teyame109-dev/Modular-Home/web/site/cimentacion/img/montaje-1-modulos-sobre-muros.jpg

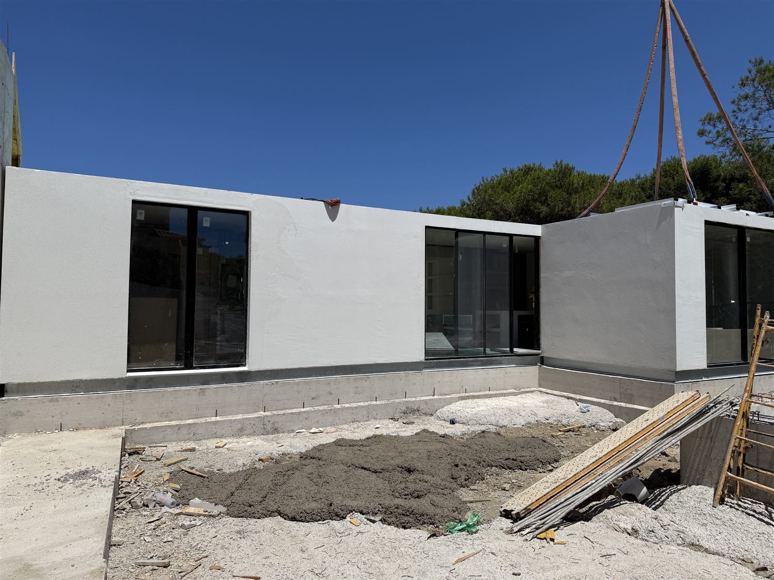
web/site/cimentacion/img/montaje-1-modulos-sobre-muros.jpg
