teyame109-dev/Modular-Home/web/site/cimentacion/img/obra-encofrado-armado.jpg

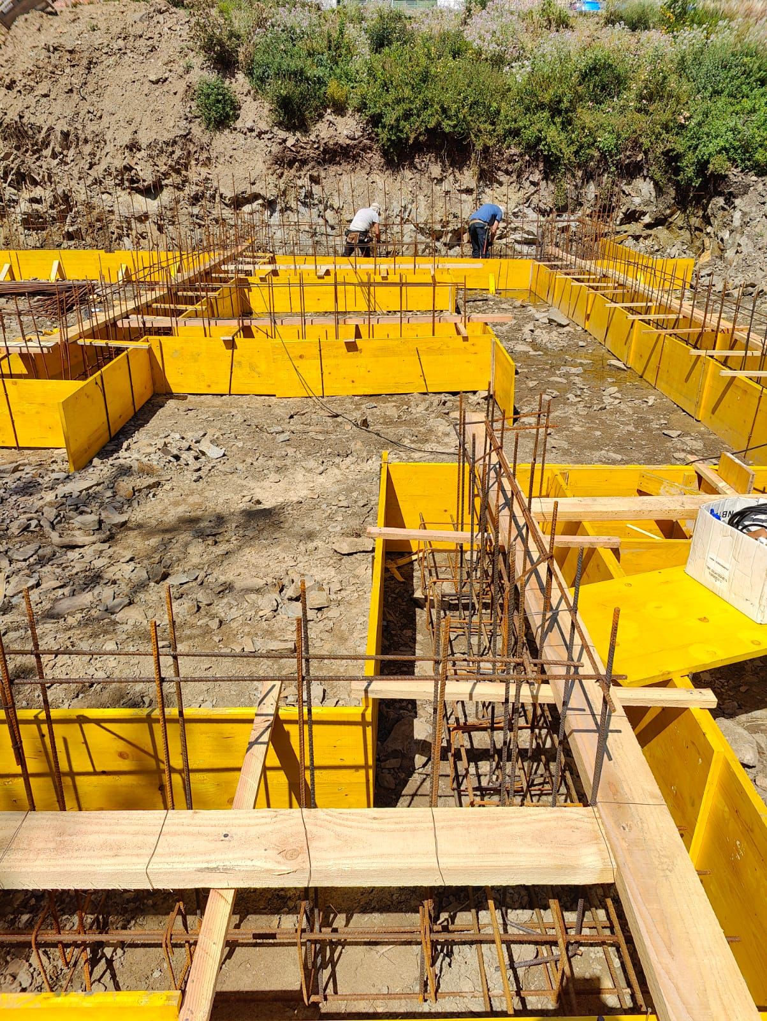
web/site/cimentacion/img/obra-encofrado-armado.jpg
