teyame109-dev/Modular-Home/README.md

# Modular Home

Proyecto de vivienda modular (piloto Névola · RG21). El contexto completo está en `CLAUDE.md`.

## Agentes del proyecto (`.claude/agents/`)
Adaptados a España a partir de [agency-agents](https://github.com/msitarzewski/agency-agents) (licencia MIT):

| Agente | Para qué |
|---|---|
| `revisor-realidad` | Revisar propuestas y decisiones antes de enviarlas |
| `analista-precios` | Precio y margen por casa y por proyecto, escenarios |
| `analista-financiero` | Viabilidad, caja, punto de equilibrio, real vs previsto |
| `jefe-proyecto` | Plan de fabricación y obra, medición del piloto |
| `ingeniero-estructuras` | Marcos de acero, kg/m², soldadura, CTE y EN 1090 (no firma) |
| `compras-proveedores` | Ofertas, comparativas, listas de materiales, plazos |
| `energia-sostenibilidad` | CTE DB-HE, calificación energética, argumentos verdes con dato |

Uso: "Que el analista-precios calcule… y después el revisor-realidad lo revise".
