teyame109-dev/Modular-Home/artifacts/informe_tecnico_piloto.html

rg21capital

Estudio técnico interno
Octubre 2026

Névola · Vivienda piloto

# Piloto modular Névola: vivienda pareada tipo

Paso a sistema modular, sin cambiar la distribución del proyecto, del proyecto de ejecución de julio de 2026 (14 pareadas y 2 aisladas en Guadalix de la Sierra), con la tipología de módulo del proyecto de Mahón (182): marcos de acero soldados, panel sándwich Tabihaus y trasdosado. Medición y coste de la primera unidad.

6 módulos3 por planta · sin cambios de distribución

12.889 kgacero · 86,9 kg/m² (Mahón: 89)

225.400 €precio cerrado del piloto · margen 21.430 € (9,5 %)

273.600 €precio cerrado si va aislado · margen 25.763 €

## Cómo se pasa el proyecto a módulos

- Retícula. La planta baja mide 7,85 × 9,50 m hasta el eje de medianera. Se divide en tres módulos de 3,20, 2,30 y 2,35 m que corren de fachada a fachada. La junta a 5,50 m cae sobre tabiques; la de 3,20 m cae sobre el tabique entre los dormitorios 2 y 3 en planta primera y, en planta baja, cruza el dormitorio 1 a 0,30 m de su tabique, oculta en suelo y techo como en el salón. La distribución del proyecto no cambia.
- Vuelos. La planta primera vuela 0,60 m en frente y lateral (8,45 m de ancho). Los tres módulos de arriba arrancan 0,60 m por delante de los de abajo, con el borde frontal en IPE 220. El vuelo lateral va dentro del M4, que mide 3,80 m de ancho: un módulo entero, sin pieza que atornillar en parcela. Sus pilares quedan en el eje de 0,60 m, sobre los del M1, y el voladizo lleva borde en IPE 220.
- Apoyos. Cada módulo lleva pilares IPE 160 en esquinas y en el eje intermedio. Los de planta primera descargan sobre los marcos de planta baja en los ejes y = 0,60 · 6,10 · 10,10 m. El salón (7,43 m libres en el proyecto) queda con luces de 5,50 y 4,00 m.
- Terraza y baño principal. M4 y M5 terminan en 8,47 m. Sobre la cubierta de planta baja queda la terraza de 9 m². M6 llega hasta 10,10 m y recoge entero el baño principal que sobresale.
- Alturas. Se mantienen las cotas del proyecto: suelo de planta baja +0,20, de planta primera +3,35 y cubierta +6,40. Módulos de unos 3,05 m de alto: en góndola rebajada quedan por debajo de 4,00 m.

## Croquis de modulación

Módulo de planta bajaMódulo de planta primeraPilar IPE 160Medianera

Lámina 1 · Planta bajacotas en m

Módulos de 3,20, 2,30 y 2,35 × 9,50 m. La junta a 3,20 m cruza el dormitorio 1 (oculta en suelo y techo); la de 5,50 m cae sobre los tabiques del baño 1 y el lavadero. Línea discontinua: eje de pilares intermedio (y = 6,10).

Lámina 2 · Planta primeracotas en m

Discontinuo azul: huella de planta baja. M4 y M5 de 8,47 m; M6 de 10,10 m con el baño principal. Rayado: terraza. El M4 incluye el vuelo lateral de 0,60 m. Juntas sobre el tabique entre dormitorios 2 y 3 y sobre el del baño principal.

Lámina 3 · Sección longitudinal por M2 / M5cotas de nivel del proyecto

Vertical: pilares IPE 160 de cada módulo. Bandas oscuras: forjados de panel. La cimentación sigue siendo del promotor, con placas de anclaje en los tres ejes de apoyo.

Lámina 4 · Fachada tipode exterior a interior

Capa | e (mm) | R (m²K/W)
Resistencia superficial exterior | – | 0,04
Acabado: placa de cemento + monocapa | 15 | 0,03
Panel Tabihaus 8+50+8 (núcleo PIR, λ 0,022) | 66 | 2,27
PET reciclado (λ 0,035) | 40 | 1,14
Trasdosado W625: perfil + lana mineral (λ 0,035) | 48 | 1,37
Placa de yeso laminado | 15 | 0,06
Resistencia superficial interior | – | 0,13
Total · U = 1 / R | ≈ 184 | 5,04 → U = 0,20

Cumple la U = 0,20 W/m²K que fija el proyecto para fachadas. El muro tiene 184 mm, frente a los unos 330 mm de la solución de ladrillo.

Módulosm · m²

Módulo | Ancho | Largo | m² | Contiene
M1 · PB | 3,20 | 9,50 | 30,40 | Dormitorio 1, cocina, salón
M2 · PB | 2,30 | 9,50 | 21,85 | Vestíbulo, escalera, salón
M3 · PB | 2,35 | 9,50 | 22,32 | Baño 1, lavadero, salón
M4 · P1 | 3,80 | 8,47 | 32,19 | Dormitorio 3, baño 2, dormitorio principal, con los vuelos frontal y lateral
M5 · P1 | 2,30 | 8,47 | 19,48 | Dormitorio 2, distribuidor
M6 · P1 | 2,35 | 10,10 | 23,73 | Escalera, vestidor, baño principal
Total | | | 149,97 | 148,30 m² construidos en proyecto

Anchos de 2,30 a 3,80 m: todos viajan en góndola rebajada con autorización especial, y el M4 además con vehículo de acompañamiento.

## Medición de acero

Mismos perfiles que Mahón: marcos de suelo y techo en IPE 200, pilares IPE 160, correas HEA 100 y SHS 60.40.3, angular L 80.8 de apoyo del panel. Los bordes en vuelo, en IPE 220.

Elemento | kg | kg/m²
Vigas de marco IPE 200 (suelo y techo de cada módulo) | 5.821 | 39,3
Bordes frontales en vuelo IPE 220 (M4, M5, M6) | 454 | 3,1
Borde lateral en vuelo del M4, IPE 220 | 455 | 3,1
Pilares IPE 160 (38 ud) | 1.631 | 11,0
Correas de suelo HEA 100 | 1.603 | 10,8
Correas de techo SHS 60.40.3 | 1.286 | 8,7
Angular L 80.8 de apoyo de panel | 351 | 2,4
Escalera metálica | 450 | 3,0
Refuerzos, remates y pletinas de arriostramiento | 838 | 5,7
Total | 12.889 | 86,9

kg/m² sobre 148,30 m² construidos. Mahón (182, dos plantas): 13.516 kg y 89 kg/m². Con un cálculo específico para módulos apilados se puede bajar: cada 10 kg/m² son unos 3.900 € por vivienda.

## Coste del piloto

Coste real de 2026 sin IVA. Lo que se hace igual que en el proyecto (instalaciones, carpinterías, acabados) va con sus mediciones y precios. Margen de RG21 del 10 %, aplicado una sola vez.

Partida | Piloto dentro de la serie | Piloto aislado
Sistema modular
Estructura de acero · 12.889 kg × 2,60 €/kg | 33.512 € | 33.512 €
Fachadas, medianera y vuelos: panel, trasdosado, aislamiento y acabado | 32.026 € | 32.026 €
Cubierta y terraza: panel y sistema de cubierta | 13.702 € | 13.702 €
Forjados de panel: suelo de planta baja y de planta primera | 11.948 € | 11.948 €
Juntas entre módulos y colectores suspendidos | 2.767 € | 2.767 €
Igual que el proyecto
Instalaciones: electricidad, fontanería, climatización, ventilación | 38.300 € | 38.300 €
Carpinterías exterior e interior | 16.301 € | 16.301 €
Tabiquería, techos, solados, alicatados y pintura | 24.766 € | 24.766 €
Primera unidad, transporte y montaje
Sobrecoste de aprendizaje (15 % de la mano de obra de fábrica) | 3.650 € | 3.650 €
Transporte de 6 módulos, con el M4 como especial | 7.248 € | 7.248 €
Grúa, jornada completa | 3.494 € | 3.494 €
Montaje en parcela · 192 h | 5.078 € | 5.078 €
Ingeniería: cálculo modular y proyecto de fabricación | 1.563 € | 25.000 €
Gastos fijos de fábrica | 10.215 € | 30.645 €
Coste | 203.970 € | 247.837 €
Margen RG21 (precio cerrado menos coste) | 21.430 € · 9,5 % | 25.763 € · 9,4 %
Precio cerrado con NIDO | 225.400 € | 273.600 €
€/m² construido | 1.520 | 1.845

Piloto dentro de la serie: la ingeniería se reparte entre 16 viviendas y los gastos fijos van al ritmo de 2 viviendas/mes. Piloto aislado: carga toda la ingeniería y 1,5 meses de fábrica; es el coste si después no hay serie. Referencia: una contrata tradicional del mismo alcance saldría a unos 155.700 € (PEM del proyecto × 1,19).

## Memoria de calidades: dónde se puede ahorrar

Las calidades que fija el proyecto (marcas y precios del BC3), al lado de una alternativa más barata. Hay tres tipos de ahorro: el que trae el propio sistema modular o evita pagar dos veces lo mismo (no cambia nada para el comprador), el cambio a una marca equivalente que la memoria permite con su «o similar», y ajustar el alcance a lo que promete la memoria comercial. Importes por vivienda pareada.

14.187 €ahorro de coste por vivienda

15.606 €bajada de precio con el margen del 10 %

209.800 €precio ofertado con optimizaciones · 1.415 €/m²

3.106.069 €serie de 16 con todos los ahorros

Partida | Proyecto | €/viv. proyecto | Alternativa | Ahorro €/viv.
Sistema modular o duplicidad · 5.692 €
Bomba circuladora Climatización | Ebara Ego Easy 25/80 aparte | 595 € | La integrada en el módulo hidráulico de la aerotermia (un solo circuito con colectores) | 400 €
Falso techo de cuartos secos y húmedos Techos | Knauf D47 suspendido con maestras (27,74 y 31,01 €/m²) | 3.447 € | Placa atornillada directamente a las correas del techo del módulo, sin estructura suspendida | 1.180 €
Falso techo exterior de placa de cemento Techos | Aquapanel Outdoor bajo vuelos (101,73 €/m²) | 992 € | Ya incluido: el vuelo del módulo lleva panel con acabado exterior | 992 €
Aplacado de gres en fachada Fachada | Porcelánico en capa fina sobre mortero (48,34 €/m², 31 m²) | 1.504 € | Se mantiene el aplacado y se descuenta esa superficie del acabado exterior del panel (no duplicar) | 1.400 €
Red de toma de tierra de estructura Electricidad | Cable de 35 mm² soldado a la armadura de cada zapata (40,65 m) | 2.061 € | Conexión equipotencial de los marcos de acero al anillo de cimentación del promotor | 1.200 €
Recercado de huecos Carpintería exterior | Chapa de aluminio lacado, desarrollo 400 mm (29,03 €/m) | 1.681 € | Pliegues de chapa galvanizada lacada fabricados en el propio taller | 520 €
Marca o gama equivalente · 6.605 €
Aerotermia Climatización | Vaillant aroTHERM plus uniTOWER biblock, 10,1 kW, A+++ | 8.376 € | Panasonic Aquarea All in One o LG Therma V con depósito de 200 l, dimensionada a 8 kW (vivienda A+ de 125 m² útiles) | 2.000 €
Suelo radiante Climatización | Polytherm Premium, panel termoconformado (35,86 €/m²) | 4.483 € | Sistema estándar de panel liso (Uponor, Orkli o Giacomini) a unos 30 €/m² | 750 €
Cuadro general Electricidad | Electrificación elevada, 24 elementos, 12 circuitos | 1.171 € | Mismo esquema montado en fábrica con aparamenta de gama media (Hager, Schneider Resi9) | 320 €
Videoportero Electricidad | Digital 3 hilos + coaxial, monitor b/n 4" | 730 € | Kit de 2 hilos en color (Fermax o Golmar) | 280 €
Tarima laminada Pavimentos | Terhürne Comfloor Akustec AC5/32, 8,5 mm (36,32 €/m²) | 3.245 € | Laminado AC5 de 8 mm de fabricante nacional (Finsa, Faus) a unos 28 €/m² | 715 €
Gres porcelánico interior, alicatado y peldaños Pavimentos | Porcelánico de 20 €/m² de material | 3.918 € | Compra directa a fábrica de Castellón por volumen de 16 viviendas (unos 13 €/m² de material) | 700 €
Pintura plástica Pintura | Sikkens Alphalux SF (8,11 y 10,45 €/m²) | 3.748 € | Plástica mate lavable profesional (Titan, Jotun o Bruguer) | 850 €
Ventanas y puertas balconeras Carpintería exterior | PVC Kömmerling Eurofutur 70, foliado RAL 7016, persiana | 8.012 € | Perfil equivalente de 70 mm (Veka Softline o Rehau Euro-Design) con el mismo foliado y vidrio | 650 €
Barandilla de terraza Carpintería exterior | Comenza GlassFit SV-1401 Top (197,86 €/m) | 1.408 € | Vidrio laminar con perfil de base genérico, misma imagen | 340 €
Alcance de la memoria comercial · 1.890 €
Tabiques interiores Tabiquería | Knauf W112, doble placa por cara (29,94 €/m²) | 3.910 € | Placa sencilla de 15 mm por cara (W111) entre estancias de la misma vivienda; W112 solo en baños y escalera | 1.000 €
Punto de recarga de vehículo Electricidad | Caja de recarga 2,3 kW instalada | 1.242 € | Preinstalación (canalización y línea), que es lo que promete la memoria comercial | 890 €
Ahorro total por vivienda (coste) | | | | 14.187 €

Ahorros estimados a precio de mercado de 2026: hay que confirmarlos con ofertas de proveedor. Las alternativas de marca mantienen la clase de eficiencia, el desgaste AC5, el foliado RAL 7016 y la gama media de sanitarios que fija la memoria. Sin tocar: sanitarios Gala (ya son gama media), puertas lacadas de MDF (221 €/ud) y armarios de melamina.

## Lo que hay que cerrar antes de fabricar

Cálculo estructuralValidar marcos, pilares y vuelos de 0,60 m con un calculista. Es la partida con más margen de ahorro.

MedianeraCada vivienda cierra sus módulos (68 m² de panel). Estudiar una medianera compartida con protección contra incendios EI 60 entre las dos viviendas.

M4 de 3,80 m y junta ocultaPedir precio del transporte especial del M4 (estimado en 1.200 €) y validar con la arquitecta el voladizo lateral dentro del módulo y la junta oculta en el dormitorio 1.

Precios de proveedorPedir oferta a Tabihaus (66, 81 y 136 mm) y del acabado exterior sobre panel, ahora estimado a 45 €/m².

OCT y decenalPresentar el sistema a la OCT y a la aseguradora del promotor antes de fabricar.

CimentaciónEl promotor ejecuta zapatas y placas de anclaje en los ejes 0,60 · 6,10 · 10,10. La solera Cáviti del proyecto desaparece.

Excel con todas las mediciones y fórmulas: Documentos\Dwaih\ModularHome\Nevola_piloto_estudio_costes.xlsx

RG21 Capital · Piloto modular NévolaUso interno · No enviar al promotor
