teyame109-dev/Modular-Home/artifacts/img/obra-muros-terminados.jpg

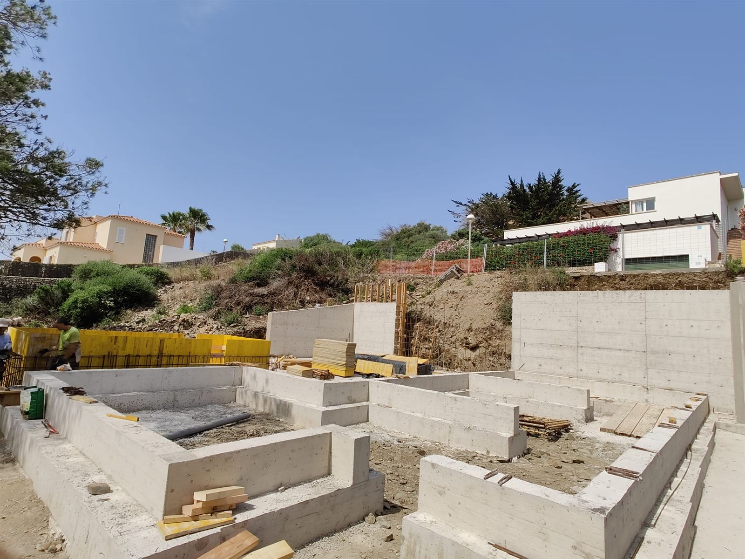
artifacts/img/obra-muros-terminados.jpg
