teyame109-dev/Modular-Home/artifacts/img/obra-muros-y-losa.jpg

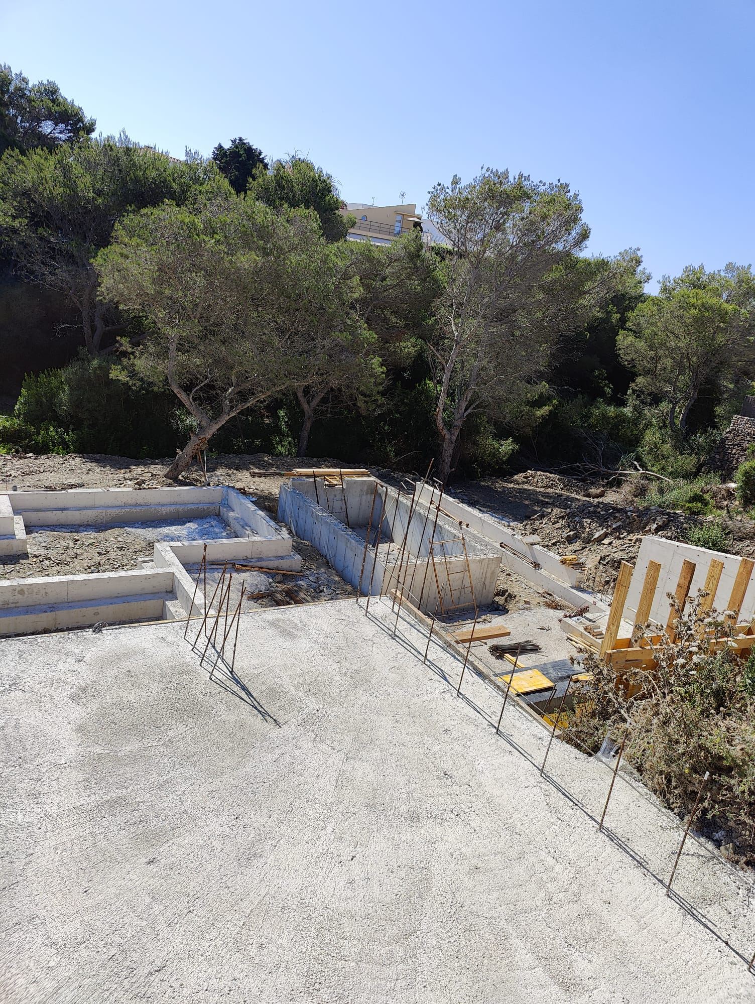
artifacts/img/obra-muros-y-losa.jpg
