teyame109-dev/Modular-Home/ofertas-proveedores/2026-10-20_cimentacion_presupuesto_equipo_manuscrito.webp

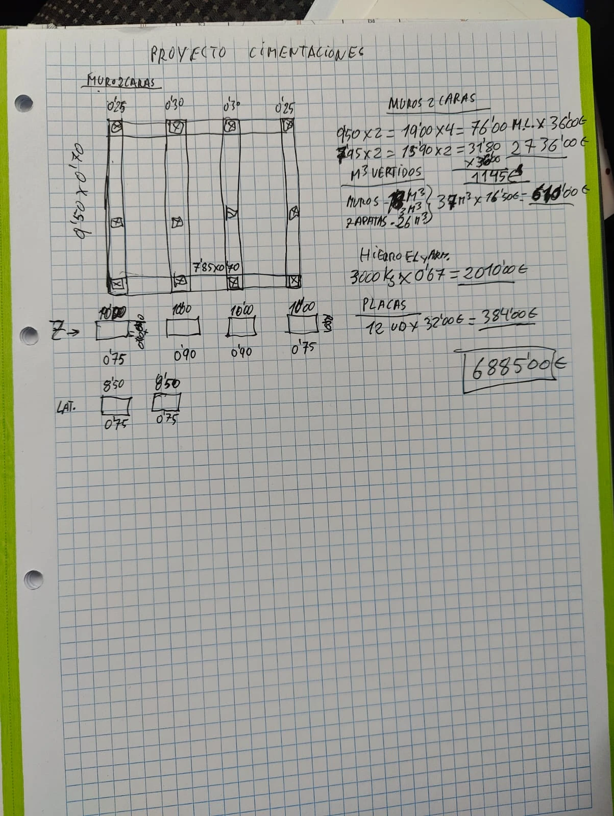
ofertas-proveedores/2026-10-20_cimentacion_presupuesto_equipo_manuscrito.webp
