teyame109-dev/Modular-Home/proyectos-referencia/nevola-renders/captura-jardin-comun.webp

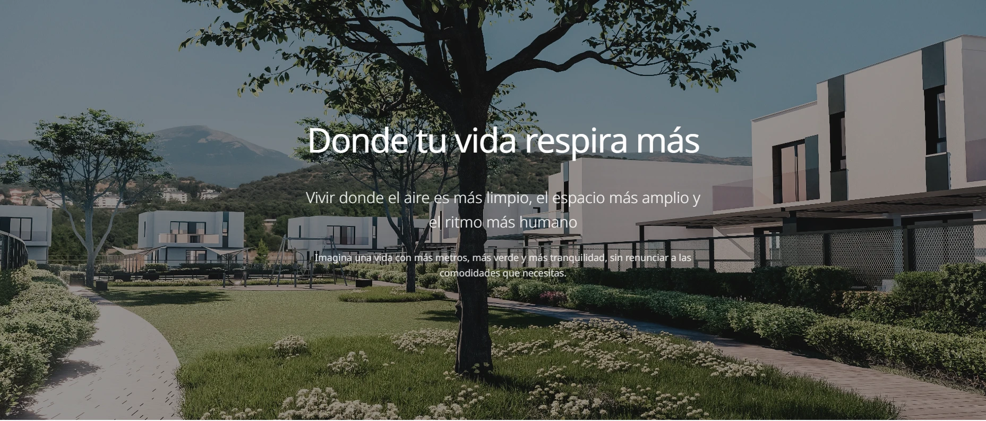
proyectos-referencia/nevola-renders/captura-jardin-comun.webp
