teyame109-dev/Modular-Home/proyectos-referencia/nevola-renders/captura-piscinas-b.webp

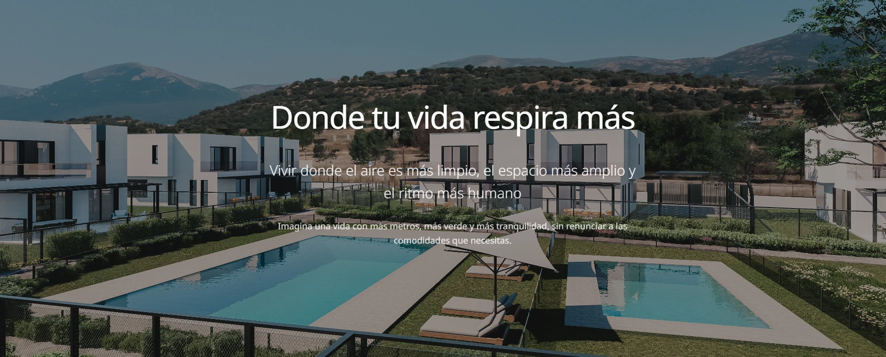
proyectos-referencia/nevola-renders/captura-piscinas-b.webp
