teyame109-dev/Modular-Home/proyectos-referencia/nevola-renders/captura-traseras-pareadas.webp

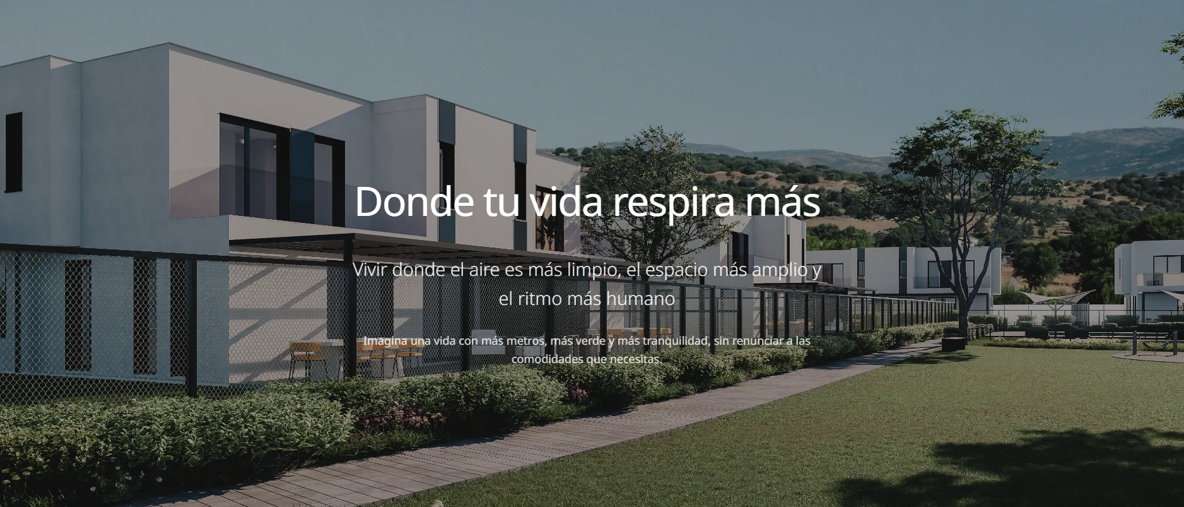
proyectos-referencia/nevola-renders/captura-traseras-pareadas.webp
