teyame109-dev/Modular-Home/proyectos-referencia/nevola-renders/captura-vivienda-jardin.webp

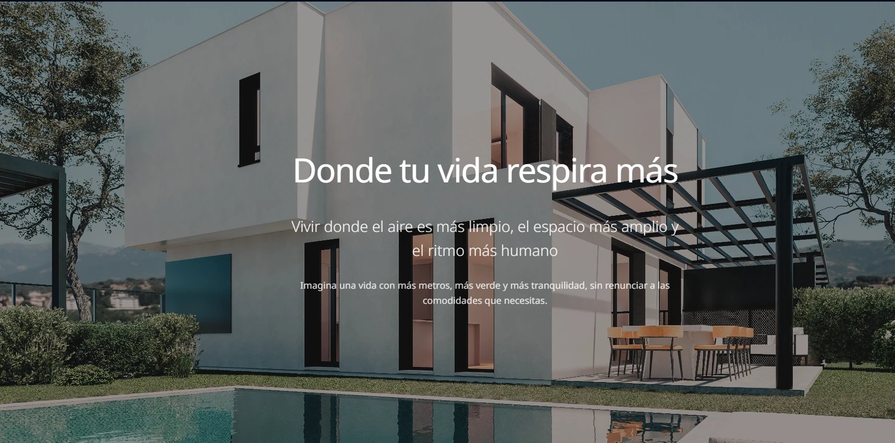
proyectos-referencia/nevola-renders/captura-vivienda-jardin.webp
