teyame109-dev/Modular-Home/web/site/render/img/piscinas.jpg

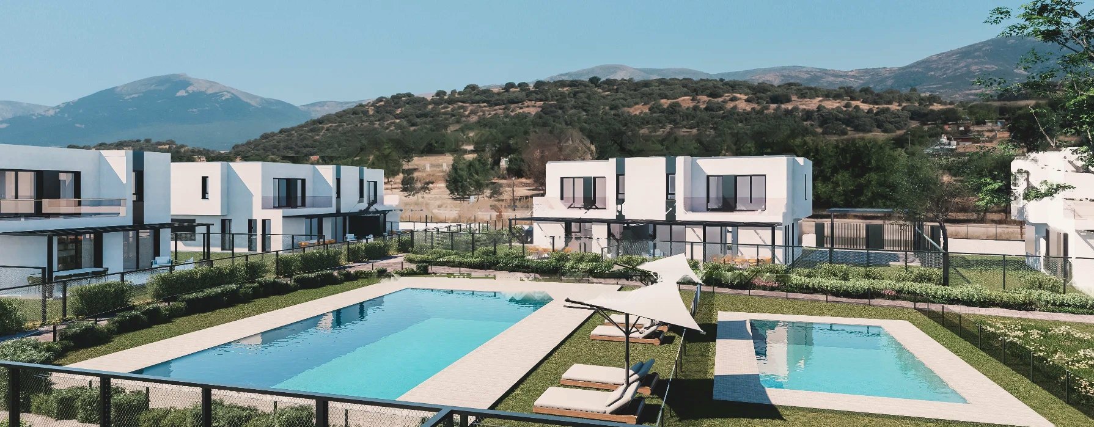
web/site/render/img/piscinas.jpg
