teyame109-dev/Modular-Home/web/site/render/img/traseras-pareadas.jpg

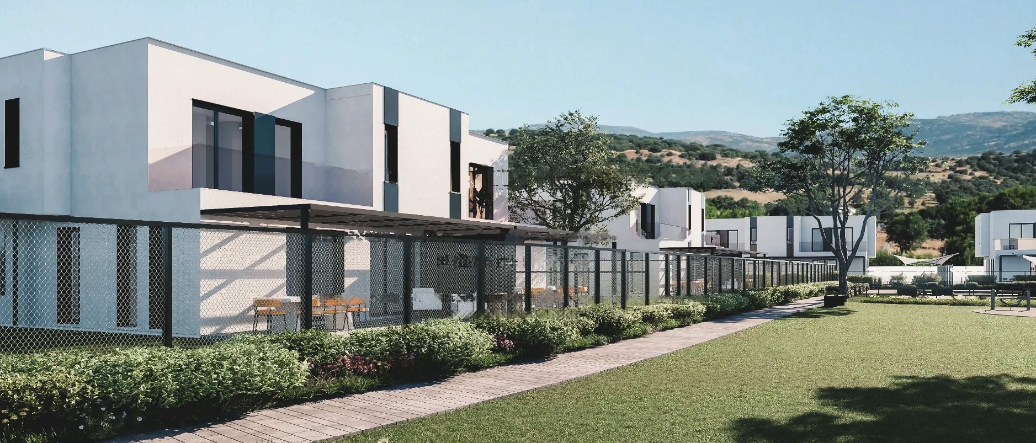
web/site/render/img/traseras-pareadas.jpg
