teyame109-dev/Modular-Home/costes/Banco_precios_modular_base2024.xlsx

Sheet: Léeme
Banco de precios de vivienda modular: base 2024 (proyectos Tini / DWHAI)
Preparado el 28/09/2026 a partir de los presupuestos Presto de 2024 y de la analítica contable de DWHAI a 29/11/2024.
CÓMO SE USA
• Hoja «Banco de precios»: una fila por partida. Precio de VENTA de 2024 en cada proyecto donde aparece, con mínimo, máximo y precio de referencia (mediana).
• Celdas AMARILLAS = las que rellenas tú: coste 2026 (lo que nos cuesta hoy la partida) y margen objetivo. El precio de venta 2026 se calcula solo.
• Texto AZUL = dato introducido a mano (de presupuestos o facturas). Texto negro = fórmula.
• Si el coste 2026 está vacío, el precio de venta 2026 toma el precio de referencia de 2024 actualizado con el IPC de obra (celda B3 de «Banco de precios»).
FUENTES
• Fenwick / Guadalajara (Tini L, 45 m²): 168_TINI L_MEDICIONES Y PRESUPUESTO (Excel del 25/11/2024; transporte corregido según el PDF del 16/04/2024).
• Menorca Pino (165 m²), dos versiones: mayo de 2024 (96_TINI XX_MENORCA PINO.xlsx, 280.492 €, que es el importe certificado a Tini) y 30/10/2024 (96_TINI MENORCA PINO__30102024, 272.061 €). También la implantación en obra: 96_TINI_MENORCA PINO_rv02 (29/08/2024).
• Sotopinilla / Autopromotor (153 m²): TINI SOTOPINILLA_MEDICIONES (3).pdf.
• Burdeos / Francia (Tini M, 34 m²): 171_TINI M_RUBEN GARCIA_BURDEOS_MEDICIONES CON ESTUFA.pdf.
• El Boalo / Sonia Arranz (Tini 85 m², contrato 169): 169_TINI 85M EL BOALO_MEDICIONES Y PRESUPUESTO (19/07/2024, 144.795 €).
• Mahón / Iván Montero (proyecto 182): resumen de presupuesto del 21/11/2024, a libro abierto (coste de material por separado).
• Coste real: 29-11-2024 ANALITICA PROYECTOS DWHAI.xlsx (facturas de proveedor imputadas a cada proyecto).
• Superficie de cada proyecto = medición de «limpieza final» (m²). Si hay una superficie oficial, cámbiala en «Resumen proyectos».
LO QUE HAY QUE SABER ANTES DE PRESUPUESTAR
1. El acero se vendía a 2,80 €/kg, pero la estructura soldada costó entre 2,9 y 5,3 €/kg según el proyecto. Es la partida que más riesgo tiene: en Guadalajara se perdió dinero.
2. El panel sándwich se vendía a 54–72 €/m². Con Tabihaus (Menorca, Sotopinilla) el coste imputado salió a 69–83 €/m², por encima de la venta. Con el panel anterior (Tejafer y Geo Pannel: Guadalajara, Burdeos) salió a 26–52 €/m². El precio de lista de Tabihaus en Mahón (42–64 €/m²) no incluye mermas ni portes. En la versión de octubre de Menorca ya se corrigió: panel de fachada de 66 mm a 82,42 €/m², de cubierta de 81 mm a 58,37 €/m² y de suelo de 136 mm a 86,09 €/m². Es la mejor referencia de venta con Tabihaus.
3. En Menorca y Sotopinilla, Tini pagó directamente la carpintería, la cocina, los baños, el clima y el transporte. Quitando eso, DWHAI tuvo en Menorca un margen bruto del 36 % sobre lo que ejecutó, antes de gastos generales.
4. Con la plantilla completa (9 operarios, septiembre–noviembre de 2024), la nómina costaba unos 28.250 €/mes y la fábrica entera unos 48.700 €/mes. Ver la hoja «Fábrica coste mensual»: falta el dato de m² fabricados al mes para convertirlo en €/m².
5. Gastos generales de 2024: 385.104 € (nave, gestión, mano de obra sin imputar). En Mahón se repercutieron como 1/5 de la nave durante 5 meses (24.500 €).
6. Los precios de 2024 son de VENTA de DWHAI a Tini. El margen de Tini iba aparte (en Mahón, 37.831 € sobre 109.111 €, un 34,7 %).

Sheet: Banco de precios
BANCO DE PRECIOS: VIVIENDA MODULAR (base 2024)
Actualización 2024→2026 (IPC de obra) | 8.0% | Supuesto: +8 % acumulado. Sustitúyelo por el índice real o por precios de proveedor. | Margen objetivo por defecto | 25.0%
Capítulo | Código | Descripción | Ud | Venta 2024 Fenwick (Guadalajara) | Venta 2024 Menorca Pino (may-24) | Venta 2024 Menorca Pino (oct-24) | Venta 2024 Sotopinilla | Venta 2024 Burdeos (Francia) | Venta 2024 El Boalo (Tini 85) | Mín. | Máx. | Nº proy. | Precio ref. 2024 (mediana) | Coste real 2024 (conocido) | Margen 2024 sobre venta | Fuente del coste | COSTE 2026 (rellenar) | Margen objetivo (opcional) | PRECIO VENTA 2026
01 Estructura | 01.01.03.02 | CORREA SHS60.4 |  |  |  |  | 2.80 €
01 Estructura | 01.01.06.02 | PLETINA TRANSPORTE 170.10 | kg |  |  |  | 2.80 €
01 Estructura | 01.01.07.01 | PINTURA ESTRUCTURA VISTA |  |  |  |  |  | 200.00 €
01 Estructura | EAS005 | PLACA DE ANCLAJE DE ACERO, CON PERNOS SOLDADOS. | Ud |  |  |  | 32.70 €
01 Estructura | EST_CO_HEA100 | HEA100 | kg |  |  | 2.80 € |  |  | 2.80 € |  |  |  |  | 0.80 € |  | Solo material. Mahón 21/11/2024: acero 0,80 €/kg. La estructura soldada completa costó 2,9–5,3 €/kg (ver hoja Coste real)
01 Estructura | EST_CO_RHS80.60.4 | CORREA RHS80.60.4 | kg | 2.80 € | 2.80 € | 2.80 € | 2.80 € | 2.80 € |  |  |  |  |  | 0.80 € |  | Solo material. Mahón 21/11/2024: acero 0,80 €/kg. La estructura soldada completa costó 2,9–5,3 €/kg (ver hoja Coste real)
01 Estructura | EST_CO_RHS80.60.4 | CORREA RHS 80.60.4 | kg |  |  |  |  |  | 2.80 € |  |  |  |  | 0.80 € |  | Solo material. Mahón 21/11/2024: acero 0,80 €/kg. La estructura soldada completa costó 2,9–5,3 €/kg (ver hoja Coste real)
01 Estructura | EST_CO_SHS60.4 | CORREA SHS60.4 | kg | 2.80 € |  |  |  | 2.80 € |  |  |  |  |  | 0.80 € |  | Solo material. Mahón 21/11/2024: acero 0,80 €/kg. La estructura soldada completa costó 2,9–5,3 €/kg (ver hoja Coste real)
01 Estructura | EST_CO_SHS60.4 | HEA 100 | kg |  |  |  | 2.80 € |  |  |  |  |  |  | 0.80 € |  | Solo material. Mahón 21/11/2024: acero 0,80 €/kg. La estructura soldada completa costó 2,9–5,3 €/kg (ver hoja Coste real)
01 Estructura | EST_CO_SHS60.4 | CORREA SHS 60.60.4 | kg |  |  |  |  |  | 2.80 € |  |  |  |  | 0.80 € |  | Solo material. Mahón 21/11/2024: acero 0,80 €/kg. La estructura soldada completa costó 2,9–5,3 €/kg (ver hoja Coste real)
01 Estructura | EST_CO_SHS60.6 | CORREA SHS60.6 | kg | 2.80 € |  |  |  |  |  |  |  |  |  | 0.80 € |  | Solo material. Mahón 21/11/2024: acero 0,80 €/kg. La estructura soldada completa costó 2,9–5,3 €/kg (ver hoja Coste real)
01 Estructura | EST_PI_HEA100 | HEA100 | kg |  |  | 2.80 € | 2.80 € |  |  |  |  |  |  | 0.80 € |  | Solo material. Mahón 21/11/2024: acero 0,80 €/kg. La estructura soldada completa costó 2,9–5,3 €/kg (ver hoja Coste real)
01 Estructura | EST_PI_IPE140 | PILAR IPE140 | kg |  | 2.80 € |  |  | 2.80 € |  |  |  |  |  | 0.80 € |  | Solo material. Mahón 21/11/2024: acero 0,80 €/kg. La estructura soldada completa costó 2,9–5,3 €/kg (ver hoja Coste real)
01 Estructura | EST_PI_IPE160 | PILAR IPE160 | kg | 2.80 € |  |  |  |  |  |  |  |  |  | 0.80 € |  | Solo material. Mahón 21/11/2024: acero 0,80 €/kg. La estructura soldada completa costó 2,9–5,3 €/kg (ver hoja Coste real)
01 Estructura | EST_PI_IPE180 | PILAR IPE180 | kg | 2.80 € |  |  |  |  |  |  |  |  |  | 0.80 € |  | Solo material. Mahón 21/11/2024: acero 0,80 €/kg. La estructura soldada completa costó 2,9–5,3 €/kg (ver hoja Coste real)
01 Estructura | EST_PL_10.120 | PLETINA TRANSPORTE 120.10 | kg |  | 2.80 € |  |  |  |  |  |  |  |  | 0.80 € |  | Solo material. Mahón 21/11/2024: acero 0,80 €/kg. La estructura soldada completa costó 2,9–5,3 €/kg (ver hoja Coste real)
01 Estructura | EST_PL_120.10 | PLETINA TRANSPORTE 120.10 | kg | 2.80 € |  |  |  |  |  |  |  |  |  | 0.80 € |  | Solo material. Mahón 21/11/2024: acero 0,80 €/kg. La estructura soldada completa costó 2,9–5,3 €/kg (ver hoja Coste real)
01 Estructura | EST_PL_40.5 | PLETINA ARRIOSTRAMIENTO 40.5 | kg | 2.80 € | 2.80 € |  | 2.80 € |  | 2.80 € |  |  |  |  | 0.80 € |  | Solo material. Mahón 21/11/2024: acero 0,80 €/kg. La estructura soldada completa costó 2,9–5,3 €/kg (ver hoja Coste real)
01 Estructura | EST_PL_80.10 | PLETINA TRANSPORTE 80.10 | kg |  |  |  |  | 2.80 € |  |  |  |  |  | 0.80 € |  | Solo material. Mahón 21/11/2024: acero 0,80 €/kg. La estructura soldada completa costó 2,9–5,3 €/kg (ver hoja Coste real)
01 Estructura | EST_PL_AG | AGARRADERA TRIANGULAR | u | 4.48 € | 4.48 € | 4.48 € | 4.80 € | 4.48 € | 4.80 € |  |  |  |  | 0.80 € |  | Solo material. Mahón 21/11/2024: acero 0,80 €/kg. La estructura soldada completa costó 2,9–5,3 €/kg (ver hoja Coste real)
01 Estructura | EST_PL_CRZ | PLETINA ARRIOSTRAMIENTO 100.10 | kg |  |  | 2.80 € |  |  |  |  |  |  |  | 0.80 € |  | Solo material. Mahón 21/11/2024: acero 0,80 €/kg. La estructura soldada completa costó 2,9–5,3 €/kg (ver hoja Coste real)
01 Estructura | EST_PL_PI | PLETINA APOYO PILAR | kg |  | 2.60 € | 4.09 € | 2.60 € | 2.60 € |  |  |  |  |  | 0.80 € |  | Solo material. Mahón 21/11/2024: acero 0,80 €/kg. La estructura soldada completa costó 2,9–5,3 €/kg (ver hoja Coste real)
01 Estructura | EST_PL_RC | PLETINA REFUERZO COR-VISION | kg |  | 2.80 € | 2.80 € | 2.80 € | 2.80 € | 2.80 € |  |  |  |  | 0.80 € |  | Solo material. Mahón 21/11/2024: acero 0,80 €/kg. La estructura soldada completa costó 2,9–5,3 €/kg (ver hoja Coste real)
01 Estructura | EST_PL_RC150.10 | PLETINA REFUERZO COR-VISION 150.10 | kg | 2.80 € |  |  |  |  |  |  |  |  |  | 0.80 € |  | Solo material. Mahón 21/11/2024: acero 0,80 €/kg. La estructura soldada completa costó 2,9–5,3 €/kg (ver hoja Coste real)
01 Estructura | EST_PN_BIM | BASE IMPRIMACIÓN DOBLE | u |  |  |  |  | 400.00 €
01 Estructura | EST_PN_BL | PINTURA BLANCA ESTRUTURA VISTA | u |  | 200.00 € | 200.00 €
01 Estructura | EST_PN_GAL | GALVANIZADO PARA ESTRUCTURA DE ACERO (>1000KG) | kg |  | 0.59 € | 0.59 € |  |  |  |  |  |  |  | 0.45 € |  | Mahón 21/11/2024: galvanizado 0,45 €/kg
01 Estructura | EST_PN_GAL | GALVANIZADO PARA ESTRUCTURA DE ACERO | kg |  |  |  | 0.59 € |  |  |  |  |  |  | 0.45 € |  | Mahón 21/11/2024: galvanizado 0,45 €/kg
01 Estructura | EST_PN_GIM | GRANALLADO E IMPRIMACIÓN | kg | 0.11 € |  |  | 0.11 € |  | 0.11 €
01 Estructura | EST_PN_PPV | PINTURA POLIURETANO VISTO | kg |  |  |  | 0.10 € |  |  |  |  |  |  | 0.12 € |  | Mahón 21/11/2024: poliuretano 0,12 €/kg
01 Estructura | EST_PN_PPV_NM | PINTURA POLIURETANO VISTO NEGRO MATE | kg | 0.15 € |  |  |  |  |  |  |  |  |  | 0.12 € |  | Mahón 21/11/2024: poliuretano 0,12 €/kg
01 Estructura | EST_PN_TC2C3M | TRATAMIENTO C2-C3 TINI M | u |  |  |  | 542.40 € |  | 542.40 €
01 Estructura | EST_PN_TC2C3S | TRATAMIENTO C2-C3 TINI S | u |  |  |  | 374.40 €
01 Estructura | EST_PN_TC2C3XS | TRATAMIENTO C2-C3 TINI XS | u |  |  |  | 268.80 € |  | 268.80 €
01 Estructura | EST_PN_TC4C5M | TRATAMIENTO C4-C5 TINI M | u |  |  |  | 1457.70 €
01 Estructura | EST_PN_TC4C5S | TRATAMIENTO C4-C5 TINI S | u |  |  |  | 1006.20 €
01 Estructura | EST_PN_TC4C5XS | TRATAMIENTO C4-C5 TINI XS | u |  |  |  | 722.40 €
01 Estructura | EST_RE_100.6 | REFUERZO RHS 100.60.4 | kg |  |  | 2.80 € |  |  | 2.80 € |  |  |  |  | 0.80 € |  | Solo material. Mahón 21/11/2024: acero 0,80 €/kg. La estructura soldada completa costó 2,9–5,3 €/kg (ver hoja Coste real)
01 Estructura | EST_RE_L40.4 | SOPORTE SANDWICH L40.4 | kg | 2.80 € | 2.80 € | 2.80 € | 3.00 € |  |  |  |  |  |  | 0.80 € |  | Solo material. Mahón 21/11/2024: acero 0,80 €/kg. La estructura soldada completa costó 2,9–5,3 €/kg (ver hoja Coste real)
01 Estructura | EST_RE_RHS100.50.3 | REFUERZO RHS100.60.4 | kg |  |  |  | 3.00 € |  |  |  |  |  |  | 0.80 € |  | Solo material. Mahón 21/11/2024: acero 0,80 €/kg. La estructura soldada completa costó 2,9–5,3 €/kg (ver hoja Coste real)
01 Estructura | EST_RE_RHS120.60.4 | REFUERZO RHS120.60.4 | kg |  | 2.80 € |  | 2.80 € |  |  |  |  |  |  | 0.80 € |  | Solo material. Mahón 21/11/2024: acero 0,80 €/kg. La estructura soldada completa costó 2,9–5,3 €/kg (ver hoja Coste real)
01 Estructura | EST_RE_RHS25.50.1.5 | REFUERZO RHS25.50.1,5 | kg | 2.80 € |  |  |  |  |  |  |  |  |  | 0.80 € |  | Solo material. Mahón 21/11/2024: acero 0,80 €/kg. La estructura soldada completa costó 2,9–5,3 €/kg (ver hoja Coste real)
01 Estructura | EST_RE_RHS50.25.1.5 | REFUERZO RHS50.25.1,5 | kg | 2.80 € | 2.80 € | 2.80 € | 3.00 € | 2.80 € |  |  |  |  |  | 0.80 € |  | Solo material. Mahón 21/11/2024: acero 0,80 €/kg. La estructura soldada completa costó 2,9–5,3 €/kg (ver hoja Coste real)
01 Estructura | EST_RE_RHS50.50.4 | REFUERZO RHS 50.50.4 | kg |  |  |  |  |  | 2.80 € |  |  |  |  | 0.80 € |  | Solo material. Mahón 21/11/2024: acero 0,80 €/kg. La estructura soldada completa costó 2,9–5,3 €/kg (ver hoja Coste real)
01 Estructura | EST_RE_RHS60.30.3 | REFUERZO RHS60.30.3 | kg | 2.80 € | 2.80 € | 2.80 € | 2.80 € |  |  |  |  |  |  | 0.80 € |  | Solo material. Mahón 21/11/2024: acero 0,80 €/kg. La estructura soldada completa costó 2,9–5,3 €/kg (ver hoja Coste real)
01 Estructura | EST_RE_RHS60.30.3 | REFUERZO RHS 60.30.3 | kg |  |  |  |  |  | 2.80 € |  |  |  |  | 0.80 € |  | Solo material. Mahón 21/11/2024: acero 0,80 €/kg. La estructura soldada completa costó 2,9–5,3 €/kg (ver hoja Coste real)
01 Estructura | EST_RM_L45.5 | ANGULO L45.5 | kg | 2.80 € | 2.80 € | 2.80 € | 2.80 € |  | 2.80 € |  |  |  |  | 0.80 € |  | Solo material. Mahón 21/11/2024: acero 0,80 €/kg. La estructura soldada completa costó 2,9–5,3 €/kg (ver hoja Coste real)
01 Estructura | EST_RM_L65.5 | ANGULO L65.5 | kg |  |  |  |  |  | 2.80 € |  |  |  |  | 0.80 € |  | Solo material. Mahón 21/11/2024: acero 0,80 €/kg. La estructura soldada completa costó 2,9–5,3 €/kg (ver hoja Coste real)
01 Estructura | EST_VI_HEB220 | VIGA HEB220 | kg | 2.80 € |  |  |  |  |  |  |  |  |  | 0.80 € |  | Solo material. Mahón 21/11/2024: acero 0,80 €/kg. La estructura soldada completa costó 2,9–5,3 €/kg (ver hoja Coste real)
01 Estructura | EST_VI_IPE160 | VIGA IPE160 | kg | 2.80 € |  |  |  | 2.80 € |  |  |  |  |  | 0.80 € |  | Solo material. Mahón 21/11/2024: acero 0,80 €/kg. La estructura soldada completa costó 2,9–5,3 €/kg (ver hoja Coste real)
01 Estructura | EST_VI_IPE180 | VIGA IPE180 | kg |  | 2.80 € |  |  |  |  |  |  |  |  | 0.80 € |  | Solo material. Mahón 21/11/2024: acero 0,80 €/kg. La estructura soldada completa costó 2,9–5,3 €/kg (ver hoja Coste real)
01 Estructura | EST_VI_IPE200 | VIGA IPE200 | kg | 2.80 € |  | 2.80 € | 2.80 € | 2.80 € | 2.80 € |  |  |  |  | 0.80 € |  | Solo material. Mahón 21/11/2024: acero 0,80 €/kg. La estructura soldada completa costó 2,9–5,3 €/kg (ver hoja Coste real)
01 Estructura | EST_VI_IPE220 | VIGA IPE220 | kg | 2.80 € | 2.80 € | 2.80 € |  |  |  |  |  |  |  | 0.80 € |  | Solo material. Mahón 21/11/2024: acero 0,80 €/kg. La estructura soldada completa costó 2,9–5,3 €/kg (ver hoja Coste real)
02 Fachada y tabiques (panel) | FAC_ATR | AISLAMIENTO TÉRMICO REFLEXIVO | m² | 11.25 € | 11.25 € | 11.25 € | 11.25 € | 11.25 € | 11.25 €
02 Fachada y tabiques (panel) | FAC_DU46 | DOBLE PERFILERIA U 46MM CADA 60CM | m² |  | 44.00 € | 44.00 €
02 Fachada y tabiques (panel) | FAC_O15 | PERFIL OMEGA 15MM | m² |  |  |  | 22.00 € | 22.00 € | 22.00 €
02 Fachada y tabiques (panel) | FAC_PET40 | AISLAMIENTO DE PET RECICLADO DE 40MM | m² | 10.00 € | 10.00 € | 10.00 € | 10.00 € |  | 10.00 €
02 Fachada y tabiques (panel) | FAC_PET80 | AISLAMIENTO DE PET RECICLADO DE 80MM | m² | 15.70 € | 15.70 € | 15.70 € | 15.70 € | 15.70 € | 15.70 €
02 Fachada y tabiques (panel) | FAC_SAN_TAH | PANEL SANDWICH (8+50+8) TABIHAUS | m² |  |  |  |  |  | 75.00 € |  |  |  |  | 42.00 € |  | Tabihaus 8+50+8 (66 mm): 42 €/m² (Mahón). Supuesto: «50 mm» = 8+50+8
02 Fachada y tabiques (panel) | FAC_SAN50 | PANEL SANDWICH 50MM | m² | 54.00 € | 54.00 € |  |  | 54.00 € |  |  |  |  |  | 42.00 € |  | Tabihaus 8+50+8 (66 mm): 42 €/m² (Mahón). Supuesto: «50 mm» = 8+50+8
02 Fachada y tabiques (panel) | FAC_SAN50 | PANEL SANDWICH 66MM (TABIHAUS) | m² |  |  |  | 71.67 € |  |  |  |  |  |  | 42.00 € |  | Tabihaus 8+50+8 (66 mm): 42 €/m² (Mahón). Supuesto: «50 mm» = 8+50+8
02 Fachada y tabiques (panel) | FAC_SAN66 | PANEL SANDWICH 66MM (TABIHAUS) | m² |  |  | 82.42 € |  |  |  |  |  |  |  | 42.00 € |  | Tabihaus 8+50+8 (66 mm): 42 €/m² (Mahón). Supuesto: «50 mm» = 8+50+8
02 Fachada y tabiques (panel) | FAC_U46 | PERFIL U 46MM CADA 60CM | m² | 22.00 € | 22.00 € | 22.00 € | 22.00 € | 22.00 € | 22.00 €
02 Fachada y tabiques (panel) | FAC_U70 | PERFIL U 70MM CADA 60CM | m² | 22.00 € | 22.00 € |  | 22.00 € | 22.00 €
03 Cubierta | CUB_ALB | ALBARDILLA DE CHAPA PLEGADA GALVANIZADA DE 2MM | m | 25.05 € | 25.05 € | 25.05 € |  |  | 25.05 €
03 Cubierta | CUB_ALB | ALBARDILLA DE CHAPA PLEGADA GALVANIZADA DE | m |  |  |  | 25.05 € | 25.05 €
03 Cubierta | CUB_ATR | AISLAMIENTO TÉRMICO REFLEXIVO | m² | 11.25 € | 11.25 € | 11.25 € | 11.25 € | 11.25 € | 11.25 €
03 Cubierta | CUB_CAN | CANALÓN DE CHAPA PLEGADA DE 2MM | m | 38.00 € | 38.00 € | 38.00 € | 38.00 € | 38.00 € | 38.00 €
03 Cubierta | CUB_GAR | GÁRGOLA METÁLICA INCLUSO PIEZA DE EPDM | u | 52.00 € | 52.00 € | 52.00 € | 52.00 € | 52.00 € | 52.00 €
03 Cubierta | CUB_O15 | PERFIL OMEGA 15MM | m² | 22.00 € | 22.00 € |  | 22.00 € | 22.00 € | 22.00 €
03 Cubierta | CUB_PET40 | AISLAMIENTO PET RECICLADO 40MM | m² | 10.00 € | 10.00 € | 10.00 € | 10.00 € | 10.00 € | 10.00 €
03 Cubierta | CUB_SAN_TAH | PANEL SANDWICH (8+65+8) TABIHAUS | m² |  |  |  |  |  | 65.00 € |  |  |  |  | 52.00 € |  | Tabihaus 8+65+8 (≈81 mm): 52 €/m² (Mahón). Supuesto: «80 mm» = 8+65+8
03 Cubierta | CUB_SAN80 | PANEL SANDWICH 80MM | m² | 61.00 € | 61.00 € |  |  | 61.00 € |  |  |  |  |  | 52.00 € |  | Tabihaus 8+65+8 (≈81 mm): 52 €/m² (Mahón). Supuesto: «80 mm» = 8+65+8
03 Cubierta | CUB_SAN80 | PANEL SANDWICH 81MM TABIHAUS | m² |  |  |  | 53.78 € |  |  |  |  |  |  | 52.00 € |  | Tabihaus 8+65+8 (≈81 mm): 52 €/m² (Mahón). Supuesto: «80 mm» = 8+65+8
03 Cubierta | CUB_SAN81 | PANEL SANDWICH 81MM (TABIHAUS) | m² |  |  | 58.37 € |  |  |  |  |  |  |  | 52.00 € |  | Tabihaus 8+65+8 (≈81 mm): 52 €/m² (Mahón). Supuesto: «80 mm» = 8+65+8
03 Cubierta | CUB_TAB | TELA ASFÁLTICA BICAPA CON ACABADO DE PIZARRILLA | m² | 36.00 € | 36.00 € | 36.00 € | 36.00 € | 36.00 € | 36.00 €
03 Cubierta | CUB_XPS60 | AISLAMIENTO XPS 60MM | m² | 10.00 € | 10.00 € | 10.00 € | 10.00 € | 10.00 € | 10.00 €
04 Suelo | EAN010_propuesta 2 | PANEL SÁNDWICH PARA FORJADO O CUBIERTA, SOBRE | m² |  |  |  | 90.43 €
04 Suelo | EAN020_propuesta | PANEL SÁNDWICH PARA FORJADO O CUBIERTA PROPUESTA | m² |  |  |  | 92.33 €
04 Suelo | SUE_ATR | AISLAMIENTO TÉRMICO REFLEXIVO | m² |  | 11.25 € | 11.25 €
04 Suelo | SUE_ATR | LÁMINA DE PVC |  |  |  |  |  | 11.25 €
04 Suelo | SUE_DAN_136 | PANEL SANDWICH 136 MM (TABIHAUS) | m² |  |  | 86.09 € |  |  |  |  |  |  |  | 64.00 € |  | Tabihaus 8+120+8: 64 €/m² (Mahón)
04 Suelo | SUE_SAN_TAH136 | PANEL SANDWICH (8+120+8) TABIHAUS | m² |  |  |  |  |  | 99.00 € |  |  |  |  | 64.00 € |  | Tabihaus 8+120+8: 64 €/m² (Mahón)
04 Suelo | SUE_SAN_TAH81 | PANEL SANDWICH (8+65+8) TABIHAUS | m² |  |  |  |  |  | 65.00 € |  |  |  |  | 52.00 € |  | Tabihaus 8+65+8 (≈81 mm): 52 €/m² (Mahón). Supuesto: «80 mm» = 8+65+8
04 Suelo | SUE_SAN50 | PANEL SANDWICH 50MM | m² |  | 54.00 € |  |  | 54.00 € |  |  |  |  |  | 42.00 € |  | Tabihaus 8+50+8 (66 mm): 42 €/m² (Mahón). Supuesto: «50 mm» = 8+50+8
04 Suelo | SUE_SAN80 | PANEL SANDWICH 80MM | m² | 61.00 € |  |  |  |  |  |  |  |  |  | 52.00 € |  | Tabihaus 8+65+8 (≈81 mm): 52 €/m² (Mahón). Supuesto: «80 mm» = 8+65+8
04 Suelo | SUE_SAN80 | PANEL SANDWICH 136MM (TABIHAUS) |  |  |  |  | 72.25 € |  |  |  |  |  |  | 64.00 € |  | Tabihaus 8+120+8: 64 €/m² (Mahón)
04 Suelo | SUE_TRA | SUELO DE TRAMEX REGISTRABLE | m² |  | 95.42 € | 95.42 € | 95.42 € | 95.42 € | 95.42 €
05 Electricidad | 01.05.02.02 | PAREJA HORIZONTAL CONMUTADOR 10A SIMON 270 |  |  |  |  | 42.32 €
05 Electricidad | 01.05.02.07 | PAREJA VERTICAL INTERRUPTOR 10A SIMON 270 |  |  |  |  | 36.60 €
05 Electricidad | 01.05.02.22 | PAREJA HORIZONTAL INTERRUPTORES 10A SIMON 270 |  |  |  |  | 36.60 €
05 Electricidad | 01.05.03.25 | FOCO DE EXTERIOR TONI FARO BARCELONA 3000K |  |  |  |  | 47.80 €
05 Electricidad | 084IE | CIRCUITO DE ALUMBRADO | ml |  | 1.77 € | 1.77 €
05 Electricidad | 085IE | CIRCUITOS USOS VARIOS | ml |  | 2.44 € | 2.44 €
05 Electricidad | E01 | PAREJA VERTICAL CONMUTADOR 10A SIMON 270 |  |  |  |  | 42.32 €
05 Electricidad | ELE_ILU_FB_CROC19 | FOCO CROC 19 FARO BARCELONA | u | 47.82 € | 47.82 € | 47.82 € |  | 47.82 €
05 Electricidad | ELE_ILU_FB_GEISER130 | FOCO EMPOTRABLE DE EXTERIOR GEISER 130 FARO | u |  |  |  | 124.90 €
05 Electricidad | ELE_ILU_FB_HYDE | FOCO HYDE FARO BARCELONA | u | 50.00 € | 47.82 € | 47.82 €
05 Electricidad | ELE_ILU_FB_HYDE | FOCO HYDE FARO BARCELONA Y BOMBILLA 2700K | u |  |  |  | 15.10 €
05 Electricidad | ELE_ILU_FB_HYDE | FOCO HYDE FARO BARCELONA Y BOMBILLA 2700K (TODOS LOS COLORES) | u |  |  |  |  |  | 19.36 €
05 Electricidad | ELE_ILU_FB_NORAY | APLIQUE DE EXTERIOR NORAY FARO BARCELONA Y | u |  |  |  | 114.10 €
05 Electricidad | ELE_ILU_FB_STANEMP_N | FOCO EMPOTRABLE STAN FARO BARCELONA Y BOMBILLA 2700K (NEGRO O | u |  |  |  |  |  | 35.68 €
05 Electricidad | ELE_ILU_FB_STANPRY_N | PROYECTOR ORIENTABLE STAN FARO BARCELONA Y BOMBILLA 2700K(NEGRO O | u |  |  |  |  |  | 43.84 €
05 Electricidad | ELE_ILU_FINS | FOCO CUARTO INSTALACIONES | u |  | 37.93 € | 37.93 € |  | 37.93 € | 37.93 €
05 Electricidad | ELE_ILU_LED | TIRA LED 14,4 W/ML 2700K | m | 28.77 € |  |  | 28.77 €
05 Electricidad | ELE_ILU_LIN | LINESTRA DE 32W 2500K | u | 66.36 € | 66.36 € | 66.36 € | 66.36 € | 66.36 € | 66.36 €
05 Electricidad | ELE_ILU_PYC | PREINSTALACIÓN Y CABLEADO PARA PUNTO DE LUZ | u |  |  |  |  |  | 0.01 €
05 Electricidad | ELE_ILU_TLED | TIRA LED 14,4W/ML 2700K CON PERFIL Y DIFUSOR 10X5MM | m | 28.77 € | 42.00 € |  |  |  | 41.50 €
05 Electricidad | ELE_INS_CAA | CIRCUITO DE AIRE ACONDICIONADO | u | 120.00 € | 120.00 € | 120.00 € | 120.00 €
05 Electricidad | ELE_INS_CGP | CUADRO GENERAL DE MANDO Y PROTECCIÓN | u | 387.52 € | 387.52 € | 387.52 € | 387.52 € | 387.52 € | 387.52 €
05 Electricidad | ELE_INS_IEI010 | RED DE DISTRIBUCIÓN INTERIOR EN TINI: A DESARROLLAR TI | Ud | 3800.00 €
05 Electricidad | ELE_INS_IEI010 | RED DE DISTRIBUCIÓN INTERIOR EN TINI: A DESARROLLAR TIPOS | Ud |  |  |  | 3746.64 € | 900.00 €
05 Electricidad | ELE_INS_LVV | CIRCUITO LAVAVAJILLAS | u |  |  |  |  |  | 35.00 €
05 Electricidad | ELE_INS_TGT | TOMA GENERAL DE TIERRAS | u | 33.95 € | 33.95 € | 33.95 € | 33.95 € | 33.95 € | 33.95 €
05 Electricidad | ELE_MEC_EN | ENCHUFE |  |  |  |  |  |  | 541.69 €
05 Electricidad | ELE_MEC_INT | INTERRUPTORES |  |  |  |  |  |  | 279.08 €
05 Electricidad | ELE_MEC_S270_V2E | PAREJA VERTICAL 2 ENCHUFES 16A SIMON 270 BLANCO | u |  | 47.12 € | 47.12 €
05 Electricidad | ELE_MEC_S270B_C10 | CONMUTADOR 10A SIMON 270 BLANCO | u | 21.16 € | 21.16 € | 21.16 € | 21.16 € | 21.16 € | 21.16 €
05 Electricidad | ELE_MEC_S270B_E16 | ENCHUFE 16A SIMON 270 BLANCO | u | 23.56 € | 23.56 € | 23.56 € | 23.56 € | 23.56 € | 23.56 €
05 Electricidad | ELE_MEC_S270B_E25 | ENCHUFE 25A SIMON 270 BLANCO | u | 31.35 € | 31.35 € | 31.35 € | 31.35 € | 31.35 € | 31.35 €
05 Electricidad | ELE_MEC_S270B_H2C10 | PAREJA HORIZONTAL CONMUTADORES 10A SIMON 270 BLANCO | u | 42.32 € | 42.32 €
05 Electricidad | ELE_MEC_S270B_H2C10 | PAREJA HORIZONTAL CONMUTADORES 10A | u |  |  | 42.32 €
05 Electricidad | ELE_MEC_S270B_H2E16 | PAREJA HORIZONTAL ENCHUFES 16A SIMON 270 BLANCO | u | 47.12 € | 47.12 €
05 Electricidad | ELE_MEC_S270B_H2E16 | PAREJA HORIZONTAL ENCHUFES 16A SIMON | u |  |  | 47.12 €
05 Electricidad | ELE_MEC_S270B_H2E16 | PAREJA HORIZONTAL ENCHUFES 16A SIMON 270 | u |  |  |  | 47.04 € | 47.12 €
05 Electricidad | ELE_MEC_S270B_H2I10 | PAREJA HORIZONTAL INTERRUPTORES 10A SIMON 270 | u |  |  |  | 36.60 €
05 Electricidad | ELE_MEC_S270B_H3C10 | TRÍO HORIZONTAL CONMUTADORES 10A SIMON 270 BLANCO | u |  | 63.48 €
05 Electricidad | ELE_MEC_S270B_H3C10 | TRÍO HORIZONTAL CONMUTADORES 10A | u |  |  | 63.48 €
05 Electricidad | ELE_MEC_S270B_H3E16 | TRÍO HORIZONTAL ENCHUFES 16A SIMON 270 BLANCO | u |  | 70.68 € |  | 79.53 €
05 Electricidad | ELE_MEC_S270B_H3E16 | TRÍO HORIZONTAL ENCHUFES 16A SIMON 270 | u |  |  | 70.68 €
05 Electricidad | ELE_MEC_S270B_H3I10 | TRÍO HORIZONTAL INTERRUPTORES 10A SIMON 270 | u |  |  |  | 54.90 €
05 Electricidad | ELE_MEC_S270B_HI10E16 | PAREJA HORIZONTAL INTERRUPTOR 10A Y ENCHUFE | u |  |  |  | 47.04 €
05 Electricidad | ELE_MEC_S270B_HIC10 | PAREJA HORIZONTAL INTERRUPTOR Y CONMUTADOR 10A SIMON 27 | u | 39.46 € | 39.50 €
05 Electricidad | ELE_MEC_S270B_HIC10 | PAREJA HORIZONTAL INTERRUPTOR Y | u |  |  | 39.50 €
05 Electricidad | ELE_MEC_S270B_I10 | INTERRUPTOR 10A SIMON 270 BLANCO | u | 18.30 € | 18.30 € | 18.30 € | 18.30 € | 18.30 € | 18.30 €
05 Electricidad | ELE_MEC_S270B_RJ45 | TOMA RJ45 SIMON 270 BLANCO | u |  |  |  |  |  | 50.79 €
05 Electricidad | ELE_MEC_S270B_TTV | TOMA DE TV SIMON 270 BLANCO | u |  |  |  |  |  | 45.00 €
05 Electricidad | ELE_MEC_S270B_V2E16 | PAREJA VERTICAL ENCHUFES 16A SIMON 270 BLANCO | u |  |  |  |  | 47.12 €
05 Electricidad | ELE_MEC_S270B_V2I10 | PAREJA VERTICAL INTERRUPTORES 10A SIMON 270 | u |  |  |  | 36.30 €
05 Electricidad | ELE_MEC_S270B_V3E16 | TRÍO VERTICAL ENCHUFES 16A SIMON 270 BLANCO | u |  |  |  | 79.53 €
05 Electricidad | ELE_TEL_ANT | ANTENA TV | u | 256.28 € |  |  | 256.28 €
05 Electricidad | ELE_TEL_CTC | CAJA DE TELECOMUNICACIONES | u | 48.40 € | 48.40 € | 48.40 € | 48.40 € | 48.40 € | 48.40 €
05 Electricidad | ELE_TEL_S270B_RJ45 | TOMA RJ45 SIMON 270 BLANCO | u | 50.79 € | 50.79 € | 50.79 € | 50.79 € | 50.79 €
05 Electricidad | ELE_TEL_S270B_TTV | TOMA DE TV SIMON 270 BLANCO | u | 45.00 € | 45.00 € | 45.00 € | 45.00 € | 45.00 €
06 Cerrajería | CER_BAR | BARANDILLA BASTIDOR DE ACERO Y MALLA SIMPLE TORSIÓN | m | 217.80 €
06 Cerrajería | CER_BAR | BARANDILLA BASTIDOR DE ACERO Y MALLA SIMPLE | m |  |  |  | 217.80 €
06 Cerrajería | CER_PEN_1HA_MDT | PUERTA DE ENTRADA DE 1H ABATIBLE DE MADERA TERMOTRATADA | u | 2256.00 € |  |  |  |  | 2256.00 €
06 Cerrajería | CER_PEN_1HA_MDT | PUERTA DE ENTRADA DE 1H ABATIBLE DE VIROC | u |  |  |  | 1586.32 €
06 Cerrajería | CER_PI_AIS | XPS PUERTA DE INSTALACIONES | m2 |  | 10.00 € | 10.00 €
06 Cerrajería | CER_PIN_1H_MP | PUERTA DE INSTALACIONES 1H ABATIBLE MADERA DE PNO | u |  | 524.00 € | 524.00 €
06 Cerrajería | CER_PIN_1HA_MIG | PUERTA DE INSTALACIONES 1H ABATIBLE MINIONDA |  |  |  |  |  | 524.00 €
06 Cerrajería | CER_PIN_1HA_MIL | XPS PUERTA INSTALACIONES |  |  |  |  |  | 10.00 €
06 Cerrajería | CER_PIN_2HA_MP | PUERTA DE INSTALACIONES 2H ABATIBLES MADERA DE PINO |  |  | 1610.00 € | 1610.00 €
06 Cerrajería | LEA010 | PUERTA METÁLICA DE ENTRADA A VIVIENDA. | Ud | 1786.35 €
07 Fontanería | FON_TER_50 | TERMO ELÉCTRICO DE 50L | u | 420.00 € |  |  | 420.00 € | 420.00 €
07 Fontanería | FON_TER_80 | TERMO ELÉCTRICO DE 80L | u | 545.00 € |  |  | 545.00 €
08 Acabado de fachada | ACF_CAR | REVESTIMIENTO DE MADERA CARBONIZADA | m² | 140.00 € |  |  | 140.00 €
08 Acabado de fachada | ACF_COR | REVESTIMIENTO DE CHAPA DE ACERO CORTÉN DE 2MM | m² | 115.00 €
08 Acabado de fachada | ACF_COR | REVESTIMIENTO DE CHAPA DE ACERO CORTÉN DE | m² |  |  |  | 115.00 €
08 Acabado de fachada | ACF_ENF | REVESTIMIENTO DE AQUAPANEL CON ENFOSCADO DE CEMENTO | m² | 76.00 €
08 Acabado de fachada | ACF_ENF | REVESTIMIENTO DE AQUAPANEL CON ENFOSCADO DE | m² |  |  |  | 76.00 €
08 Acabado de fachada | ACF_MC | REVESTIMIENTO DE PANELES DE CASTAÑO | m² |  | 106.23 € | 106.23 €
08 Acabado de fachada | ACF_MIN | REVESTIMIENTO CHAPA DE ACERO MINIONDA GALVANIZADO | m² | 45.00 €
08 Acabado de fachada | ACF_MIN | REVESTIMIENTO CHAPA DE ACERO MINIONDA | m² |  |  |  | 45.00 € | 45.00 €
08 Acabado de fachada | ACF_MIN_LNM | REVESTIMIENTO CHAPA DE ACERO MINIONDA GALVANIZADO LACAD | m² | 46.00 €
08 Acabado de fachada | ACF_MIN_LNM | REVESTIMIENTO CHAPA DE ACERO MINIONDA | m² |  |  |  | 46.00 €
08 Acabado de fachada | ACF_MIN_LNM | REVESTIMIENTO CHAPA DE ACERO MINIONDA GALVANIZADO LACADO EN NEGRO | m² |  |  |  |  |  | 46.00 €
08 Acabado de fachada | ACF_MPB | REVESTIMIENTO DE PANELES DE PINO CUPERIZADO PINTADO DE | m² |  | 106.23 €
08 Acabado de fachada | ACF_PB | PINTURA ESMALTE BLANCO | m² |  | 7.80 €
08 Acabado de fachada | ACF_PLA | PLIEGES EN VENTANAS DE CHAPA DE ACERO | m | 35.00 € | 35.00 € |  | 35.00 €
08 Acabado de fachada | ACF_PLC | PLIEGES EN VENTANAS DE CHAPA DE ACERO CORTÉN DE 2MM | m | 45.00 €
08 Acabado de fachada | ACF_PLC | PLIEGES EN VENTANAS DE CHAPA DE ACERO CORTÉN | m |  |  |  | 45.00 €
08 Acabado de fachada | ACF_PLG | PLIEGES EN VENTANAS DE CHAPA DE ACERO | m |  |  |  | 35.00 € | 35.00 €
08 Acabado de fachada | ACF_PLG | PLIEGES EN VENTANAS DE CHAPA DE ACERO GALVANIZADO | m |  |  |  |  |  | 35.00 €
08 Acabado de fachada | ACF_PLG_LNM | PLIEGES EN VENTANAS DE CHAPA DE ACERO GALVANIZADO LACAD | m | 36.00 €
08 Acabado de fachada | ACF_TER | REVESTIMIENTO DE PANELES DE PINO TERMOTRATADO | m² | 106.23 € |  |  | 106.23 € |  | 106.23 €
08 Acabado de fachada | ACF_VIR | REVESTIMIENTO DE VIROC | m² | 58.00 €
08 Acabado de fachada | ACF_VIR | REVESTIMIENTO DE VIROC ROJO | m² |  |  |  | 58.00 €
08 Acabado de fachada | FAZ050 | REVESTIMIENTO EXTERIOR DE FACHADA VENTILADA, DE LAMAS | m² |  |  |  | 107.13 €
09 Carpintería exterior | CAE_COR60_1B_90 | COR-60 1H BATIENTE 900X2550 | u | 1345.06 € |  |  | 1749.27 €
09 Carpintería exterior | CAE_COR60_1F_120 | COR-60 1H FIJA 1200X2550 |  |  |  |  | 1916.17 €
09 Carpintería exterior | CAE_COR60_1F_2240 | COR-60 1H FIJA 2240X2550 |  |  |  |  | 2876.12 €
09 Carpintería exterior | CAE_COR60_1F_45 | COR-60 1H FIJA 450X2550 |  |  |  |  | 704.44 € | 704.44 €
09 Carpintería exterior | CAE_COR60_1F_90 | COR-60 1H FIJA 900X2550 |  |  |  |  | 1362.75 €
09 Carpintería exterior | CAE_COR60_1F_90_NL | COR-60 1H FIJA 900X2550 (NEGRO LIJA) | u |  |  |  |  |  | 831.54 €
09 Carpintería exterior | CAE_COR60_1OB_45 | COR-60 1H OSCILOBATIENTE 450X2550 |  |  | 1015.00 € | 1015.00 € | 1015.00 € | 1015.00 €
09 Carpintería exterior | CAE_COR60_1OB_45_NL | COR-60 1H OSCILOBATIENTE 450X2550 (NEGRO LIJA) | u |  |  |  |  |  | 878.62 €
09 Carpintería exterior | CAE_COR60_1OB_90 | COR-60 1H OSCILOBATIENTE 900X2550 |  |  | 1349.50 € | 1349.50 € | 2160.87 €
09 Carpintería exterior | CAE_COR60_1OBF_45 | COR-60 1H OSCILOBATIENTE Y FIJO INFERIOR 450X2550 | u | 971.13 € | 1200.00 €
09 Carpintería exterior | CAE_CORV_1F_265 | COR-VISION 1H FIJO 2650X2550 | u | 2720.61 €
09 Carpintería exterior | CAE_CORV_1F1C_180_NL | COR-VISION 1H FIJA Y 1H CORREDERA 1800X2550 (NEGRO LIJA) | u |  |  |  |  |  | 2705.80 €
09 Carpintería exterior | CAE_CORV_1F1C_240 | COR-VISION 1H FIJA Y 1H CORREDERA 2400X2550 |  |  |  |  | 3193.15 €
09 Carpintería exterior | CAE_CORV_1F1C_268 | COR-VISION 1H FIJA Y 1H CORREDERA 2680X2550 |  |  |  |  |  | 3430.63 €
09 Carpintería exterior | CAE_CORV_1F1C_268S | COR-VISION 1H FIJA Y 1H CORREDERA SIMÉTRICA 2680X2550 |  |  | 3719.74 € | 3719.74 €
09 Carpintería exterior | CAE_CORV_1F1C_268S_NL | COR-VISION 1H FIJA Y 1H CORREDERA SIMÉTRICA 2680X2550 (NEGRO LIJA) | u |  |  |  |  |  | 3419.39 €
09 Carpintería exterior | CAE_CORV_1F1C_272 | COR-VISION 1H FIJA Y 1H CORREDERA SIMÉTRICA |  |  |  |  | 3617.41 €
09 Carpintería exterior | CAE_CORV_1F1C_275S | COR-VISION 1H FIJA Y 1H CORREDERA SIMÉTRICA 2750X2550 |  |  | 3719.74 € | 3719.74 €
09 Carpintería exterior | CAE_CORV_1F1C_276 | COR-VISION 1H FIJA Y 1H CORREDERA 2760X2550 |  |  |  |  | 3689.19 €
09 Carpintería exterior | CAE_CORV_1F1C_277 | COR-VISION 1H FIJA Y 1H CORREDERA SIMÉTRICA |  |  |  |  | 3798.76 €
09 Carpintería exterior | CAE_CORV_1F1C_280S | COR-VISION 1H FIJA Y 1H CORREDERA SIMÉTRICA 2800C2550 |  |  | 3719.74 € | 3719.74 €
09 Carpintería exterior | CAE_CORV_1F1C_292S | COR-VISION 1H FIJA Y 1H CORREDERA SIMÉTRICA 2920X2550 |  |  | 3719.74 € | 3719.74 €
09 Carpintería exterior | CAE_CORV_1F1C_375 | COR-VISION 1H FIJA Y 1H CORREDERA SIMÉTRICA |  |  |  |  | 4467.40 €
09 Carpintería exterior | CAE_CORV_1F1C_375S | COR-VISION 1H FIJA Y 1H CORREDERA SIMÉTRICA |  |  |  |  |  | 4467.40 €
09 Carpintería exterior | CAE_CORV_2C_375 | COR-VISION 2H CORREDERAS 3750X2550 | u | 4646.45 €
10 Carpintería interior | 05AUNCO | AUMENTO POR PUERTA CORREDERA EN LOS TRES CASOS | ud |  | 45.00 € | 45.00 €
10 Carpintería interior | CAI_ARM_ABD_1P | ARMARIO ABEDUL DE 1 PUERTA (ANCHO 400-700MM) | u |  |  |  |  |  | 360.00 €
10 Carpintería interior | CAI_ARM_DML_4P | ARMARIO DM LACADO DE 4 PUERTAS (ANCHO 1600-2400MM) |  |  | 2866.00 € | 2866.00 €
10 Carpintería interior | CAI_PUE_ABD_1C | PUERTA ABEDUL CORREDERA (ANCHO 1000MM) |  |  | 955.00 € | 955.00 €
10 Carpintería interior | CAI_PUE_ABD_1HA62 | PUERTA ABEDUL 1H ABATIBLE (ANCHO 625MM) | u | 564.00 € | 564.00 € | 564.00 € |  |  | 564.00 €
10 Carpintería interior | CAI_PUE_ABD_1HA62 | PUERTA CONTRACHAPADO DE PINO 1H ABATIBLE | u |  |  |  | 564.00 €
10 Carpintería interior | CAI_PUE_ABD_1HA72 | PUERTA ABEDUL 1H ABATIBLE (ANCHO 725MM) | u | 780.00 € | 780.00 € | 780.00 € |  | 780.00 € | 780.00 €
10 Carpintería interior | CAI_PUE_ABD_1HA72 | PUERTA CONTRACHAPADO DE PINO 1H ABATIBLE | u |  |  |  | 780.00 €
10 Carpintería interior | CAI_PUE_DML_1HA62 | PUERTA DM LACADO 1H ABATIBLE (ANCHO 625MM) | u | 744.00 € | 744.00 € | 744.00 € | 744.00 €
10 Carpintería interior | CAI_PUE_DML_1HA72 | PUERTA DM LACADO 1H ABATIBLE (ANCHO 725MM) | u | 744.00 € |  |  | 744.00 €
10 Carpintería interior | CAI_PUE_OSB_1HA62 | PUERTA OSB 1H ABATIBLE (ANCHO 625MM) | u | 504.00 € |  |  | 504.00 €
10 Carpintería interior | CAI_TABMOV | TABIQUE MÓVIL | u | 6424.49 €
11 Tabiquería y trasdosados | 113PMOHO | PINTURA PLASTICA ANTIMOHO | m2 |  | 7.80 € | 7.80 €
11 Tabiquería y trasdosados | 114PPLAS | PINTURA PLASTICA | m2 |  | 7.10 € | 7.10 €
11 Tabiquería y trasdosados | TAB_2PLA | DOBLE PLACA DE YESO LAMINADO | m² |  | 27.12 € | 27.12 €
11 Tabiquería y trasdosados | TAB_ABE | CONTRACHAPADO DE ABEDUL | m² | 82.80 € | 82.80 € |  |  |  | 82.80 €
11 Tabiquería y trasdosados | TAB_ABE | CONTRACHAPADO DE PINO | m² |  |  |  | 74.40 €
11 Tabiquería y trasdosados | TAB_AQU | PLACA DE AQUAPANEL DE 15MM | m² | 40.00 €
11 Tabiquería y trasdosados | TAB_CER | ALICATADO CERÁMICO BLANCO MATE 120X60CM | m² | 50.00 €
11 Tabiquería y trasdosados | TAB_CER | ACABADO CERAMICO | m² |  | 45.00 € | 45.00 € | 45.00 €
11 Tabiquería y trasdosados | TAB_CER | ALICATADO CERÁMICO BLANCO | m² |  |  |  |  |  | 45.00 €
11 Tabiquería y trasdosados | TAB_DM13 | TABLERO DE DM DE 13MM | m² | 26.00 €
11 Tabiquería y trasdosados | TAB_DML | TABLERO DE DM | m² |  | 26.00 € | 26.00 € | 26.00 € | 26.00 € | 26.00 €
11 Tabiquería y trasdosados | TAB_FIJ | FIJACIÓN OCULTA PARA PANELADOS EN MADERA | m² | 18.00 € | 18.00 € |  |  |  | 18.00 €
11 Tabiquería y trasdosados | TAB_HID | PLACA DE YESO LAMINADO HIDRÓFUGO DE 15MM | m² |  | 19.03 € | 19.03 €
11 Tabiquería y trasdosados | TAB_HID | PLACA DE YESO LAMINADO HIDRÓFUGO DE 13+13MM | m² |  |  |  | 38.06 €
11 Tabiquería y trasdosados | TAB_HID | DOBLE PLACA DE YESO LAMINADO HIDRÓFUGO DE | m² |  |  |  |  | 19.03 €
11 Tabiquería y trasdosados | TAB_HID_1 | PLACA DE YESO LAMINADO HIDROFUGO DE 13 MM | m2 |  |  |  |  |  | 19.03 €
11 Tabiquería y trasdosados | TAB_HID_2 | DOBLE PLACA DE YESO LAMINADO HIDRÓFUGO DE 13MM + 13MM | m² |  |  |  |  |  | 32.98 €
11 Tabiquería y trasdosados | TAB_OKU | TABLERO DE OKUME | m² | 55.80 €
11 Tabiquería y trasdosados | TAB_OSB | TABLERO OSB DE CHOPO | m² | 52.80 €
11 Tabiquería y trasdosados | TAB_PIN | CONTRACHAPADO DE PINO | m² | 74.40 €
11 Tabiquería y trasdosados | TAB_PLA | PLACA DE YESO LAMINADO DE 13+13MM | m² |  |  |  | 27.12 €
11 Tabiquería y trasdosados | TAB_PLA | DOBLE PLACA DE YESO LAMINADO DE 26MM (13+13) | m² |  |  |  |  | 13.56 €
11 Tabiquería y trasdosados | TAB_PLA_1 | PLACA DE YESO LAMINADO DE 13 MM | m2 |  |  |  |  |  | 13.56 €
11 Tabiquería y trasdosados | TAB_PLA_2 | DOBLE PLACA DE YESO LAMINADO DE 13MM + 13 MM | m² |  |  |  |  |  | 23.50 €
11 Tabiquería y trasdosados | TAB_PYL13 | PLACA DE YESO LAMINADO DE 13MM | m² | 13.56 €
11 Tabiquería y trasdosados | TAB_PYL2X13 | PLACA DE YESO LAMINADO DOBLE DE 13+13MM | m² | 13.56 €
11 Tabiquería y trasdosados | TAB_PYLH13 | PLACA DE YESO LAMINADO HIDRÓFUGO DE 13MM | m² | 19.03 €
11 Tabiquería y trasdosados | TAB_PYLH2X13 | PLACA DE YESO LAMINADO HIDRÓFUGO DOBLE DE 13+13MM | m² | 19.03 €
11 Tabiquería y trasdosados | TAB_TAB | TABLONES DE PINO SIN CEPILLAR EN SIERRA | m² | 85.00 €
12 Pavimentos | PAV_CORCH | TARIMA DE CORCHO |  |  |  |  | 53.00 €
12 Pavimentos | PAV_ROAL | RODAPIÉ DE ALUMINIO LACADO EN BLANCO | m | 20.00 €
12 Pavimentos | PAV_ROAL | RODAPIÉ DE ALUMINIO | m |  | 20.00 € |  | 20.00 € | 20.00 € | 20.00 €
12 Pavimentos | PAV_RODMPVC | RODAPIÉ DM REVESTIDO DE PVC BLANCO | m | 16.20 € | 16.20 € |  | 16.20 € | 16.20 € | 16.20 €
12 Pavimentos | PAV_SC | SOLADO CERÁMICO |  |  |  |  |  |  | 321.08 €
12 Pavimentos | PAV_SC_GTME_60X60 | SOLADO CERÁMICO GEOTILES MEMORY 30X60CM (A | m² |  |  |  | 46.00 €
12 Pavimentos | PAV_SOCE | SOLADO CERÁMICO | m² | 45.00 € |  |  |  | 45.00 €
12 Pavimentos | PAV_TAPI | TARIMA DE PINO TERMOTRATADO | m² | 102.00 € |  |  | 102.00 € |  | 102.00 €
12 Pavimentos | PAV_TARO | TARIMA DE ROBLE | m² | 78.00 € | 78.00 € |  | 78.00 € | 78.00 €
12 Pavimentos | PAV_TM | TARIMA DE MADERA |  |  |  |  |  |  | 4439.78 €
13 Techos | TEC_ABE | TECHO DE ABEDUL | m² | 82.80 € |  |  | 82.80 €
13 Techos | TEC_AQU | TECHO DE AQUAPANEL | m² |  | 40.00 € | 40.00 €
13 Techos | TEC_OSB | TECHO DE OSB | m² | 52.80 € |  |  | 52.80 €
13 Techos | TEC_PIN | TECHO DE CONTRACHAPADO DE PINO | m² | 74.40 € |  |  | 74.40 €
13 Techos | TEC_PIN_B | PINTURA BLANCA TECHO PLACA DE YESO LAMINADO | m² |  | 7.10 € | 7.10 €
13 Techos | TEC_PIN_BAM | TECHO DE PLACA DE YESO LAMINADO HIDRÓFUGO DE 15MM | m² |  | 7.80 € | 7.80 €
13 Techos | TEC_PLA | TECHO DE PLACA DE YESO LAMINADO DE 15MM | m² | 13.56 € | 13.56 € | 13.56 € | 13.56 € | 13.56 € | 13.56 €
13 Techos | TEC_PLH | TECHO DE PLACA DE YESO LAMINADO HIDRÓFUGO DE 15MM | m² | 19.03 € | 19.03 € | 19.03 € |  |  | 19.03 €
13 Techos | TEC_PLH | TECHO DE PLACA DE YESO LAMINADO HIDRÓFUGO DE | m² |  |  |  | 19.03 € | 19.03 €
14 Baños | 02.07.14 | BAÑO DE CUBRO (GAMA LACA) |  |  |  |  | 1286.00 €
14 Baños | BAN_BID_TES | BIDET TESI SUSPENDIDO | u | 548.00 € |  |  | 548.00 €
14 Baños | BAN_COL_GR | COLOCAION DE LAVABO, GRIFO Y SIFON | u |  |  | 144.07 €
14 Baños | BAN_DUC_PLA_80X100 | PLATO DE DUCHA DE 80X100CM | u | 300.00 € |  |  | 300.00 €
14 Baños | BAN_DUC_PLA_80X140 | PLATO DE DUCHA DE 80X140CM | u |  | 580.00 € | 580.00 €
14 Baños | BAN_DUC_PLA_90X128 | PLATO DE DUCHA DE 90X128CM | u | 561.56 € |  |  | 561.56 € | 561.56 €
14 Baños | BAN_DUC_PLA_90X205 | PLATO DE DUCHA DE 90X205CM | u | 621.95 € |  |  | 621.95 €
14 Baños | BAN_DUC_THA | CONJUNTO DE DUCHA IMEX THALOS STICK CROMADO | u | 159.50 € | 159.50 € | 159.50 € | 159.50 € | 159.50 € | 159.50 €
14 Baños | BAN_ESP | ESPEJO PLATEADO CON BASTIDOR PARA LED | u |  |  |  | 230.00 € |  | 230.00 €
14 Baños | BAN_GRI_ETN | GRIFO EMPOTRADO IMEX ETNA GLT023 CROMADO | u | 57.60 € | 57.60 € | 57.60 € | 57.60 € |  | 57.60 €
14 Baños | BAN_IMP | IMPERMEABILIZACIÓN PLATO DE DUCHA | u | 50.00 € | 50.00 € | 50.00 € | 50.00 € | 50.00 € | 50.00 €
14 Baños | BAN_INO_TES | INODORO TESI SUSPENDIDO CISTERNA OCULTA | u | 811.21 € | 811.21 € | 811.21 € | 811.21 € |  | 811.21 €
14 Baños | BAN_INS | INSTALACIÓN COMPLETA FONTANERÍA Y SANEAMIENTO BAÑO | u | 494.00 € | 494.00 € | 494.00 €
14 Baños | BAN_INS | INSTALACIÓN COMPLETA FONTANERÍA Y | u |  |  |  |  | 494.00 €
14 Baños | BAN_INS_ASE | INSTALACIÓN COMPLETA FONTANERÍA Y | u |  |  |  | 394.00 €
14 Baños | BAN_INS_BAN | INSTALACIÓN COMPLETA FONTANERÍA Y | u |  |  |  | 494.00 €
14 Baños | BAN_INS_BAN | INSTALACIÓN COMPLETA FONTANERÍA Y SANEAMIENTO BAÑO | u |  |  |  |  |  | 494.00 €
14 Baños | BAN_LAV_STA | LAVABO STARBATH 35X12MM | u | 96.38 € | 96.38 € | 96.38 € | 96.38 € |  | 96.38 €
14 Baños | BAN_MAM | MAMPARA DE DUCHA DE VIDRIO SEGÚN PLANOS | u | 500.00 €
14 Baños | BAN_MAM | MAMPARA DE VIDRIO 70CM | u |  |  |  |  |  | 400.00 €
14 Baños | BAN_MAMP | MAMPARA FIJA DE VIDRIO | u |  |  | 400.00 €
14 Baños | BAN_MUE_LAV | MUEBLE LAVABO SEGÚN PLANOS | u | 500.00 €
14 Baños | BAN_MUE_LAV | MUEBLE ENCIMERA DE BAÑO EN KRION (1,25M) | u |  | 2605.26 € | 2605.26 €
14 Baños | BAN_MUE_LAV_0.5 | MUEBLE ENCIMERA DE BAÑO EN KRION (0,5M) | u |  | 1042.20 € | 1042.20 €
15 Cocina | 09TLAV | TOMA PARA LAVADORA | ud |  | 75.00 € | 75.00 €
15 Cocina | 12CAB.C2M | COCINA+ISLA/MUEBLE ABEDUL 2.76-2M | ud |  | 3984.00 € | 3984.00 €
15 Cocina | COC_ECE_CAM | CAMPANA EXTRACTORA BALAY 3BF267EX | u | 370.00 €
15 Cocina | COC_ECE_HOR | HORNO IKEA MATALSKARE | u | 299.00 €
15 Cocina | COC_ECE_IN2 | PLACA DE INDUCCIÓN DE 2 FUEGOS IKEA VALBILDAD | u | 249.00 €
15 Cocina | COC_ECE_IN4 | PLACA DE INDUCCIÓN DE 4 FUEGOS IKEA 300 MATMASSIG | u | 299.00 €
15 Cocina | COC_ECE_LVV | LAVAVAJILLAS IKEA LAGAN | u | 399.00 €
15 Cocina | COC_ECE_NEA | NEVERA ALTA IKEA 500 TINAD | u | 749.00 €
15 Cocina | COC_ECE_NEB | NEVERA BAJA IKEA 500 HUTTRA | u | 499.00 €
15 Cocina | COC_ECP_CAM | CAMPANA EXTRACTORA BALAY 3BF267EX | u |  | 370.00 € | 370.00 €
15 Cocina | COC_ECP_HOR | HORNO PIROLÍTICO SAMSUNG 68L NV68A1170BS | u |  | 499.00 € | 499.00 €
15 Cocina | COC_ECP_IN2 | PLACA BOSCH SERIE 6 DOMINO INDUCCIÓN | u |  | 480.00 € | 480.00 €
15 Cocina | COC_ECP_LVV | LAVAVAJILLAS SERIE 6000 SATELLITE CLEAN | u |  | 699.00 € | 699.00 €
15 Cocina | COC_ECP_NEA | FRIGORÍFICO COMBI AEG 925501322 NO FROST | u |  | 1250.00 € | 1250.00 €
15 Cocina | COC_EPC_LAV | LAVADORA SECADORA CARGA FRONTAL |  |  | 700.00 € | 700.00 €
15 Cocina | COC_MOB_A_60 | MUEBLE ALTO DE COCINA DE 60X45X74CM ABEDUL | u | 300.00 €
15 Cocina | COC_MOB_B_60 | MUEBLE BAJO DE COCINA DE 60X65X93CM ABEDUL | u | 400.00 €
15 Cocina | COC_MOB_R | TAPETA DE ABEDUL PERFORADA PARA IMPULSIÓN Y EXTRACCIÓ | u | 100.00 €
15 Cocina | COC_OTR_EKR | ENCIMERA DE KRION DE 66CM | m |  | 1105.27 € | 1105.27 €
15 Cocina | COC_OTR_EKR_FYP | ENCIMERA DE KRION DE 66CM CON TALADRO PARA FREGADERO Y | m | 2000.00 € | 1105.27 €
15 Cocina | COC_OTR_EKR_FYP | ENCIMERA DE KRION DE 66CM CON TALADRO PARA FREGADERO Y PLACA | m |  |  | 1105.27 €
15 Cocina | COC_OTR_FKR | FRENTE DE KRION DE 63CM | m | 1500.00 € | 1042.15 € | 1042.15 €
15 Cocina | COC_OTR_FRG | FREGADERO INOX | u | 100.00 € | 52.24 € | 52.24 €
15 Cocina | COC_OTR_GRI | GRIFO COCINA CROMADO | u | 100.00 € | 105.30 € | 105.30 €
16 Climatización y ventilación | CLI_AAC_1X2 | AIRE ACONDICIONADO DE CONDUCTOS (1UD EXTERIOR + 2UD INT | u | 2520.00 €
16 Climatización y ventilación | CLI_AAC_1X4 | AIRE ACONDICIONADO DE CONDUCTOS (1UD EXTERIOR + 4UD INT | u | 3520.00 €
16 Climatización y ventilación | CLI_AAC_1X4 | AIRE ACONDICIONADO DE CONDUCTOS (1UD EXTERIOR + 4UD INTERIORES) | u |  |  |  |  |  | 3520.00 €
16 Climatización y ventilación | CLI_AAC_CON | CONDUCTO DE CHAPA DE ACERO GALVANIZADO | m | 82.00 €
16 Climatización y ventilación | CLI_EST | ESTUFA DE LEÑA | u | 1199.80 € |  |  |  | 1199.80 €
16 Climatización y ventilación | CLI_EXT_COC | EXTRACCION DE COCINA | u |  | 116.00 € | 116.00 €
16 Climatización y ventilación | CLI_FAN | FANCOIL | u |  | 1261.00 €
16 Climatización y ventilación | CLI_FAN_PAR | FANCOIL DE PARED | u |  | 1040.00 €
16 Climatización y ventilación | CLI_FAN_PREINS | PREINSTALACION FANCOILS | u |  | 325.00 €
16 Climatización y ventilación | CLI_RAD_SUE | SUELO RADIANTE | m2 | 74.20 €
16 Climatización y ventilación | CLI_TER_AAC | TERMOSTATO AIRE ACONDICIONADO | u | 50.00 €
16 Climatización y ventilación | CLI_TOE | TOALLERO ELÉCTRICO | u |  | 200.00 €
16 Climatización y ventilación | VEN_CHI | CHIMENEA DE VENTILACIÓN CON SOMBRERETE | u | 145.00 € | 145.00 € | 145.00 € |  |  | 145.00 €
16 Climatización y ventilación | VEN_EXT | EXTRACTOR DE BAÑO | u | 100.00 € | 327.00 € | 327.00 € |  |  | 182.00 €
17 Aerotermia | 02.11.01 | MÓDULO FOTOVOLTAICO SERAPHIM SRP-450-BMB-HV |  |  |  |  | 105.00 €
17 Aerotermia | 02.11.06 | CIE DE LA INSTALACIÓN (BOLETÍN) Y LEGALIZACIÓN EN INDUSTRIA |  |  |  |  | 400.00 €
17 Aerotermia | AER_100_120 | AEROTERMIA PANASONIC PARA 100-120M2 | u | 8983.00 €
17 Aerotermia | AER_100_120 | INSTALACIÓN DE CORRIENTE ALTERNA Y PUESTA A TIERRA | u |  |  |  | 251.62 €
17 Aerotermia | AER_120_150 | AEROTERMIA PANASONIC PARA 120-150M2 | u | 9731.00 €
17 Aerotermia | AER_120_150 | MANO DE OBRA DE MONTAJE CON DESPLAZAMIENTO A | u |  |  |  | 1190.00 €
17 Aerotermia | AER_150_ | AEROTERMIA PANASONIC ALL IN ONE | u |  | 10270.00 €
17 Aerotermia | AER_30_50 | AEROTERMIA PANASONIC PARA 30-50M2 | u | 6760.00 €
17 Aerotermia | AER_30_50 | INVERSOR HÍBRIDO GOODWE GW6000-EHR | u |  |  |  | 975.91 €
17 Aerotermia | AER_50_80 | AEROTERMIA PANASONIC PARA 50-80M2 | u | 8436.00 € |  |  |  |  | 8436.00 €
17 Aerotermia | AER_50_80 | ESTRUCTURA PARA PANELES FV SOBRE CUBIERTA PLANA | u |  |  |  | 426.67 €
17 Aerotermia | AER_80_100 | AEROTERMIA PANASONIC PARA 80-100M2 | u | 8800.00 €
17 Aerotermia | AER_80_100 | INSTALACIÓN DE CORRIENTE CONTÍNUA | u |  |  |  | 318.33 €
17 Aerotermia | AER_ACS | AEROTERMIA (ACS) | u |  |  | 2038.50 €
18 Fotovoltaica | FOT_AC_CIE | CIE DE LA INSTALACIÓN (BOLETÍN) | u | 200.00 € |  |  |  |  | 200.00 €
18 Fotovoltaica | FOT_AC_EST | ESTRCUTURA PARA 10 PANELES | u | 200.00 € |  |  |  |  | 200.00 €
18 Fotovoltaica | FOT_AC_IH3600W | INVERSOR HÍBRIDO GOODWE GW36000-EHR | u | 718.67 € |  |  |  |  | 718.67 €
18 Fotovoltaica | FOT_AC_INSCA | INSTALACIÓN DE CORRIENTE ALTERNA Y PUESTA A TIERRA | u | 289.09 € |  |  |  |  | 289.09 €
18 Fotovoltaica | FOT_AC_INSCC | INSTALACIÓN DE CORRIENTE CONTÍNUA | u | 211.41 € |  |  |  |  | 211.41 €
18 Fotovoltaica | FOT_AC_MDOPL | MANO DE OBRA DE MONTAJE CON DESPLAZAMIENTO A PLASENCIA | u | 990.00 € |  |  |  |  | 990.00 €
18 Fotovoltaica | FOT_AC_PS450W | PANELES SOLARES FV RISEN RSM144-7-450M | u | 186.25 € |  |  |  |  | 186.25 €
18 Fotovoltaica | FOT_AS_BAT48V | BATERÍAS DE LITIO TURBO ENERGY US2000 48V 50A 5.1KWH | u | 1756.25 €
18 Fotovoltaica | FOT_AS_BOL | BOLETÍN DE LA INSTALACIÓN Y LEGALIZACIÓN EN INDUSTRI | u | 290.00 €
18 Fotovoltaica | FOT_AS_EST | ESTRCUTURA PARA 10 PANELES | u | 420.00 €
18 Fotovoltaica | FOT_AS_IH5000W | INVERSOR HÍBRIDO TURBO ENERGY HYBRID SERIES 48V 5.0 | u | 1328.13 €
18 Fotovoltaica | FOT_AS_INSCA | INSTALACIÓN DE CORRIENTE ALTERNA Y PUESTA A TIERRA | u | 201.05 €
18 Fotovoltaica | FOT_AS_INSCC | INSTALACIÓN DE CORRIENTE CONTÍNUA | u | 315.67 €
18 Fotovoltaica | FOT_AS_MDO | MANO DE OBRA DE MONTAJE DEL SISTEMA Y DESPLAZAMIENTOS | u | 1060.00 €
18 Fotovoltaica | FOT_AS_PS450W | PANELES SOLARES FV RISEN RSM144-7-450M | u | 186.25 €
19 Transporte, montaje y operarios | GRU | GRÚA | h |  | 105.00 € | 105.00 €
19 Transporte, montaje y operarios | GRU | GRÚA (FACTURA MORENO) | u |  |  |  | 3120.00 €
19 Transporte, montaje y operarios | LIM | LIMPIEZA FINAL | m² | 5.00 € | 5.00 € | 5.00 € | 5.00 € | 5.00 € | 5.00 €
19 Transporte, montaje y operarios | OPE | OPERARIOS | u |  |  |  |  |  | 4952.50 €
19 Transporte, montaje y operarios | OPE_AL | ALOJAMIENTO OPERARIOS | u | 50.00 € | 50.00 € | 50.00 € | 50.00 € | 50.00 €
19 Transporte, montaje y operarios | OPE_DI | DIETAS OPERARIOS | u | 35.00 € | 35.00 € | 35.00 € | 35.00 € | 35.00 €
19 Transporte, montaje y operarios | OPE_HO | HORAS DE TRABAJO OPERARIOS | h | 30.00 € | 30.00 € | 30.00 € | 30.00 € | 30.00 €
19 Transporte, montaje y operarios | OPE_KI | KILOMETRAJE OPERARIOS | km | 0.50 € | 0.50 € | 0.50 € | 0.50 € | 0.50 €
19 Transporte, montaje y operarios | TRA | TRANSPORTE | u |  | 4600.00 € | 4400.00 €
19 Transporte, montaje y operarios | TRA | TRANSPORTE (FACTURA MORENO) | u |  |  |  | 780.00 €
Otros | ES_PI_HEA100 | HEA100 | kg |  |  |  |  |  | 2.80 €
Otros | TE_AC_TM | TARIMA DE PINO TERMOTRATADO | m² |  |  |  |  |  | 102.00 €
Otros | TE_EST_CO_80.60 | CORREA RHS 80.60.4 | kg |  |  |  |  |  | 2.80 €
Otros | TE_EST_VI_200 | IPE 200 | kg |  |  |  |  |  | 2.80 €
Ejemplo de relleno: en la fila de VIGA IPE200 pon en «COSTE 2026» el €/kg soldado que te pase el taller (p. ej. 3,40) y el margen (p. ej. 20 %); el precio de venta 2026 sale solo.

Sheet: Resumen proyectos
RESUMEN POR PROYECTO: presupuesto de venta 2024 por capítulo
Capítulo | Fenwick (Guadalajara) € | Menorca Pino (may-24) € | Menorca Pino (oct-24) € | Sotopinilla € | Burdeos (Francia) € | El Boalo (Tini 85) € | Fenwick (Guadalajara) €/m² | Menorca Pino (may-24) €/m² | Menorca Pino (oct-24) €/m² | Sotopinilla €/m² | Burdeos (Francia) €/m² | El Boalo (Tini 85) €/m²
Superficie (m²) | 45 | 165 | 165 | 153 | 34 | 85
Estructura | 24469 € | 49167 € | 47176.05 € | 40149.6 € | 7911.99 € | 23303.35 €
Fachada y tabiques (panel) | 7128 € | 13473 € | 16398.41 € | 14447.15 € | 5753.97 € | 14319.5 €
Cubierta | 9535 € | 19526 € | 19203.22 € | 19542.35 € | 4996.49 € | 14855.99 €
Suelo | 2740 € | 8208 € | 12176.4 € | 8542.27 € | 1667.03 € | 6977.95 €
Electricidad | 6424 € | 16982 € | 16982.11 € | 9342.56 € | 2565.05 € | 2438.35 €
Cerrajería |  | 2151 € | 2150.6 € | 1586.32 € | 540.6 € | 2256 €
Fontanería |  |  |  | 545 € | 420 €
Acabado de fachada | 3650 € | 12255 € | 12254.66 € | 4785.24 € | 2451.75 € | 10653.99 €
Carpintería exterior | 14720 € | 30832 € | 30832.44 € | 31565.53 € | 9617.47 € | 20180.82 €
Carpintería interior | 7768 € | 18020 € | 18020 € | 6848 € | 780 € | 2484 €
Tabiquería | 7951 € | 11011 € | 11011.16 € | 7878.66 € | 913.83 € | 5600.37 €
Pavimentos | 6556 € | 10313 € | 10313.3 € | 13404.01 € | 2444.87 € | 7227.8 €
Techos | 538 € | 2779 € | 2778.8 € | 1509.04 € | 402.8 € | 931.35 €
Baños | 2669 € | 14727 € | 17702.9 € | 5183.9 € | 1265.06 € | 4432.38 €
Cocina | 10117 € | 17156 € | 17156 € | 10572 €
Climatización y ventilación | 3010 € | 13360 € | 2004 € |  | 1199.8 € | 4029 €
Aerotermia |  | 10270 € | 2038.5 € | 18304.6 € |  | 8436 €
Fotovoltaica |  |  |  | 5242.53 € |  | 3254.17 €
Transporte, montaje y operarios (+ obra in situ en Sotopinilla) | 5925 € | 30262 € | 33862 € | 84708.77 € | 170 € | 5377.5 €
TOTAL PRESUPUESTO
Comprobación: total del presupuesto original | 113200.33 € | 280490 € | 272060.55 € | 284157.53 € | 43100.71 € | 144795.33 €
Diferencia (partidas fuera de capítulo estándar)
Notas:
• Sotopinilla incluye 76.924 € de implantación y obra in situ (cimentación, movimiento de tierras, terrazas) dentro de «Transporte, montaje…». Sin eso, fábrica + transporte ≈ 207.000 € (1.355 €/m²).
• En Sotopinilla, cocina y baños se compraron a Cubro con un descuento de 5.431 €, y la aerotermia y la fotovoltaica son de Escotermia.
• Burdeos no incluye transporte ni montaje (solo limpieza).
• El Boalo: la diferencia (8.037 €) es la terraza (estructura IPE200/RHS y tarima de pino termotratado), fuera de los capítulos estándar.
• Menorca Pino: la «toma general de tierras» está medida 310 veces en lugar de 1 (+10.490 € de más en el presupuesto de venta). El error sigue en la versión de octubre.
• Menorca, de mayo a octubre de 2024: se suben los paneles a Tabihaus (+6.571 €), la estructura baja 1.991 € y los baños llevan mampara y colocación (+2.976 €). La climatización pasa de fancoils a solo ventilación (-11.356 €) y la aerotermia de 10.270 € a 2.039 €. En transporte hay 5 viajes a 4.400 € en lugar de 4 a 4.600 €. Total: -8.431 €.
• Menorca oct-24: en «Banco de precios» faltan algunas partidas (carpintería, armarios, tarima) porque no se pudieron leer del PDF. Son iguales que en mayo y ya están en esa columna.

Sheet: Coste real vs venta
COSTE REAL IMPUTADO (analítica DWHAI a 29/11/2024) FRENTE A LO CERTIFICADO A TINI
Importes sin IVA. Solo facturas de proveedor imputadas a cada proyecto; no incluye gastos generales (385.104 €). Menorca y Sotopinilla están INCOMPLETOS.
Concepto | Guadalajara (Fenwick) | Menorca Pino | Sotopinilla | Burdeos
Estructura (taller) | 38848.21 € | 42571.38 € | 18825.63 € | 12555.12 €
Panel sándwich y aislamiento | 7672.84 € | 24116.6 € | 27040.48 € | 2983.89 €
Carpintería (puertas, ventanas, tabique móvil, escalera) | 26713.32 € | 568.48 € | 12068.08 € | 8580.5 €
Suelos y paredes | 6933.2 € | 6147.69 € | 5003.56 € | 1235.96 €
Pintura | 3287.32 € | 1128.03 € |  | 983.29 €
Iluminación | 5927.4 € |  |  | 2879.3 €
Climatización | 5733.62 € |  | 3587 € | 1060.88 €
Baños y fontanería | 667.58 € |  | 547.94 € | 679.53 €
Cocina | 8181.65 €
Mano de obra propia imputada | 15795.28 € | 19002.15 € | 15024.95 € | 5872.54 €
Transporte | 4233.48 € |  |  | 492.8 €
Materiales de almacén, film, varios | 3973 € | 4660.36 € | 3632.74 € | 3079.75 €
Intereses y abonos | 2077.2 € | 397.17 € | 2110.43 € | 750.49 €
COSTE DIRECTO IMPUTADO
Certificado a Tini (ingreso DWHAI) | 109498.57 € | 280491.85 € | 259291.52 € | 41900.9 €
Margen bruto antes de gastos generales
% margen bruto
¿Coste completo? | Sí (casi) | Tini pagó directamente carpintería, cocina, baños, clima y transporte | Tini pagó directamente cocina, baños y parte del clima y la carpintería | Sí (casi)
Venta de lo que ejecutó DWHAI (sin lo que pagó Tini) |  | 154052 € | Pendiente: confirmar qué partidas pagó Tini |  | Menorca: presupuesto de mayo sin carpintería exterior e interior, baños, cocina, clima, aerotermia, transporte ni grúa.
Margen bruto sobre lo ejecutado por DWHAI
% margen bruto sobre lo ejecutado
RATIOS UNITARIOS DE COSTE REAL
Ratio | Guadalajara (Fenwick) | Menorca Pino | Sotopinilla | Burdeos
Kg de acero presupuestados | 7996.33 | 14039.05 | 12060.26 | 2601.93
Estructura: coste real €/kg (venta 2,80 €/kg + pintura)
m² de panel sándwich presupuestados (fachada + cubierta + suelo) | 148.6 | 349.5 | 325.6 | 113.9
Panel: coste real €/m² (venta 54–72 €/m²)
Superficie (m²) | 45 | 165 | 153 | 34
Mano de obra propia imputada €/m²
Lectura:
• Sotopinilla: la estructura (1,56 €/kg) parece facturada solo en parte por Talleres Solman a 29/11; no la uses como referencia.
• Guadalajara (Tini L) perdió dinero: la estructura (4,86 €/kg) y la carpintería (20.061 € de coste frente a 16.064 € vendidos) se comieron el margen.
• Panel: con Tabihaus (Menorca, Sotopinilla) el coste real (69–83 €/m²) supera el precio de venta de 2024. Con Tejafer y Geo Pannel (Guadalajara, Burdeos) salió mucho más barato. Hay que elegir proveedor y revisar el precio.
• Gastos generales de 2024 (no imputados): nave 76.500 €, aval, fianza y alquiler 59.000 €, gestión 60.345 €, mano de obra sin asignar 110.735 €, servicios de proyectos 25.785 €, resto 52.739 €. Total: 385.104 €.

Sheet: Mahón (libro abierto)
PROYECTO 182: MAHÓN (Iván Montero). Resumen de presupuesto Tini, 21/11/2024
Alcance: fabricación de estructura principal y secundaria, pintura y panel sándwich (Tini 4, dos plantas). Sin acabados ni instalaciones.
Concepto | Importe | % del total
Materiales: estructura, pintura, panel sándwich | 43180.13 €
Mano de obra, medios auxiliares, margen de fábrica, otros | 41430.97 €
Gestión y alquiler de nave (1/5 de la fábrica durante 5 meses) | 24500.00 €
Margen Tini | 37831.49 €
TOTAL
Ratios que se deducen
Mano de obra + margen de fábrica sobre materiales
Margen Tini sobre coste de fábrica (fabricación + nave)
Coste de nave y gestión equivalente por mes (fábrica entera) |  | 24.500 € = 1/5 × 5 meses → ≈ 24.500 €/mes por la fábrica entera
Precios de material a coste (proveedor)
Acero estructural (€/kg) | 0.80 €
Galvanizado (€/kg) | 0.45 €
Poliuretano (€/kg) | 0.12 €
Panel Tabihaus 8+20+8 (€/m²) | 40.00 €
Panel Tabihaus 8+50+8 (€/m²) | 42.00 €
Panel Tabihaus 8+65+8 (€/m²) | 52.00 €
Panel Tabihaus 8+120+8 (€/m²) | 64.00 €

Sheet: Implantación en obra
OBRA IN SITU: Menorca Pino rv02 (29/08/2024), precios de venta
Referencia para lo que NO es fábrica: cimentación, urbanización, acometidas. Total presupuesto: 89.194,46 € (541 €/m² sobre 165 m²).
Código | Descripción | Ud | Cantidad | Precio | Importe
ADL010_T_B | DESBROCE Y LIMPIEZA DEL TERRENO CON ARBUSTOS A MÁQUINA | m² | 645 | 6.59 €
CRL030 | HORMIGON DE LIMPIEZA | m² | 131.54 | 9.52 €
_ZPCO | ZAPATAS CORRIDAS o AISLADAS | m³ | 47.47 | 254.00 €
CEBH | MUROS DE CIMENTACION SOBRE ZAPATAS | m³ | 30.14 | 251.99 €
MPC030 | PAVIMENTO DE HORMIGON DESACTIVADO SOBRE LOSA | m² | 43.7 | 98.56 €
EAS005 | Placa de anclaje de acero UNE-EN 10025 S275JR en perfil plano, con rigidizadores y | Ud | 37 | 78.00 €
EAS005c | Placa de anclaje de acero UNE-EN 10025 S275JR en perfil plano, con rigidizadores y | Ud | 21 | 49.78 €
UVV020_T | DOBLE MALLAZO DE CORRUGADO PARA VALLADO DE PARCELA ENTRE PILARES | m² | 97.4 | 58.84 €
m21E15VAG060 | MALLA SIMPLE TORSIÓN GALVANIZADA 50/16 h=2,00 m. | m | 49.5 | 24.68 €
LGA020_T_E | PUERTA CORREDERA PARA GARAJE, CAPÓN DE ACERO 3mm MOTORIZADA | Ud | 1 | 5714.86 €
LGA010_E030 | PUERTA ENTRADA - CHAPÓN DE ACERO DE 3mm - CUBIERTO (5mm) Y CIERRE | Ud | 1 | 3369.24 €
5657AMTN_T | PUERTA ARMARIO CONTADOR | Ud | 1 | 410.00 €
05BUZNEXT_T | BUZÓN INDIVIDUAL EXTERIOR | Ud | 1 | 295.00 €
ECM010 | Muro de mampostería. PIEDRA MARES | m³ | 12.89 | 235.06 €
ASB010_T_ING | Acometida general de saneamiento, para la evacuación de aguas residuales y/o | m | 1 | 193.62 €
ASB020_T_ING | Conexión de la acometida del edificio a la red general de saneamiento del municipio | Ud | 1 | 249.52 €
ASC010_T_ING | Colector enterrado de red horizontal de saneamiento, con arquetas, con una | m | 47 | 39.70 €
ASA010_T_ING | Arqueta de obra de fábrica de 60x60 cm. | Ud | 7 | 272.86 €
UHP010_T_Agua | Hornacina prefabricada de hormigón. Agua | Ud | 1 | 220.71 €
UHP010_T_Tele | Hornacina prefabricada de hormigón. | Ud | 1 | 338.88 €
ASD015_T | ZANJA DRENAJE | m | 15.36 | 104.26 €
IFA010 | Acometida enterrada para abastecimiento de agua potable de 5,7 m de longitud, que | Ud | 1 | 378.63 €
IFB010 | Alimentación de agua potable, de 6,39 m de longitud, enterrada, formada por tubo de | Ud | 1 | 244.88 €
IFC010 | Preinstalación de contador general de agua 1 1/4" DN 32 mm, colocado en hornacina, | Ud | 1 | 154.15 €
IEP010 | Red de toma de tierra para estructura metálica del edificio compuesta por 37 m de | Ud | 1 | 602.40 €
ILA010 | Arqueta de entrada prefabricada para ICT de 400x400x600 mm de dimensiones | Ud | 1 | 343.61 €
ILA020 | Canalización externa, entre la arqueta de entrada y el registro de enlace inferior en el | m | 27.46 | 14.32 €
ILI001 | Registro de terminación de red, formado por caja de plástico para disposición del | Ud | 1 | 58.18 €
IAA100 | Cable coaxial clase A, de 75 ± 2 Ohm, reacción al fuego clase Dca-s2,d2,a2 según | m | 10 | 2.16 €
_INC_01 | PUNTOS DE LUZ EXTERIORES BAJO TUBO | ud | 14 | 6.52 €
mE17PM010AMB | ARMARIO PROT/MED/SECC. PARA EXTERIOR | ud | 1 | 509.57 €
mE20CIA050AMT | CONTADOR DE AGUA/RECORRIDO TUBERÍA | ud | 1 | 366.11 €
HYA010_ELE | Ayudas de albañilería para ejecución de instalaciones. | m² | 140 | 13.32 €
0.15.1AMB | LIMPIEZA FINAL | ud | 1 | 114.00 €
XEB010 | Ensayo de barras corrugadas de acero de un mismo lote. | Ud | 1 | 86.53 €
XEM010 | Ensayo de mallas electrosoldadas de un mismo lote. | Ud | 1 | 141.93 €
XEH010 | Ensayo de consistencia y resistencia del hormigón de un mismo lote. | Ud | 1 | 94.12 €
XMP010 | Ensayo destructivo de perfiles laminados. | Ud | 1 | 193.46 €
XMS020 | Ensayo no destructivo de soldaduras en estructuras metálicas. | Ud | 5 | 26.14 €
 | Suma de partidas identificadas
Totales por capítulo del original
 | Movimiento de tierras |  |  |  | 7291.29 €
 | Hormigón de limpieza |  |  |  | 1252.26 €
 | Zapatas |  |  |  | 14961.69 €
 | Muros de cimentación |  |  |  | 15854.11 €
 | Placas de anclaje |  |  |  | 3931.38 €
 | Cerramiento de parcela y puertas |  |  |  | 19771.70 €
 | Terrazas y muro de marés |  |  |  | 5347.50 €
 | Acometidas e instalaciones |  |  |  | 11408.52 €
 | Gestión de residuos y limpieza |  |  |  | 2922.20 €
 | Control de calidad |  |  |  | 646.74 €
 | Seguridad y salud |  |  |  | 1500.00 €
 | Pavimento de hormigón desactivado |  |  |  | 4307.07 €
 | TOTAL
 | Algunas partidas del PDF perdieron el código al extraerlas; los totales por capítulo sí están completos.

Sheet: Fábrica coste mensual
COSTE MENSUAL DE LA FÁBRICA (Seseña, 2024)
Fuente: resúmenes de nómina de DWHAI Human Knowledge (junio a noviembre de 2024) y analítica DWHAI. Importes agregados; sin datos individuales.
Mes | Nº operarios | Devengos (bruto) | S.S. empresa | Coste total | Coste por operario | de ello, dietas y km
Junio 2024 | 4 | 9249.99 € | 3220.16 € |  |  | 0 €
Julio 2024 | 6 | 12256.28 € | 4927.46 € |  |  | 0 €
Agosto 2024 | 8 | 16536.63 € | 5881.65 € |  |  | 2479.59 €
Septiembre 2024 | 9 | 19895.77 € | 7828.32 € |  |  | 1385.06 €
Octubre 2024 | 9 | 20652.79 € | 8172.39 € |  |  | 1403.22 €
Noviembre 2024 | 9 | 20094.9 € | 8095.56 € |  |  | 964.64 €
Media septiembre–noviembre (plantilla completa)
Nº de operarios por mes: contado desde la nómina. Solo operarios de fábrica, sin dirección ni oficina técnica.
ESTRUCTURA FIJA MENSUAL (plantilla completa)
Concepto | €/mes | Fuente
Mano de obra de fábrica (nómina + S.S.) |  | Media sep–nov 2024
Alquiler de nave (Prefabricados la Mancha) | 8500 € | Facturas mensuales, marzo–noviembre 2024
Suministros de nave (luz, gas, limpieza, alarma, teléfono…) | 1600 € | 12.806 € en 8 meses, redondeado
Oficina técnica / proyectos (Arquimedia) | 6100 € | Facturas de septiembre y octubre de 2024
Gestión (CH109) y asesoría | 3830 € | CH109 3.663 €/mes + asesoría 164 €/mes
Seguros y prevención | 400 € | Multirriesgo 3.545 € al año + prevención
COSTE FIJO DE FÁBRICA AL MES |  | En Mahón se repercutió nave + gestión como 24.500 €/mes (1/5 durante 5 meses). Aquí salen B17:B21.
RATIOS
Horas por operario al mes | 160 | Supuesto: 40 h × 4 semanas
% de horas productivas | 85% | Supuesto: descontadas vacaciones, bajas y tiempos muertos
Coste hora de operario (solo nómina)
Coste hora con toda la estructura de fábrica |  | Lo que hay que cobrar por hora de fábrica para cubrir costes, sin margen
m² de vivienda fabricados al mes |  | RELLENAR: capacidad real con la plantilla completa
Coste fijo de fábrica por m² fabricado |  | Se suma a materiales y subcontratas
Horas de fábrica por m²
Referencia de coste de mano de obra imputada en 2024: Menorca 115 €/m², Sotopinilla 98 €/m², Burdeos 173 €/m², Guadalajara 351 €/m². Además, 110.735 € de mano de obra quedaron en gastos generales sin repartir.

Sheet: Tiempos por oficio
TIEMPOS POR OFICIO EN UNA CASA (fabricación en cadena)
Cada oficio pasa de una casa a la siguiente. Lo que la fábrica produce al mes lo marca el oficio que más días pasa en cada casa (el cuello de botella).
Rellena las celdas AMARILLAS con los datos de una casa de referencia (p. ej. Menorca Pino, 165 m²). Se admiten días aproximados.
m² de la casa de referencia | 165 | Menorca Pino (medición de limpieza final)
Días laborables al mes | 21
Horas por jornada | 8
Coste hora de operario (nómina + S.S.)
Oficio | Nº personas | Días por casa | Horas por casa | Coste mano de obra | €/m² | Qué incluye
Soldadura (estructura y modelos) |  |  |  |  |  | Pilares, vigas, correas, refuerzos, pletinas
Montaje de panel Tabihaus |  |  |  |  |  | Fachada, cubierta y suelo
Cubierta: impermeabilización, canalón y albardilla
Pladur: tabiquería, trasdosados y techos
Electricidad |  |  |  |  |  | Cableado, mecanismos, iluminación
Fontanería y saneamiento |  |  |  |  |  | Baños, cocina, ACS
Carpintería: ventanas, puertas y armarios |  |  |  |  |  | Colocación
Pavimentos y alicatados |  |  |  |  |  | Tarima, cerámica, rodapiés
Pintura |  |  |  |  |  | Estructura vista, paramentos, techos
Acabado de fachada |  |  |  |  |  | Revestimientos y remates
Cocina, baños y remates finales |  |  |  |  |  | Montaje de muebles, sanitarios, limpieza
TOTAL CASA
Días del oficio cuello de botella |  | Cada cuántos días sale una casa con la cadena rodando
Plazo de una casa de principio a fin (días) |  | Si los oficios no se solapan dentro de la casa. En 2024, Menorca: 6–7 meses para las dos casas
Casas al mes con la cadena llena
m² al mes
Coste fijo de fábrica por casa |  | Nave, oficina técnica, gestión y plantilla completa, repartidos entre las casas del mes
Coste fijo de fábrica por m² |  | Se suma a materiales y subcontratas
Ejemplo de cómo rellenar (no es un dato real): «Soldadura | 3 personas | 15 días» → 360 h por casa.
Si la plantilla está sin ocupar mientras espera al cuello de botella, su coste ya va en el coste fijo por casa: la mano de obra por oficio sirve para ver dónde se va el tiempo, no se suma dos veces.

Sheet: Incidencias detectadas
Proyecto | Incidencia
Fenwick | El Excel del 25/11/2024 tiene el transporte como 3.050 u × 3.050 € = 9.302.500 €. En el banco se ha usado el PDF del 16/04/2024 (5.925 € de transporte y operarios).
Menorca Pino | La «toma general de tierras» está medida 310 veces en lugar de 1: 10.524 € en lugar de 34 €. Sigue igual en la versión del 30/10/2024.
Menorca Pino | A Tini se le certificaron 280.491,85 € (versión de mayo), pero el presupuesto de octubre baja a 272.060,55 €. Hay que confirmar qué versión se facturó al final.
Menorca Pino | En la versión de octubre, la aerotermia se vende a 2.038,50 € y Escotermia la presupuestó a 2.182,98 € de coste (11/04/2024): se vende por debajo del coste.
Menorca / Soto | La analítica a 29/11/2024 no recoge el coste de carpintería (Menorca: 0 €), cocina, baños, clima ni transporte. El margen aparente no es real.
Sotopinilla | Los capítulos FOT y AER tienen los nombres cruzados (FOT = aerotermia, AER = fotovoltaica).
El Boalo | Certificados a Tini 145.324 €, pero a 29/11/2024 solo hay imputados 11.688 € de estructura (Talleres Solman, 1,51 €/kg). No hay coste real todavía.
Guadalajara | Margen bruto negativo: coste directo 130.044 € frente a 109.499 € certificados.
Todos | El precio del acero (2,80 €/kg) no cambia de un proyecto a otro aunque el coste real osciló entre 2,9 y 5,3 €/kg.
