teyame109-dev/Modular-Home/costes/Nevola_presupuesto_tecnico_modular.xlsx

Sheet: Resumen
NÉVOLA: PRESUPUESTO TÉCNICO MODULAR SOBRE EL PROYECTO DE EJECUCIÓN
Base: BC3 «NEVOLA EJECUCIÓN_DEF julio 2026» (PEM 2.915.671,71 €, 16 viviendas). Importes por vivienda pareada (148,30 m²) y sin IVA.
Concepto | Por vivienda | €/m² construido | Serie de 16
PROYECTO TRADICIONAL (alcance vivienda: sin urbanización, cimentación, piscina ni acometidas)
PEM de lo que sustituye el sistema modular (estructura, cubierta, fachada, aislamientos)
PEM de lo que se ejecuta igual (instalaciones, carpinterías, acabados)
PEM alcance vivienda
Precio de contrata tradicional (PEM + GG + BI)
RG21 MODULAR (coste real)
Sistema modular (sustituye)
Partidas iguales a precio de proyecto, con ahorro de fábrica
Específicos modulares: transporte, grúa, montaje, ingeniería, fábrica
COSTE RG21
Margen RG21 (GG + beneficio)
PRECIO RG21
Diferencia del precio RG21 con la contrata tradicional
Diferencia en %
Precio de la oferta comercial de septiembre (pareada, serie)
Bajada sobre la oferta comercial
ESCENARIOS: PRECIO RG21 POR VIVIENDA
Cambia el acero por m² (filas) y el ahorro de fábrica en partidas iguales (columnas). Resto de supuestos como en la hoja Supuestos.
Acero (kg/m²) | Ahorro 0 % | Ahorro 8 % | Ahorro 12 %
90 kg/m²
75 kg/m²
65 kg/m²
55 kg/m²
45 kg/m²
Referencia: contrata tradicional del mismo alcance
LECTURA
1. La oferta comercial de septiembre salía cara porque sumaba márgenes: precios de venta de DWHAI a Tini de 2024, más IPC, más un 12 %. Aquí todo va a coste real y el margen se aplica una vez.
2. Las partidas que se hacen igual (carpinterías, instalaciones, acabados, sanitarios) se valoran con las mediciones y los precios del propio proyecto. Son precios de mercado de 2026 y el promotor los reconoce.
3. El acero va a 90 kg/m², el dato real de Mahón (dos plantas, 2024). Cada 10 kg/m² que el cálculo consiga bajar son unos 3.900 € menos por vivienda.
4. Queda fuera lo que el proyecto pone en urbanización, cimentación, movimiento de tierras, saneamiento enterrado, acometidas, piscina, seguridad y salud, control de calidad y residuos: 51.368 €/vivienda de PEM que el promotor sigue teniendo.
5. El modular ahorra al promotor la solera ventilada Cáviti, las ayudas de albañilería y buena parte del plazo de obra (costes financieros, seguridad y salud, gastos de obra). No está valorado aquí.

Sheet: Supuestos
SUPUESTOS DEL PRESUPUESTO TÉCNICO MODULAR (vivienda pareada tipo)
Amarillo = dato que se puede cambiar. Costes reales de fábrica, no precios de venta. El margen se aplica una sola vez, en el Resumen.
Concepto | Valor | Origen
Actualización de costes 2024→2026 | 12.0% | Costes de construcción +5,46 % en 2025 (ACR) y +3,5 % interanual en abril de 2026 (Banco de España)
Acero estructural por m² construido (kg/m²) | 90 | Dato real: Mahón (proyecto 182, dos plantas) 13.516 kg / 151,2 m² = 89 kg/m². Bajar exige rediseñar el módulo con cálculo
Coste del acero fabricado (€/kg): material, corte, soldadura, imprimación y pintura | 2.60 € | Material 0,80 €/kg en 2024 (Mahón) + soldadura propia. En 2024 el kg soldado costó 3,0–4,9 € subcontratado
Superficie construida de la vivienda pareada (m²) | 148.30 | Proyecto de ejecución, cuadro de superficies
Envolvente vertical opaca, fachadas + medianera (m²) | 166.54 | Proyecto: XPS 100 mm en fachadas 2.664,64 m² / 16 viviendas
Fachada con acabado exterior (m²) | 140.00 | Envolvente opaca sin medianera, con los petos
Medianera de la pareada (m²) | 26.94 | Proyecto, justificación del DB HE1
Cubierta (m²) | 74.70 | Proyecto: cubierta no transitable 1.195,45 m² / 16
Suelo de planta baja (m²) | 74.58 | Superficie construida de planta baja
Forjado entre plantas (m²) | 73.72 | Superficie construida de planta primera
Mano de obra de fábrica (€/h, nómina + S.S.) | 23.00 € | Nóminas DWHAI sep–nov 2024
Horas de montaje de panel por m² | 0.50 | Estimado: cuadrilla de 2 personas a 4 m²/h
Merma y cortes de panel | 5.0% | Estimado
Panel Tabihaus 8+50+8 (coste 2024, €/m²) | 42.00 € | Resumen Mahón 21/11/2024 (precio de material)
Panel Tabihaus 8+65+8 (coste 2024, €/m²) | 52.00 € | Resumen Mahón 21/11/2024
Panel Tabihaus 8+120+8 (coste 2024, €/m²) | 64.00 € | Resumen Mahón 21/11/2024
Trasdosado interior de fachada con aislamiento (€/m²) | 31.85 € | Precio del proyecto: Knauf W625 (partida 507)
Suplemento de aislamiento para llegar a U = 0,20 (€/m²) | 10.00 € | PET 40 mm o reflexivo. El proyecto exige U = 0,20 en fachada
Acabado exterior sobre panel (€/m²) | 45.00 € | ESTIMADO: placa de cemento + monocapa. El proyecto pone monocapa a 22,36 €/m² sobre ladrillo
Sistema de cubierta sobre panel: pendientes, impermeabilización y grava (€/m²) | 88.80 € | Precio del proyecto (partida D08PD002), sin su XPS
Escalera metálica con peldaños (coste €/ud) | 2500 € | Estimado. El proyecto pone losa + peldañeado: 822 €/vivienda
Juntas, sellados y remates entre módulos (€/vivienda) | 1500 € | Estimado
Colectores suspendidos bajo planta baja (€/vivienda) | 941.45 € | Partidas ISS010 del proyecto / 16: se mantienen
Módulos por vivienda | 6 | 3 por planta, de unos 2,67 × 9,40 m
Transporte por módulo (coste 2024, €) | 900 € | Sotopinilla 2024: 780 €/módulo
Grúa por vivienda (€) | 1750 € | Una grúa de 3.120 € por jornada montando 2 viviendas al día
Horas de montaje en parcela por vivienda | 144 | 3 operarios × 6 días
Dietas y desplazamiento sobre el montaje | 15.0% | Guadalix está a < 100 km de la fábrica
Ingeniería: cálculo modular y proyecto de fabricación (total) | 25000 € | Estimado, una vez para toda la serie
Viviendas de la serie | 16
Gastos fijos de fábrica sin mano de obra (€/mes) | 20430 € | Nave 8.500 + oficina técnica 6.100 + gestión 3.830 + suministros 1.600 + seguros 400
Viviendas fabricadas al mes con la cadena llena | 2.00 | Supuesto. Con 9 operarios: ≈ 520 h/vivienda de estructura y panel
Ahorro en fábrica sobre los precios del proyecto (partidas que se hacen igual) | 0.0% | Prudente: 0 %. En fábrica es razonable un 8–12 %, porque no hay ayudas, andamios ni esperas
Margen RG21: gastos generales + beneficio | 10.0% | Sobre el coste total
GG + BI de una contrata tradicional sobre PEM | 19.0% | 13 % de gastos generales + 6 % de beneficio industrial (habitual)

Sheet: Proyecto por alcance
PROYECTO DE EJECUCIÓN NÉVOLA (BC3 julio 2026): 309 PARTIDAS CLASIFICADAS POR ALCANCE
FUERA = lo ejecuta el promotor u otra contrata (urbanización, cimentación, piscina, acometidas). SUSTITUYE = lo cambia el sistema modular. IGUAL = se ejecuta igual en fábrica que en obra.
Alcance | Capítulo | Código | Descripción | Ud | Cantidad total | Cant./vivienda | Precio proyecto | Importe total | Importe/vivienda
SUSTITUYE | C.03 | ISS010cc | COLECTOR SUSPENDIDO PVC 52 mm | m | 27.20 |  | 17.53 €
SUSTITUYE | C.03 | ISS010c | COLECTOR SUSPENDIDO PVC 90 mm | m | 84.80 |  | 27.09 €
SUSTITUYE | C.03 | ISS010cb | COLECTOR SUSPENDIDO PVC 110 mm | m | 408.00 |  | 30.10 €
SUSTITUYE | C.04 | ANS030 | SOLERA VENTILADA C-50 "CÁVITI" 50+5 cm | m² | 1207.85 |  | 39.45 €
SUSTITUYE | C.04 | EHU030b | FORJADO UNIDIRECCIONAL 30 cm SEMIVIGUETA ARMADA/BOV HORMIGÓN/PILARES Y VIGAS 0,134 m³/m² | m² | 1285.15 |  | 83.78 €
SUSTITUYE | C.04 | EHU030 | FORJADO UNIDIRECCIONAL 30 cm SEMIVIGUETA ARMADA/BOV HORMIGÓN/PILARES Y VIGAS 0,147 m³/m² | m² | 1091.60 |  | 85.14 €
SUSTITUYE | C.04 | EHE010 | LOSA DE ESCALERA h=17 cm | m² | 112.00 |  | 69.16 €
SUSTITUYE | C.05 | D08PD002 | CUBIERTA PLANA NO TRANSITABLE/GRAVA | m² | 1195.45 |  | 88.80 €
SUSTITUYE | C.05 | QAB010b | CUBIERTA PLANA TRANSITABLE/SOLADO FIJO | m² | 143.10 |  | 97.54 €
SUSTITUYE | C.05 | QAB010bb | CUBIERTA PLANA TRANSITABLE/SOLADO FIJO | m² | 21.00 |  | 81.52 €
SUSTITUYE | C.06 | 504 | HOJA EXTERIOR DE FACHADA, 1/2 PIE, DE LADRILLO CERÁMICO PERFORADO TOSCO | m² | 3070.32 |  | 23.49 €
SUSTITUYE | C.06 | 504b | HOJA EXTERIOR DE FACHADA, 1 PIE, DE LADRILLO CERÁMICO PERFORADO TOSCO | m² | 306.38 |  | 34.06 €
SUSTITUYE | C.06 | 312 | DINTEL VIGUETA T-18 | m | 358.00 |  | 15.55 €
SUSTITUYE | C.06 | 505 | ENFOSCADO DE CEMENTO | m² | 3973.66 |  | 7.47 €
SUSTITUYE | C.06 | RQO020 | MORTERO MONOCAPA | m² | 3642.26 |  | 22.36 €
SUSTITUYE | C.06 | HYO020 | PELDAÑEADO ESCALERAS | m | 336.00 |  | 16.10 €
SUSTITUYE | C.06 | HEC030 | PREMARCOS CARPINTERÍA INTERIOR | Ud | 128.00 |  | 4.26 €
SUSTITUYE | C.06 | HEC010 | PREMARCOS CARPINTERÍA EXTERIOR | Ud | 181.00 |  | 13.61 €
SUSTITUYE | C.06 | 518 | FORRADO CHIMENEAS | Ud | 16.00 |  | 380.06 €
SUSTITUYE | C.06 | 519 | AYUDA ALBAÑILERÍA FONTANERÍA VIV.UNIFAMILIAR | Ud | 16.00 |  | 491.33 €
SUSTITUYE | C.06 | 520 | AYUDA ALBAÑILERÍA ELECTRICIDAD VIV.UNIFAMILIAR | Ud | 16.00 |  | 491.33 €
SUSTITUYE | C.06 | 521 | AYUDA ALBAÑILERÍA CALEFACCIÓN VIV.UNIFAMILIAR | Ud | 16.00 |  | 491.33 €
SUSTITUYE | C.07 | 2000b | IMPERMEABILIZACIÓN SUMIDEROS CUBIERTA NO TRANSITABLE | Ud | 33.00 |  | 37.44 €
SUSTITUYE | C.07 | QAF030 | IMPERMEABILIZACIÓN SUMIDEROS CUBIERTA TRANSITABLE | Ud | 32.00 |  | 34.83 €
SUSTITUYE | C.07 | QAF020 | ENCUENTRO PETO/CUBIERTA NO TRANSITABLE | m | 467.15 |  | 11.92 €
SUSTITUYE | C.07 | QAF020b | ENCUENTRO PETO/CUBIERTA TRANSITABLE | m | 226.95 |  | 11.92 €
SUSTITUYE | C.07 | D16ATA015 | AISL FRENTES FORJAD PINTURA TERMOAISLANTE TECNOL TQ-I-TERMIC | m² | 696.40 |  | 7.03 €
SUSTITUYE | C.07 | D16ATA025 | AISL. PILARES AISLAMIENTO REFLEX. AIR BUR TERMIC S ADHESIVO | m² | 684.00 |  | 8.60 €
SUSTITUYE | C.07 | NAD010 | AISLAMIENTO LANA MINERAL 100 mm BAJO FORJADO | m² | 156.00 |  | 12.22 €
SUSTITUYE | C.07 | 509b | AISLAMIENTO XPS 80 mm SUELO | m² | 1128.80 |  | 12.49 €
SUSTITUYE | C.07 | 510 | AISLAMIENTO XPS 100 mm FACHADAS | m² | 2664.64 |  | 14.80 €
SUSTITUYE | C.07 | 509 | AISLAMIENTO XPS 100 mm CUBIERTA | m² | 1211.55 |  | 14.80 €
SUSTITUYE | C.08 | 507 | TRASDOSADO AUTOPORT. KNAUF W625 (1x15,0+48) C/AISL | m² | 3106.87 |  | 31.85 €
IGUAL | C.03 | ISB010 | BAJANTE RESIDUALES. PVC 110 mm | m | 172.00 |  | 31.02 €
IGUAL | C.03 | ISB010b | BAJANTE PLUVIALES. PVC 90 mm | m | 163.20 |  | 23.47 €
IGUAL | C.07 | NIH010 | IMPERMEABILIZACIÓN LOCALES HÚMEDOS/HUECOS EXTERIORES | m² | 367.65 |  | 24.94 €
IGUAL | C.07 | D16DD153 | AISLAMIENTO ACÚSTICO PARA SUELO FLOTANTE PARQUET CHOVAIMPACT 3 S | m² | 1429.65 |  | 3.09 €
IGUAL | C.08 | FBY015 | TABIQUE MÚLTIPLE KNAUF W112 (2x12,5+48+2x12,5) C/AISL | m² | 2089.54 |  | 29.94 €
IGUAL | C.08 | FBY015b | TABIQUE MÚLTIPLE KNAUF W112 (2x12,5+70+2x12,5) C/AISL | m² | 359.20 |  | 31.34 €
IGUAL | C.08 | D14DAC005-2 | INCREMENTO PLACA ALTA RESISTENCIA MUEBLES DE COCINA/LAVABOS/ESCALERAS | m² | 202.55 |  | 8.20 €
IGUAL | C.08 | 511 | FALSO TECHO CONTINUO CUARTOS SECOS | m² | 1504.05 |  | 27.74 €
IGUAL | C.08 | 512 | FALSO TECHO CONTINUO CUARTOS HÚMEDOS | m² | 432.70 |  | 31.01 €
IGUAL | C.08 | RTC020b | TABICA VERTICAL FALSO TECHO CONTINUO | m | 116.50 |  | 20.41 €
IGUAL | C.08 | 513 | FALSO TECHO CONTINUO PLACAS DE CEMENTO | m² | 156.00 |  | 101.73 €
IGUAL | C.08 | FUF010 | MAMPARA DUCHA | m² | 34.56 |  | 77.61 €
IGUAL | C.09 | RAG012 | ALICATADO GRES PORCELÁNICO (20 /m²) | m² | 1416.19 |  | 26.61 €
IGUAL | C.09 | D19RA002 | PAVIMENTO LAMINADO TERHÜRNE 8,5 mm | m² | 1429.65 |  | 36.32 €
IGUAL | C.09 | FDD150 | TAPETA MADERA EN ESCALERA | m | 26.40 |  | 47.92 €
IGUAL | C.09 | FDD140 | PASAMANOS ALUMINIO | m | 60.80 |  | 31.88 €
IGUAL | C.09 | D19DD003D | SOLADO DE GRES PORCELÁNICO (20 /m²) INTERIOR C2 | m² | 432.70 |  | 35.97 €
IGUAL | C.09 | D19DD004 | SOLADO DE GRES PORCELÁNICO (20 /m²) EXTERIOR C3 | m² | 144.00 |  | 42.95 €
IGUAL | C.09 | D19DD505 | PELDAÑO DE GRES PORCELÁNICO (20 /m²) ESCALERA INTERIOR C2 | m | 336.00 |  | 28.08 €
IGUAL | C.09 | HRC030 | VIERTEAGUAS GRES PORCELÁNICO | m | 120.00 |  | 31.86 €
IGUAL | C.09 | HRL010 | ALBARDILLA ALUMINIO | m | 467.15 |  | 22.99 €
IGUAL | C.09 | RCG010 | APLACADO GRES EXTERIOR EN FACHADA | m² | 497.68 |  | 48.34 €
IGUAL | C.10 | LPM010 | PUERTA INTERIOR ABATIBLE MDF | Ud | 112.00 |  | 221.56 €
IGUAL | C.10 | LAF010 | ARMARIO MODULAR PUERTAS ABATIBLES | m² | 47.40 |  | 143.10 €
IGUAL | C.10 | LAF010b | ARMARIO MODULAR/SIN PUERTAS | m² | 188.28 |  | 105.80 €
IGUAL | C.10 | RSL020b | RODAPIÉ MDF | m | 1621.25 |  | 6.95 €
IGUAL | C.11 | 0804 | PUERTA ENTRADA ALUMINIO/BLOCK DE SEGURIDAD | Ud | 16.00 |  | 1140.81 €
IGUAL | C.11 | LCV015 | PE1/FIJO (sin persiana) | Ud | 16.00 |  | 240.87 €
IGUAL | C.11 | LCV015j | PE2/PUERTA 1 HOJA + FIJO LATERAL (con persiana) | Ud | 16.00 |  | 1335.55 €
IGUAL | C.11 | LCV015i | PE3/PUERTA 1 HOJA + FIJO LATERAL (con persiana) | Ud | 16.00 |  | 1266.90 €
IGUAL | C.11 | LCV015h | PE4/PUERTA 1 HOJA + FIJO LATERAL (con persiana) | Ud | 16.00 |  | 1300.09 €
IGUAL | C.11 | LCV015b | V1/VENTANA 1 HOJA (sin persiana) | Ud | 16.00 |  | 315.83 €
IGUAL | C.11 | LCV015f | V2/VENTANA 1 HOJA + FIJO INFERIOR (con persiana) | Ud | 16.00 |  | 597.76 €
IGUAL | C.11 | LCV015g | V3-V4/VENTANA 2 HOJAS + FIJO INFERIOR (con persiana) | Ud | 48.00 |  | 737.34 €
IGUAL | C.11 | LCV015c | V5-V6 VENTANA 1 HOJA + FIJO INFERIOR (sin persiana) | Ud | 32.00 |  | 323.91 €
IGUAL | C.11 | LCV015e | V7/VENTANA 1 HOJA (con persiana) | Ud | 2.00 |  | 351.65 €
IGUAL | C.11 | LCV015d | F1/FIJO (con persiana) | Ud | 2.00 |  | 408.37 €
IGUAL | C.11 | HRL040 | RECERCADO ALUMINIO | m | 926.40 |  | 29.03 €
IGUAL | C.11 | FDY010 | BARANDILLA MODULAR VIDRIO | m | 113.85 |  | 197.86 €
IGUAL | C.11 | 0816 | CAPERUZA METÁLICA CHIMENEA 80X60 cm | Ud | 16.00 |  | 135.82 €
IGUAL | C.12 | 0901 | PINTURA PLÁSTICA MATE BLANCA VERTICAL | m² | 4697.94 |  | 8.11 €
IGUAL | C.12 | 0902 | PINTURA PLÁSTICA MATE BLANCA HORIZONTAL | m² | 2092.75 |  | 10.45 €
IGUAL | C.13 | 1001 | TRAMITACIÓN DOCUMENTACIÓN/BOLETÍN | Ud | 34.00 |  | 101.61 €
IGUAL | C.13 | E17CB04122 | CUADRO GENERAL MANDO Y PROTEC. VIVIENDA ELECTR. ELEVADA 12 C | Ud | 16.00 |  | 1170.53 €
IGUAL | C.13 | IEI015b | RED ELÉCTRICA DE DISTRIBUCIÓN INTERIOR DE VIVIENDA UNIFAMILIAR 12 CIRCUITOS | Ud | 16.00 |  | 2937.18 €
IGUAL | C.13 | 1017 | RED DE EQUIPOTENCIALIDAD EN CUARTO HÚMEDO | Ud | 48.00 |  | 38.34 €
IGUAL | C.13 | 1018 | TOMA DE TIERRA INDEPENDIENTE CON PICA | Ud | 17.00 |  | 118.37 €
IGUAL | C.13 | 1019 | RED TOMA DE TIERRA ESTRUCTURA | m | 650.35 |  | 50.71 €
IGUAL | C.13 | diE17V040 | SOLDADURA ALUMINOTÉRMICA CABLE/CABLE | Ud | 150.00 |  | 23.94 €
IGUAL | C.13 | E17MN010 | PUNTO LUZ SENCILLO UNIPOLAR BLANCO | Ud | 192.00 |  | 18.32 €
IGUAL | C.13 | E17MN050 | PUNTO LUZ DOBLE INTERRUPTOR BLANCO | Ud | 33.00 |  | 38.18 €
IGUAL | C.13 | E17MJB020 | PUNTO DE LUZ SENCILLO CONMUTADO BLANCO | Ud | 224.00 |  | 34.89 €
IGUAL | C.13 | E17MN040 | PUNTO LUZ CRUZAMIENTO BLANCO | Ud | 32.00 |  | 50.17 €
IGUAL | C.13 | IIC020 | DETECTOR DE MOVIMIENTO | Ud | 16.00 |  | 38.28 €
IGUAL | C.13 | 1025 | BASE DE ENCHUFE T.T. BLANCO | Ud | 336.00 |  | 20.93 €
IGUAL | C.13 | 1026 | BASE DOBLE ENCHUFE T.T. BLANCO | Ud | 112.00 |  | 26.91 €
IGUAL | C.13 | 1027 | BASE ENCHUFE 25A (II+T.T) COCINA BLANCO | Ud | 64.00 |  | 37.39 €
IGUAL | C.13 | E17MN190 | BASE SEGURIDAD 20A | Ud | 80.00 |  | 26.49 €
IGUAL | C.13 | 1028 | BASE ENCHUFE 10-16 A ESTANCO IP44 | Ud | 33.00 |  | 24.13 €
IGUAL | C.13 | E19PV015 | VIDEOPORTERO DIGITAL VIVIENDA UNIFAMILIAR | Ud | 16.00 |  | 729.60 €
IGUAL | C.13 | IEB010 | PUNTO RECARGA VEHÍCULOS | Ud | 16.00 |  | 1242.13 €
IGUAL | C.13 | E19TCT010 | EQUIPO CAPTACIÓN RTV C/ MÁSTIL h=3 m | Ud | 16.00 |  | 268.51 €
IGUAL | C.13 | ILE031 | REGISTRO DE ENLACE SUPERIOR | Ud | 16.00 |  | 108.96 €
IGUAL | C.13 | ILE030 | CANALIZACIÓN DE ENLACE SUPERIOR | m | 144.80 |  | 12.11 €
IGUAL | C.13 | ILI001 | REGISTRO DE TERMINACIÓN DE RED | Ud | 16.00 |  | 43.78 €
IGUAL | C.13 | ILI010 | CANALIZACIÓN INTERIOR DE USUARIO | m | 2884.48 |  | 1.44 €
IGUAL | C.13 | ILI020 | REGISTRO DE TOMA | Ud | 272.00 |  | 5.90 €
IGUAL | C.13 | IAA040 | EQUIPO DE CABECERA | Ud | 16.00 |  | 340.87 €
IGUAL | C.13 | IAA100 | CABLE COAXIAL RG-6, 75 Ohm CLASE ECA | m | 1584.16 |  | 1.18 €
IGUAL | C.13 | IAA100b | CABLE COAXIAL RG-6, 75 Ohm CLASE FCA | m | 434.56 |  | 1.31 €
IGUAL | C.13 | IAA115 | REPARTIDOR DE 5-1000 MHZ DE 8 SALIDAS | Ud | 16.00 |  | 21.30 €
IGUAL | C.13 | IAA115b | REPARTIDOR DE 5-2400 MHZ DE 5 SALIDAS | Ud | 16.00 |  | 9.63 €
IGUAL | C.13 | E17MN100 | TOMA TELÉFONO BLANCO | Ud | 80.00 |  | 28.95 €
IGUAL | C.13 | E17MN110 | TOMA R-TV+SAT ÚNICA BLANCO | Ud | 80.00 |  | 53.62 €
IGUAL | C.13 | E17MN150 | ADAPTADOR RJ-45 AMP CATEGORÍA 6 BLANCO | Ud | 80.00 |  | 56.18 €
IGUAL | C.13 | IAF070 | CABLE DE PARES DE COBRE | m | 2237.44 |  | 1.82 €
IGUAL | C.13 | IAF075 | ROSETA DE TERMINACIÓN DE RED DE DISPERSIÓN | Ud | 16.00 |  | 12.59 €
IGUAL | C.13 | IAF085 | MULTIPLEXOR | Ud | 16.00 |  | 26.94 €
IGUAL | C.13 | IAO020 | CABLE DE FIBRA ÓPTICA | m | 182.08 |  | 2.42 €
IGUAL | C.13 | IAO035 | ROSETA DE FIBRA ÓPTICA | Ud | 16.00 |  | 25.88 €
IGUAL | C.13 | IAO040 | TOMA DE FIBRA ÓPTICA | Ud | 16.00 |  | 17.20 €
IGUAL | C.14 | 0324FO0901 | DOCUMENTACIÓN Y LEGALIZACIÓN | Ud | 17.00 |  | 274.51 €
IGUAL | C.14 | 0324FO0902 | PRUEBAS DE LA INSTALACIÓN | Ud | 17.00 |  | 143.38 €
IGUAL | C.14 | IFI005 | TUBERIA PEXALPEX 32 mm | m | 255.05 |  | 6.15 €
IGUAL | C.14 | IFI005c | TUBERIA PEXALPEX 25 mm | m | 100.00 |  | 6.68 €
IGUAL | C.14 | IFI005b | TUBERIA PEXALPEX 20 mm | m | 2880.14 |  | 4.79 €
IGUAL | C.14 | IFW010 | VÁLVULA DE CORTE | Ud | 18.00 |  | 19.14 €
IGUAL | C.14 | IFI008 | LLAVE DE PASO | Ud | 210.00 |  | 13.42 €
IGUAL | C.14 | NAA010b | COQUILLA ESPUMA ELASTOMÉRICA 23,0 mm/10 mm | m | 386.08 |  | 8.04 €
IGUAL | C.14 | NAA010c | COQUILLA ESPUMA ELASTOMÉRICA 19,0 mm/25 mm | m | 87.36 |  | 18.62 €
IGUAL | C.14 | NAA010d | COQUILLA ESPUMA ELASTOMÉRICA 23,0 mm/25,0 mm | m | 773.60 |  | 20.37 €
IGUAL | C.14 | NAA010e | COQUILLA ESPUMA ELASTOMÉRICA 26,0 mm/25 mm | m | 22.56 |  | 21.66 €
IGUAL | C.14 | 01113 | SIFÓN INDIVIDUAL | Ud | 64.00 |  | 8.26 €
IGUAL | C.14 | 01117 | BOTE SIFÓNICO PVC D=110 mm EMPOTRADO | Ud | 48.00 |  | 18.55 €
IGUAL | C.14 | 01114 | TUBERÍA PVC SERIE B JUNTA PEGADA D=32 mm | m | 280.00 |  | 5.25 €
IGUAL | C.14 | 01115 | TUBERÍA PVC SERIE B JUNTA PEGADA D=40 mm | m | 440.00 |  | 6.65 €
IGUAL | C.14 | ISB041 | TUBERÍA PVC SERIE B JUNTA PEGADA D=75 mm | m | 230.40 |  | 3.01 €
IGUAL | C.14 | 01116 | TUBERÍA PVC SERIE B JUNTA PEGADA D=110 mm | m | 72.00 |  | 15.13 €
IGUAL | C.14 | ISB044 | TERMINAL DE AIREACIÓN | Ud | 48.00 |  | 11.21 €
IGUAL | C.14 | SAC020b | INODORO DE PORCELANA SANITARIA | Ud | 48.00 |  | 208.67 €
IGUAL | C.14 | SAC020 | LAVABO DE PORCELANA SANITARIA | Ud | 16.00 |  | 229.58 €
IGUAL | C.14 | SAC020c | BAÑERA DE ACERO 140X75 cm | Ud | 16.00 |  | 430.93 €
IGUAL | C.14 | 01120cb | PLATO DE DUCHA DE RESINA 160x75x40 | Ud | 16.00 |  | 523.15 €
IGUAL | C.14 | 01120c | PLATO DE DUCHA DE RESINA 180x75x40 | Ud | 16.00 |  | 556.72 €
IGUAL | C.15 | ICE110 | SUELO RADIANTE-REFRESCANTE | m² | 2000.00 |  | 35.86 €
IGUAL | C.15 | SU100.015 | TIRA PERIMETRAL | m | 2400.00 |  | 0.58 €
IGUAL | C.15 | SU100.100 | HOJA DE PE | m² | 2400.00 |  | 0.76 €
IGUAL | C.15 | SU100.030 | GUÍA PARA JUNTAS DE DILATACIÓN | Ud | 160.00 |  | 3.64 €
IGUAL | C.15 | SU100.010 | ADITIVO ESTROLITH H.2000 | kg | 500.00 |  | 3.83 €
IGUAL | C.15 | ICV01588 | BIBLOCK VAILLANT 10KW | Ud | 16.00 |  | 8376.48 €
IGUAL | C.15 | SU100.505 | VÁLVULA PARA DISTRIBUIDOR CONEXIÓN DIRECTA | Ud | 32.00 |  | 12.70 €
IGUAL | C.15 | SU100.110 | VÁLVULA DE PRESION DIFERENCIAL TERMINAL | Ud | 32.00 |  | 74.78 €
IGUAL | C.15 | 004.003.001b4 | SU101.428 - DISTRIBUIDOR HKV 15-16 ESTRATO | Ud | 32.00 |  | 222.29 €
IGUAL | C.15 | SU100.012 | CODOS GUÍA Ø15-16 | Ud | 320.00 |  | 0.76 €
IGUAL | C.15 | SU100.9205 | ARMARIO ACT 925 PARA DISTRIBUIDOR DE 7 a 11 CIRCUITOS | Ud | 32.00 |  | 199.30 €
IGUAL | C.15 | SU100.740 | TERMOSTATO ELECTRÓNICO FRÍO/CALOR (3 HILOS) | Ud | 80.00 |  | 27.66 €
IGUAL | C.15 | SU100.513 | ACCIONAMIENTO ELECTRICO | Ud | 32.00 |  | 21.50 €
IGUAL | C.15 | SU102.009 | PLACA ELECTRÓNICA 6 ZONAS 230V | Ud | 32.00 |  | 76.31 €
IGUAL | C.15 | ICS010c | TUBERIA 25 mm | m | 224.00 |  | 13.73 €
IGUAL | C.15 | ICN010 | LINEA FRIGORIFICA 5/8" - 3/8" | m | 192.00 |  | 31.39 €
IGUAL | C.15 | ICS005 | PUNTO DE LLENADO | Ud | 16.00 |  | 75.91 €
IGUAL | C.15 | ICS015 | PUNTO DE VACIADO | Ud | 16.00 |  | 21.40 €
IGUAL | C.15 | ICS080 | PURGADOR | Ud | 16.00 |  | 9.05 €
IGUAL | C.15 | ICS016gR | BOMBA CIRCULADORA, HASTA 25kPa y 2m3/h | Ud | 16.00 |  | 595.34 €
IGUAL | C.15 | 01.05.01 | PUESTA EN MARCHA CLIMATIZACIÓN | Ud | 16.00 |  | 263.23 €
IGUAL | C.15 | 11.02.18 | LEGALIZACIÓN DE LA INSTALACIÓN TÉRMICA | Ud | 16.00 |  | 402.36 €
IGUAL | C.15 | E23MGU0105 | GRUPO VMC UNIFAMILIAR AUTORREGULABLE 6 BOCAS (125+4x80 mm) | Ud | 16.00 |  | 360.24 €
IGUAL | C.15 | IVK010 | CAMPANA EXTRACTORA | Ud | 16.00 |  | 75.96 €
IGUAL | C.15 | E23DCG030 | TUBO HELIC. CHAPA ACERO GALVANIZADA D=125 mm | m | 552.00 |  | 15.80 €
IGUAL | C.15 | E23DCR0101 | TUBO RECTANGULAR PVC EXTRACCIÓN/VENTILACIÓN 110x55 mm | m | 208.00 |  | 14.31 €
IGUAL | C.15 | E23DCR0102 | TUBO RECTANGULAR PVC EXTRACCIÓN/VENTILACIÓN 220x55 mm | m | 336.00 |  | 21.22 €
IGUAL | C.15 | E23NHR0108 | REJILLA EXTRACCIÓN 15-75 m³/h | Ud | 80.00 |  | 68.27 €
IGUAL | C.15 | E23Z010 | AIREADOR PUERTA PASO MADERA PREMARCO 80-100 mm | Ud | 80.00 |  | 5.47 €
IGUAL | C.15 | 0324VV0601 | CERTIFICACIÓN EJECUCIÓN Y PUESTA EN MARCHA | Ud | 16.00 |  | 214.34 €
IGUAL | C.19 | XRQ010 | PRUEBA ESTANQUEIDAD CUBIERTA | Ud | 9.00 |  | 344.17 €
IGUAL | C.19 | 1604 | PRUEBA SERVICIO INST. FONTANERÍA VIV. UNIF. | Ud | 16.00 |  | 169.68 €
IGUAL | C.19 | 1606 | PRUEBA SERVICIO INST. ELÉCTRICA VIV. UNIF. | Ud | 16.00 |  | 169.52 €
FUERA | C.01 | D01QG110 | DESMONTAJE Y RETIRADA CARTEL PUB. INC CARGA/TRANSP | m² | 20.00 |  | 53.41 €
FUERA | C.01 | D36BA005 | RETIRADA ARBOL INC DESTOCONADO / TROCEADO / CARGA / TRANS | Ud | 4.00 |  | 177.30 €
FUERA | C.01 | DEF040 | DEMOLICIÓN MOCHETAS INSTALACIONES | m³ | 12.43 |  | 40.32 €
FUERA | C.01 | DMX050 | DEMOLICIÓN ACERADO | m² | 447.95 |  | 7.75 €
FUERA | C.01 | 101 | DESBROCE Y LIMPIEZA DEL TERRENO | m² | 7328.36 |  | 2.77 €
FUERA | C.02 | ADE005 | EXCAVACIÓN SÓTANOS | m³ | 140.00 |  | 2.36 €
FUERA | C.02 | ADE010 | EXCAVACIÓN POZOS DE CIMENTACIÓN | m³ | 265.92 |  | 11.10 €
FUERA | C.02 | ADE010b | EXCAVACIÓN ZANJAS CIMENTACIÓN | m³ | 194.30 |  | 9.56 €
FUERA | C.02 | ADE010c | EXCAVACIÓN ZANJAS INSTALACIONES | m³ | 233.00 |  | 12.01 €
FUERA | C.02 | ADR030 | RELLENO Y COMPACTACIÓN | m³ | 7681.48 |  | 8.69 €
FUERA | C.03 | UAP011 | ARQUETA DE ARRANQUE | Ud | 33.00 |  | 699.92 €
FUERA | C.03 | ASB020 | CONEXIÓN ACOMETIDA | Ud | 33.00 |  | 148.82 €
FUERA | C.03 | ASB010b | ACOMETIDA DE SANEAMIENTO (ALBAÑAL) | m | 181.15 |  | 82.99 €
FUERA | C.03 | 0324SH0502 | VÁLVULA ANTIRRETORNO ACOMETIDA | Ud | 33.00 |  | 122.38 €
FUERA | C.03 | 203b | ARQUETA DE PASO 50x50x60 | Ud | 68.00 |  | 124.39 €
FUERA | C.03 | 208 | COLECTOR ENTERRADO PVC 110 mm | m | 124.00 |  | 11.81 €
FUERA | C.03 | 209 | COLECTOR ENTERRADO PVC 125 mm | m | 221.30 |  | 13.41 €
FUERA | C.03 | 210 | COLECTOR ENTERRADO PVC 160 mm | m | 255.10 |  | 17.16 €
FUERA | C.03 | 0324SH0204 | CANALETA SUMIDERO PREFABRICADA 25 cm. URBANIZACIÓN | m | 15.00 |  | 30.24 €
FUERA | C.03 | 212 | SUMIDERO SIFÓNICO | Ud | 82.00 |  | 21.78 €
FUERA | C.03 | HRP060 | REBOSADEROS | Ud | 18.00 |  | 10.02 €
FUERA | C.03 | ISD009 | SUMIDERO SIFÓNICO DUCHA | Ud | 1.00 |  | 10.41 €
FUERA | C.03 | IVN110 | REJILLA VENTILACIÓN | Ud | 53.00 |  | 17.83 €
FUERA | C.04 | CMP010 | POZO DE CIMENTACIÓN (RELLENO A FIRME) | m³ | 194.83 |  | 70.73 €
FUERA | C.04 | 301 | HORMIGÓN DE LIMPIEZA h=10 cm | m² | 1841.22 |  | 7.31 €
FUERA | C.04 | CSZ020 | ENCOFRADO CIMENTACIÓN | m² | 771.00 |  | 13.83 €
FUERA | C.04 | CSZ030 | ZAPATA HORMIGÓN ARMADO HA-25/F/20/XC2 | m³ | 110.07 |  | 142.04 €
FUERA | C.04 | CAV030 | VIGA DE ATADO HA-25/F/20/XC2 | m³ | 54.76 |  | 178.34 €
FUERA | C.04 | CAV030b | ZUNCHO HA-25/F/20/XC2/VALLADOS | m³ | 139.54 |  | 178.34 €
FUERA | C.04 | CSL010 | LOSA CIMENTACIÓN C. TÉCNICO PISCINAS | m³ | 21.00 |  | 131.67 €
FUERA | C.04 | EHL010 | LOSA h= 20 cm CASETA APEROS/C TÉCNICO PISCINAS | m² | 34.45 |  | 136.99 €
FUERA | C.04 | CCS030b | MURO SÓTANO HORMIGÓN ARMADO/2C 25cm HA-25/F/20/XC2 | m³ | 12.95 |  | 334.80 €
FUERA | C.04 | D04PS155 | SOLERA HA-25 2#200x200x5 20 cm+ENCACHADO+PVC | m² | 559.45 |  | 26.81 €
FUERA | C.07 | NHB020 | BARRERA ANTICAPILARIDAD | m | 525.50 |  | 9.92 €
FUERA | C.07 | 403 | IMP.MUROS LÁM.ASFÁLT.+LAM.DREN. | m² | 64.40 |  | 14.90 €
FUERA | C.07 | D17AA524 | AISLAM. LAMINA ANTIRADON POLYDAN RADON 180-40P ELAST | m² | 1128.80 |  | 12.25 €
FUERA | C.09 | UXC020 | HORMIGÓN PULIDO | m² | 16.00 |  | 19.40 €
FUERA | C.09 | 0604 | HORMIGÓN IMPRESO-SOLERA HA-25 #150x150x5 15 cm+ENCACHADO+PVC | m² | 1777.60 |  | 34.50 €
FUERA | C.09 | D19DD004 | SOLADO DE GRES PORCELÁNICO (20 /m²) EXTERIOR C3 | m² | 605.65 |  | 42.95 €
FUERA | C.11 | 404 | PLACA DE ANCLAJE 200x200x15 mm | Ud | 180.00 |  | 22.46 €
FUERA | C.11 | 2001 | ACERO LAMINADO S275JR ESTRUCTURA | kg | 12481.02 |  | 4.41 €
FUERA | C.11 | LEL010 | PUERTA APEROS | Ud | 1.00 |  | 413.91 €
FUERA | C.11 | SEE010 | ESCALERA ESCAMOTEABLE DE ACERO | Ud | 1.00 |  | 436.14 €
FUERA | C.11 | RTC021 | TRAMPILLA METÁLICA | Ud | 1.00 |  | 105.83 €
FUERA | C.11 | LFA010 | PUERTA RF CUARTO PRODUCTOS QUÍMICOS | Ud | 1.00 |  | 740.47 €
FUERA | C.13 | E17BCD010 | MÓDULO CONTADOR | Ud | 17.00 |  | 174.34 €
FUERA | C.13 | E17AB030 | ACOMETIDA MONOFÁSICA 2(1x16) mm2 Cu | m | 139.00 |  | 23.07 €
FUERA | C.13 | E17AB040 | ACOMETIDA MONOFÁSICA 4(1x25) mm2 Cu | m | 45.00 |  | 44.31 €
FUERA | C.13 | E17BB020 | LÍNEA GENERAL ALIMENTACIÓN 2(1x16) mm2 Cu | m | 160.00 |  | 18.13 €
FUERA | C.13 | E17BD030 | DERIVACIÓN INDIVIDUAL MONOFÁSICA 3x16 mm2 | m | 160.00 |  | 12.71 €
FUERA | C.13 | E17BD070 | DERIVACIÓN INDIVIDUAL TRIFÁSICA 5x16 mm2 | m | 40.00 |  | 18.11 €
FUERA | C.13 | E17BD020 | DERIVACIÓN INDIVIDUAL MONOFÁSICA 3x10 mm2 | m | 45.00 |  | 9.83 €
FUERA | C.13 | E17CB0601925 | CUADRO GENERAL DE MANDO Y PROTECCIÓN PISCINA | Ud | 1.00 |  | 454.37 €
FUERA | C.13 | E17CB0601919 | CUADRO GENERAL DE MANDO Y PROTECCIÓN SERVICIOS COMUNES | Ud | 1.00 |  | 826.57 €
FUERA | C.13 | E17CM040 | CIRCUITO MONOFÁSICO 3x4 mm2 (AS) | m | 420.00 |  | 5.74 €
FUERA | C.13 | E17CM010 | CIRCUITO MONOFASICO 3x2,5 mm2 | m | 20.00 |  | 5.71 €
FUERA | C.13 | E17CDP035 | CANALIZACIÓN TUBO RÍGIDO M32/gp7 | m | 420.00 |  | 4.92 €
FUERA | C.13 | ILA010 | ARQUETA DE ENTRADA | Ud | 16.00 |  | 207.60 €
FUERA | C.13 | ILE021 | REGISTRO DE ENLACE INFERIOR | Ud | 16.00 |  | 136.77 €
FUERA | C.13 | ILA020 | CANALIZACIÓN EXTERNA ENTERRADA | m | 94.40 |  | 9.30 €
FUERA | C.13 | ILE010 | CANALIZACIÓN DE ENLACE INFERIOR | m | 6.40 |  | 10.01 €
FUERA | C.14 | IFA010 | ACOMETIDA DE ABASTECIMIENTO AGUA POTABLE | Ud | 17.00 |  | 358.21 €
FUERA | C.14 | IFB010 | ALIMENTACIÓN AGUA POTABLE | Ud | 17.00 |  | 319.66 €
FUERA | C.14 | IFC010 | PREINSTALACIÓN DE CONTADOR | Ud | 17.00 |  | 98.79 €
FUERA | C.14 | IFC090 | CONTADOR DE AGUA FRÍA DE LECTURA DIRECTA | Ud | 17.00 |  | 62.51 €
FUERA | C.14 | IFB020 | ARQUETA DE PASO, 64x48 cm | Ud | 35.00 |  | 39.03 €
FUERA | C.14 | 0324FO0601 | PROGRAMADOR ELECTRÓNICO | Ud | 1.00 |  | 352.92 €
FUERA | C.14 | URE010b | BOCA DE RIEGO | Ud | 36.00 |  | 87.17 €
FUERA | C.14 | 0324FO0602 | ELECTROVÁLVULA | Ud | 4.00 |  | 1011.61 €
FUERA | C.14 | 0324FO0603 | ASPERSOR ELEVACIÓN | Ud | 42.00 |  | 26.40 €
FUERA | C.14 | 0324FO0604 | TUBERÍA PEBD DIÁMETRO 32 mm | m | 275.00 |  | 14.42 €
FUERA | C.14 | 0324FO0606 | LÍNEA ELÉCTRICA | m | 110.00 |  | 14.13 €
FUERA | C.14 | 0324FO0608 | VÁLVULA ESFERA LATÓN 1" | Ud | 1.00 |  | 12.13 €
FUERA | C.14 | 0324FO0609 | VÁLVULA ESFERA LATÓN 3/4" | Ud | 3.00 |  | 11.54 €
FUERA | C.14 | 0324FO0610 | VÁLVULA REDUCTORA LATÓN 1" | Ud | 3.00 |  | 12.12 €
FUERA | C.14 | 0324FO0611 | FILTRO DE MALLA 1" | Ud | 3.00 |  | 15.08 €
FUERA | C.16 | D07AG015 | MURO BLOQUE HORMIGÓN ARMADO 40x20x20 | m² | 83.00 |  | 40.05 €
FUERA | C.16 | 01302 | ENCACHADO | m² | 95.25 |  | 4.43 €
FUERA | C.16 | 01303 | HORMIGÓN GUNITADO HORIZONTAL | m² | 95.25 |  | 34.92 €
FUERA | C.16 | 01304 | HORMIGÓN GUNITADO VERTICAL | m² | 59.00 |  | 31.52 €
FUERA | C.16 | 01305 | RELLENO BASE ESCALERA RECRECIDOS | m³ | 1.45 |  | 67.44 €
FUERA | C.16 | 01306 | PELDAÑEADO DE ESCALERA | m | 9.00 |  | 22.49 €
FUERA | C.16 | UPN010 | IMPERMEABILIZACIÓN PISCINA | m² | 154.25 |  | 10.56 €
FUERA | C.16 | D19DD004 | SOLADO DE GRES PORCELÁNICO (20 /m²) EXTERIOR C3 | m² | 154.25 |  | 42.95 €
FUERA | C.16 | D37RA501 | MÉNSULA HORMIGÓN BORDE PISCINA | m | 40.00 |  | 39.92 €
FUERA | C.16 | D37RB230 | CABLEADO COBRE 1x35 mm² | Ud | 100.00 |  | 5.91 €
FUERA | C.16 | UPD010 | EQUIPO COMPLETO DEPURACIÓN PISCINA 12x6x1,5 m (volumen 108 m³). | Ud | 1.00 |  | 3535.30 €
FUERA | C.16 | UPD010b | EQUIPO COMPLETO DEPURACIÓN PISCINA 8x4x1,5 m (volumen 48 m³). | Ud | 1.00 |  | 2589.16 €
FUERA | C.16 | UPC010 | EQUIPO AUTOMÁTICO DE CLORACIÓN SALINA | Ud | 2.00 |  | 1529.79 €
FUERA | C.16 | D37RZ005 | ESCALERA 4 PELDAÑOS ACERO INOXIDABLE | Ud | 3.00 |  | 231.10 €
FUERA | C.16 | D37RZ905 | BOTIQUÍN | Ud | 1.00 |  | 157.19 €
FUERA | C.16 | D37RZ802 | ARO SALVAVIDAS | Ud | 4.00 |  | 154.47 €
FUERA | C.16 | D37RZ301 | FOCO ESTANCO PARA PISCINA | Ud | 3.00 |  | 186.66 €
FUERA | C.16 | D37RZ201 | PEDILUVIO 1,50x2,00 I/2 DUCHA PISCINA ADULTOS | Ud | 2.00 |  | 1673.03 €
FUERA | C.16 | UPE040 | DUCHA PISCINA CHAPOTEO | Ud | 1.00 |  | 697.16 €
FUERA | C.17 | UXH010 | SOLADO LOSETA HORMIGÓN ACERA | m² | 404.60 |  | 33.09 €
FUERA | C.17 | UXB020 | BORDILLO HORMIGÓN 20x14 cm ACERA | m | 289.00 |  | 20.15 €
FUERA | C.17 | FEA020c | MURO BLOQUE HORMIGÓN 40X20X20 PARA REVESTIR | m² | 389.15 |  | 31.64 €
FUERA | C.17 | FEA020 | MURO BLOQUE HORMIGÓN 40x20x20 2CV | m² | 374.77 |  | 34.54 €
FUERA | C.17 | HRF040 | ALBARDILLA PREFABRICADA HORMIGÓN | m | 276.45 |  | 27.73 €
FUERA | C.17 | D02TA301-1 | RELLENO TIERRAS C/APORTE PARA JARDIN+SEMBRADO CESPED | m² | 724.95 |  | 7.79 €
FUERA | C.17 | UMB010 | BANCO CON RESPALDO | Ud | 4.00 |  | 189.11 €
FUERA | C.17 | UME010 | PAPELERA | Ud | 3.00 |  | 133.22 €
FUERA | C.17 | UII010 | BALIZA CIRCULAR | Ud | 28.00 |  | 113.45 €
FUERA | C.17 | UII020 | FAROLA | Ud | 5.00 |  | 878.13 €
FUERA | C.17 | E18IRL13GLF68 | LUMINARIA TECHO 2300 | Ud | 2.00 |  | 71.79 €
FUERA | C.17 | E18GS010 | BLOQUE AUTÓNOMO EMERGENCIA LED 70 lm | Ud | 1.00 |  | 61.08 €
FUERA | C.17 | D39SA701 | PARQUE JUEGOS INFANTIL | ud | 1.00 |  | 1940.36 €
FUERA | C.17 | UJP010 | MORERA (MORUS ALBA) | Ud | 2.00 |  | 32.59 €
FUERA | C.17 | UJP010b | PLÁTANO DE SOMBRA (PLATANUS X HISPANICA) | Ud | 2.00 |  | 34.89 €
FUERA | C.17 | UJP010bb | ÁRBOL DEL AMOR (CERCIS SILIQUASTRUM) | Ud | 2.00 |  | 91.90 €
FUERA | C.17 | UJP010bbb | LAVANDA (LAVÁNDULA ANGUSTIFOLIA) | Ud | 13.00 |  | 11.75 €
FUERA | C.17 | UVP010b | PUERTA PEATONAL METÁLICA EN VALLADOS/VIVIENDAS | Ud | 16.00 |  | 824.85 €
FUERA | C.17 | UVP010bb | PUERTA PEATONAL METÁLICA EN VALLADOS/ZONA COMÚN | Ud | 2.00 |  | 1030.93 €
FUERA | C.17 | UVP010 | PUERTA VEHÍCULOS METÁLICA EN VALLADOS/VIVIENDAS | Ud | 16.00 |  | 2181.32 €
FUERA | C.17 | UVV020 | VERJA METÁLICA EN VALLADOS | m² | 178.48 |  | 146.46 €
FUERA | C.17 | UVT030b | VALLA METÁLICA TIPO HÉRCULES h=1,00 m | m | 120.55 |  | 45.26 €
FUERA | C.17 | UVT030bb | PUERTA METÁLICA TIPO HÉRCULES h=1,00 m | m | 3.00 |  | 75.65 €
FUERA | C.17 | UVT030 | VALLA METÁLICA TIPO HÉRCULES h=2,00 m | m | 478.85 |  | 83.42 €
FUERA | C.17 | UVT030bbb | PUERTA METÁLICA TIPO HÉRCULES h=2,00 m | m | 16.00 |  | 105.74 €
FUERA | C.18 | 1401 | SEGURIDAD Y SALUD | m | 1.00 |  | 31714.16 €
FUERA | C.19 | XEB010 | ENSAYO MUESTRA DE BARRAS DE ACERO CORRUGADO DE UN MISMO LOTE | Ud | 48.00 |  | 63.47 €
FUERA | C.19 | XEB020 | ENSAYO MUESTRA DE BARRAS DE ACERO CORRUGADO DE CADA DIÁMETRO | Ud | 64.00 |  | 63.46 €
FUERA | C.19 | XEM020 | ENSAYO MUESTRA DE MALLAS ELECTROSOLDADAS DE CADA DIÁMETRO | Ud | 16.00 |  | 81.55 €
FUERA | C.19 | D50EB015 | TOMA MUESTRA HORMIGÓN, 5 PROBETAS | ud | 48.00 |  | 42.87 €
FUERA | C.19 | D50EB090 | INSPECCIÓN HORMIGÓN ESCLERÓMETRO | ud | 16.00 |  | 6.39 €
FUERA | C.19 | D50EB092 | INSPECCIÓN HORMIGÓN ULTRASONIDO | ud | 16.00 |  | 10.53 €
FUERA | C.19 | D50EB820 | ENSAYO QUÍMICO CEMENTO | ud | 16.00 |  | 90.25 €
FUERA | C.19 | D50EC660 | ENSAYO DE ESTANQUEIDAD SANEAMIENTO | ud | 16.00 |  | 84.99 €
FUERA | C.19 | D50ES620 | ENSAYO TUBERÍAS CALEFACCIÓN/CLIMATIZACIÓN | ud | 16.00 |  | 233.37 €
FUERA | C.19 | 1507b | PROTOCOLO PUESTA A TIERRA PISCINAS | Ud | 1.00 |  | 197.97 €
FUERA | C.19 | 1507 | CONTROL TÉCNICO OCT | Ud | 16.00 |  | 1530.39 €
FUERA | C.20 | GTA020 | CARGA Y TRANSPORTE MOVIMIENTO DE TIERRAS | m³ | 612.75 |  | 4.47 €
FUERA | C.20 | GTB020 | CANON VERTIDO TIERRAS EXCAVACIÓN | m³ | 612.75 |  | 1.01 €
FUERA | C.20 | GRA010 | TRANSPORTE DE RESIDUOS INERTES (HORMIGONES, MORTEROS Y PREFABRICADOS) | Ud | 16.00 |  | 51.69 €
FUERA | C.20 | GRA010b | TRANSPORTE DE RESIDUOS INERTES (MADERA) | Ud | 16.00 |  | 51.69 €
FUERA | C.20 | GRA010c | TRANSPORTE DE RESIDUOS INERTES (PLÁSTICOS) | Ud | 16.00 |  | 51.66 €
FUERA | C.20 | GRA010e | TRANSPORTE DE RESIDUOS INERTES (METÁLICOS) | Ud | 16.00 |  | 51.66 €
FUERA | C.20 | GRA010f | TRANSPORTE DE RESIDUOS INERTES (SIN CLASIFICAR) | Ud | 16.00 |  | 51.68 €
FUERA | C.20 | GRB010 | CANON VERTIDO RESIDUOS INERTES | Ud | 80.00 |  | 57.76 €
 |  |  | TOTAL PEM DEL PROYECTO
 |  |  | Comprobación: PEM del BC3 |  |  |  |  | 2915671.71 €

Sheet: Sistema modular
COSTE DEL SISTEMA MODULAR QUE SUSTITUYE ESTRUCTURA Y ENVOLVENTE (por vivienda pareada)
Sustituye a forjados, solera ventilada, losa de escalera, cubiertas, fábrica de ladrillo, enfoscados, monocapa, aislamientos y trasdosado del proyecto.
Partida | Ud | Cantidad | Coste unitario | Importe | Cómo se calcula
Estructura de acero de los 6 módulos (pilares, vigas, correas, arriostramientos) | kg |  |  |  | kg/m² × m² construidos × coste del kg fabricado
Panel sándwich 8+50+8 en fachadas y medianera, colocado | m² |  |  |  | Panel con IPC y merma + horas de montaje
Trasdosado interior con aislamiento (como el proyecto) | m² |  |  |  | Precio del proyecto
Suplemento de aislamiento para U = 0,20 | m²
Acabado exterior sobre panel | m² |  |  |  | ESTIMADO: pedir precio
Doble placa de protección contra incendios en medianera | m² |  |  |  | Placa 13 mm del banco de precios
Panel sándwich 8+65+8 de cubierta, colocado | m²
Sistema de cubierta sobre panel: pendientes, impermeabilización y grava | m² |  |  |  | Precio del proyecto, sin su XPS
Panel sándwich 8+120+8 en suelo de planta baja, colocado | m² |  |  |  | Sustituye a la solera ventilada Cáviti
Panel sándwich 8+65+8 en suelo de planta primera, colocado | m² |  |  |  | Sustituye al forjado unidireccional
Escalera metálica con peldaños | ud |  |  |  | Sustituye a losa + peldañeado
Juntas, sellados y remates entre módulos | ud
Colectores suspendidos bajo planta baja (como el proyecto) | ud
COSTE SISTEMA MODULAR (sustituye)
ESPECÍFICOS DE LA CONSTRUCCIÓN MODULAR
Partida | Ud | Cantidad | Coste unitario | Importe | Cómo se calcula
Transporte de módulos Seseña – Guadalix | ud
Grúa de colocación | ud |  |  |  | Compartida: 2 viviendas por jornada
Montaje en parcela: uniones, conexión de instalaciones y remates | h
Ingeniería: cálculo modular y proyecto de fabricación | ud |  |  |  | Repartida entre las 16 viviendas
Gastos fijos de fábrica (nave, oficina técnica, gestión) | ud |  |  |  | Gasto mensual / viviendas al mes
COSTE ESPECÍFICOS MODULARES
