teyame109-dev/Modular-Home/costes/Nevola_mediciones_por_oficio_16_viviendas.xlsx

Sheet: 01 Actuaciones previas
Névola · Actuaciones previas · 16 viviendas
Capítulo C.01 del proyecto de ejecución (BC3 de julio de 2026). Medición de toda la promoción y su desglose tal como viene en el proyecto. Precios del proyecto (CYPE, PEM, sin IVA), solo como referencia.
Código | Partida | Ud | Total 16 viv. | Media por vivienda | Desglose de la medición (proyecto) | Datos clave (medidas, color, marca) | Descripción completa del proyecto | Precio proyecto | Importe PEM | Alcance en el sistema modular
D01QG110 | DESMONTAJE Y RETIRADA CARTEL PUB. INC CARGA/TRANSP | m² | 20.00 | 1.25 | 1 × 5.00 × 4.00 |  | DESMONTAJE Y RETIRADA CARTEL PUB. INC CARGA/TRANSPDesmontaje y retirada de cartel publicitario formados por vigas y pilares metálicos, i/anclaje previo, recuperación de material aprovechable, apilado y p.p. de costes indirectos, según NTE/ADD-15 y 16. | 53.41 € | 1068.20 € | Fuera de la vivienda (promotor o Knubo)
D36BA005 | RETIRADA ARBOL INC DESTOCONADO / TROCEADO / CARGA / TRANS | Ud | 4.00 | 0.25 | 4 |  | RETIRADA ARBOL INC DESTOCONADO / TROCEADO / CARGA / TRANSCortado y troceado por medio de sierra mecánica y transporte fuera de la obra de tronco de árbol, hasta 30 cms de diametro, medido a un metro de altura sobre la rasante del terreno circundante. | 177.30 € | 709.20 € | Fuera de la vivienda (promotor o Knubo)
DEF040 | DEMOLICIÓN MOCHETAS INSTALACIONES | m³ | 12.43 | 0.78 | Agua: 16 × 1.20 × 0.38 × 1.00 Electricidad: 9 × 1.00 × 0.38 × 1.50 |  | DEMOLICIÓN MOCHETAS INSTALACIONESDemolición de muro de fábrica de ladrillo cerámico perforado, con martillo neumático, transporte del material a vertedero, con camión basculante cargado a máquina, canon de vertedero y p.p. de medios auxiliares, considerando tambien la carga. | 40.32 € | 501.18 € | Fuera de la vivienda (promotor o Knubo)
DMX050 | DEMOLICIÓN ACERADO | m² | 447.95 | 28.00 | Acera: 1 × 289.00 × 1.55 |  | DEMOLICIÓN ACERADODemolición de pavimento exterior de baldosas y/o losetas de hormigón incluyendo bordillo y base soporte, con martillo neumático, transporte del material a vertedero, con camión basculante cargado a máquina, canon de vertedero y p.p. de medios auxiliares, considerando tambien la carga. | 7.75 € | 3471.61 € | Fuera de la vivienda (promotor o Knubo)
101 | DESBROCE Y LIMPIEZA DEL TERRENO | m² | 7328.36 | 458.02 | Toda la parcela (incluye P17 y P18): 1 × 7328.36 |  | DESBROCE Y LIMPIEZA DEL TERRENODesbroce y limpieza superficial del terreno por medios mecánicos, para un espesor medio de 20 cm., incluso carga y transporte de tierras al vertedero, a una distancia menor de 20km., considerando ida y vuelta con camión basculante cargado a máquina, canon de vertedero y p.p. de medios auxilares, considerando también la carga. | 2.77 € | 20299.56 € | Fuera de la vivienda (promotor o Knubo)
 | Total del capítulo (PEM del proyecto) |  |  |  |  |  |  |  | 26049.75 €

Sheet: 02 Movimiento de tierras
Névola · Movimiento de tierras · 16 viviendas
Capítulo C.02 del proyecto de ejecución (BC3 de julio de 2026). Medición de toda la promoción y su desglose tal como viene en el proyecto. Precios del proyecto (CYPE, PEM, sin IVA), solo como referencia.
Código | Partida | Ud | Total 16 viv. | Media por vivienda | Desglose de la medición (proyecto) | Datos clave (medidas, color, marca) | Descripción completa del proyecto | Precio proyecto | Importe PEM | Alcance en el sistema modular
ADE005 | EXCAVACIÓN SÓTANOS | m³ | 140.00 | 8.75 | Cuarto técnico piscinas: 1 × 40.00 × 3.50 |  | EXCAVACIÓN SÓTANOSExcavación de sótanos de más de 2 m de profundidad, que en todo su perímetro quedan por debajo de la rasante natural, en suelos de compacidad media, por medios mecánicos,transporte de tierras al vertedero, con camión basculante cargado a máquina, canon de vertedero y p.p. de medios auxiliares, considerando tambien la carga. | 2.36 € | 330.40 € | Fuera de la vivienda (promotor o Knubo)
ADE010 | EXCAVACIÓN POZOS DE CIMENTACIÓN | m³ | 265.92 | 16.62 | Zapatas aisladas (demasía incluida en cota variable) PAREADO 1-2: 1 × 24.65 × 1.15 PAREADO 3-4: 1 × 30.20 × 0.75 AISLADA 5: 1 × 12.75 × 1.55 PAREADO 6-7: 1 × 24.65 × 0.95 PAREADO 8-9: 1 × 30.20 × 1.30 AISLADA 10: 1 × 12.60 × 1.25 PAREADO 11-12: 1 × 24.65 × 1.55 PAREADO 13-14: 1 × 30.20 × 0.95 PAREADO 15-16: 1 × 30.20 × 1.65 |  | EXCAVACIÓN POZOS DE CIMENTACIÓNExcavación de pozos para cimentaciones hasta una profundidad de 2 m, en suelos de compacidad media, por medios mecánicos,transporte de tierras al vertedero, con camión basculante cargado a máquina, canon de vertedero y p.p. de medios auxiliares, considerando tambien la carga. | 11.10 € | 2951.71 € | Fuera de la vivienda (promotor o Knubo)
ADE010b | EXCAVACIÓN ZANJAS CIMENTACIÓN | m³ | 194.30 | 12.14 | Vigas de atado PAREADO 1-2: 1 × 17.20 × 0.40 PAREADO 3-4: 1 × 16.30 × 0.40 AISLADA 5: 1 × 9.95 × 0.40 PAREADO 6-7: 1 × 17.20 × 0.40 PAREADO 8-9: 1 × 16.30 × 0.40 AISLADA 10: 1 × 10.15 × 0.40 PAREADO 11-12: 1 × 17.20 × 0.40 PAREADO 13-14: 1 × 16.30 × 0.40 PAREADO 15-16: 1 × 16.30 × 0.40 MUROS BLOQUE H.A. para revestir Vallados a calle Perímetro parcela total: 1 × 289.00 × 0.40 × 0.40 Muros separación pareados VIV 1-VIV 2: 1 × 8.35 × 0.40 × 0.40 VIV 3-VIV 4: 1 × 8.80 × 0.40 × 0.40 VIV 6-VIV 7: 1 × 8.35 × 0.40 × 0.40 VIV 8-VIV 9: 1 × 8.35 × 0.40 × 0.40 VIV 11-VIV 12: 1 × 8.70 × 0.40 × 0.40 VIV 13-VIV 14: 1 × 8.35 × 0.40 × 0.40 VIV 15-VIV 16: 1 × 8.35 × 0.40 × 0.40 MUROS BLOQUE H.A. cara vista Separación entre viviendas VIV 1-VIV 2: 1 × 1.90 × 0.40 × 0.40 VIV 2-VIV 3: 1 × 19.75 × 0.40 × 0.40 VIV 3-VIV 4: 1 × 1.50 × 0.40 × 0.40 VIV 4-VIV 5: 1 × 19.75 × 0.40 × 0.40 VIV 5-VIV 6: 1 × 19.75 × 0.40 × 0.40 VIV 6-VIV 7: 1 × 1.90 × 0.40 × 0.40 VIV 8-VIV 9: 1 × 3.90 × 0.40 × 0.40 VIV 9-VIV 10: 1 × 21.75 × 0.40 × 0.40 VIV 10-VIV 11: 1 × 21.75 × 0.40 × 0.40 VIV 11-VIV 12: 1 × 3.60 × 0.40 × 0.40 VIV 13-VIV 14: 1 × 3.00 × 0.40 × 0.40 VIV 14-VIV 15: 1 × 20.85 × 0.40 × 0.40 VIV 15-VIV 16: 1 × 3.00 × 0.40 × 0.40 VIV 16-PARCELA 17: 1 × 21.10 × 0.40 × 0.40 Separación viviendas-Zona común Contención diferencia de niveles VIV 1-VIV 2: 1 × 30.90 × 0.40 × 0.40 VIV 3-VIV 4: 1 × 28.60 × 0.40 × 0.40 VIV 5: 1 × 15.75 × 0.40 × 0.40 VIV 6-VIV 7: 1 × 28.70 × 0.40 × 0.40 1 × 20.60 × 0.40 × 0.40 VIV 8-VIV 9: 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 |  | EXCAVACIÓN ZANJAS CIMENTACIÓNExcavación de zanjas para cimentaciones hasta una profundidad de 2 m, en suelos de compacidad media, por medios mecánicos,transporte de tierras al vertedero, con camión basculante cargado a máquina, canon de vertedero y p.p. de medios auxiliares, considerando tambien la carga. | 9.56 € | 1857.51 € | Fuera de la vivienda (promotor o Knubo)
ADE010c | EXCAVACIÓN ZANJAS INSTALACIONES | m³ | 233.00 | 14.56 | Red saneamiento enterrada ZONA COMÚN: 1 × 81.00 × 0.40 × 0.40 VIV 1: 1 × 27.60 × 0.40 × 0.40 VIV 2: 1 × 27.60 × 0.40 × 0.40 VIV 3: 1 × 27.60 × 0.40 × 0.40 VIV 4: 1 × 27.60 × 0.40 × 0.40 VIV 5: 1 × 39.40 × 0.40 × 0.40 VIV 6: 1 × 36.60 × 0.40 × 0.40 VIV 7: 1 × 36.60 × 0.40 × 0.40 VIV 8: 1 × 33.10 × 0.40 × 0.40 VIV 9: 1 × 33.80 × 0.40 × 0.40 VIV 10: 1 × 31.45 × 0.40 × 0.40 VIV 11: 1 × 27.60 × 0.40 × 0.40 VIV 12: 1 × 27.60 × 0.40 × 0.40 VIV 13: 1 × 27.60 × 0.40 × 0.40 VIV 14: 1 × 27.60 × 0.40 × 0.40 VIV 15: 1 × 27.60 × 0.40 × 0.40 VIV 16: 1 × 27.60 × 0.40 × 0.40 Agua ZONA COMÚN: 1 × 110.00 × 0.40 × 0.40 VIVIENDAS: 16 × 24.00 × 0.40 × 0.40 Electricidad ZONA COMÚN: 1 × 255.00 × 0.40 × 0.40 VIVIENDAS: 12 × 6.00 × 0.40 × 0.40 2 × 14.00 × 0.40 × 0.40 2 × 19.50 × 0.40 × 0.40 |  | EXCAVACIÓN ZANJAS INSTALACIONESExcavación de zanjas para instalaciones hasta una profundidad de 2 m, en suelos de compacidad media, por medios mecánicos,transporte de tierras al vertedero, con camión basculante cargado a máquina, canon de vertedero y p.p. de medios auxiliares, considerando tambien la carga. | 12.01 € | 2798.33 € | Fuera de la vivienda (promotor o Knubo)
ADR030 | RELLENO Y COMPACTACIÓN | m³ | 7681.48 | 480.09 | Toda la parcela (hmedia=1.15 m): 1 × 6679.55 × 1.15 Incluye relleno bordes cimentación encofrada |  | RELLENO Y COMPACTACIÓNBase de pavimento realizada mediante relleno a cielo abierto, con tierra de préstamo, y compactación en tongadas sucesivas de 30 cm de espesor máximo con rodillo vibrante de guiado manual, hasta alcanzar una densidad seca no inferior al 98% de la máxima obtenida en el ensayo Proctor Modificado, realizado según UNE 103501. El precio incluye el ensayo de Proctor Modificado. | 8.69 € | 66752.06 € | Fuera de la vivienda (promotor o Knubo)
 | Total del capítulo (PEM del proyecto) |  |  |  |  |  |  |  | 74690.01 €

Sheet: 03 Saneamiento enterrado
Névola · Saneamiento enterrado · 16 viviendas
Capítulo C.03 del proyecto de ejecución (BC3 de julio de 2026). Medición de toda la promoción y su desglose tal como viene en el proyecto. Precios del proyecto (CYPE, PEM, sin IVA), solo como referencia.
Código | Partida | Ud | Total 16 viv. | Media por vivienda | Desglose de la medición (proyecto) | Datos clave (medidas, color, marca) | Descripción completa del proyecto | Precio proyecto | Importe PEM | Alcance en el sistema modular
UAP011 | ARQUETA DE ARRANQUE | Ud | 33.00 | 2.06 | AA Pluviales: 16 × 1.00 Fecales: 16 × 1.00 Zona común: 1 × 1.00 | Medidas: 125x125x100cm, 150x150cm | ARQUETA DE ARRANQUEFormación de pozo de registro de elementos prefabricados de hormigón en masa, de 0,90 m de diámetro interior y de 2,1 m de altura útil interior máxima, formado por: solera de 25 cm de espesor de hormigón armado HA-30/B/20/IIb+Qb ligeramente armada con malla electrosoldada ME 20x20 Ø 8-8 B 500 T 6x2,20 UNE-EN 10080; base prefabricada de hormigón en masa, de 125x125x100 cm, con dos orificios de 30 cm de diámetro para conexión de colectores, de 90 cm de diámetro interior, con unión rígida machihembrada con junta de goma, según UNE-EN 1917, resistencia a compresión mayor de 250 kg/cm²; anillo prefabricado de hormigón en masa, con unión rígida machihembrada con junta de goma, según UNE-EN 1917, de 100 cm de diámetro interior y 50 cm de altura, resistencia a compresión mayor de 250 kg/cm²; cono asimétrico prefabricado de hormigón en masa, con unión rígida machihembrada con junta de goma, según UNE-EN 1917, de 100 a 60 cm de diámetro interior y 60 cm de altura, resistencia a compresión mayor de 250 kg/cm² y losa alrededor de la boca del cono de 150x150 cm y 20 cm de espesor de hormigón en masa HM-30/B/20/I+Qb; con cierre de tapa circular con bloqueo y marco de fundición clase D-400 según UNE-EN 124, instalado en calzadas de calles, incluyendo las peatonales, o zonas de aparcamiento para todo tipo de vehículos. Incluso hormigón en masa HM-30/B/20/I+Qb para formación de canal en el fondo del pozo y lubricante para montaje.El precio incluye los equipos y la maquina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 | 699.92 € | 23097.36 € | Fuera de la vivienda (promotor o Knubo)
ASB020 | CONEXIÓN ACOMETIDA | Ud | 33.00 | 2.06 | Pozos Pluviales: 16 × 1.00 Fecales: 16 × 1.00 Zona común: 1 × 1.00 |  | CONEXIÓN ACOMETIDASuministro y montaje de la conexión de la acometida del edificio a la red general de saneamiento del municipio a través de pozo de registro. Incluso junta flexible para el empalme de la acometida y mortero de cemento, industrial, M-5 para repaso y bruñido en el interior del pozo. | 148.82 € | 4911.06 € | Fuera de la vivienda (promotor o Knubo)
ASB010b | ACOMETIDA DE SANEAMIENTO (ALBAÑAL) | m | 181.15 | 11.32 | Pluviales VIV 1: 1 × 5.10 VIV 2: 1 × 5.75 VIV 3: 1 × 5.00 VIV 4: 1 × 6.20 VIV 5: 1 × 4.90 VIV 6: 1 × 4.90 VIV 7: 1 × 5.00 VIV 8: 1 × 7.60 VIV 9: 1 × 6.20 VIV 10: 1 × 6.70 VIV 11: 1 × 5.75 VIV 12: 1 × 5.45 VIV 13: 1 × 6.75 VIV 14: 1 × 6.25 VIV 15: 1 × 7.10 VIV 16: 1 × 6.70 Fecales VIV 1: 1 × 3.90 VIV 2: 1 × 5.10 VIV 3: 1 × 3.80 VIV 4: 1 × 5.20 VIV 5: 1 × 3.85 VIV 6: 1 × 4.10 VIV 7: 1 × 3.80 VIV 8: 1 × 6.70 VIV 9: 1 × 6.15 VIV 10: 1 × 5.90 VIV 11: 1 × 4.90 VIV 12: 1 × 4.90 VIV 13: 1 × 5.40 VIV 14: 1 × 5.20 VIV 15: 1 × 5.60 VIV 16: 1 × 5.60 ZONA COMÚN: 1 × 5.70 |  | ACOMETIDA DE SANEAMIENTO (ALBAÑAL)Suministro y montaje de acometida general de saneamiento, para la evacuación de aguas residuales y/o pluviales a la red general del municipio, con una pendiente mínima del 2%, para la evacuación de aguas residuales y/o pluviales, formada por tubo de PVC corrugado, rigidez anular nominal 8 kN/m², de 250 mm de diámetro exterior, con junta elástica, colocado sobre lecho de arena de 10 cm de espesor, debidamente compactada y nivelada con pisón vibrante de guiado manual, relleno lateral compactando hasta los riñones y posterior relleno con la misma arena hasta 30 cm por encima de la generatriz superior de la tubería, con sus correspondientes juntas y piezas especiales. Incluso lubricante para montaje y hormigón en masa HM-20/P/20/I para la posterior reposición del firme existente. El precio incluye la demolición y el levantado del firme existente, así como la excavación y el relleno. | 82.99 € | 15033.64 € | Fuera de la vivienda (promotor o Knubo)
0324SH0502 | VÁLVULA ANTIRRETORNO ACOMETIDA | Ud | 33.00 | 2.06 | Pluviales: 16 × 1.00 Fecales: 16 × 1.00 Zona común: 1 × 1.00 |  | VÁLVULA ANTIRRETORNO ACOMETIDASuministro, instalación y montaje de válvula antirretorno de doble clapeta con cierre manual para colector de diámetro igual al de la acometida. Totalmente instalada y funcionado de acuerdo con CTE-HS-5 e instrucciones del fabricante, incluida p.p. de accesorios de conexión adecuados, incluso piezas especiales necesarias, ayudas de albañilería y medios auxiliares necesarios, totalmente terminada.Totalmente instalada, probada su estanqueidad y funcionamiento y en servicio según indicaciones de la D.F., CTE DB-HS, y especificaciones técnicas del fabricante. | 122.38 € | 4038.54 € | Fuera de la vivienda (promotor o Knubo)
203b | ARQUETA DE PASO 50x50x60 | Ud | 68.00 | 4.25 | AF01: 16 × 2.00 AP01: 16 × 2.00 Zona común: 1 × 4.00 | Medidas: 50x50x60cm | ARQUETA DE PASO 50x50x60Formación de arqueta de paso, enterrada, registrable, construida con fábrica de ladrillo cerámico macizo, de 1/2 pie de espesor, recibido con mortero de cemento, industrial, M-5, de dimensiones interiores 50x50x60 cm, sobre solera de hormigón en masa HM-30/B/20/I+Qb de 15 cm de espesor, formación de pendiente mínima del 2%, con el mismo tipo de hormigón, enfoscada y bruñida interiormente con mortero de cemento, industrial, con aditivo hidrófugo, M-15 formando aristas y esquinas a media caña, cerrada superiormente con tablero cerámico hueco machihembrado y losa de hormigón HA-30/B/20/IIb+Qb, armada con malla electrosoldada y sellada herméticamente con mortero de cemento. Incluso mortero para sellado de juntas y piezas de PVC cortadas longitudinalmente para formación del canal en el fondo de la arqueta. | 124.39 € | 8458.52 € | Fuera de la vivienda (promotor o Knubo)
208 | COLECTOR ENTERRADO PVC 110 mm | m | 124.00 | 7.75 | Fecales: 16 × 2.00 Pluviales: 16 × 2.25 Previsión piscina (fecales): 16 × 3.50 |  | COLECTOR ENTERRADO PVC 110 mmSuministro y montaje de colector enterrado de red horizontal de saneamiento, con arquetas, con una pendiente mínima del 2%, para la evacuación de aguas residuales y/o pluviales, formado por tubo de PVC liso, serie SN-4, rigidez anular nominal 4 kN/m², de 110 mm de diámetro exterior, pegado mediante adhesivo, colocado sobre lecho de arena de 10 cm de espesor, debidamente compactada y nivelada con pisón vibrante de guiado manual, relleno lateral compactando hasta los riñones y posterior relleno con la misma arena hasta 30 cm por encima de la generatriz superior de la tubería. Incluso líquido limpiador y adhesivo para tubos y accesorios de PVC. | 11.81 € | 1464.44 € | Fuera de la vivienda (promotor o Knubo)
209 | COLECTOR ENTERRADO PVC 125 mm | m | 221.30 | 13.83 | Pluviales (general cubiertas): 16 × 8.50 Sumideros zona aparcamiento: 13 × 2.40 1 × 5.35 1 × 11.25 1 × 3.85 Zona común: 1 × 33.65 |  | COLECTOR ENTERRADO PVC 125 mmSuministro y montaje de colector enterrado de red horizontal de saneamiento, con arquetas, con una pendiente mínima del 2%, para la evacuación de aguas residuales y/o pluviales, formado por tubo de PVC liso, serie SN-4, rigidez anular nominal 4 kN/m², de 125 mm de diámetro exterior, pegado mediante adhesivo, colocado sobre lecho de arena de 10 cm de espesor, debidamente compactada y nivelada con pisón vibrante de guiado manual, relleno lateral compactando hasta los riñones y posterior relleno con la misma arena hasta 30 cm por encima de la generatriz superior de la tubería. Incluso líquido limpiador y adhesivo para tubos y accesorios de PVC. | 13.41 € | 2967.63 € | Fuera de la vivienda (promotor o Knubo)
210 | COLECTOR ENTERRADO PVC 160 mm | m | 255.10 | 15.94 | Pluviales VIV 1: 1 × 8.50 VIV 2: 1 × 7.65 VIV 3: 1 × 8.50 VIV 4: 1 × 7.65 VIV 5: 1 × 4.55 VIV 6: 1 × 6.55 VIV 7: 1 × 7.50 VIV 8: 1 × 4.05 VIV 9: 1 × 6.40 VIV 10: 1 × 9.30 VIV 11: 1 × 8.50 VIV 12: 1 × 7.65 VIV 13: 1 × 8.50 VIV 14: 1 × 7.65 VIV 15: 1 × 8.50 VIV 16: 1 × 7.65 Fecales VIV 1: 1 × 4.55 VIV 2: 1 × 4.55 VIV 3: 1 × 4.55 VIV 4: 1 × 4.55 VIV 5: 1 × 9.55 VIV 6: 1 × 13.95 VIV 7: 1 × 12.65 VIV 8: 1 × 9.25 VIV 9: 1 × 11.40 VIV 10: 1 × 3.90 VIV 11: 1 × 4.55 VIV 12: 1 × 4.55 VIV 13: 1 × 4.55 VIV 14: 1 × 4.55 VIV 15: 1 × 4.55 VIV 16: 1 × 4.55 Zona común: 1 × 29.80 |  | COLECTOR ENTERRADO PVC 160 mmSuministro y montaje de colector enterrado de red horizontal de saneamiento, con arquetas, con una pendiente mínima del 2%, para la evacuación de aguas residuales y/o pluviales, formado por tubo de PVC liso, serie SN-4, rigidez anular nominal 4 kN/m², de 160 mm de diámetro exterior, pegado mediante adhesivo, colocado sobre lecho de arena de 10 cm de espesor, debidamente compactada y nivelada con pisón vibrante de guiado manual, relleno lateral compactando hasta los riñones y posterior relleno con la misma arena hasta 30 cm por encima de la generatriz superior de la tubería. Incluso líquido limpiador y adhesivo para tubos y accesorios de PVC. | 17.16 € | 4377.52 € | Fuera de la vivienda (promotor o Knubo)
ISS010cc | COLECTOR SUSPENDIDO PVC 52 mm | m | 27.20 | 1.70 | Suelo radiante: 16 × 1.70 |  | COLECTOR SUSPENDIDO PVC 52 mmSuministro e instalación de colector suspendido insonorizado de red horizontal, formado por tubo PVC-U, ABS, ASA y PVC-U con carga mineral de 52 mm de diámetro y 2,8 mm de espesor, unión a presión con junta elástica, con una pendiente mínima del 1,00%, para la evacuación de aguas residuales (a baja y alta temperatura) y/o pluviales en el interior de la estructura de los edificios. Incluso material auxiliar para montaje y sujeción a la obra, accesorios y piezas especiales. | 17.53 € | 476.82 € | Lo sustituye el módulo: no se pide así
ISS010c | COLECTOR SUSPENDIDO PVC 90 mm | m | 84.80 | 5.30 | Pluviales: 16 × 5.30 |  | COLECTOR SUSPENDIDO PVC 90 mmSuministro e instalación de colector suspendido insonorizado de red horizontal, formado por tubo PVC-U, ABS, ASA y PVC-U con carga mineral de 90 mm de diámetro y 5,1 mm de espesor, unión a presión con junta elástica, con una pendiente mínima del 1,00%, para la evacuación de aguas residuales (a baja y alta temperatura) y/o pluviales en el interior de la estructura de los edificios. Incluso material auxiliar para montaje y sujeción a la obra, accesorios y piezas especiales. | 27.09 € | 2297.23 € | Lo sustituye el módulo: no se pide así
ISS010cb | COLECTOR SUSPENDIDO PVC 110 mm | m | 408.00 | 25.50 | Fecales Baño 2: 16 × 1.45 Baño principal: 16 × 1.15 Cámara sanitaria (cáviti): 16 × 22.90 |  | COLECTOR SUSPENDIDO PVC 110 mmSuministro e instalación de colector suspendido insonorizado de red horizontal, formado por tubo PVC-U, ABS, ASA y PVC-U con carga mineral de 110 mm de diámetro y 5,3 mm de espesor, unión a presión con junta elástica, con una pendiente mínima del 1,00%, para la evacuación de aguas residuales (a baja y alta temperatura) y/o pluviales en el interior de la estructura de los edificios. Incluso material auxiliar para montaje y sujeción a la obra, accesorios y piezas especiales. | 30.10 € | 12280.80 € | Lo sustituye el módulo: no se pide así
ISB010 | BAJANTE RESIDUALES. PVC 110 mm | m | 172.00 | 10.75 | F1-F2: 16 × 2.00 × 3.50 Ventilación cámara sanitaria: 7 × 6.00 × 1.20 1 × 4.00 × 1.20 1 × 4.00 × 1.20 |  | BAJANTE RESIDUALES. PVC 110 mmBajante interior insonorizada de la red de evacuación de aguas residuales, formada por tubo de PVC-U, ABS, ASA y PVC-U con carga mineral, de 110 mm de diámetro y 5,3 mm de espesor; unión a presión con junta elástica. Incluso material auxiliar para montaje y sujeción a la obra, accesorios y piezas especiales. | 31.02 € | 5335.44 € | Se pide igual (fábrica u obra)
ISB010b | BAJANTE PLUVIALES. PVC 90 mm | m | 163.20 | 10.20 | P1-P2: 16 × 6.50 P3: 16 × 3.50 Caseta aperos: 1 × 3.20 |  | BAJANTE PLUVIALES. PVC 90 mmBajante interior insonorizada de la red de evacuación de aguas pluviales, formada por tubo de PVC-U, ABS, ASA y PVC-U con carga mineral, de 90 mm de diámetro y 5,1 mm de espesor; unión a presión con junta elástica. Incluso material auxiliar para montaje y sujeción a la obra, accesorios y piezas especiales. | 23.47 € | 3830.30 € | Se pide igual (fábrica u obra)
0324SH0204 | CANALETA SUMIDERO PREFABRICADA 25 cm. URBANIZACIÓN | m | 15.00 | 0.94 | Piscina: 1 × 15.00 |  | CANALETA SUMIDERO PREFABRICADA 25 cm. URBANIZACIÓNSuministro y montaje de canaleta sumidero sifónica longitudinal de fundición en urbanización, en tramos de 1000 mm de largo, 150 mm de ancho y 170 mm de alto, con rejilla cuadriculada de fundición, en piezas de 1000 mm de longitud, incluso p.p. de conexión a saneamiento con tubería de PVC serie F colocado en parcela recibido con solapes de la lámina impermeabilizante, totalmente enrasado con el pavimento de terminación, instalado y conectado a la red de evacuación, todo ello según especificaciones de proyecto, NTE-ISS, DIT del fabricante, marcado CE y CÓDIGO TÉCNICO DE LA EDIFICACIÓN DB-HS. | 30.24 € | 453.60 € | Fuera de la vivienda (promotor o Knubo)
212 | SUMIDERO SIFÓNICO | Ud | 82.00 | 5.12 | Cubierta planta no transitable: 16 × 2.00 Cubierta plana transitable (terrazas): 16 × 2.00 Caseta aperos: 1 × 1.00 Exterior viviendas: 16 × 1.00 Cuarto técnico piscinas: 1 × 1.00 | Medidas: 250x250mm | SUMIDERO SIFÓNICOInstalación de sumidero sifónico de PVC, de salida vertical de 90 mm de diámetro, con rejilla de PVC de 250x250 mm, para recogida de aguas pluviales o de locales húmedos. Incluso accesorios de montaje, piezas especiales y elementos de sujeción. | 21.78 € | 1785.96 € | Fuera de la vivienda (promotor o Knubo)
HRP060 | REBOSADEROS | Ud | 18.00 | 1.12 | Cubiertas planta primera PAREADO TIPO: 7 × 2.00 AISLADA TIPO 1 (VIVIENDA 5): 1 × 2.00 AISLADA TIPO 2 (VIVIENDA 10): 1 × 2.00 | Medidas: 100x220x58mm · Color: blanco | REBOSADEROSGárgola de hormigón polímero de superficie pulida, de color blanco, de 100x220x58 mm y base rectangular, con goterón, recibida con adhesivo cementoso flexible y sellado de la junta perimetral con masilla de poliuretano, previa aplicación de la imprimación. Incluso nivelación y remate de la impermeabilización en caso necesario. | 10.02 € | 180.36 € | Fuera de la vivienda (promotor o Knubo)
ISD009 | SUMIDERO SIFÓNICO DUCHA | Ud | 1.00 | 0.06 | Ducha piscina chapoteo: 1 | Medidas: 100x100mm | SUMIDERO SIFÓNICO DUCHASumidero sifónico de PVC con rejilla de acero inoxidable de 100x100 mm y salidas vertical y horizontal de 50 mm de diámetro, para desagüe de ducha de obra. | 10.41 € | 10.41 € | Fuera de la vivienda (promotor o Knubo)
IVN110 | REJILLA VENTILACIÓN | Ud | 53.00 | 3.31 | Ventilación cámara sanitaria PAREADO TIPO: 7 × 6.00 VIVIENDA AISLADA (VIVIENDA 5): 1 × 4.00 VIVIENDA AISLADA (VIVIENDA 10): 1 × 4.00 Caseta aperos: 1 × 1.00 Cuarto técnico piscinas: 1 × 2.00 | Medidas: 15x15cm · Color: con | REJILLA VENTILACIÓNRejilla de ventilación de lamas fijas de aluminio lacado color con 60 micras de espesor mínimo de película seca, de dimensiones 15x15 cm. Incluso tornillos.Incluye: Marcado de los puntos de fijación. Colocación y fijación.Criterio de medición de proyecto: Superficie del hueco a cerrar, medida según documentación gráfica de Proyecto.Criterio de medición de obra: Se medirá, con las dimensiones del hueco, la superficie realmente ejecutada según especificaciones de Proyecto. | 17.83 € | 944.99 € | Fuera de la vivienda (promotor o Knubo)
 | Total del capítulo (PEM del proyecto) |  |  |  |  |  |  |  | 91944.62 €

Sheet: 04 Cimentación y estructura
Névola · Cimentación y estructura · 16 viviendas
Capítulo C.04 del proyecto de ejecución (BC3 de julio de 2026). Medición de toda la promoción y su desglose tal como viene en el proyecto. Precios del proyecto (CYPE, PEM, sin IVA), solo como referencia.
Código | Partida | Ud | Total 16 viv. | Media por vivienda | Desglose de la medición (proyecto) | Datos clave (medidas, color, marca) | Descripción completa del proyecto | Precio proyecto | Importe PEM | Alcance en el sistema modular
CMP010 | POZO DE CIMENTACIÓN (RELLENO A FIRME) | m³ | 194.83 | 12.18 | ZAPATAS AISLADAS/CIMEN ESCALERAS (demasía 25 %) PAREADO 1-2: 1 × 24.65 × 1.25 × 0.65 PAREADO 3-4: 1 × 30.20 × 1.25 × 0.25 AISLADA 5: 1 × 12.75 × 1.25 × 1.05 PAREADO 6-7: 1 × 24.65 × 1.25 × 0.45 PAREADO 8-9: 1 × 30.20 × 1.25 × 0.80 AISLADA 10: 1 × 12.60 × 1.25 × 0.75 PAREADO 11-12: 1 × 24.65 × 1.25 × 1.05 PAREADO 13-14: 1 × 30.20 × 1.25 × 0.45 PAREADO 15-16: 1 × 30.20 × 1.25 × 1.15 |  | POZO DE CIMENTACIÓN DE HORMIGÓN CICLÓPEOPozo de cimentación de hormigón HL-150/B/20, fabricado en central y vertido desde camión, en el fondo de la excavación previamente realizada. Incluye: Replanteo. Colocación de toques y/o formación de maestras. Vertido y compactación del hormigón. Coronación y enrase del hormigón.Incluye: Replanteo y trazado de las zapatas y de los pilares u otros elementos estructurales que apoyen en las mismas. Vertido y compactación del hormigón. Colocación de las piedras en el hormigón fresco. Coronación y enrase de cimientos. Curado del hormigón.Criterio de medición de proyecto: Volumen teórico, según documentación gráfica de Proyecto.Criterio de medición de obra: Se medirá el volumen teórico ejecutado según especificaciones de Proyecto, sin incluir los incrementos por excesos de excavación no autorizados. | 70.73 € | 13780.33 € | Fuera de la vivienda (promotor o Knubo)
301 | HORMIGÓN DE LIMPIEZA h=10 cm | m² | 1841.22 | 115.08 | VIGAS DE ATADO (demasía 25 %) PAREADO 1-2: 1 × 17.20 × 1.25 PAREADO 3-4: 1 × 16.30 × 1.25 AISLADA 5: 1 × 9.95 × 1.25 PAREADO 6-7: 1 × 17.20 × 1.25 PAREADO 8-9: 1 × 16.30 × 1.25 AISLADA 10: 1 × 10.15 × 1.25 PAREADO 11-12: 1 × 17.20 × 1.25 PAREADO 13-14: 1 × 16.30 × 1.25 × 1.25 PAREADO 15-16: 1 × 16.30 × 1.25 BASE SOLERA CÁVITI PAREADO TIPO: 7 × 150.40 AISLADA TIPO 1 (VIVIENDA 5): 1 × 77.10 AISLADA TIPO 2 (VIVIENDA 10): 1 × 77.95 MUROS BLOQUE H.A. para revestir (demasía 25 %) Vallados a calle Perímetro parcela total: 1 × 289.00 × 0.40 × 1.25 Muros separación pareados VIV 1-VIV 2: 1 × 8.35 × 0.40 × 1.25 VIV 3-VIV 4: 1 × 8.80 × 0.40 × 1.25 VIV 6-VIV 7: 1 × 8.35 × 0.40 × 1.25 VIV 8-VIV 9: 1 × 8.35 × 0.40 × 1.25 VIV 11-VIV 12: 1 × 8.70 × 0.40 × 1.25 VIV 13-VIV 14: 1 × 8.35 × 0.40 × 1.25 VIV 15-VIV 16: 1 × 8.35 × 0.40 × 1.25 MUROS BLOQUE H.A. cara vista (demasía 25 %) Separación entre viviendas VIV 1-VIV 2: 1 × 1.90 × 0.40 × 1.25 VIV 2-VIV 3: 1 × 19.75 × 0.40 × 1.25 VIV 3-VIV 4: 1 × 1.50 × 0.40 × 1.25 VIV 4-VIV 5: 1 × 19.75 × 0.40 × 1.25 VIV 5-VIV 6: 1 × 19.75 × 0.40 × 1.25 VIV 6-VIV 7: 1 × 1.90 × 0.40 × 1.25 VIV 8-VIV 9: 1 × 3.90 × 0.40 × 1.25 VIV 9-VIV 10: 1 × 21.75 × 0.40 × 1.25 VIV 10-VIV 11: 1 × 21.75 × 0.40 × 1.25 VIV 11-VIV 12: 1 × 3.60 × 0.40 × 1.25 VIV 13-VIV 14: 1 × 3.00 × 0.40 × 1.25 VIV 14-VIV 15: 1 × 20.85 × 0.40 × 1.25 VIV 15-VIV 16: 1 × 3.00 × 0.40 × 1.25 VIV 16-PARCELA 17: 1 × 21.10 × 0.40 × 1.25 Separación viviendas-Zona común (demasía 25 %) Contención diferencia 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 |  | HORMIGÓN DE LIMPIEZA h=10 cmCapa de hormigón de limpieza y nivelado de fondos de cimentación, de 10 cm de espesor, de hormigón HL-150/B/20, fabricado en central y vertido desde camión, en el fondo de la excavación previamente realizada. Incluye: Replanteo. Colocación de toques y/o formación de maestras. Vertido y compactación del hormigón. Coronación y enrase del hormigón. | 7.31 € | 13459.32 € | Fuera de la vivienda (promotor o Knubo)
CSZ020 | ENCOFRADO CIMENTACIÓN | m² | 771.00 | 48.19 | ZAPATAS AISLADAS/CIMEN ESCALERAS/VIGAS DE ATADO PAREADO 1-2: 1 × 155.70 × 0.60 PAREADO 3-4: 1 × 159.80 × 0.60 AISLADA 5: 1 × 88.80 × 0.60 PAREADO 6-7: 1 × 155.70 × 0.60 PAREADO 8-9: 1 × 159.80 × 0.60 AISLADA 10: 1 × 89.90 × 0.60 PAREADO 11-12: 1 × 155.70 × 0.60 PAREADO 13-14: 1 × 159.80 × 0.60 PAREADO 15-16: 1 × 159.80 × 0.60 |  | ENCOFRADO CIMENTACIÓNMontaje de sistema de encofrado recuperable de madera, para zapata de cimentación, formado por tablones de madera, amortizables en 10 usos, y posterior desmontaje del sistema de encofrado. Incluso elementos de sustentación, fijación y acodalamientos necesarios para su estabilidad y líquido desencofrante para evitar la adherencia del hormigón al encofrado. | 13.83 € | 10662.93 € | Fuera de la vivienda (promotor o Knubo)
CSZ030 | ZAPATA HORMIGÓN ARMADO HA-25/F/20/XC2 | m³ | 110.07 | 6.88 | ZAPATAS AISLADAS/CIMEN ESCALERAS PAREADO 1-2: 1 × 24.65 × 0.50 PAREADO 3-4: 1 × 30.20 × 0.50 AISLADA 5: 1 × 12.75 × 0.50 PAREADO 6-7: 1 × 24.65 × 0.50 PAREADO 8-9: 1 × 30.20 × 0.50 AISLADA 10: 1 × 12.60 × 0.50 PAREADO 11-12: 1 × 24.65 × 0.50 PAREADO 13-14: 1 × 30.20 × 0.50 PAREADO 15-16: 1 × 30.20 × 0.50 |  | ZAPATA HORMIGÓN ARMADO HA-25/F/20/XC2Zapata de cimentación de hormigón armado, realizada con hormigón HA-25/F/20/XC2 fabricado en central, y vertido con cubilote, y acero, UNE-EN 10080 B 500 S, con una cuantía aproximada de 35,1 kg/m³. Incluso armaduras de espera del pilar, alambre de atar y separadores.Criterio de valoración económica: El precio incluye la elaboración de la ferralla (corte, doblado y conformado de elementos) en taller industrial y el montaje en el lugar definitivo de su colocación en obra, pero no incluye el encofrado.Incluye: Replanteo y trazado de las zapatas y de los pilares u otros elementos estructurales que apoyen en las mismas. Colocación de separadores y fijación de las armaduras. Vertido y compactación del hormigón. Coronación y enrase de cimientos. Curado del hormigón.Criterio de medición de proyecto: Volumen medido sobre las secciones teóricas de la excavación, según documentación gráfica de Proyecto.Criterio de medición de obra: Se medirá el volumen teórico ejecutado según especificaciones de Proyecto, sin incluir los incrementos por excesos de excavación no autorizados. | 142.04 € | 15634.34 € | Fuera de la vivienda (promotor o Knubo)
CAV030 | VIGA DE ATADO HA-25/F/20/XC2 | m³ | 54.76 | 3.42 | VIGAS DE ATADO PAREADO 1-2: 1 × 17.20 × 0.40 PAREADO 3-4: 1 × 16.30 × 0.40 AISLADA 5: 1 × 9.95 × 0.40 PAREADO 6-7: 1 × 17.20 × 0.40 PAREADO 8-9: 1 × 16.30 × 0.40 AISLADA 10: 1 × 10.15 × 0.40 PAREADO 11-12: 1 × 17.20 × 0.40 PAREADO 13-14: 1 × 16.30 × 0.40 PAREADO 15-16: 1 × 16.30 × 0.40 |  | VIGA DE ATADO HA-25/F/20/XC2/VALLADOSViga de atado de hormigón armado, realizada con hormigón HA-25/F/20/XC2 fabricado en central, y vertido con cubilote, y acero, UNE-EN 10080 B 500 S, con una cuantía aproximada de 61,8 kg/m³. Incluso alambre de atar y separadores.Criterio de valoración económica: El precio incluye la elaboración de la ferralla (corte, doblado y conformado de elementos) en taller industrial y el montaje en el lugar definitivo de su colocación en obra, pero no incluye el encofrado.Incluye: Colocación de la armadura con separadores homologados. Vertido y compactación del hormigón. Coronación y enrase. Curado del hormigón.Criterio de medición de proyecto: Volumen medido sobre las secciones teóricas de la excavación, según documentación gráfica de Proyecto.Criterio de medición de obra: Se medirá el volumen teórico ejecutado según especificaciones de Proyecto, sin incluir los incrementos por excesos de excavación no autorizados. | 178.34 € | 9765.90 € | Fuera de la vivienda (promotor o Knubo)
CAV030b | ZUNCHO HA-25/F/20/XC2/VALLADOS | m³ | 139.54 | 8.72 | MUROS BLOQUE H.A. para revestir Vallados a calle Perímetro parcela total: 1 × 289.00 × 0.40 × 0.40 Muros separación pareados VIV 1-VIV 2: 1 × 8.35 × 0.40 × 0.40 VIV 3-VIV 4: 1 × 8.80 × 0.40 × 0.40 VIV 6-VIV 7: 1 × 8.35 × 0.40 × 0.40 VIV 8-VIV 9: 1 × 8.35 × 0.40 × 0.40 VIV 11-VIV 12: 1 × 8.70 × 0.40 × 0.40 VIV 13-VIV 14: 1 × 8.35 × 0.40 × 0.40 VIV 15-VIV 16: 1 × 8.35 × 0.40 × 0.40 MUROS BLOQUE H.A. cara vista Separación entre viviendas VIV 1-VIV 2: 1 × 1.90 × 0.40 × 0.40 VIV 2-VIV 3: 1 × 19.75 × 0.40 × 0.40 VIV 3-VIV 4: 1 × 1.50 × 0.40 × 0.40 VIV 4-VIV 5: 1 × 19.75 × 0.40 × 0.40 VIV 5-VIV 6: 1 × 19.75 × 0.40 × 0.40 VIV 6-VIV 7: 1 × 1.90 × 0.40 × 0.40 VIV 8-VIV 9: 1 × 3.90 × 0.40 × 0.40 VIV 9-VIV 10: 1 × 21.75 × 0.40 × 0.40 VIV 10-VIV 11: 1 × 21.75 × 0.40 × 0.40 VIV 11-VIV 12: 1 × 3.60 × 0.40 × 0.40 VIV 13-VIV 14: 1 × 3.00 × 0.40 × 0.40 VIV 14-VIV 15: 1 × 20.85 × 0.40 × 0.40 VIV 15-VIV 16: 1 × 3.00 × 0.40 × 0.40 VIV 16-PARCELA 17: 1 × 21.10 × 0.40 × 0.40 Separación viviendas-Zona común Contención diferencia de niveles VIV 1-VIV 2: 1 × 30.90 × 0.40 × 0.40 VIV 3-VIV 4: 1 × 28.60 × 0.40 × 0.40 VIV 5: 1 × 15.75 × 0.40 × 0.40 VIV 6-VIV 7: 1 × 28.70 × 0.40 × 0.40 1 × 20.60 × 0.40 × 0.40 VIV 8-VIV 9: 1 × 25.65 × 0.40 × 0.40 VIV 10: 1 × 14.15 × 0.40 × 0.40 VIV 11-VIV 12: 1 × 28.75 × 0.40 × 0.40 VIV 13-VIV 14: 1 × 29.90 × 0.40 × 0.40 1 × 21.00 × 0.40 × 0.40 VIV 15-VIV 16: 1 × 31.50 × 0.40 × 0.40 CASETA APEROS: 1 × 13.45 × 0.40 × 0.40 PERÍMETRO PISCINA: 1 × 71.40 × 0.40 × 0.40 |  | ZUNCHO HA-25/F/20/XC2/VALLADOSZuncho de hormigón armado, realizada con hormigón HA-25/F/20/XC2 fabricado en central, y vertido con cubilote, y acero, UNE-EN 10080 B 500 S, con una cuantía aproximada de 61,8 kg/m³. Incluso alambre de atar y separadores.Criterio de valoración económica: El precio incluye la elaboración de la ferralla (corte, doblado y conformado de elementos) en taller industrial y el montaje en el lugar definitivo de su colocación en obra, pero no incluye el encofrado.Incluye: Colocación de la armadura con separadores homologados. Vertido y compactación del hormigón. Coronación y enrase. Curado del hormigón.Criterio de medición de proyecto: Volumen medido sobre las secciones teóricas de la excavación, según documentación gráfica de Proyecto.Criterio de medición de obra: Se medirá el volumen teórico ejecutado según especificaciones de Proyecto, sin incluir los incrementos por excesos de excavación no autorizados. | 178.34 € | 24885.56 € | Fuera de la vivienda (promotor o Knubo)
ANS030 | SOLERA VENTILADA C-50 "CÁVITI" 50+5 cm | m² | 1207.85 | 75.49 | PAREADO TIPO: 7 × 150.40 AISLADA TIPO 1 (VIVIENDA 5): 1 × 77.10 AISLADA TIPO 2 (VIVIENDA 10): 1 × 77.95 | Medidas: 750x580x500mm · Color: negro · Marca/serie: CÁVITI | SOLERA VENTILADA C-50 "CÁVITI" 50+5 cmSolera ventilada de hormigón armado de 50+5 cm de canto, sobre encofrado perdido de piezas de polipropileno reciclado, C-50 "CÁVITI", de 750x580x500 mm, color negro, realizada con hormigón HA-25/B/12/IIa fabricado en central, y vertido con cubilote, y malla electrosoldada ME 10x10 Ø 5-5 B 500 T 6x2,20 UNE-EN 10080 como armadura de reparto, colocada sobre separadores homologados en capa de compresión de 5 cm de espesor, incluida tabica perimetral de hormigón armado de ancho máximo 15 cm y encofrado de la misma; con juntas de retracción de 5 mm de espesor, mediante corte con disco de diamante; apoyado todo ello sobre base de hormigón de limpieza (NO INCLUIDO EN ESTE PRECIO). Incluso panel de poliestireno expandido de 3 cm de espesor, para la ejecución de juntas de dilatación. | 39.45 € | 47649.68 € | Lo sustituye el módulo: no se pide así
EHU030b | FORJADO UNIDIRECCIONAL 30 cm SEMIVIGUETA ARMADA/BOV HORMIGÓN/PILARES Y VIGAS 0,134 m³/m² | m² | 1285.15 | 80.32 | PRIMER FORJADO (Techo de planta baja) PAREADO TIPO: 7 × 160.60 AISLADA TIPO 1 (VIVIENDA 5): 1 × 81.55 AISLADA TIPO 2 (VIVIENDA 10): 1 × 79.40 |  | FORJADO UNIDIRECCIONAL 30 cm SEMIVIGUETA ARMADA/BOV HORMIGÓN/PILARES Y VIGAS 0,134 m³/m²Estructura de hormigón armado, realizada con hormigón HA-25/F/20/X0 fabricado en central, y vertido con cubilote, con un volumen total de hormigón en forjado y vigas de 0,134 m³/m², y acero, UNE-EN 10080 B 500 S, en zona de paños, vigas y zunchos, cuantía 6,4 kg/m², constituida por: FORJADO UNIDIRECCIONAL: horizontal, de canto 30 cm, intereje de 72 cm; montaje y desmontaje de sistema de encofrado continuo, con acabado tipo industrial para revestir, formado por: superficie encofrante de tableros de madera tratada, reforzados con varillas y perfiles, amortizables en 25 usos, estructura soporte horizontal de sopandas metálicas y accesorios de montaje, amortizables en 150 usos y estructura soporte vertical de puntales metálicos, amortizables en 150 usos; semivigueta armada con zapatilla de hormigón forjado unidireccional; bovedilla de hormigón; capa de compresión de 5 cm de espesor, con armadura de reparto formada por malla electrosoldada ME 20x20 Ø 5-5 B 500 T 6x2,20 UNE-EN 10080; vigas planas/descuelgue; altura libre de planta de entre 3 y 4 m. Incluye pilares de sección rectangular o cuadrada de hormigón armado, realizado con hormigón HA-25/F/20/XC1 fabricado en central, y vertido con cubilote, y acero, UNE-EN 10080 B 500 S, con una cuantía aproximada de 125,1 kg/m³, alambre de atar y separadores. Incluso agente filmógeno, para el curado de hormigones y morteros.Criterio de valoración eco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 | 83.78 € | 107669.87 € | Lo sustituye el módulo: no se pide así
EHU030 | FORJADO UNIDIRECCIONAL 30 cm SEMIVIGUETA ARMADA/BOV HORMIGÓN/PILARES Y VIGAS 0,147 m³/m² | m² | 1091.60 | 68.22 | SEGUNDO FORJADO (Techo de planta primera) PAREADO TIPO: 7 × 135.40 AISLADA TIPO 1 (VIVIENDA 5): 1 × 72.50 AISLADA TIPO 2 (VIVIENDA 10): 1 × 71.30 |  | FORJADO UNIDIRECCIONAL 30 cm SEMIVIGUETA ARMADA/BOV HORMIGÓN/PILARES Y VIGAS 0,147 m³/m²Estructura de hormigón armado, realizada con hormigón HA-25/F/20/X0 fabricado en central, y vertido con cubilote, con un volumen total de hormigón en forjado y vigas de 0,147 m³/m², y acero, UNE-EN 10080 B 500 S, en zona de paños, vigas y zunchos, cuantía 6,9 kg/m², constituida por: FORJADO UNIDIRECCIONAL: horizontal, de canto 30 cm, intereje de 72 cm; montaje y desmontaje de sistema de encofrado continuo, con acabado tipo industrial para revestir, formado por: superficie encofrante de tableros de madera tratada, reforzados con varillas y perfiles, amortizables en 25 usos, estructura soporte horizontal de sopandas metálicas y accesorios de montaje, amortizables en 150 usos y estructura soporte vertical de puntales metálicos, amortizables en 150 usos; semivigueta armada con zapatilla de hormigón forjado unidireccional; bovedilla de hormigón; capa de compresión de 5 cm de espesor, con armadura de reparto formada por malla electrosoldada ME 20x20 Ø 5-5 B 500 T 6x2,20 UNE-EN 10080; vigas planas/descuelgue; altura libre de planta de entre 3 y 4 m. Incluye pilares de sección rectangular o cuadrada de hormigón armado, realizado con hormigón HA-25/F/20/XC1 fabricado en central, y vertido con cubilote, y acero, UNE-EN 10080 B 500 S, con una cuantía aproximada de 125,1 kg/m³, alambre de atar y separadores. Incluso agente filmógeno, para el curado de hormigones y morteros.Criterio de valoración eco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 | 85.14 € | 92938.82 € | Lo sustituye el módulo: no se pide así
EHE010 | LOSA DE ESCALERA h=17 cm | m² | 112.00 | 7.00 | TODA LA OBRA: 16 × 7.00 × 1.00 |  | LOSA DE ESCALERA h=17 cmLosa de escalera de hormigón armado de 17 cm de espesor, con peldañeado de fábrica (no incluido en este precio), realizada con hormigón HA-25/F/20/XC2 fabricado en central, y vertido con cubilote, y acero UNE-EN 10080 B 500 S, con una cuantía aproximada de 20,5 kg/m²; montaje y desmontaje de sistema de encofrado, con acabado tipo industrial para revestir en su cara inferior y laterales, en planta de hasta 3 m de altura libre, formado por: superficie encofrante de tablones de madera de pino, amortizables en 10 usos, estructura soporte horizontal de tablones de madera de pino, amortizables en 10 usos y estructura soporte vertical de puntales metálicos, amortizables en 150 usos. Incluso alambre de atar, separadores y líquido desencofrante, para evitar la adherencia del hormigón al encofrado. | 69.16 € | 7745.92 € | Lo sustituye el módulo: no se pide así
CSL010 | LOSA CIMENTACIÓN C. TÉCNICO PISCINAS | m³ | 21.00 | 1.31 | Base cuarto técnico piscinas: 1 × 21.00 |  | LOSA CIMENTACIÓN C. TÉCNICO PISCINASLosa de cimentación de hormigón armado, realizada con hormigón HA-25/F/20/XC2 fabricado en central, y vertido con bomba, y acero UNE-EN 10080 B 500 S, con una cuantía aproximada de 85 kg/m³; acabado superficial liso mediante regla vibrante. Incluso armaduras para formación de foso de ascensor, refuerzos, pliegues, encuentros, arranques y esperas en muros, escaleras y rampas, cambios de nivel, alambre de atar, y separadores. | 131.67 € | 2765.07 € | Fuera de la vivienda (promotor o Knubo)
EHL010 | LOSA h= 20 cm CASETA APEROS/C TÉCNICO PISCINAS | m² | 34.45 | 2.15 | Forjado caseta aperos: 1 × 13.45 Forjado cuarto técnico piscinas: 1 × 21.00 |  | LOSA h= 20 cm CASETA APEROS/C TÉCNICO PISCINASLosa maciza de hormigón armado, horizontal, con altura libre de planta de hasta 3 m, canto 20 cm, realizada con hormigón HA-25/B/20/IIa fabricado en central, y vertido con cubilote, y acero UNE-EN 10080 B 500 S, con una cuantía aproximada de 25 kg/m²; montaje y desmontaje de sistema de encofrado continuo, con acabado tipo industrial para revestir, formado por: superficie encofrante de tableros de madera tratada, reforzados con varillas y perfiles, amortizables en 25 usos; estructura soporte horizontal de sopandas metálicas y accesorios de montaje, amortizables en 150 usos y estructura soporte vertical de puntales metálicos, amortizables en 150 usos. Incluso nervios y zunchos perimetrales de planta y huecos, alambre de atar, separadores, aplicación de líquido desencofrante y agente filmógeno para el curado de hormigones y morteros. | 136.99 € | 4719.31 € | Fuera de la vivienda (promotor o Knubo)
CCS030b | MURO SÓTANO HORMIGÓN ARMADO/2C 25cm HA-25/F/20/XC2 | m³ | 12.95 | 0.81 | Perímetro cuarto técnico piscinas: 1 × 18.50 × 0.25 × 2.80 |  | MURO SÓTANO HORMIGÓN ARMADO/2C 25cm HA-25/F/20/XC2Muro de sótano de hormigón armado encofrado a 2 caras, realizado con hormigón HA-25/F/20/XC2 fabricado en central, y vertido con bomba, y acero UNE-EN 10080 B 500 S, con una cuantía aproximada de 77,8 kg/m³(incluyendo armadura de pilares a cimentación), ejecutado por bataches, con un grado de complejidad medio, montaje y desmontaje de sistema de encofrado con acabado tipo industrial para revestir, realizado con paneles metálicos modulares, amortizables en 150 usos. Incluso alambre de atar, separadores, pasamuros para paso de los tensores y líquido desencofrante para evitar la adherencia del hormigón al encofrado. Incluso alambre de atar y separadores; cordón de polietileno expandido, para fondo de junta; masilla elastómera tixotrópica, monocomponente, aplicada con pistola desde el fondo de junta hacia fuera; y posterior revestimiento con mortero tixotrópico monocomponente, para sellado impermeabilizante de los huecos pasamuros para paso de los tensores del encofrado.Criterio de valoración económica: El precio incluye la elaboración y el montaje de la ferralla en el lugar definitivo de su colocación en obra, así como el encofrado.Incluye: Colocación de la armadura con separadores homologados. Resolución de juntas de construcción. Limpieza de la base de apoyo del muro en la cimentación. Vertido y compactación del hormigón. Curado del hormigón. Extracción de los pasamuros. Sellado de los huecos pasamuros. Reparación de defectos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 | 334.80 € | 4335.66 € | Fuera de la vivienda (promotor o Knubo)
D04PS155 | SOLERA HA-25 2#200x200x5 20 cm+ENCACHADO+PVC | m² | 559.45 | 34.97 | PORCHE JARDÍN (pérgola posterior) PAREADO TIPO: 14 × 23.55 AISLADA TIPO 1 (VIVIENDA 5): 1 × 24.70 AISLADA TIPO 2 (VIVIENDA 10): 1 × 22.55 ZONA COMÚN Piscina adultos: 1 × 142.25 Piscina chapoteo: 1 × 40.25 | Medidas: 200x200x5mm | SOLERA HA-25 2#200x200x5 20 cm+ENCACHADO+PVCSolera de 20 cm de espesor, realizada con hormigón HA-25/F/20/XC2 N/mm², tamaño máximo del árido 20 mm elaborado en central, i/vertido, colocación y armado con doble mallazo electrosoldado #200x200x5 mm, incluso p.p. de juntas, aserrado de las mismas, fratasado y encachado de piedra caliza 40/80 de 20 cm de espesor, extendido y compactado con pisón, con lámina intermedia de PVC Danopol HS de 1,5 mm. Según Codigo Estructural. | 26.81 € | 14998.85 € | Fuera de la vivienda (promotor o Knubo)
 | Total del capítulo (PEM del proyecto) |  |  |  |  |  |  |  | 371011.56 €

Sheet: 05 Cubiertas
Névola · Cubiertas · 16 viviendas
Capítulo C.05 del proyecto de ejecución (BC3 de julio de 2026). Medición de toda la promoción y su desglose tal como viene en el proyecto. Precios del proyecto (CYPE, PEM, sin IVA), solo como referencia.
Código | Partida | Ud | Total 16 viv. | Media por vivienda | Desglose de la medición (proyecto) | Datos clave (medidas, color, marca) | Descripción completa del proyecto | Precio proyecto | Importe PEM | Alcance en el sistema modular
D08PD002 | CUBIERTA PLANA NO TRANSITABLE/GRAVA | m² | 1195.45 | 74.72 | CUBIERTAS PAREADOS: 7 × 147.50 AISLADA TIPO 1 (VIVIENDA 5): 1 × 76.35 AISLADA TIPO 2 (VIVIENDA 10): 1 × 75.40 CASETA APEROS: 1 × 11.20 | Medidas: 1250x600mm | CUBIERTA PLANA NO TRANSITABLE/GRAVACubierta invertida no transitable no ventilada acabada en grava u hormigon regleado, para zonas climáticas D/E, constituida por:1) Barrera de vapor encima de forjado con lámina de LDPE (film de polietileno baja densidad), VAPOR FLAG de SOPREMA2) Capa de hormigón celular de 8 cm de espesor medio, para formación de pendientes (mínima 2%), con tendido de regularización con mortero de cemento M5 de 2 cm de espesor. 3) Membrana impermeabilizante bicapa ADHERIDA al soporte formada por emulsión asfáltica EMUFAL PRIMER con una dotación > 300 g/m², LBM plastomérico APP con armadura de fieltro de fibra de vidrio (FV) con una flexibilidad a bajas tª = -15ºC tipo MORTERPLAS FV 3 kg designación: LBM-30-FV según UNE 104410:2013, lámina superior totalmente adherida a la inferior lámina de betún modificado plastomérico APP con armadura de fieltro de fibra de poliester (FP) con una flexibilidad a bajas tª = -15ºC tipo SOPRALENE ELITE FP 4 kg designación: LBM-40 FP según UNE 104410:2013. 4) Capa separadora de geotextil no tejido de alta tenacidad a base de polipropileno termosoldado con resistencia a la tracción de 6,5 kN/m y de resistencia al punzonamiento estático (CBR) de 1100 N con un gramage de 90 g/m² TEXXAM 700. 5) Capa de aislamiento térmico formada por planchas de poliestireno extruido de dimensiones 1250x600 mm con juntas a media madera de resistencia a la compresión de 300 KPa, conductividad térmica Lambda 0,036 W/mºK y de espesor 100 mm tipo XPS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 | 88.80 € | 106155.96 € | Lo sustituye el módulo: no se pide así
QAB010b | CUBIERTA PLANA TRANSITABLE/SOLADO FIJO | m² | 143.10 | 8.94 | TERRAZAS P PRIMERA PAREADOS: 14 × 9.00 AISLADA TIPO 1 (VIVIENDA 5): 1 × 9.00 AISLADA TIPO 2 (VIVIENDA 10): 1 × 8.10 | Medidas: 1250x600mm · Color: gris | CUBIERTA PLANA TRANSITABLE/SOLADO FIJOCubierta invertida no transitable no ventilada acabada en grava u hormigon regleado, para zonas climáticas D/E, constituida por:1) Barrera de vapor encima de forjado con lámina de LDPE (film de polietileno baja densidad), VAPOR FLAG de SOPREMA2) Capa de aislamiento térmico formada por planchas de poliestireno extruido de dimensiones 1250x600 mm con juntas a media madera de resistencia a la compresión de 300 KPa, conductividad térmica Lambda 0,036 W/mºK y de espesor 100 mm tipo XPS SL 100 instalada encajando las juntas a media madera para evitar puentes térmicos. Cumple para las zonas climáticas D/E.(NO INCLUIDO EN ESTE PRECIO) 3) Capa de hormigón celular de 8 cm de espesor medio, para formación de pendientes (mínima 2%), con tendido de regularización con mortero de cemento M5 de 2 cm de espesor. 4) Capa separadora de geotextil no tejido de alta tenacidad a base de polipropileno termosoldado con resistencia a la tracción de 6,5 kN/m y de resistencia al punzonamiento estático (CBR) de 1100 N con un gramage de 90 g/m² TEXXAM 700. 5) Impermeabilización bajo revestimiento cerámico o pétreo, en paramento horizontal en terrazas, con lámina impermeabilizante flexible de polietileno, con ambas caras revestidas de geotextil no tejido, kerdi o similar, de 0,5 mm de espesor y 285 g/m², fijada al soporte con adhesivo cementoso mejorado, C2 TE S1, según UNE-EN 12004, deformable, con deslizamiento reducido y tiempo abierto ampliado, color gris, a base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 | 97.54 € | 13957.97 € | Lo sustituye el módulo: no se pide así
QAB010bb | CUBIERTA PLANA TRANSITABLE/SOLADO FIJO | m² | 21.00 | 1.31 | C TÉCNICO PISCINAS: 1 × 21.00 | Color: gris | CUBIERTA PLANA TRANSITABLE/SOLADO FIJOCubierta invertida no transitable no ventilada acabada en grava u hormigon regleado, para zonas climáticas D/E, constituida por:1) Barrera de vapor encima de forjado con lámina de LDPE (film de polietileno baja densidad), VAPOR FLAG de SOPREMA 2) Capa de hormigón celular de 8 cm de espesor medio, para formación de pendientes (mínima 2%), con tendido de regularización con mortero de cemento M5 de 2 cm de espesor. 3) Capa separadora de geotextil no tejido de alta tenacidad a base de polipropileno termosoldado con resistencia a la tracción de 6,5 kN/m y de resistencia al punzonamiento estático (CBR) de 1100 N con un gramage de 90 g/m² TEXXAM 700. 4) Impermeabilización bajo revestimiento cerámico o pétreo, en paramento horizontal en terrazas, con lámina impermeabilizante flexible de polietileno, con ambas caras revestidas de geotextil no tejido, kerdi o similar, de 0,5 mm de espesor y 285 g/m², fijada al soporte con adhesivo cementoso mejorado, C2 TE S1, según UNE-EN 12004, deformable, con deslizamiento reducido y tiempo abierto ampliado, color gris, a base de cemento, áridos de granulometría fina, resinas sintéticas y aditivos especiales. Incluso complementos de refuerzo en tratamiento de puntos singulares con banda de refuerzo de polietileno, con ambas caras revestidas de geotextil no tejido, de 120 mm de anchura y de 0,7 mm de espesor; y mortero cementoso impermeabilizante flexible bicomponente, de color gris.5) Capa de protección: baldo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 | 81.52 € | 1711.92 € | Lo sustituye el módulo: no se pide así
 | Total del capítulo (PEM del proyecto) |  |  |  |  |  |  |  | 121825.85 €

Sheet: 06 Albañilería
Névola · Albañilería · 16 viviendas
Capítulo C.06 del proyecto de ejecución (BC3 de julio de 2026). Medición de toda la promoción y su desglose tal como viene en el proyecto. Precios del proyecto (CYPE, PEM, sin IVA), solo como referencia.
Código | Partida | Ud | Total 16 viv. | Media por vivienda | Desglose de la medición (proyecto) | Datos clave (medidas, color, marca) | Descripción completa del proyecto | Precio proyecto | Importe PEM | Alcance en el sistema modular
504 | HOJA EXTERIOR DE FACHADA, 1/2 PIE, DE LADRILLO CERÁMICO PERFORADO TOSCO | m² | 3070.32 | 191.90 | PAREADO TIPO Planta baja: 14 × 27.50 × 3.25 Planta primera: 14 × 27.00 × 3.15 Separación viviendas planta baja: 7 × 9.50 × 2.95 Separación viviendas planta primera: 7 × 10.10 × 2.85 -A descontar > 4.00 m² PE2: -14 × 2.80 × 2.20 PE3: -14 × 1.90 × 2.20 PE4: -14 × 2.80 × 2.10 AISLADO TIPO 1 (VIVIENDA 5) Planta baja: 1 × 37.25 × 3.25 Planta primera: 1 × 38.05 × 3.15 -A descontar > 4.00 m² PE2: -1 × 2.80 × 2.20 PE3: -1 × 1.90 × 2.20 PE4: -1 × 2.80 × 2.10 AISLADO TIPO 2 (VIVIENDA 10) Planta baja: 1 × 37.75 × 3.25 Planta primera: 1 × 37.65 × 3.15 -A descontar > 4.00 m² PE2: -1 × 2.80 × 2.20 PE3: -1 × 1.90 × 2.20 PE4: -1 × 2.80 × 2.10 Separación productos químicos piscina: 1 × 3.20 × 2.50 | Medidas: 24x11x5cm · Color: gris | HOJA EXTERIOR DE FACHADA, 1/2 PIE, DE LADRILLO CERÁMICO PERFORADO TOSCOEjecución de hoja exterior de 11 cm de espesor de fábrica, en cerramiento de fachada, de ladrillo cerámico perforado (tosco), para revestir, 24x11x5 cm, recibida con mortero de cemento industrial, color gris, M-5, suministrado a granel. Incluso p/p de replanteo, nivelación y aplomado, mermas y roturas, enjarjes, revestimiento de los frentes de forjado con piezas cerámicas, colocadas con mortero de alta adherencia, formación de dinteles mediante vigueta prefabricada T-18, revestida con piezas cerámicas, colocadas con mortero de alta adherencia, jambas y mochetas, ejecución de encuentros y puntos singulares y limpieza. | 23.49 € | 72121.82 € | Lo sustituye el módulo: no se pide así
504b | HOJA EXTERIOR DE FACHADA, 1 PIE, DE LADRILLO CERÁMICO PERFORADO TOSCO | m² | 306.38 | 19.15 | PETOS PAREADO TIPO Petos cubierta: 7 × 54.00 × 0.60 Petos terraza: 14 × 7.15 × 0.30 AISLADO TIPO 1 (VIVIENDA 5) Petos cubierta: 1 × 38.05 × 0.60 Petos terraza: 1 × 7.15 × 0.30 AISLADO TIPO 2 (VIVIENDA 10) Petos cubierta: 1 × 37.65 × 0.60 Petos terraza: 1 × 6.60 × 0.30 | Medidas: 24x11x5cm · Color: gris | HOJA EXTERIOR DE FACHADA, 1 PIE, DE LADRILLO CERÁMICO PERFORADO TOSCOEjecución de hoja exterior de 24 cm de espesor de fábrica, en cerramiento de fachada, de ladrillo cerámico perforado (tosco), para revestir, 24x11x5 cm, recibida con mortero de cemento industrial, color gris, M-5, suministrado a granel. Incluso p/p de replanteo, nivelación y aplomado, mermas y roturas, enjarjes, revestimiento de los frentes de forjado con piezas cerámicas, colocadas con mortero de alta adherencia, formación de dinteles mediante vigueta prefabricada T-18, revestida con piezas cerámicas, colocadas con mortero de alta adherencia, jambas y mochetas, ejecución de encuentros y puntos singulares y limpieza. | 34.06 € | 10435.30 € | Lo sustituye el módulo: no se pide así
312 | DINTEL VIGUETA T-18 | m | 358.00 | 22.38 | PAREADO TIPO PE1: 14 × 1.00 × 2.00 PE2: 14 × 1.00 × 3.30 PE3: 14 × 1.00 × 2.40 PE4: 14 × 1.00 × 3.30 V1: 14 × 1.00 × 1.20 V2: 14 × 1.00 × 1.35 V3: 14 × 2.00 × 2.00 V4: 14 × 1.00 × 2.00 V5: 14 × 1.00 × 1.20 V6: 14 × 1.00 × 1.20 AISLADAS (VIVIENDA 5-10) PE1: 2 × 1.00 × 2.00 PE2: 2 × 1.00 × 3.30 PE3: 2 × 1.00 × 2.40 PE4: 2 × 1.00 × 3.30 V1: 2 × 1.00 × 1.20 V2: 2 × 1.00 × 1.35 V3: 2 × 2.00 × 2.00 V4: 2 × 1.00 × 2.00 V5: 2 × 1.00 × 1.20 V6: 2 × 1.00 × 1.20 V7: 2 × 1.00 × 1.25 F1: 2 × 1.00 × 1.40 PUERTA APEROS: 1 × 1.00 × 1.50 |  | DINTEL VIGUETA T-18Vigueta autorresistente de hormigón pretensado T-18 de hasta 4,00 m de longitud, apoyada sobre capa de mortero de cemento, industrial, M-7,5, de 2 cm de espesor, con revestimiento de ladrillo cerámico en ambas caras; para la formación de dintel en hueco de muro de fábrica. Incluso p/p de replanteo, nivelación y aplomado, y limpieza. | 15.55 € | 5566.90 € | Lo sustituye el módulo: no se pide así
505 | ENFOSCADO DE CEMENTO | m² | 3973.66 | 248.35 | -CÁMARAS PAREADO TIPO Planta baja: 14 × 27.50 × 3.25 Planta primera: 14 × 27.00 × 3.15 Separación viviendas planta baja: 14 × 9.50 × 2.95 Separación viviendas planta primera: 14 × 10.10 × 2.85 -A descontar > 4.00 m² PE2: -14 × 2.80 × 2.20 PE3: -14 × 1.90 × 2.20 PE4: -14 × 2.80 × 2.10 AISLADO TIPO 1 (VIVIENDA 5) Planta baja: 1 × 37.25 × 3.25 Planta primera: 1 × 38.05 × 3.15 -A descontar > 4.00 m² PE2: -1 × 2.80 × 2.20 PE3: -1 × 1.90 × 2.20 PE4: -1 × 2.80 × 2.10 AISLADO TIPO 2 (VIVIENDA 10) Planta baja: 1 × 37.75 × 3.25 Planta primera: 1 × 37.65 × 3.15 -A descontar > 4.00 m² PE2: -1 × 2.80 × 2.20 PE3: -1 × 1.90 × 2.20 PE4: -1 × 2.80 × 2.10 APLACADO FACHADAS PAREADO TIPO Fachada principal: 14 × 17.50 Fachada posterior: 14 × 3.80 Fachada lateral: 14 × 2.25 Rodapié fachada p baja: 14 × 28.10 × 0.20 Rodapié fachada terraza p primera: 14 × 7.15 × 0.20 AISLADA TIPO 1 (VIVIENDA 5) Fachada principal: 1 × 16.40 Fachada posterior: 1 × 3.80 Fachada lateral derecha: 1 × 2.25 Fachada lateral izquierda: 1 × 2.25 Rodapié fachada p baja: 1 × 41.10 × 0.20 Rodapié fachada terraza p primera: 1 × 7.15 × 0.20 AISLADA TIPO 2 (VIVIENDA 10) Fachada principal: 1 × 16.40 Fachada posterior: 1 × 4.40 Fachada lateral derecha: 1 × 2.25 Fachada lateral izquierda: 1 × 2.25 Rodapié fachada p baja: 1 × 41.55 × 0.20 Rodapié fachada terraza p primera: 1 × 6.60 × 0.20 Separación cuarto productos químicos: 2 × 3.20 × 2.50 |  | ENFOSCADO DE CEMENTO Formación de revestimiento continuo de mortero de cemento, tipo GP CSIII W1, a buena vista, de 15 mm de espesor, aplicado sobre un paramento vertical interior, en el trasdós de la hoja exterior de fachada con cámara de aire, hasta 3 m de altura, acabado superficial rugoso. Incluso p/p de preparación de la superficie soporte, formación de juntas, rincones, maestras con separación entre ellas no superior a tres metros, remates en los encuentros con paramentos, revestimientos u otros elementos recibidos en su superficie. | 7.47 € | 29683.24 € | Lo sustituye el módulo: no se pide así
RQO020 | MORTERO MONOCAPA | m² | 3642.26 | 227.64 | PAREADO TIPO Planta baja: 14 × 27.50 × 3.25 Planta primera: 14 × 27.00 × 3.15 Petos cubierta (int y ext): 7 × 54.00 × 2.00 × 0.60 Petos terraza (int y ext): 14 × 7.15 × 2.00 × 0.30 -A descontar > 4.00 m² (aplacados + huecos) Fachada principal: -14 × 22.55 Fachada posterior: -14 × 12.30 AISLADO TIPO 1 (VIVIENDA 5) Planta baja: 1 × 37.25 × 3.25 Planta primera: 1 × 38.05 × 3.15 Petos cubierta (int y ext): 1 × 38.05 × 2.00 × 0.60 Petos terraza (int y ext): 1 × 7.15 × 2.00 × 0.30 -A descontar > 4.00 m² (aplacados + huecos) Fachada principal: -1 × 22.55 Fachada posterior: -1 × 12.30 AISLADO TIPO 2 (VIVIENDA 10) Planta baja: 1 × 37.75 × 3.25 Planta primera: 1 × 37.65 × 3.15 Petos cubierta (int y ext): 1 × 37.65 × 2.00 × 0.60 Petos terraza (int y ext): 1 × 6.60 × 2.00 × 0.30 -A descontar > 4.00 m² (aplacados + huecos) Fachada principal: -1 × 22.55 Fachada posterior: -1 × 16.20 VALLADOS (a calle y separación pareados) VIV 1: 2 × 4.60 × 2.00 1 × 6.15 × 1.00 VIV 2: 2 × 3.60 × 2.00 1 × 8.45 × 1.00 VIV 3: 2 × 3.60 × 2.00 1 × 9.50 × 1.00 VIV 4: 2 × 3.90 × 2.00 1 × 8.05 × 1.00 VIV 5: 2 × 3.00 × 2.00 1 × 8.20 × 1.00 VIV 6: 2 × 3.00 × 2.00 1 × 8.10 × 1.00 VIV 7: 2 × 4.60 × 2.00 1 × 9.75 × 1.00 VIV 8: 2 × 3.90 × 2.00 1 × 27.25 × 1.00 VIV 9: 2 × 3.60 × 2.00 1 × 5.60 × 1.00 VIV 10: 2 × 3.20 × 2.00 1 × 6.90 × 1.00 VIV 11: 2 × 3.20 × 2.00 1 × 6.40 × 1.00 VIV 12: 2 × 3.90 × 2.00 1 × 23.40 × 1.00 VIV 13: 2 × 3.65 × 2.00 1 × 6.50 × 1.00 VIV 14: 2 × 3.60 × 2.00 1 × 6.60 × 1.00 VIV 15: 2 × 3.60 × 2.0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 | Color: Blanco | MORTERO MONOCAPAFormación en fachadas de revestimiento continuo de 12 mm de espesor, impermeable al agua de lluvia, con mortero monocapa hidrófobo de red tridimensional, para la impermeabilización y decoración de fachadas, tipo OC CSIII W2, según UNE-EN 998-1, acabado raspado, color Blanco, compuesto de cemento y cargas minerales, aditivado en masa con polímeros. Aplicado manualmente sobre una superficie de ladrillo cerámico, ladrillo o bloque de hormigón o bloque de termoarcilla. Incluso p/p de preparación de la superficie soporte, colocación de malla de fibra de vidrio antiálcalis para refuerzo de encuentros entre materiales diferentes y en los frentes de forjado, en un 20% de la superficie del paramento, formación de juntas, rincones, maestras, aristas, mochetas, jambas y dinteles y remates en los encuentros con paramentos, revestimientos u otros elementos recibidos en su superficie.Incluye: Preparación de la superficie soporte. Despiece de los paños de trabajo. Aristado y realización de juntas. Colocación de malla para armar mortero. Preparación del mortero monocapa. Aplicación del mortero monocapa. Regleado y alisado del revestimiento. Acabado superficial. Repasos y limpieza final.Criterio de medición de proyecto: Superficie medida según documentación gráfica de Proyecto, deduciendo los huecos de superficie mayor de 3 m² e incluyendo el desarrollo de las mochetas.Criterio de medición de obra: Se medirá la superficie realmente ejecutada según especificaciones de Proyect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 | 22.36 € | 81440.93 € | Lo sustituye el módulo: no se pide así
HYO020 | PELDAÑEADO ESCALERAS | m | 336.00 | 21.00 | ESCALERAS INTERIORES TODA LA OBRA: 16 × 21.00 × 1.00 |  | PELDAÑEADO ESCALERASFormación de peldañeado de escalera con ladrillo cerámico hueco recibido con mortero de cemento, industrial, M-5, sobre la losa o bóveda de escalera, como base para la posterior colocación del acabado de peldaños. | 16.10 € | 5409.60 € | Lo sustituye el módulo: no se pide así
HEC030 | PREMARCOS CARPINTERÍA INTERIOR | Ud | 128.00 | 8.00 | Carpintería interior (TODA LA OBRA): 16 × 8.00 |  | PREMARCOS CARPINTERÍA INTERIORSuministro, colocación y fijación de precerco de madera de pino, durante la ejecución del tabique y antes de colocar el pavimento, con tornillería al entramado autoportante del tabique de placas, para fijar posteriormente, sobre él, el marco de la carpintería de hasta 2 m² de superficie. | 4.26 € | 545.28 € | Lo sustituye el módulo: no se pide así
HEC010 | PREMARCOS CARPINTERÍA EXTERIOR | Ud | 181.00 | 11.31 | PAREADO TIPO: 14 × 11.00 AISLADA TIPO 1(VIVIENDA 5): 1 × 13.00 AISLADA TIPO 2(VIVIENDA 10): 1 × 13.00 CASETA APEROS: 1 × 1.00 | Medidas: 50x20x1,5mm | PREMARCOS CARPINTERÍA EXTERIORSuministro, colocación y fijación de premarco de aluminio, de 50x20x1,5 mm, ensamblado mediante escuadras y con tornillos de fijación, para fijar posteriormente, sobre él, el marco de la carpintería exterior hasta 6 m² de superficie. | 13.61 € | 2463.41 € | Lo sustituye el módulo: no se pide así
518 | FORRADO CHIMENEAS | Ud | 16.00 | 1.00 | Chimeneas: 16 |  | FORRADO CHIMENEASFormación de fábrica de ladrillo cerámico perforado tosco, de hasta 0,65 m² de sección y 1,5 m de altura dimensiones máximas, recibida con mortero de cemento, industrial, M-5, para forrado de conductos de instalaciones situados en cubierta plana/inclinada. Incluso p/p de mermas y roturas, enjarjes y ejecución de encuentros y puntos singulares. | 380.06 € | 6080.96 € | Lo sustituye el módulo: no se pide así
519 | AYUDA ALBAÑILERÍA FONTANERÍA VIV.UNIFAMILIAR | Ud | 16.00 | 1.00 | 16 |  | AYUDA ALBAÑILERÍA FONTANERÍA VIV.UNIFAMILIARAyuda, por vivienda unifamiliar, de cualquier trabajo de albañilería, prestada para la correcta ejecución de las instalaciones de fontanería, i/porcentaje estimado para pequeño material, medios auxiliares. | 491.33 € | 7861.28 € | Lo sustituye el módulo: no se pide así
520 | AYUDA ALBAÑILERÍA ELECTRICIDAD VIV.UNIFAMILIAR | Ud | 16.00 | 1.00 | 16 |  | AYUDA ALBAÑILERÍA ELECTRICIDAD VIV.UNIFAMILIARAyuda, por vivienda unifamiliar, de cualquier trabajo de albañilería, prestada para la correcta ejecución de las instalaciones de electricidad, i/porcentaje estimado para pequeño material, medios auxiliares. | 491.33 € | 7861.28 € | Lo sustituye el módulo: no se pide así
521 | AYUDA ALBAÑILERÍA CALEFACCIÓN VIV.UNIFAMILIAR | Ud | 16.00 | 1.00 | 16 |  | AYUDA ALBAÑILERÍA CALEFACCIÓN VIV.UNIFAMILIARAyuda, por vivienda unifamiliar, de cualquier trabajo de albañilería, necesaria para la correcta ejecución de las instalaciones de climatización, i/porcentaje estimado para pequeño material, medios auxiliares. | 491.33 € | 7861.28 € | Lo sustituye el módulo: no se pide así
 | Total del capítulo (PEM del proyecto) |  |  |  |  |  |  |  | 237331.28 €

Sheet: 07 Impermeabilización y aislami
Névola · Impermeabilización y aislamiento · 16 viviendas
Capítulo C.07 del proyecto de ejecución (BC3 de julio de 2026). Medición de toda la promoción y su desglose tal como viene en el proyecto. Precios del proyecto (CYPE, PEM, sin IVA), solo como referencia.
Código | Partida | Ud | Total 16 viv. | Media por vivienda | Desglose de la medición (proyecto) | Datos clave (medidas, color, marca) | Descripción completa del proyecto | Precio proyecto | Importe PEM | Alcance en el sistema modular
NHB020 | BARRERA ANTICAPILARIDAD | m | 525.50 | 32.84 | ARRANQUE MUROS DE FÁBRICA PAREADO TIPO: 7 × 64.35 AISLADA TIPO 1 (VIVIENDA 5): 1 × 37.30 AISLADA TIPO 2 (VIVIENDA 10): 1 × 37.75 |  | BARRERA ANTICAPILARIDADBarrera anticapilaridad en arranque de muro de fábrica, de 25 cm de espesor, con lámina impermeabilizante autoadhesiva de betún modificado con elastómero (SBS), LBA-15-PE, con armadura de film de polietileno de 95 g/m² que actúa como autoprotección superior y plástico desechable siliconado en la cara inferior, de superficie no protegida, colocada con solapes sobre una capa de regularización de mortero de cemento, industrial, con aditivo hidrófugo, M-5, previa imprimación con emulsión asfáltica de base acuosa y posterior aplicación de capa de protección de mortero de cemento, industrial, con aditivo hidrófugo, M-5. | 9.92 € | 5212.96 € | Fuera de la vivienda (promotor o Knubo)
2000b | IMPERMEABILIZACIÓN SUMIDEROS CUBIERTA NO TRANSITABLE | Ud | 33.00 | 2.06 | CUBIERTAS (Viviendas): 16 × 2.00 CASETA APEROS: 1 × 1.00 |  | IMPERMEABILIZACIÓN SUMIDEROS CUBIERTA NO TRANSITABLEEjecución de encuentro de cubierta plana no transitable, no ventilada, con grava, tipo convencional con sumidero de salida vertical, realizando un rebaje en el soporte alrededor del sumidero, en el que se recibirá la impermeabilización formada por: pieza de refuerzo de lámina de betún modificado con elastómero SBS, LBM(SBS)-40-FP, con armadura de fieltro de poliéster no tejido de 160 g/m², de superficie no protegida, totalmente adherida al soporte con soplete, previa imprimación con emulsión asfáltica aniónica con cargas tipo EB, y colocación de sumidero de caucho EPDM, de salida vertical, de 90 mm de diámetro, con rejilla alta de polietileno, íntegramente adherido a la pieza de refuerzo anterior con soplete. | 37.44 € | 1235.52 € | Lo sustituye el módulo: no se pide así
QAF030 | IMPERMEABILIZACIÓN SUMIDEROS CUBIERTA TRANSITABLE | Ud | 32.00 | 2.00 | TERRAZAS P PRIMERA (Toda la Obra): 16 × 2.00 |  | IMPERMEABILIZACIÓN SUMIDEROS CUBIERTA TRANSITABLEEjecución de encuentro de cubierta plana transitable, no ventilada, con solado fijo, tipo convencional con sumidero de salida vertical, realizando un rebaje en el soporte alrededor del sumidero, en el que se recibirá la impermeabilización formada por: pieza de refuerzo de lámina de betún modificado con elastómero SBS, LBM(SBS)-40-FP, con armadura de fieltro de poliéster no tejido de 160 g/m², de superficie no protegida, totalmente adherida al soporte con soplete, previa imprimación con emulsión asfáltica aniónica con cargas tipo EB, y colocación de sumidero de caucho EPDM, de salida vertical, de 80 mm de diámetro, con rejilla plana de caucho EPDM, íntegramente adherido a la pieza de refuerzo anterior con soplete. | 34.83 € | 1114.56 € | Lo sustituye el módulo: no se pide así
QAF020 | ENCUENTRO PETO/CUBIERTA NO TRANSITABLE | m | 467.15 | 29.20 | CUBIERTAS PAREADO TIPO: 7 × 54.00 AISLADA TIPO 1 (VIVIENDA 5): 1 × 38.05 AISLADA TIPO 2 (VIVIENDA 5): 1 × 37.65 CASETA APEROS: 1 × 13.45 |  | ENCUENTRO PETO/CUBIERTA NO TRANSITABLEEncuentro de paramento vertical con cubierta plana no transitable, no ventilada, con grava, tipo convencional; mediante retranqueo perimetral, para la protección de la impermeabilización formada por: banda de refuerzo de 50 cm de anchura, de lámina de betún modificado con elastómero SBS, LBM(SBS)-40-FP, totalmente adherida al soporte con soplete, previa imprimación con emulsión asfáltica aniónica con cargas tipo EB y banda de terminación de 50 cm de desarrollo con lámina de betún modificado con elastómero SBS, LBM(SBS)-40-FP; acabado con mortero de cemento M-2,5. | 11.92 € | 5568.43 € | Lo sustituye el módulo: no se pide así
QAF020b | ENCUENTRO PETO/CUBIERTA TRANSITABLE | m | 226.95 | 14.18 | TERRAZAS (incluido en cubierta transitable) PAREADO TIPO: 14 × 14.25 AISLADA TIPO 1 (VIVIENDA 5): 1 × 14.25 AISLADA TIPO 2 (VIVIENDA 10): 1 × 13.20 |  | ENCUENTRO PETO/CUBIERTA TRANSITABLEEncuentro de paramento vertical con cubierta plana transitable, no ventilada, con solado fijo, tipo convencional; mediante retranqueo perimetral, para la protección de la impermeabilización formada por: banda de refuerzo de 50 cm de anchura, de lámina de betún modificado con elastómero SBS, LBM(SBS)-40-FP, totalmente adherida al soporte con soplete, previa imprimación con emulsión asfáltica aniónica con cargas tipo EB y banda de terminación de 50 cm de desarrollo con lámina de betún modificado con elastómero SBS, LBM(SBS)-40-FP; acabado con mortero de cemento M-2,5 y rodapié (no incluido en este precio). | 11.92 € | 2705.24 € | Lo sustituye el módulo: no se pide así
403 | IMP.MUROS LÁM.ASFÁLT.+LAM.DREN. | m² | 64.40 | 4.03 | Cuarto técnico piscinas: 1 × 18.40 × 3.50 |  | IMP.MUROS LÁM.ASFÁLT.+LAM.DREN.Impermeabilización de muros de cimentación por su cara externa, constituida por: imprimación asfáltica, Impridan 100; banda de refuerzo Esterdan 30 P elastómero; lámina asfáltica de betún elastómero Esterdan 30 P elastómero, (tipo LMB-30-FP) de poliéster (fieltro no tejido de 160 gr/m2), totalmente adherida al muro con soplete; geotextil y para protección, lámina drenante nodular de polietileno de alta densidad (PEAD/HDPE), con nódulos de 8 mm de altura, resistencia a la compresión 150 kN/m² según UNE-EN ISO 604, capacidad de drenaje 5 l/(s·m) y masa nominal 0,5 kg/m²; sujeta al paramento vertical mediante fijaciones mecánicas (2 ud/m²), con los nódulos contra el muro previamente impermeabilizado. Incluso p/p de limpieza y preparación de la superficie, solapes horizontales y verticales, remates de esquinas y rincones y colocación de perfil metálico de remate superior (0,3 m/m²). | 14.90 € | 959.56 € | Fuera de la vivienda (promotor o Knubo)
NIH010 | IMPERMEABILIZACIÓN LOCALES HÚMEDOS/HUECOS EXTERIORES | m² | 367.65 | 22.98 | DUCHAS (TODA LA OBRA) Baño 1: 16 × 7.40 Baño principal: 16 × 8.00 HUECOS EXTERIORES (TODA LA OBRA) PE2: 16 × 1.00 × 2.80 × 0.50 PE3: 16 × 1.00 × 1.90 × 0.50 PE4: 16 × 1.00 × 2.80 × 0.50 V1: 16 × 1.00 × 0.70 × 0.50 V2: 16 × 1.00 × 0.85 × 0.50 V3: 16 × 2.00 × 1.50 × 0.50 V4: 16 × 1.00 × 1.50 × 0.50 V5: 16 × 1.00 × 0.70 × 0.50 V6: 16 × 1.00 × 0.70 × 0.50 V7: 2 × 1.00 × 0.75 × 0.50 F1: 2 × 1.00 × 0.90 × 0.50 | Color: gris | MPERMEABILIZACIÓN LOCALES HÚMEDOS/HUECOS EXTERIORESImpermeabilización bajo revestimiento cerámico o pétreo, en paramentos verticales y horizontales de locales húmedos, con lámina impermeabilizante flexible de polietileno, con ambas caras revestidas de geotextil no tejido, kerdi o similar, de 0,5 mm de espesor y 285 g/m², fijada al soporte con adhesivo cementoso mejorado, C2 TE S1, según UNE-EN 12004, deformable, con deslizamiento reducido y tiempo abierto ampliado, color gris, a base de cemento, áridos de granulometría fina, resinas sintéticas y aditivos especiales. Incluso complementos de refuerzo en tratamiento de puntos singulares con banda de refuerzo de polietileno, con ambas caras revestidas de geotextil no tejido, de 120 mm de anchura y de 0,7 mm de espesor; y mortero cementoso impermeabilizante flexible bicomponente, de color gris. | 24.94 € | 9169.19 € | Se pide igual (fábrica u obra)
D16ATA015 | AISL FRENTES FORJAD PINTURA TERMOAISLANTE TECNOL TQ-I-TERMIC | m² | 696.40 | 43.52 | Tratamiento puente térmico de los forjados PRIMER FORJADO PAREADO TIPO: 7 × 53.25 × 0.80 AISLADA TIPO 1 (VIVIENDA 5): 1 × 37.30 × 0.80 AISLADA TIPO 2 (VIVIENDA 10): 1 × 36.80 × 0.80 SEGUNDO FORJADO PAREADO TIPO: 7 × 49.95 × 0.80 AISLADA TIPO 1 (VIVIENDA 5): 1 × 37.20 × 0.80 AISLADA TIPO 2 (VIVIENDA 10): 1 × 36.80 × 0.80 |  | AISL FRENTES FORJAD PINTURA TERMOAISLANTE TECNOL TQ-I-TERMICImprimación de lámina acrílica impermeabilizante con propiedades termoacústicas para rotura de puentes térmicos en pilares integrados en fachada (aislados por su cara exterior), tipo I-Termic de Tecnol o similar con microburbujas de vidrio con una conductividad térmica de 0,17 W/m*K. Se aplicará con brocha y rodillo en varias capas según prestaciones deseadas, consumo aproximado de 200 a 250 gr por capa según absorción del soporte. Incluso p.p. de medios auxiliares y limpieza, totalmente terminado. Adecuado principalmente para colocar posteriormente aplacados que no necesiten estar pegados al aislamiento ( cerámica, ladrillos...). Cumpliendo CTE DB HE 1 y apartado 4.6 CEC puentes térmicos. | 7.03 € | 4895.69 € | Lo sustituye el módulo: no se pide así
D16ATA025 | AISL. PILARES AISLAMIENTO REFLEX. AIR BUR TERMIC S ADHESIVO | m² | 684.00 | 42.75 | Tratamiento puente termico en los pilares PAREADO TIPO PLANTA BAJA: 7 × 14.00 × 1.00 × 3.60 PLANTA SEGUNDA: 7 × 10.00 × 1.00 × 2.80 AISLADA TIPO 1 (VIVIENDA 5) PLANTA BAJA: 1 × 11.00 × 1.00 × 3.60 PLANTA SEGUNDA: 1 × 10.00 × 1.00 × 2.80 AISLADA TIPO 2 (VIVIENDA 10) PLANTA BAJA: 1 × 11.00 × 1.00 × 3.60 PLANTA SEGUNDA: 1 × 10.00 × 1.00 × 2.80 |  | AISL. PILARES AISLAMIENTO REFLEX. AIR BUR TERMIC S ADHESIVOAislamiento térmico reflectivo para rotura de puente térmico de pilares integrados en fachada (aislamiento por su cara exterior), Air Bur Termic S o similar, formado por una lámina de aluminio puro, una burbuja de aire seco y film adhesivo para su instalación, con una resistencia térmica de 0,98 m²K/W y 4 mm de espesor y una clasificación ante el fuego NDP. Incluso p.p. de cortes, medios auxiliares y limpieza, sellado de juntas con cinta autoadhesiva de polietileno reticulado CintPex 50 o similar, totalmente terminado. Adecuado principalmente para colocar posteriormente aplacados que no necesiten estar pegados al aislamiento ( cerámica, ladrillos...), no recomendado para enfoscar encima. Cumpliendo CTE DB HE 1 y apartado 4.6 CEC puentes térmicos. | 8.60 € | 5882.40 € | Lo sustituye el módulo: no se pide así
D16DD153 | AISLAMIENTO ACÚSTICO PARA SUELO FLOTANTE PARQUET CHOVAIMPACT 3 S | m² | 1429.65 | 89.35 | SUELO FLOTANTE PAREADO TIPO PLANTA BAJA Vestíbulo: 14 × 5.00 Dormitorio 1: 14 × 9.55 Salón-comedor: 14 × 29.15 PLANTA PRIMERA Distribuidor: 14 × 3.95 Dormitorio principal: 14 × 17.50 Dormitorio 2: 14 × 12.10 Dormitorio 3: 14 × 12.00 AISLADA TIPO 1 (VIVIENDA 5) PLANTA BAJA Vestíbulo: 1 × 5.00 Dormitorio 1: 1 × 9.55 Salón-comedor: 1 × 29.05 PLANTA PRIMERA Distribuidor: 1 × 3.95 Dormitorio principal: 1 × 17.50 Dormitorio 2: 1 × 12.45 Dormitorio 3: 1 × 12.15 AISLADA TIPO 2 (VIVIENDA 10) PLANTA BAJA Vestíbulo: 1 × 5.00 Dormitorio 1: 1 × 9.50 Salón-comedor: 1 × 30.30 PLANTA PRIMERA Distribuidor: 1 × 3.40 Dormitorio principal: 1 × 17.70 Dormitorio 2: 1 × 12.10 Dormitorio 3: 1 × 12.50 | Marca/serie: CHOVA | AISLAMIENTO ACÚSTICO PARA SUELO FLOTANTE PARQUET CHOVAIMPACT 3 SAislamiento acústico a ruido de impacto, colocado sobre capa de nivelación o pavimento existente, lámina ChovAIMPACT 3 "CHOVA" de 3 mm de espesor compuesta por polietileno de alta calidad revestida por una de sus caras con film de polietileno preparada para recibir directamente el suelo de madera o laminado. | 3.09 € | 4417.62 € | Se pide igual (fábrica u obra)
D17AA524 | AISLAM. LAMINA ANTIRADON POLYDAN RADON 180-40P ELAST | m² | 1128.80 | 70.55 | PAREADO TIPO: 14 × 70.30 AISLADA TIPO 1 (VIVIENDA 5): 1 × 71.90 AISLADA TIPO 2 (VIVIENDA 10): 1 × 72.70 | Marca/serie: Esterdan pendiente cero | AISLAM. LAMINA ANTIRADON POLYDAN RADON 180-40P ELASTImpermeabilización monocapa en cubiertas con pendiente entre el 1% y el 15%, no transitables o transitables para uso peatonal, sistema no adherido, constituida por una lámina asfáltica de betún modificado con elastómeros SBS y peso medio de 4 kg/m² acabada con film de polietileno por ambas caras, ESTERDAN 40 P ELAST, con plegabilidad positiva a 15°C y armadura de fieltro de poliéster (Tipo LBM 40 FP), en posición flotante, adherida sólo en bordes y puntos singulares con soplete, previa imprimación de la base con 0,3 kg/m² de emulsión asfáltica CURIDAN, lista para proteger con protección pesada. Membrana PN 1, s/UNE 104 402/96. Según CTE/DB HS 1. Dispone de DIT. "Esterdan pendiente cero". Nº 550/10. | 12.25 € | 13827.80 € | Fuera de la vivienda (promotor o Knubo)
NAD010 | AISLAMIENTO LANA MINERAL 100 mm BAJO FORJADO | m² | 156.00 | 9.75 | FALSOS TECHOS EXTERIORES PAREADO TIPO: 14 × 9.80 AISLADA TIPO 1(VIVIENDA 5): 1 × 10.70 AISLADA TIPO 2(VIVIENDA 10): 1 × 8.10 |  | AISLAMIENTO LANA MINERAL 100 mm BAJO FORJADOSuministro y colocación de aislamiento térmico bajo forjado formado por panel semirrígido de lana mineral, según UNE-EN 13162, no revestido, de 100 mm de espesor, resistencia térmica 2,25 m²K/W, conductividad térmica 0,035 W/(mK), fijado mecánicamente. Incluso p/p de cortes, fijaciones y limpieza. | 12.22 € | 1906.32 € | Lo sustituye el módulo: no se pide así
509b | AISLAMIENTO XPS 80 mm SUELO | m² | 1128.80 | 70.55 | PAREADO TIPO: 14 × 70.30 AISLADA TIPO 1 (VIVIENDA 5): 1 × 71.90 AISLADA TIPO 2 (VIVIENDA 10): 1 × 72.70 |  | AISLAMIENTO XPS 80 mm SUELOSuministro y colocación de aislamiento térmico por el interior sobre espacio habitable, formado por panel rígido de poliestireno extruido de superficie lisa y mecanizado lateral a media madera, de 80 mm de espesor, resistencia térmica 2,42 m²K/W, conductividad térmica 0,033 W/(mK), fijado con taco de expansión y clavo de polipropileno, con aro de estanqueidad. Incluso cortes y limpieza. | 12.49 € | 14098.71 € | Lo sustituye el módulo: no se pide así
510 | AISLAMIENTO XPS 100 mm FACHADAS | m² | 2664.64 | 166.54 | PAREADO TIPO Planta baja: 14 × 27.50 × 3.25 Planta primera: 14 × 27.00 × 3.15 -A descontar > 4.00 m² PE2: -14 × 2.80 × 2.20 PE3: -14 × 1.90 × 2.20 PE4: -14 × 2.80 × 2.10 AISLADO TIPO 1 (VIVIENDA 5) Planta baja: 1 × 37.25 × 3.25 Planta primera: 1 × 38.05 × 3.15 -A descontar > 4.00 m² PE2: -1 × 2.80 × 2.20 PE3: -1 × 1.90 × 2.20 PE4: -1 × 2.80 × 2.10 AISLADO TIPO 2 (VIVIENDA 10) Planta baja: 1 × 37.75 × 3.25 Planta primera: 1 × 37.65 × 3.15 -A descontar > 4.00 m² PE2: -1 × 2.80 × 2.20 PE3: -1 × 1.90 × 2.20 PE4: -1 × 2.80 × 2.10 |  | AISLAMIENTO XPS 100 mm FACHADASSuministro y colocación de aislamiento térmico por el interior en fachada de doble hoja de fábrica para revestir, formado por panel rígido de poliestireno extruido, de superficie lisa y mecanizado lateral a media madera, de 100 mm de espesor, resistencia térmica 2,75 m²K/W, conductividad térmica 0,029 W/(mK), fijado con taco de expansión y clavo de polipropileno, con aro de estanqueidad. Incluso cortes y limpieza. | 14.80 € | 39436.67 € | Lo sustituye el módulo: no se pide así
509 | AISLAMIENTO XPS 100 mm CUBIERTA | m² | 1211.55 | 75.72 | PAREADO TIPO Cubierta primera: 7 × 133.70 Cubierta baja: 14 × 9.00 AISLADA TIPO 1(VIVIENDA 5) Cubierta primera: 1 × 66.70 Cubierta baja: 1 × 9.00 AISLADA TIPO 2(VIVIENDA 10) Cubierta primera: 1 × 65.85 Cubierta baja: 1 × 8.10 |  | AISLAMIENTO XPS 100 mm CUBIERTASSuministro y colocación de aislamiento térmico por el exterior de cubiertas inclinadas/planas sobre espacio habitable, formado por panel rígido de poliestireno extruido de superficie lisa y mecanizado lateral a media madera, de 100 mm de espesor, resistencia térmica 2,75 m²K/W, conductividad térmica 0,029 W/(mK), fijado con taco de expansión y clavo de polipropileno, con aro de estanqueidad. Incluso cortes y limpieza. | 14.80 € | 17930.94 € | Lo sustituye el módulo: no se pide así
 | Total del capítulo (PEM del proyecto) |  |  |  |  |  |  |  | 128361.62 €

Sheet: 08 Pladur trasdosados, tabiques
Névola · Pladur: trasdosados, tabiques y techos · 16 viviendas
Capítulo C.08 del proyecto de ejecución (BC3 de julio de 2026). Medición de toda la promoción y su desglose tal como viene en el proyecto. Precios del proyecto (CYPE, PEM, sin IVA), solo como referencia.
Código | Partida | Ud | Total 16 viv. | Media por vivienda | Desglose de la medición (proyecto) | Datos clave (medidas, color, marca) | Descripción completa del proyecto | Precio proyecto | Importe PEM | Alcance en el sistema modular
507 | TRASDOSADO AUTOPORT. KNAUF W625 (1x15,0+48) C/AISL | m² | 3106.87 | 194.18 | PAREADO TIPO Planta baja: 14 × 36.10 × 2.95 Planta primera: 14 × 36.30 × 2.85 -A descontar > 4.00 m² PE2: -14 × 2.80 × 2.20 PE3: -14 × 1.90 × 2.20 PE4: -14 × 2.80 × 2.10 AISLADO TIPO 1 (VIVIENDA 5) Planta baja: 1 × 36.25 × 2.95 Planta primera: 1 × 37.25 × 2.85 -A descontar > 4.00 m² PE2: -1 × 2.80 × 2.20 PE3: -1 × 1.90 × 2.20 PE4: -1 × 2.80 × 2.10 AISLADO TIPO 2 (VIVIENDA 10) Planta baja: 1 × 36.95 × 2.95 Planta primera: 1 × 36.84 × 2.85 -A descontar > 4.00 m² PE2: -1 × 2.80 × 2.20 PE3: -1 × 1.90 × 2.20 PE4: -1 × 2.80 × 2.10 |  | TRASDOSADO AUTOPORT. KNAUF W625 (1x15,0+48) C/AISLTrasdosado autoportante W625 formado por una placa Knauf Tipo A Standard o Tipo H1 Hidrófugas en locales húmedos de 15,0 mm de espesor, atornilladas a una estructura metálica de acero galvanizado de canales horizontales y montantes verticales de 48x30 y 0,6 mm de espesor, con una modulación de 400 mm e/e y fijadas al muro portante con anclajes directos cada 1,00 m, incluso aislamiento acústico mediante panel semirrígido de lana mineral, espesor 45 mm, en el alma, y p.p. de pasta y cinta para juntas, tornillos fijaciones, banda acústica bajo los perfiles perimetrales, totalmente terminado y listo para imprimar y decorar. | 31.85 € | 98953.81 € | Lo sustituye el módulo: no se pide así
FBY015 | TABIQUE MÚLTIPLE KNAUF W112 (2x12,5+48+2x12,5) C/AISL | m² | 2089.54 | 130.60 | PAREADO TIPO Planta baja: 14 × 15.10 × 2.95 Planta primera: 14 × 30.20 × 2.85 AISLADO TIPO 1 (VIVIENDA 5) Planta baja: 1 × 15.10 × 2.95 Planta primera: 1 × 30.20 × 2.85 AISLADO TIPO 2 (VIVIENDA 10) Planta baja: 1 × 14.85 × 2.95 Planta primera: 1 × 30.35 × 2.85 | Marca/serie: KNAUF | TABIQUE MÚLTIPLE KNAUF W112 (2x12,5+48+2x12,5) C/AISLTabique múltiple sistema W112.es "KNAUF", de 98 mm de espesor total, con nivel de calidad del acabado Q2, sobre banda acústica de dilatación autoadhesiva "KNAUF", formado por una estructura simple de perfiles de chapa de acero galvanizado de 48 mm de anchura, a base de montantes (elementos verticales) separados 400 mm entre sí, con disposición normal "N" y canales (elementos horizontales), a la que se atornillan cuatro placas en total (Tipo A Standard o Tipo H1 Hidrófugas en locales húmedos en cada cara, de 12,5 mm de espesor cada placa); aislamiento acústico mediante panel semirrígido de lana mineral, espesor 45 mm, en el alma. Incluso banda acústica de dilatación autoadhesiva "KNAUF"; tornillería para la fijación de las placas y pasta y cinta para el tratamiento de juntas. | 29.94 € | 62560.83 € | Se pide igual (fábrica u obra)
FBY015b | TABIQUE MÚLTIPLE KNAUF W112 (2x12,5+70+2x12,5) C/AISL | m² | 359.20 | 22.45 | COLECTORES CLIMA/CUADRO ELÉCTRICO PAREADO TIPO Planta baja: 14 × 5.50 × 2.95 Planta primera: 14 × 1.65 × 2.85 Escalera (barandilla): 14 × 1.65 × 1.00 AISLADO TIPO 1 (VIVIENDA 5) Planta baja: 1 × 5.50 × 2.95 Planta primera: 1 × 1.65 × 2.85 Escalera (barandilla): 1 × 1.65 × 1.00 AISLADO TIPO 2 (VIVIENDA 10) Planta baja: 1 × 5.00 × 2.95 Planta primera: 1 × 1.45 × 2.85 Escalera (barandilla): 1 × 1.65 × 1.00 | Marca/serie: KNAUF | TABIQUE MÚLTIPLE KNAUF W112 (2x12,5+70+2x12,5) C/AISLTabique múltiple sistema W112.es "KNAUF", de 120 mm de espesor total, con nivel de calidad del acabado Q2, sobre banda acústica de dilatación autoadhesiva "KNAUF", formado por una estructura simple de perfiles de chapa de acero galvanizado de 70 mm de anchura, a base de montantes (elementos verticales) separados 400 mm entre sí, con disposición normal "N" y canales (elementos horizontales), a la que se atornillan cuatro placas en total (Tipo A Standard o Tipo H1 Hidrófugas en locales húmedos en cada cara, de 12,5 mm de espesor cada placa); aislamiento acústico mediante panel semirrígido de lana mineral, espesor 65 mm, en el alma. Incluso banda acústica de dilatación autoadhesiva "KNAUF"; tornillería para la fijación de las placas y pasta y cinta para el tratamiento de juntas. | 31.34 € | 11257.33 € | Se pide igual (fábrica u obra)
D14DAC005-2 | INCREMENTO PLACA ALTA RESISTENCIA MUEBLES DE COCINA/LAVABOS/ESCALERAS | m² | 202.55 | 12.66 | COCINAS PAREADO TIPO: 14 × 3.00 × 1.50 AISLADO TIPO 1 (VIVIENDA 5): 1 × 3.00 × 1.50 AISLADO TIPO 2 (VIVIENDA 10): 1 × 3.10 × 1.50 ESCALERAS: 16 × 1.65 × 1.00 BAÑOS PAREADO TIPO: 14 × 3.25 × 2.00 AISLADO TIPO 1 (VIVIENDA 5): 1 × 3.25 × 2.00 AISLADA TIPO 2 (VIVIENDA 10): 1 × 3.25 × 2.00 |  |  | 8.20 € | 1660.91 € | Se pide igual (fábrica u obra)
511 | FALSO TECHO CONTINUO CUARTOS SECOS | m² | 1504.05 | 94.00 | PAREADO TIPO PLANTA BAJA Vestíbulo: 14 × 5.00 Dormitorio 1: 14 × 9.55 Salón-comedor: 14 × 29.15 PLANTA PRIMERA Escalera: 14 × 4.65 Distribuidor: 14 × 3.95 Dormitorio principal: 14 × 17.50 Dormitorio 2: 14 × 12.10 Dormitorio 3: 14 × 12.00 AISLADA TIPO 1 (VIVIENDA 5) PLANTA BAJA Vestíbulo: 1 × 5.00 Dormitorio 1: 1 × 9.55 Salón-comedor: 1 × 29.05 PLANTA PRIMERA Escalera: 1 × 4.65 Distribuidor: 1 × 3.95 Dormitorio principal: 1 × 17.50 Dormitorio 2: 1 × 12.45 Dormitorio 3: 1 × 12.15 AISLADA TIPO 2 (VIVIENDA 10) PLANTA BAJA Vestíbulo: 1 × 5.00 Dormitorio 1: 1 × 9.50 Salón-comedor: 1 × 30.30 PLANTA PRIMERA Escalera: 1 × 4.65 Distribuidor: 1 × 3.40 Dormitorio principal: 1 × 17.70 Dormitorio 2: 1 × 12.10 Dormitorio 3: 1 × 12.50 | Marca/serie: KNAUF | FALSO TECHO CONTINUO CUARTOS SECOSFalso techo continuo suspendido, situado a una altura menor de 4 m, con nivel de calidad del acabado Q2, liso, sistema D47.es "KNAUF" (12,5+17), formado por una placa de yeso laminado A/UNE-EN 520-1200/longitud/12,5/ con los bordes longitudinales afinados, Standard "KNAUF" atornillada a una estructura metálica de acero galvanizado de maestras primarias 47/17 mm separadas cada 500 mm entre ejes y suspendidas del forjado o elemento soporte mediante cuelgues Pivot F-47, para maestra 47/17, "KNAUF", y varillas cada 1200 mm, aislamiento acústico mediante panel semirrígido de lana mineral, espesor 45 mm. Incluso banda acústica, fijaciones para el anclaje de los perfiles, tornillería para la fijación de las placas, pasta y cinta para el tratamiento de juntas y accesorios de montaje. | 27.74 € | 41722.35 € | Se pide igual (fábrica u obra)
512 | FALSO TECHO CONTINUO CUARTOS HÚMEDOS | m² | 432.70 | 27.04 | PAREADO TIPO PLANTA BAJA Baño 1: 14 × 3.75 Lavadero: 14 × 4.00 Cocina: 14 × 8.45 PLANTA PRIMERA Baño Principal: 14 × 7.10 Baño 2: 14 × 3.85 AISLADA TIPO 1 (VIVIENDA 5) PLANTA BAJA Baño 1: 1 × 3.75 Lavadero: 1 × 4.00 Cocina: 1 × 8.45 PLANTA PRIMERA Baño Principal: 1 × 6.75 Baño 2: 1 × 3.75 AISLADA TIPO 2 (VIVIENDA 10) PLANTA BAJA Baño 1: 1 × 3.65 Lavadero: 1 × 4.30 Cocina: 1 × 7.85 PLANTA PRIMERA Baño Principal: 1 × 6.80 Baño 2: 1 × 3.30 | Marca/serie: KNAUF | FALSO TECHO CONTINUO CUARTOS HÚMEDOSFalso techo continuo suspendido, situado a una altura menor de 4 m, con nivel de calidad del acabado Q2, liso, sistema D47.es "KNAUF" (12,5+17), formado por una placa de yeso laminado A/UNE-EN 520-1200/longitud/12,5/ con los bordes longitudinales afinados, Tipo H1 Hidrófugas para locales húmedos "KNAUF" atornillada a una estructura metálica de acero galvanizado de maestras primarias 47/17 mm separadas cada 500 mm entre ejes y suspendidas del forjado o elemento soporte mediante cuelgues Pivot F-47, para maestra 47/17, "KNAUF", y varillas cada 1200 mm, aislamiento acústico mediante panel semirrígido de lana mineral, espesor 45 mm. Incluso banda acústica, fijaciones para el anclaje de los perfiles, tornillería para la fijación de las placas, pasta y cinta para el tratamiento de juntas y accesorios de montaje. | 31.01 € | 13418.03 € | Se pide igual (fábrica u obra)
RTC020b | TABICA VERTICAL FALSO TECHO CONTINUO | m | 116.50 | 7.28 | PAREADO TIPO Planta baja: 14 × 6.25 Planta primera: 14 × 1.00 AISLADA TIPO 1 (VIVIENDA 5) Planta baja: 1 × 6.25 Planta primera: 1 × 1.00 AISLADA TIPO 2 (VIVIENDA 10) Planta baja: 1 × 6.50 Planta primera: 1 × 1.25 | Marca/serie: KNAUF | TABICA VERTICAL FALSO TECHO CONTINUO Formación de tabica vertical en cambio de nivel de falso techo continuo, formado por una placa de yeso laminado A/UNE-EN 520-1200/longitud/12,5/ con los bordes longitudinales afinados, Tipo A Standard o Tipo H1 Hidrófugas en locales húmedos "KNAUF", atornillada a una estructura metálica de acero galvanizadorecibidas con pasta de agarre, para cerrar un espacio de 30 cm de altura. Incluso corte, fijación con pasta de agarre, pasta de juntas y cinta de juntas.Incluye: Replanteo y trazado en los paramentos de la situación de la tabica. Presentación y corte de las piezas. Extendido de la pasta de agarre. Fijación de las placas. Tratamiento de juntas.Criterio de medición de proyecto: Longitud medida según documentación gráfica de Proyecto.Criterio de medición de obra: Se medirá la longitud realmente ejecutada según especificaciones de Proyecto.Criterio de valoración económica: El precio incluye la resolución de encuentros y puntos singulares. | 20.41 € | 2377.76 € | Se pide igual (fábrica u obra)
513 | FALSO TECHO CONTINUO PLACAS DE CEMENTO | m² | 156.00 | 9.75 | VUELOS EXTERIORES PAREADO TIPO: 14 × 9.80 AISLADA TIPO 1(VIVIENDA 5): 1 × 10.70 AISLADA TIPO 2(VIVIENDA 10): 1 × 8.10 | Marca/serie: KNAUF | FALSO TECHO CONTINUO PLACAS DE CEMENTOSuministro y montaje de falso techo continuo, situado a una altura de hasta 4 m, liso D282a.es "KNAUF" o similar (12,5+27+27), formado por una placa de cemento Portland Aquapanel Outdoor "KNAUF" 12,5x1200x2400, revestida con una capa de fibra de vidrio embebida en ambas caras, atornillada a una estructura metálica de acero galvanizado de maestras primarias 60/27 mm separadas cada 50 mm entre ejes y suspendidas del forjado o elemento soporte mediante cuelgues Nonius cada 750 mm (incluidos en este precio), y maestras secundarias fijadas perpendicularmente a las primarias mediante caballetes y colocadas con una modulación máxima de 400 mm entre ejes, incluso p/p de fijaciones, tornillería, resolución del perímetro y puntos singulares, mortero de juntas, cinta de juntas y accesorios de montaje. Totalmente terminado con pasta Aquapanel Q4 Finish. | 101.73 € | 15869.88 € | Se pide igual (fábrica u obra)
FUF010 | MAMPARA DUCHA | m² | 34.56 | 2.16 | MAMPARAS BAÑO PRINCIPAL TODA LA OBRA: 16 × 0.60 × 2.40 16 × 0.60 × 1.20 | Color: plata | MAMPARA DUCHAPared fija de vidrio, formada por: perfiles de aluminio anodizado color plata mate y vidrio laminar de seguridad, 6+6 mm, incoloro, clasificación de prestaciones 2B2, según UNE-EN 12600. | 77.61 € | 2682.20 € | Se pide igual (fábrica u obra)
 | Total del capítulo (PEM del proyecto) |  |  |  |  |  |  |  | 250503.10 €

Sheet: 09 Alicatados y solados
Névola · Alicatados y solados · 16 viviendas
Capítulo C.09 del proyecto de ejecución (BC3 de julio de 2026). Medición de toda la promoción y su desglose tal como viene en el proyecto. Precios del proyecto (CYPE, PEM, sin IVA), solo como referencia.
Código | Partida | Ud | Total 16 viv. | Media por vivienda | Desglose de la medición (proyecto) | Datos clave (medidas, color, marca) | Descripción completa del proyecto | Precio proyecto | Importe PEM | Alcance en el sistema modular
RAG012 | ALICATADO GRES PORCELÁNICO (20 /m²) | m² | 1416.19 | 88.51 | PAREADO TIPO Cocina: 14 × 3.00 × 2.40 Lavadero: 14 × 10.45 × 2.10 Baño 1: 14 × 8.00 × 2.40 Baño 2: 14 × 8.25 × 2.40 Baño principal: 14 × 8.65 × 2.40 AISLADA TIPO 1 (VIVIENDA 5) Cocina: 1 × 3.00 × 2.40 Lavadero: 1 × 10.45 × 2.10 Baño 1: 1 × 8.00 × 2.40 Baño 2: 1 × 8.25 × 2.40 Baño principal: 1 × 8.35 × 2.40 AISLADA TIPO 2 (VIVIENDA 10) Cocina: 1 × 3.10 × 2.40 Lavadero: 1 × 8.65 × 2.10 Baño 1: 1 × 8.00 × 2.40 Baño 2: 1 × 7.55 × 2.40 Baño principal: 1 × 8.50 × 2.40 | Color: gris | ALICATADO GRES PORCELÁNICO (20 /m²)Suministro y colocación de alicatado con gres porcelánico acabado mate o natural, en formato comercial,(precio del material 20 euros/m²), capacidad de absorción de agua E<0,5%, grupo BIa, según UNE-EN 14411, con resistencia al deslizamiento Rd<=15 según UNE-ENV 12633 y resbaladicidad clase 0 según CTE, recibido con adhesivo cementoso de fraguado normal, C1 sin ninguna característica adicional, color gris. Incluso p/p de preparación de la superficie soporte de placas de yeso laminado; replanteo, cortes, cantoneras de PVC, y juntas; rejuntado con lechada de cemento blanco, L, BL-V 22,5, para junta mínima (entre 1,5 y 3 mm), coloreada con la misma tonalidad de las piezas; acabado y limpieza final. | 26.61 € | 37684.82 € | Se pide igual (fábrica u obra)
D19RA002 | PAVIMENTO LAMINADO TERHÜRNE 8,5 mm | m² | 1429.65 | 89.35 | PAREADO TIPO PLANTA BAJA Vestíbulo: 14 × 5.00 Dormitorio 1: 14 × 9.55 Salón-comedor: 14 × 29.15 PLANTA PRIMERA Distribuidor: 14 × 3.95 Dormitorio principal: 14 × 17.50 Dormitorio 2: 14 × 12.10 Dormitorio 3: 14 × 12.00 AISLADA TIPO 1 (VIVIENDA 5) PLANTA BAJA Vestíbulo: 1 × 5.00 Dormitorio 1: 1 × 9.55 Salón-comedor: 1 × 29.05 PLANTA PRIMERA Distribuidor: 1 × 3.95 Dormitorio principal: 1 × 17.50 Dormitorio 2: 1 × 12.45 Dormitorio 3: 1 × 12.15 AISLADA TIPO 2 (VIVIENDA 10) PLANTA BAJA Vestíbulo: 1 × 5.00 Dormitorio 1: 1 × 9.50 Salón-comedor: 1 × 30.30 PLANTA PRIMERA Distribuidor: 1 × 3.40 Dormitorio principal: 1 × 17.70 Dormitorio 2: 1 × 12.10 Dormitorio 3: 1 × 12.50 | Medidas: 1285x191x8,5mm | PAVIMENTO LAMINADO TERHÜRNE 8,5 mmPavimento laminado Comfloor ( AC5/32 ) Akustec de Terhürne o similar, con tablero base DPL de alta densidad de medidas 1285x191x8,5 mm dotado de junta de cierre ClikTec en los cuatro cantos de la tabla. Compuesto por tres elementos: A, capa de desgaste compuesta de una capa protectora fábricada a partir de resinas melamínicas y papel decorado con acabado de superficie similar a la madera (arce natural, haya, roble...). B, tablero base HDF dotado de sistema anti humedad WaterproTec y unión ClickTec. C, contracapa de papel Krahf para mayor estabilidad del conjunto y sistema de reducción del sonido de la pisada AkusTec.(INCLUYE PLASTON) | 36.32 € | 51924.89 € | Se pide igual (fábrica u obra)
FDD150 | TAPETA MADERA EN ESCALERA | m | 26.40 | 1.65 | Escaleras: 16 × 1.65 |  | TAPETA MADERA EN ESCALERATapeta recta de madera de roble, de 100 mm de ancho máximo, barnizado en taller con barniz sintético con acabado satinado, con soportes metálicos fijados al paramento mediante anclaje mecánico con tacos de nylon y tornillos de acero. Incluso p/p de replanteo de los soportes, fijación de los soportes al paramento y fijación del pasamanos a los soportes. Elaborado en taller y montado en obra. | 47.92 € | 1265.09 € | Se pide igual (fábrica u obra)
FDD140 | PASAMANOS ALUMINIO | m | 60.80 | 3.80 | Escaleras: 16 × 3.80 | Medidas: 60x40mm · Color: natural | PASAMANOS ALUMINIOPasamanos curvo de aluminio anodizado color natural, de 60x40 mm de sección, con soportes de aluminio fijados al paramento mediante anclaje mecánico con tacos de nylon y tornillos de acero. Incluso p/p de replanteo de los soportes, fijación de los soportes al paramento, fijación del pasamanos a los soportes y colocación de tapas de remate. Elaborado en taller y montado en obra. | 31.88 € | 1938.30 € | Se pide igual (fábrica u obra)
D19DD003D | SOLADO DE GRES PORCELÁNICO (20 /m²) INTERIOR C2 | m² | 432.70 | 27.04 | PAREADO TIPO PLANTA BAJA Baño 1: 14 × 3.75 Lavadero: 14 × 4.00 Cocina: 14 × 8.45 PLANTA PRIMERA Baño Principal: 14 × 7.10 Baño 2: 14 × 3.85 AISLADA TIPO 1 (VIVIENDA 5) PLANTA BAJA Baño 1: 1 × 3.75 Lavadero: 1 × 4.00 Cocina: 1 × 8.45 PLANTA PRIMERA Baño Principal: 1 × 6.75 Baño 2: 1 × 3.75 AISLADA TIPO 2 (VIVIENDA 10) PLANTA BAJA Baño 1: 1 × 3.65 Lavadero: 1 × 4.30 Cocina: 1 × 7.85 PLANTA PRIMERA Baño Principal: 1 × 6.80 Baño 2: 1 × 3.30 |  | SOLADO DE GRES PORCELÁNICO (20 /m²) INTERIOR C2Solado con baldosas de gres porcelánico acabado mate o natural, en formato comercial,(precio del material 20 euros/m²) para interiores (resistencia al deslizamiento Rd s/ UNE-ENV 12633 para: a) zonas secas, CLASE 1 para pendientes menores al 6% y CLASE 2 para pendientes superiores al 6% y escaleras, b) zonas húmedas, CLASE 2 para pendientes menores al 6% y CLASE 3 para pendientes superiores al 6% y escaleras y piscinas), recibido con cemento cola Weber.col classic blanco, sobre base de mortero de cemento y arena de río 1/6 (incluido), i/piezas especiales, ejecución de cortes, rejuntado con mortero decorativo Weber col junta fina (< 3mm) y limpieza, s/ CTE BD SU y NTE-RSB-7. | 35.97 € | 15564.22 € | Se pide igual (fábrica u obra)
D19DD004 | SOLADO DE GRES PORCELÁNICO (20 /m²) EXTERIOR C3 | m² | 749.65 | 46.85 | ZAGUÁN ACCESO: 16 × 1.50 PÉRGOLA-TERRAZA PAREADO TIPO: 14 × 23.55 AISLADA TIPO 1 (VIVIENDA 5): 1 × 24.10 AISLADA TIPO 2 (VIVIENDA 10): 1 × 22.55 TERRAZA PLANTA PRIMERA PAREADO TIPO: 14 × 9.00 AISLADA TIPO 1 (VIVIENDA 5): 1 × 9.00 AISLADA TIPO 2 (VIVIENDA 10): 1 × 8.10 ZONA COMÚN PISCINA ADULTOS: 1 × 131.75 CUARTO TÉCNICO PISCINAS: 1 × 20.75 CASETA APEROS: 1 × 13.45 PISCINA CHAPOTEO: 1 × 40.25 |  | SOLADO DE GRES PORCELÁNICO (20 /m²) EXTERIOR C3Solado con baldosas de gres porcelánico acabado mate o natural, en formato comercial,(precio del material 20 euros/m²), para exteriores y piscinas (resistencia al deslizamiento Rd>45 s/ UNE-ENV 12633 CLASE 3), recibido con mortero de cemento y arena de río M5 según UNE-EN 998-2, i/cama de 2 cm de arena de río, p.p. de rodapié del mismo material de 7 cm, rejuntado y limpieza, s/ CTE BD SU y NTE-RSB-7. | 42.95 € | 32197.47 € | Fuera de la vivienda (promotor o Knubo)
UXC020 | HORMIGÓN PULIDO | m² | 16.00 | 1.00 | Cuarto técnico piscinas: 1 × 16.00 |  | HORMIGÓN PULIDOPavimento continuo exterior de hormigón en masa, con juntas, de 10 cm de espesor medio, realizado con hormigón HM-15/B/20/I fabricado en central y vertido desde camión; con lámina de polietileno como capa separadora bajo el pavimento; tratado superficialmente con capa de rodadura de con un rendimiento aproximado de 3 kg/m², espolvoreado manualmente sobre el hormigón aún fresco y posterior fratasado mecánico de toda la superficie hasta conseguir que el mortero quede totalmente integrado en el hormigón. Incluso p/p de colocación y retirada de encofrados, ejecución de juntas de construcción; emboquillado o conexión de los elementos exteriores (cercos de arquetas, sumideros, botes sifónicos, etc.) de las redes de instalaciones ejecutadas bajo el pavimento; extendido, regleado y aplicación de aditivos. Sin incluir la ejecución de la base de apoyo ni la de las juntas de dilatación y de retracción. | 19.40 € | 310.40 € | Fuera de la vivienda (promotor o Knubo)
0604 | HORMIGÓN IMPRESO-SOLERA HA-25 #150x150x5 15 cm+ENCACHADO+PVC | m² | 1777.60 | 111.10 | VIVIENDAS (ACERADO) VIVIENDA 1: 1 × 69.20 VIVIENDA 2: 1 × 68.65 VIVIENDA 3: 1 × 67.90 VIVIENDA 4: 1 × 71.65 VIVIENDA 5: 1 × 67.20 VIVIENDA 6: 1 × 74.65 VIVIENDA 7: 1 × 86.65 VIVIENDA 8: 1 × 64.50 VIVIENDA 9: 1 × 67.10 VIVIENDA 10: 1 × 69.95 VIVIENDA 11: 1 × 69.20 VIVIENDA 12: 1 × 61.40 VIVIENDA 13: 1 × 71.00 VIVIENDA 14: 1 × 69.15 VIVIENDA 15: 1 × 69.15 VIVIENDA 16: 1 × 74.00 ZONA COMÚN: 1 × 656.25 | Medidas: 150x150x5mm | HORMIGÓN IMPRESO-SOLERA HA-25 #150x150x5 15 cm+ENCACHADO+PVCSolera de 15 cm de espesor, realizada con hormigón HA-25/B/20/IIa N/mm², tamaño máximo del árido 20 mm elaborado en central, i/vertido, colocación y armado con mallazo electrosoldado #150x150x5 mm, incluso p.p. de juntas, aserrado de las mismas, fratasado y encachado de piedra caliza 40/80 de 15 cm de espesor, extendido y compactado con pisón, con lámina intermedia de PVC Danopol HS de 1,5 mm, junta de perímetro mediante EPS de 1 cm de espesor y sellado de juntas con masilla de poliuretano de elasticidad permanente. Según EHE-08. Acabado impreso en relieve y tratado superficialmente con mortero decorativo de rodadura para pavimento de hormigón; desmoldeante en polvo y capa de sellado final con resina impermeabilizante. Incluso colocación y retirada de encofrados, ejecución de juntas de construcción; emboquillado o conexión de los elementos exteriores (cercos de arquetas, sumideros, botes sifónicos, etc.) de las redes de instalaciones ejecutadas bajo el pavimento; extendido, regleado y aplicación de aditivos. | 34.50 € | 61327.20 € | Fuera de la vivienda (promotor o Knubo)
D19DD505 | PELDAÑO DE GRES PORCELÁNICO (20 /m²) ESCALERA INTERIOR C2 | m | 336.00 | 21.00 | ESCALERAS INTERIORES TODA LA OBRA: 16 × 21.00 × 1.00 | Color: blanco | PELDAÑO DE GRES PORCELÁNICO (20 /m²) ESCALERA INTERIOR C2Revestimiento de peldaño de escalera interior de anchura 1,00 m máximo, con baldosas de gres porcelánico acabado mate o natural, en formato comercial,(precio del material 20 euros/m²)formado por huella con canto redondeado,tabica y rodapié, gama media, capacidad de absorción de agua E<3%, grupo BIb, según UNE-EN 14411, con resistencia al deslizamiento 35<Rd<=45 según UNE-EN 16165 y resbaladicidad clase 2 según CTE. COLOCACIÓN: en capa fina y mediante encolado simple con adhesivo cementoso mejorado, C2 TE, según UNE-EN 12004, con deslizamiento reducido y tiempo abierto ampliado. REJUNTADO: con mortero de juntas cementoso mejorado, con absorción de agua reducida y resistencia elevada a la abrasión tipo CG 2 W A, color blanco, en juntas de 2 mm de espesor. | 28.08 € | 9434.88 € | Se pide igual (fábrica u obra)
HRC030 | VIERTEAGUAS GRES PORCELÁNICO | m | 120.00 | 7.50 | TODA LA OBRA PE2: 16 × 2.80 PE3: 16 × 1.90 PE4: 16 × 2.80 |  | VIERTEAGUAS GRES PORCELÁNICOFormación de vierteaguas con piezas de gres porcelánico, en formato comercial,con goterón y empotrado en las jambas, cubriendo los alféizares, los salientes de los paramentos, las cornisas de fachada, etc., recibido con mortero de cemento, industrial, con aditivo hidrófugo, M-10, creando una pendiente suficiente para evacuar el agua y rejuntado entre piezas y de las uniones con los muros con mortero de juntas cementoso con absorción de agua reducida, CG2, para juntas entre 3 y 15 mm. Incluso p/p de replanteo, cortes y limpieza final.Incluye: Replanteo de las piezas en el hueco o remate. Preparación y regularización del soporte. Colocación con mortero de las piezas. Relleno de juntas y limpieza del vierteaguas.Criterio de medición de proyecto: Longitud del ancho del hueco, medida según documentación gráfica de Proyecto, incrementada en 5 cm a cada lado.Criterio de medición de obra: Se medirá la longitud realmente ejecutada según especificaciones de Proyecto, incluyendo los empotramientos en las jambas. | 31.86 € | 3823.20 € | Se pide igual (fábrica u obra)
HRL010 | ALBARDILLA ALUMINIO | m | 467.15 | 29.20 | PETOS CUBIERTA PAREADO TIPO: 7 × 54.00 AISLADA TIPO 1 (VIVIENDA 5): 1 × 38.05 AISLADA TIPO 2 (VIVIENDA 10): 1 × 37.65 CASETA APEROS: 1 × 13.45 |  | ALBARDILLA ALUMINIOAlbardilla metálica, de chapa plegada de aluminio lacado en color, con un ángulo de inclinación de 10°, con 60 micras de espesor mínimo de película seca, espesor 1,5 mm, desarrollo 300 mm y 5 pliegues, con goterón, para cubrición de muros; colocación con adhesivo bituminoso de aplicación en frío, sobre tablero estructural contrachapado atornillado a rastreles de madera; y sellado de las juntas entre piezas y, en su caso, de las uniones con los muros con sellador adhesivo monocomponente.Incluye: Preparación de la superficie de apoyo. Preparación de la base y de los medios de fijación. Replanteo de las piezas. Corte de las piezas. Colocación y fijación de las piezas metálicas niveladas y aplomadas. Sellado de juntas y limpieza.Criterio de medición de proyecto: Longitud medida a ejes, según documentación gráfica de Proyecto.Criterio de medición de obra: Se medirá, a ejes, la longitud realmente ejecutada según especificaciones de Proyecto.Incluye: Preparación de la superficie de apoyo. Preparación de la base y de los medios de fijación. Replanteo de las piezas. Corte de las piezas. Colocación y fijación de las piezas metálicas niveladas y aplomadas. Sellado de juntas y limpieza.Criterio de medición de proyecto: Longitud medida a ejes, según documentación gráfica de Proyecto.Criterio de medición de obra: Se medirá, a ejes, la longitud realmente ejecutada según especificaciones de Proyecto. | 22.99 € | 10739.78 € | Se pide igual (fábrica u obra)
RCG010 | APLACADO GRES EXTERIOR EN FACHADA | m² | 497.68 | 31.11 | PAREADO TIPO Fachada principal: 14 × 17.50 Fachada posterior: 14 × 3.80 Fachada lateral: 14 × 2.25 Rodapié fachada p baja: 14 × 28.10 × 0.20 Rodapié fachada terraza p primera: 14 × 7.15 × 0.20 AISLADA TIPO 1 (VIVIENDA 5) Fachada principal: 1 × 16.40 Fachada posterior: 1 × 3.80 Fachada lateral derecha: 1 × 2.25 Fachada lateral izquierda: 1 × 2.25 Rodapié fachada p baja: 1 × 41.10 × 0.20 Rodapié fachada terraza p primera: 1 × 7.15 × 0.20 AISLADA TIPO 2 (VIVIENDA 10) Fachada principal: 1 × 16.40 Fachada posterior: 1 × 4.40 Fachada lateral derecha: 1 × 2.25 Fachada lateral izquierda: 1 × 2.25 Rodapié fachada p baja: 1 × 41.55 × 0.20 Rodapié fachada terraza p primera: 1 × 6.60 × 0.20 |  | APLACADO GRES EXTERIOR EN FACHADAAplacado mixto, con baldosa de gres porcelánico, en formato comercial, con un coeficiente de absorción de agua del 0,4% y un PEI IV, colocadas en capa fina, aplicando adhesivo cementoso mejorado, C2 TE, con deslizamiento reducido y tiempo abierto ampliado, blanco, utilizando la técnica de doble encolado, sobre una capa previa de mortero de regularización debidamente maestreada, (no incluida en este precio), utilizando además elementos mecánicos de refuerzo, enclavados en las juntas de separación entre baldosas y fijados mecánicamente al paramento. Rejuntado con mortero de juntas cementoso con resistencia elevada a la abrasión y absorción de agua reducida, CG2, para junta abierta (entre 3 y 15 mm), con la misma tonalidad de las piezas. Incluso p/p de preparación de la superficie soporte, replanteo, apertura de cajas en muros, cortes, piezas especiales, formación y sellado de juntas de movimiento, resolución de puntos singulares y encuentros con huecos de carpintería, elementos de fijación mecánica, acabado y limpieza final.Incluye: Replanteo de niveles y disposición de baldosas. Replanteo de taladros. Realización de taladros. Colocación de tacos. Atornillado de los elementos metálicos. Colocación de las piezas, extendiendo el material adhesivo de agarre. Formación de juntas de movimiento. Resolución de puntos singulares. Rejuntado de baldosas. Acabado y limpieza final.Criterio de medición de proyecto: Superficie medida según documentación grá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 | 48.34 € | 24057.85 € | Se pide igual (fábrica u obra)
 | Total del capítulo (PEM del proyecto) |  |  |  |  |  |  |  | 250268.09 €

Sheet: 10 Carpintería interior
Névola · Carpintería interior · 16 viviendas
Capítulo C.10 del proyecto de ejecución (BC3 de julio de 2026). Medición de toda la promoción y su desglose tal como viene en el proyecto. Precios del proyecto (CYPE, PEM, sin IVA), solo como referencia.
Código | Partida | Ud | Total 16 viv. | Media por vivienda | Desglose de la medición (proyecto) | Datos clave (medidas, color, marca) | Descripción completa del proyecto | Precio proyecto | Importe PEM | Alcance en el sistema modular
LPM010 | PUERTA INTERIOR ABATIBLE MDF | Ud | 112.00 | 7.00 | 16 × 7.00 | Medidas: 725x2100x35mm, 70x35mm, 70x30mm, 70x12mm | PUERTA INTERIOR ABATIBLE MDFPuerta de paso interior abatible ciega en Block con hoja lisa sin molduras y acanaladuras en forma de pico de pájaro, lacada en blanco de medidas de hoja 725x2100x35 mm, de tablero de MDF. Precerco en madera de pino de 70x35 mm, cerco visto de 70x30 mm, tapajuntas de 70x12 mm. Con 4 pernios de latón con remate, picaporte 6137/BC/50/HL y manivela con placa. Totalmente montada, mecanizada y lacada, incluso en p.p. de medios auxiliares. | 221.56 € | 24814.72 € | Se pide igual (fábrica u obra)
LAF010 | ARMARIO MODULAR PUERTAS ABATIBLES | m² | 47.40 | 2.96 | AE1: 15 × 1.25 × 2.40 (Vivienda 10): 1 × 1.00 × 2.40 | Color: cromado | ARMARIO MODULAR PUERTAS ABATIBLESBlock de armario para empotrar de dos hojas abatibles, de tablero aglomerado melamínico, de 16 mm de espesor, en costados, techo, suelo y división de maletero, y de 10 mm de espesor en el fondo; hoja de 19 mm de espesor y canto de 1,4 mm en PVC; barras de colgar en aluminio dorado, estriado y antidoblante, con soportes laterales de igual color; bisagras rectas de color cromado (4 unidades por puerta) y tiradores de color cromado para puertas abatibles. Incluso precerco, módulos columna y baldas de división en maletero, molduras en MDF plastificadas, tapajuntas, zócalo y demás herrajes. Elaborado en taller, con ajuste y fijación en obra. Totalmente montado. | 143.10 € | 6782.94 € | Se pide igual (fábrica u obra)
LAF010b | ARMARIO MODULAR/SIN PUERTAS | m² | 188.28 | 11.77 | AE2: 15 × 3.30 × 2.40 (Vivienda 5): 1 × 3.35 × 2.40 AE3: 16 × 1.60 × 2.40 |  | ARMARIO MODULAR/SIN PUERTASBlock de armario para empotrar, de tablero aglomerado melamínico, de 16 mm de espesor, en costados, techo, suelo y división de maletero, y de 10 mm de espesor en el fondo; hoja de 19 mm de espesor y canto de 1,4 mm en PVC; barras de colgar en aluminio dorado, estriado y antidoblante, con soportes laterales de igual color. Incluso módulos columna y baldas de división en maletero, molduras en MDF plastificadas, tapajuntas, zócalo y demás herrajes. Elaborado en taller, con ajuste y fijación en obra. Totalmente montado. | 105.80 € | 19920.02 € | Se pide igual (fábrica u obra)
RSL020b | RODAPIÉ MDF | m | 1621.25 | 101.33 | PAREADO TIPO PLANTA BAJA Vestíbulo: 14 × 7.00 Dormitorio 1: 14 × 12.55 Salón-comedor-cocina: 14 × 18.20 PLANTA PRIMERA Distribuidor: 14 × 9.00 Dormitorio principal: 14 × 21.70 Baño Principal: 14 × 2.95 Dormitorio 2: 14 × 14.30 Dormitorio 3: 14 × 15.60 AISLADA TIPO 1 (VIVIENDA 5) PLANTA BAJA Vestíbulo: 1 × 7.00 Dormitorio 1: 1 × 12.55 Salón-comedor-cocina: 1 × 18.20 PLANTA PRIMERA Distribuidor: 1 × 9.00 Dormitorio principal: 1 × 21.70 Baño Principal: 1 × 2.95 Dormitorio 2: 1 × 14.55 Dormitorio 3: 1 × 16.15 AISLADA TIPO 2 (VIVIENDA 10) PLANTA BAJA Vestíbulo: 1 × 7.20 Dormitorio 1: 1 × 12.50 Salón-comedor-cocina: 1 × 18.80 PLANTA PRIMERA Distribuidor: 1 × 7.90 Dormitorio principal: 1 × 21.20 Baño Principal: 1 × 2.85 Dormitorio 2: 1 × 14.30 Dormitorio 3: 1 × 16.20 | Medidas: 90x18mm · Color: blanco | RODAPIÉ MDFRodapié de MDF, de 90x18 mm, recubierto con una lámina plástica color blanco, fijado al paramento mediante adhesivo de montaje. Incluso replanteo, cortes, resolución de esquinas, uniones y encuentros, pequeño material auxiliar y limpieza final. | 6.95 € | 11267.69 € | Se pide igual (fábrica u obra)
 | Total del capítulo (PEM del proyecto) |  |  |  |  |  |  |  | 62785.37 €

Sheet: 11 Carpintería exterior y cerra
Névola · Carpintería exterior y cerrajería · 16 viviendas
Capítulo C.11 del proyecto de ejecución (BC3 de julio de 2026). Medición de toda la promoción y su desglose tal como viene en el proyecto. Precios del proyecto (CYPE, PEM, sin IVA), solo como referencia.
Código | Partida | Ud | Total 16 viv. | Media por vivienda | Desglose de la medición (proyecto) | Datos clave (medidas, color, marca) | Descripción completa del proyecto | Precio proyecto | Importe PEM | Alcance en el sistema modular
0804 | PUERTA ENTRADA ALUMINIO/BLOCK DE SEGURIDAD | Ud | 16.00 | 1.00 | PE1: 16 × 1.00 | Medidas: 82,5x210cm · Color: RAL 7016 | PUERTA ENTRADA ALUMINIO/BLOCK DE SEGURIDADSuministro y montaje de puerta de entrada de aluminio termolacado en polvo a 210°C, block de seguridad, de 82,5x210 cm. Compuesta de: hoja de 50 mm de espesor total, construida con dos chapas de aluminio de 1,2 mm de espesor, con alma de madera blindada con chapa de hierro acerado de 1 mm y macizo especial en todo el perímetro de la hoja y herraje, estampación con embutición profunda en doble relieve a dos caras, acabado en color RAL 7016; marcos especiales de extrusión de aluminio reforzado de 1,6 mm de espesor, de igual terminación que las hojas, con burlete perimétrico. Incluso premarco de acero galvanizado con garras de anclaje a obra, cerradura especial con tres puntos de cierre con bombín de seguridad, tres bisagras de seguridad antipalanca, burlete cortavientos, mirilla gran angular, manivela interior, pomo, tirador y aldaba exteriores, espuma de poliuretano para relleno de la holgura entre marco y muro, sellado perimetral de juntas por medio de un cordón de silicona neutra y ajuste final en obra. Elaborada en taller, con clasificación a la permeabilidad al aire según UNE-EN 12207, a la estanqueidad al agua según UNE-EN 12208 y a la resistencia a la carga del viento según UNE-EN 12210. Totalmente montada y probada. | 1140.81 € | 18252.96 € | Se pide igual (fábrica u obra)
LCV015 | PE1/FIJO (sin persiana) | Ud | 16.00 | 1.00 | PE1: 16 × 1.00 | Medidas: 500x2200mm · Color: RAL 7016; WSWS Blanco · Marca/serie: KÖMMERLING, SAINT GOBAIN, SIKA | PE1/FIJO (sin persiana)Ventanal fijo de PVC, serie Eurofutur 70 "KÖMMERLING", dimensiones 500x2200 mm, acabado estándar en la cara interior en color WSWS Blanco y acabado foliado en la cara exterior, color RAL 7016, perfiles de 70 mm de anchura, fabricados bajo formulación Greenline®, sin plomo ni estabilizantes pesados, soldados a inglete, que incorporan cinco cámaras interiores, tanto en la sección de la hoja como en la del marco, para mejora del aislamiento térmico; galce con pendiente del 5% para facilitar el desagüe; con refuerzos interiores, según UNE-EN 14351-1; transmitancia térmica del marco: Uh,m = desde 1,3 W/(m²K); espesor máximo del acristalamiento: 40 mm; compuesta por marco, hojas, herrajes de colgar y apertura, elementos de estanqueidad y accesorios homologados, con clasificación a la permeabilidad al aire clase 4, según UNE-EN 12207, clasificación a la estanqueidad al agua clase E1650, según UNE-EN 12208, y clasificación a la resistencia a la carga del viento clase C5, según UNE-EN 12210, con premarco y sin persiana. Incluso limpieza del premarco ya instalado, alojamiento y calzado del marco en el premarco, fijación del marco al premarco con tornillos de acero galvanizado.Incluido doble acristalamiento SGG CLIMALIT PLUS PLANITHERM XN F2 4/12 argón 90%/55.2 "SAINT GOBAIN", conjunto formado por vidrio exterior PLANITHERM XN de 4 mm, con capa de baja emisividad térmica incorporada en la cara interior, cámara de gas deshidratada con perfil separador de aluminio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 | 240.87 € | 3853.92 € | Se pide igual (fábrica u obra)
LCV015j | PE2/PUERTA 1 HOJA + FIJO LATERAL (con persiana) | Ud | 16.00 | 1.00 | PE2: 16 × 1.00 | Medidas: 2800x2200mm · Color: RAL 7016; WSWS Blanco; a · Marca/serie: KÖMMERLING, SAINT GOBAIN, SIKA | PE2/PUERTA 1 HOJA + FIJO LATERAL (con persiana)Puerta de PVC, serie Eurofutur 70 "KÖMMERLING", una hoja practicable con apertura hacia el interior y fijo lateral, dimensiones 2800x2200 mm, anchura del fijo 1800 mm, compuesta de marco, hoja y junquillos, acabado estándar en la cara interior en color WSWS Blanco y acabado foliado en la cara exterior, color RAL 7016, perfiles de 70 mm de anchura, fabricados bajo formulación Greenline®, sin plomo ni estabilizantes pesados, soldados a inglete, que incorporan cinco cámaras interiores, tanto en la sección de la hoja como en la del marco, para mejora del aislamiento térmico; galce con pendiente del 5% para facilitar el desagüe; con refuerzos interiores, juntas de estanqueidad de EPDM manilla y herrajes, según UNE-EN 14351-1; transmitancia térmica del marco: Uh,m = desde 1,3 W/(m²K); espesor máximo del acristalamiento: 40 mm; compuesta por marco, hojas, herrajes de colgar y apertura, elementos de estanqueidad y accesorios homologados, con clasificación a la permeabilidad al aire clase 4, según UNE-EN 12207, clasificación a la estanqueidad al agua clase E1650, según UNE-EN 12208, y clasificación a la resistencia a la carga del viento clase C2, según UNE-EN 12210, con premarco y cajón de persiana Rolaplus incorporado, acabado foliado en la cara exterior, color a elegir, persiana enrollable de lamas de aluminio inyectado, con aislamiento térmico, con accionamiento manual con cinta y recogedor. Incluso limpieza del premarco ya instalado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 | 1335.55 € | 21368.80 € | Se pide igual (fábrica u obra)
LCV015i | PE3/PUERTA 1 HOJA + FIJO LATERAL (con persiana) | Ud | 16.00 | 1.00 | PE3: 16 × 1.00 | Medidas: 1900x2200mm · Color: RAL 7016; WSWS Blanco; a · Marca/serie: KÖMMERLING, SAINT GOBAIN, SIKA | PE3/PUERTA 1 HOJA + FIJO LATERAL (con persiana)Puerta de PVC, serie Eurofutur 70 "KÖMMERLING", una hoja practicable con apertura hacia el interior y fijo lateral, dimensiones 1900x2200 mm, anchura del fijo 900 mm, compuesta de marco, hoja y junquillos, acabado estándar en la cara interior en color WSWS Blanco y acabado foliado en la cara exterior, color RAL 7016, perfiles de 70 mm de anchura, fabricados bajo formulación Greenline®, sin plomo ni estabilizantes pesados, soldados a inglete, que incorporan cinco cámaras interiores, tanto en la sección de la hoja como en la del marco, para mejora del aislamiento térmico; galce con pendiente del 5% para facilitar el desagüe; con refuerzos interiores, juntas de estanqueidad de EPDM manilla y herrajes, según UNE-EN 14351-1; transmitancia térmica del marco: Uh,m = desde 1,3 W/(m²K); espesor máximo del acristalamiento: 40 mm; compuesta por marco, hojas, herrajes de colgar y apertura, elementos de estanqueidad y accesorios homologados, con clasificación a la permeabilidad al aire clase 4, según UNE-EN 12207, clasificación a la estanqueidad al agua clase E1650, según UNE-EN 12208, y clasificación a la resistencia a la carga del viento clase C2, según UNE-EN 12210, con premarco y cajón de persiana Rolaplus incorporado, acabado foliado en la cara exterior, color a elegir, persiana enrollable de lamas de aluminio inyectado, con aislamiento térmico, con accionamiento manual con cinta y recogedor. Incluso limpieza del premarco ya instalado,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 | 1266.90 € | 20270.40 € | Se pide igual (fábrica u obra)
LCV015h | PE4/PUERTA 1 HOJA + FIJO LATERAL (con persiana) | Ud | 16.00 | 1.00 | PE4: 16 × 1.00 | Medidas: 2800x2100mm · Color: RAL 7016; WSWS Blanco; a · Marca/serie: KÖMMERLING, SAINT GOBAIN, SIKA | PE4/PUERTA 1 HOJA + FIJO LATERAL (con persiana)Puerta de PVC, serie Eurofutur 70 "KÖMMERLING", una hoja practicable con apertura hacia el interior y fijo lateral, dimensiones 2800x2100 mm, anchura del fijo 1800 mm, compuesta de marco, hoja y junquillos, acabado estándar en la cara interior en color WSWS Blanco y acabado foliado en la cara exterior, color RAL 7016, perfiles de 70 mm de anchura, fabricados bajo formulación Greenline®, sin plomo ni estabilizantes pesados, soldados a inglete, que incorporan cinco cámaras interiores, tanto en la sección de la hoja como en la del marco, para mejora del aislamiento térmico; galce con pendiente del 5% para facilitar el desagüe; con refuerzos interiores, juntas de estanqueidad de EPDM manilla y herrajes, según UNE-EN 14351-1; transmitancia térmica del marco: Uh,m = desde 1,3 W/(m²K); espesor máximo del acristalamiento: 40 mm; compuesta por marco, hojas, herrajes de colgar y apertura, elementos de estanqueidad y accesorios homologados, con clasificación a la permeabilidad al aire clase 4, según UNE-EN 12207, clasificación a la estanqueidad al agua clase E1650, según UNE-EN 12208, y clasificación a la resistencia a la carga del viento clase C2, según UNE-EN 12210, con premarco y cajón de persiana Rolaplus incorporado, acabado foliado en la cara exterior, color a elegir, persiana enrollable de lamas de aluminio inyectado, con aislamiento térmico, con accionamiento manual con cinta y recogedor. Incluso limpieza del premarco ya instalado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 | 1300.09 € | 20801.44 € | Se pide igual (fábrica u obra)

Sheet: 12 Pintura
Névola · Pintura · 16 viviendas
Capítulo C.12 del proyecto de ejecución (BC3 de julio de 2026). Medición de toda la promoción y su desglose tal como viene en el proyecto. Precios del proyecto (CYPE, PEM, sin IVA), solo como referencia.
Código | Partida | Ud | Total 16 viv. | Media por vivienda | Desglose de la medición (proyecto) | Datos clave (medidas, color, marca) | Descripción completa del proyecto | Precio proyecto | Importe PEM | Alcance en el sistema modular

Sheet: 13 Electricidad y telecomunicac
Névola · Electricidad y telecomunicaciones · 16 viviendas
Capítulo C.13 del proyecto de ejecución (BC3 de julio de 2026). Medición de toda la promoción y su desglose tal como viene en el proyecto. Precios del proyecto (CYPE, PEM, sin IVA), solo como referencia.
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
