teyame109-dev/Modular-Home/costes/Nevola_cimentacion_presupuesto_equipo.xlsx

Sheet: Presupuesto equipo
Névola · Cimentación del piloto · Presupuesto del equipo
Pasado del manuscrito del 20/10/2026 (foto en ofertas-proveedores/). Importes sin IVA. Celdas amarillas: editables.
Nº | Partida | Medición (como en el manuscrito) | Ud | Cantidad | Precio | Importe
1 | Muro a dos caras: muros longitudinales | 4 muros × 9,50 m × 2 caras | ml | 76.00 | 36.00 € | 2736.00 €
2 | Muro a dos caras: muretes transversales | 2 muretes × 7,95 m × 2 caras | ml | 31.80 | 36.00 € | 1144.80 €
3 | Vertido de hormigón: muros | Según el equipo | m³ | 11.00 | 16.50 € | 181.50 €
4 | Vertido de hormigón: zapatas | Según el equipo | m³ | 26.00 | 16.50 € | 429.00 €
5 | Hierro elaborado y armado | Según el equipo | kg | 3000.00 | 0.67 € | 2010.00 €
6 | Placas de anclaje | 3 por muro × 4 muros | ud | 12.00 | 32.00 € | 384.00 €
7 | Solera de limpieza (mano de obra) | Superficie de zapatas del croquis. Añadida por Iván (20/10/2026) | m² | 45.75 | 11.00 € | 503.25 €
 | Total del presupuesto del equipo |  |  |  |  | 7388.55 €
 | En el manuscrito: 6.885,00 €, sin la solera de limpieza, que se añadió después. Los céntimos son redondeos del papel (1.144,80 → 1.145 y 610,50 → 610).
Lo que no aparece en el manuscrito (a confirmar con el equipo)
Los precios del manuscrito son de mano de obra: encofrado por metro, vertido (no suministro) a 16,50 €/m³ y armado por kg. El hormigón (95 €/m³) y el acero (0,95 €/kg) se suministran aparte. Precios en blanco: rellenar cuando estén confirmados.
 | Partida | De dónde sale la cantidad | Ud | Cantidad | Precio | Importe
 | Suministro de hormigón HA-25 | Los 37 m³ vertidos. Precio de Iván (20/10/2026) | m³ | 37.00 | 115.00 € | 4255.00 €
 | Suministro de acero B500S | Los 3.000 kg, aparte de los 0,67 €/kg de elaboración y armado. Precio de Iván (20/10/2026) | kg | 3000.00 | 0.95 € | 2850.00 €
 | Suministro de placas de anclaje | Las 12 placas del presupuesto; la colocación va en mano de obra. Precio de Iván (20/10/2026) | ud | 12.00 | 220.00 € | 2640.00 €
 | Hormigón de limpieza bajo zapatas | Superficie de zapatas del croquis: 10,00 × (0,75 + 0,90 + 0,90 + 0,75) + 2 × 8,50 × 0,75. Precio: 10 cm de espesor al precio del hormigón | m² | 45.75 | 11.50 € | 526.12 €
 | Excavación de zanjas y retirada de tierras | Superficie de zapatas (45,75 m²) × 1,30 m de fondo, como en la estimación A (coronación a −0,05, muro, zapata y limpieza). Sin descontar cruces. Precio de Iván (20/10/2026) | m³ | 59.48 | 18.00 € | 1070.55 €
 | Grava en la cámara sanitaria | Huella de planta baja: 7,85 × 9,50 m, sin descontar muros, como en la estimación A. Precio de Iván (20/10/2026) | m² | 74.58 | 12.00 € | 894.90 €
 | Bombeo de hormigón | Una partida por vivienda. Precio de Iván (20/10/2026) | ud | 1.00 | 250.00 € | 250.00 €
 | Replanteo topográfico | Ejes de muros y placas, por vivienda. Precio de Iván (20/10/2026) | ud | 1.00 | 300.00 € | 300.00 €
 | Subtotal de lo pendiente (solo lo que tenga precio) |  |  |  |  | 12786.58 €
 | Total cimentación con lo pendiente |  |  |  |  | 20175.12 €

Sheet: Comprobaciones
Comprobaciones del presupuesto del equipo
Geometría leída del croquis y comparación con nuestra estimación A (web /cimentacion/).
Concepto | Equipo | Estimación A | Diferencia | Comentario
Hormigón en muros (m³) | 11.00 | 8.58 | 2.42 | Equipo: muros de 0,70 m de alto; nosotros 0,65 m.
Hormigón en zapatas (m³) | 26.00 | 20.48 | 5.52 | Croquis: zapatas de 0,75 y 0,90 m de ancho. Nosotros 0,80 y 1,00 m, y zapata común de 1,20 m en la medianera.
Hormigón total (m³) | 37.00 | 29.06 | 7.94
Acero (kg) | 3000 | 1667 | 1333 | Nosotros: 50 kg/m³ en zapatas y 75 kg/m³ en muros.
Cuantía de acero (kg/m³) | 81.08 | 57.36 | 23.72 | Razonable en los dos casos para cimentación corrida.
Placas de anclaje (ud) | 12 | 18 | -6 | Nosotros ponemos 2 placas en cada eje de los muros interiores (una por módulo): 18. El croquis tiene 3 por muro: 12.
Altura de muro (m) | 0.70 | 0.65 | 0.05
Longitud de muretes transversales (m) | 7.95 | 6.90 | 1.05 | En el croquis pone 7,85 y en el cálculo 7,95. Nosotros medimos el murete entre muros.
Geometría leída del croquis
Muros longitudinales | 4 × 9,50 m × 0,70 m de alto; espesores 0,25 · 0,30 · 0,30 · 0,25 m
Muretes transversales | 2 × 7,85 m (7,95 en el cálculo)
Zapatas longitudinales | 10,00 m de largo; anchos 0,75 · 0,90 · 0,90 · 0,75 m
Zapatas laterales | 2 × 8,50 × 0,75 m
Canto de zapata implícito | 0.57 m (26 m³ / superficie de zapatas)
Contraste con Menorca Pino (banco de precios, 2024, precios de venta)
Partida | €/m³ 2024 | €/m³ 2026 (+12 %) | Volumen equipo | Importe
Zapatas corridas, completas | 254.00 € | 284.48 € | 26.00 | 7396.48 €
Muros de cimentación, completos | 251.99 € | 282.23 € | 11.00 | 3104.52 €
Cimentación con precios de Pino |  |  |  | 10501.00 €
Presupuesto del equipo, por m³ |  |  | 199.69 €/m³ | 7388.55 €
Las partidas de Pino incluyen hormigón, acero, encofrado y mano de obra. La diferencia con el equipo es del orden del suministro de hormigón: por eso creemos que el manuscrito es solo mano de obra.

Sheet: Preguntas al equipo
Preguntas para cerrar el presupuesto
Antes de darlo por bueno.
1 | Hormigón (95 €/m³) y acero (0,95 €/kg) van aparte. ¿Confirmáis que vuestro precio no incluye ningún material salvo las placas?
2 | ¿Quién hace y paga la excavación de zanjas, la retirada de tierras, el hormigón de limpieza y la grava de la cámara sanitaria?
3 | Canto de las zapatas: con 26 m³ sale ≈ 0,57 m. ¿Qué canto han previsto?
4 | Placas: el croquis tiene 12 (3 por muro). En cada muro interior apoyan dos módulos y cada uno lleva su pilar, así que salen 2 placas por eje: 18 en total. Las 32 € son la colocación; la placa se compra aparte a 220 €. ¿Incluye los pernos?
5 | Muretes transversales: 7,85 m en el croquis y 7,95 m en el cálculo. ¿Cuál es la buena?
6 | Medianera: ¿zapata propia de 0,75 m o común con la vivienda vecina, como la planteamos nosotros (1,20 m, mitad por vivienda)?
7 | Cota de coronación: con el suelo a +0,20, el marco queda a −0,05. ¿Lo tienen en cuenta en la altura de 0,70 m?
8 | ¿Incluye bombeo, desencofrado, curado y limpieza de obra? ¿Plazo de ejecución?
