teyame109-dev/Modular-Home/costes/Nevola_piloto_estudio_costes.xlsx

Sheet: Resumen piloto
NÉVOLA · VIVIENDA PILOTO EN SISTEMA MODULAR · ESTUDIO DE COSTES
Pareada tipo de 148,30 m². Proyecto de ejecución de julio de 2026. Sin IVA. Dos escenarios: piloto como primera unidad de la serie, o piloto aislado.
Concepto | Piloto dentro de la serie | Piloto aislado
Estructura y envolvente modular (hoja Sistema modular)
Partidas que se ejecutan igual (proyecto)
Sobrecoste de primera unidad en mano de obra de fábrica
Transporte de 6 módulos, con el M4 como especial
Grúa (jornada completa)
Montaje en parcela
Ingeniería: cálculo modular y proyecto de fabricación
Gastos fijos de fábrica imputados
COSTE DEL PILOTO
Margen RG21 (precio cerrado menos coste)
PRECIO CERRADO CON NIDO (sin IVA)
€/m² construido
Referencia: contrata tradicional del mismo alcance (PEM del proyecto × 1,19)
Diferencia con la contrata tradicional
Precio del piloto en la propuesta integral
LECTURA
1. El acero medido sobre la modulación sale a 13.216 kg (89,1 kg/m²), en línea con Mahón (89 kg/m²). Es el 30 % del coste del sistema modular.
2. La fachada medida (166,2 m² opacos) coincide con la del proyecto (166,5 m²). En pareadas, cada vivienda cierra sus módulos: 68,3 m² de medianera con panel.
3. «Piloto dentro de la serie» reparte la ingeniería entre 16 y carga los gastos fijos al ritmo de 2 viviendas/mes. «Piloto aislado» carga toda la ingeniería y 1,5 meses de fábrica: es el coste real si después no hay serie.
4. Ahorros posibles que no están aplicados: rediseño del módulo (cada 10 kg/m² ≈ 3.900 €), un 8–12 % en las partidas iguales por fabricar en taller, y medianera compartida entre las dos viviendas del pareado.

Sheet: Supuestos
SUPUESTOS DEL ESTUDIO DEL PILOTO
Celdas rosadas con cifra en rojo minio = editables. Costes reales de fábrica de 2026; el margen se aplica una vez en el Resumen.
Concepto | Valor | Origen
Actualización de costes 2024→2026 | 12.0% | ACR 2025 +5,46 %; Banco de España abril 2026 +3,5 %
Coste del acero fabricado (€/kg): material, corte, soldadura, imprimación y pintura | 2.60 € | Material 0,80 €/kg en 2024 (Mahón) + soldadura propia
Mano de obra de fábrica (€/h) | 23.00 € | Nóminas DWHAI sep–nov 2024
Horas de montaje de panel por m² | 0.50 | Estimado
Merma de panel | 5.0%
Panel Tabihaus 8+50+8 (coste 2024 €/m²) | 42.00 € | Resumen Mahón 21/11/2024
Panel Tabihaus 8+65+8 (coste 2024 €/m²) | 52.00 € | Resumen Mahón 21/11/2024
Panel Tabihaus 8+120+8 (coste 2024 €/m²) | 64.00 € | Resumen Mahón 21/11/2024
Trasdosado interior con aislamiento (€/m²) | 31.85 € | Precio del proyecto (Knauf W625)
Suplemento de aislamiento para U = 0,20 en fachada (€/m²) | 10.00 € | PET 40 mm
Acabado exterior sobre panel (€/m²) | 45.00 € | ESTIMADO: placa de cemento + monocapa / aplacado. Pedir precio
Sistema de cubierta no transitable sobre panel (€/m²) | 88.80 € | Precio del proyecto (D08PD002)
Sistema de cubierta transitable sobre panel (€/m²) | 97.54 € | Precio del proyecto (QAB010b)
Sellado y tapajuntas entre módulos (€/m) | 25.00 € | Estimado
Colectores suspendidos bajo planta baja (€) | 941.45 € | Proyecto / 16
Ahorro de fábrica sobre las partidas que se hacen igual | 0.0% | Prudente en el piloto: 0 %
Sobrecoste de primera unidad sobre mano de obra de fábrica | 15.0% | Curva de aprendizaje del prototipo
Transporte por módulo (coste 2024 €) | 900 € | Sotopinilla 2024: 780 €
Suplemento de transporte especial del M4 (3,80 m de ancho, con acompañamiento) | 1200 € | ESTIMADO: pedir precio al transportista
Grúa: jornada completa (coste 2024 €) | 3120 € | Sotopinilla 2024 (Moreno)
Horas de montaje en parcela | 192 | 3 operarios × 8 días (primera unidad)
Dietas y desplazamientos sobre montaje | 15.0%
Ingeniería: cálculo modular y proyecto de fabricación (€) | 25000 € | Estimado, para toda la serie
Gastos fijos de fábrica sin mano de obra (€/mes) | 20430 € | Nave, oficina técnica, gestión, suministros, seguros
Viviendas al mes en serie | 2.00
Meses de fábrica imputados al piloto si se fabrica aislado | 1.50 | Primera unidad sin otras obras en la nave
Margen de referencia con el que se calculó la oferta (el precio ya está cerrado) | 10.0% | Oferta aceptada por NIDO: 225.400 € piloto, 209.100 € pareada en serie
GG + BI de una contrata tradicional sobre PEM | 19.0%

Sheet: Módulos
MODULACIÓN DE LA VIVIENDA PAREADA (piloto)
Seis módulos de acero, tres por planta, sin cambiar la distribución: anchos de 3,20 / 2,30 / 2,35 m (juntas a 3,20 y 5,50 m en planta baja). La planta primera vuela 0,60 m en frente y lateral; el vuelo lateral va dentro del M4, que mide 3,80 m de ancho. La junta a 3,20 m cruza el dormitorio 1 y se oculta en suelo y techo.
Módulo | Planta | Ancho (m) | Largo (m) | Alto (m) | Superficie (m²) | Qué contiene
M1 | PB | 3.20 | 9.50 | 3.05 |  | Dormitorio 1, cocina, salón
M2 | PB | 2.30 | 9.50 | 3.05 |  | Vestíbulo, escalera, salón
M3 | PB | 2.35 | 9.50 | 3.05 |  | Baño 1, lavadero, escalera, salón (medianera)
M4 | P1 | 3.80 | 8.47 | 3.05 |  | Dormitorio 3, baño 2, dormitorio principal · vuelos frontal y lateral de 0,60 dentro del módulo
M5 | P1 | 2.30 | 8.47 | 3.05 |  | Dormitorio 2, distribuidor, escalera, dormitorio principal
M6 | P1 | 2.35 | 10.10 | 3.05 |  | Dormitorio 2, escalera, vestidor, baño principal (medianera)
TOTAL
Transporte: el módulo más alto mide unos 3,05 m; en góndola rebajada (0,85 m) queda en ≈ 3,90 m, dentro del límite de 4,00 m. Todos superan 2,55 m de ancho y viajan con autorización especial; el M4, de 3,80 m, además con vehículo de acompañamiento.

Sheet: Acero
MEDICIÓN DE ACERO POR ELEMENTO (tipología del proyecto de Mahón 182)
Mismos perfiles y cuantías de correas y secundaria que Mahón; marcos, pilares y vuelos medidos sobre la modulación de Névola.
Módulo | Elemento | Medición (m) | kg/m | kg
M1 | Vigas de marco IPE 200 (suelo y techo) | 50.80 | 22.96
M1 | Pilares IPE 160 (6 ud × 2.65 m) | 15.90 | 16.20
M1 | Correas de suelo HEA 100 (0,64 m/m², como Mahón) | 19.46 | 16.70
M1 | Correas de techo SHS 60.40.3 (1,94 m/m², como Mahón) | 58.98 | 4.42
M1 | Angular L 80.8 de apoyo de panel (2,34 kg/m², como Mahón) | 30.40 | 2.34
M2 | Vigas de marco IPE 200 (suelo y techo) | 47.20 | 22.96
M2 | Pilares IPE 160 (6 ud × 2.65 m) | 15.90 | 16.20
M2 | Correas de suelo HEA 100 (0,64 m/m², como Mahón) | 13.98 | 16.70
M2 | Correas de techo SHS 60.40.3 (1,94 m/m², como Mahón) | 42.39 | 4.42
M2 | Angular L 80.8 de apoyo de panel (2,34 kg/m², como Mahón) | 21.85 | 2.34
M3 | Vigas de marco IPE 200 (suelo y techo) | 47.40 | 22.96
M3 | Pilares IPE 160 (6 ud × 2.65 m) | 15.90 | 16.20
M3 | Correas de suelo HEA 100 (0,64 m/m², como Mahón) | 14.28 | 16.70
M3 | Correas de techo SHS 60.40.3 (1,94 m/m², como Mahón) | 43.30 | 4.42
M3 | Angular L 80.8 de apoyo de panel (2,34 kg/m², como Mahón) | 22.32 | 2.34
M4 | Vigas de marco IPE 200 (suelo y techo) | 41.48 | 22.96
M4 | Viga de borde frontal en vuelo IPE 220 | 7.60 | 26.86
M4 | Vigas de marco IPE 200 (suelo y techo) | -16.94 | 22.96
M4 | Viga de borde lateral en vuelo IPE 220 | 16.94 | 26.86
M4 | Pilares IPE 160 (6 ud × 2.65 m) | 15.90 | 16.20
M4 | Correas de suelo HEA 100 (0,64 m/m², como Mahón) | 20.60 | 16.70
M4 | Correas de techo SHS 60.40.3 (1,94 m/m², como Mahón) | 62.45 | 4.42
M4 | Angular L 80.8 de apoyo de panel (2,34 kg/m², como Mahón) | 32.19 | 2.34
M5 | Vigas de marco IPE 200 (suelo y techo) | 38.48 | 22.96
M5 | Viga de borde frontal en vuelo IPE 220 | 4.60 | 26.86
M5 | Pilares IPE 160 (6 ud × 2.65 m) | 15.90 | 16.20
M5 | Correas de suelo HEA 100 (0,64 m/m², como Mahón) | 12.47 | 16.70
M5 | Correas de techo SHS 60.40.3 (1,94 m/m², como Mahón) | 37.79 | 4.42
M5 | Angular L 80.8 de apoyo de panel (2,34 kg/m², como Mahón) | 19.48 | 2.34
M6 | Vigas de marco IPE 200 (suelo y techo) | 45.10 | 22.96
M6 | Viga de borde frontal en vuelo IPE 220 | 4.70 | 26.86
M6 | Pilares IPE 160 (8 ud × 2.65 m) | 21.20 | 16.20
M6 | Correas de suelo HEA 100 (0,64 m/m², como Mahón) | 15.19 | 16.70
M6 | Correas de techo SHS 60.40.3 (1,94 m/m², como Mahón) | 46.04 | 4.42
M6 | Angular L 80.8 de apoyo de panel (2,34 kg/m², como Mahón) | 23.73 | 2.34
General | Escalera metálica (zancas HEA 140 y peldaño) | 1.00 | 450.00
General | Refuerzos, remates y pletinas de arriostramiento (5,6 kg/m², como Mahón) | 149.97 | 5.59
 | TOTAL ACERO
 | kg por m² construido (148,30 m²)
 | Referencia Mahón (proyecto 182): 13.516 kg / 151,2 m² = 89 kg/m²

Sheet: Sistema modular
COSTE DEL SISTEMA MODULAR DEL PILOTO (estructura, envolvente y forjados)
Mediciones sobre la modulación. Sustituye estructura de hormigón, solera Cáviti, cubiertas, ladrillo, enfoscados, monocapa y aislamientos del proyecto.
Partida | Ud | Medición | Coste unitario | Importe | Medición / precio
Estructura de acero de los 6 módulos (hoja Acero) | kg
Panel 8+50+8 en fachadas opacas (con petos) | m² | 166.17 |  |  | Fachada bruta 188,2 m² − 22 m² de huecos (proyecto: 166,5 m²)
Panel 8+50+8 en medianera (cada vivienda cierra sus módulos) | m² | 68.30 |  |  | Planta baja 29,9 + planta primera 38,4 m²
Panel 8+50+8 en la cara inferior de los vuelos | m² | 10.77 |  |  | Vuelo de 0,60 m en frente y lateral
Trasdosado interior con aislamiento (fachada y medianera) | m² | 234.48 |  |  | Precio del proyecto
Suplemento de aislamiento para U = 0,20 | m² | 166.17
Acabado exterior sobre panel (fachadas y vuelos) | m² | 176.94 |  |  | ESTIMADO
Panel 8+65+8 de cubierta (planta primera + terraza) | m² | 84.38
Sistema de cubierta no transitable sobre panel | m² | 75.40 |  |  | Precio del proyecto
Sistema de cubierta transitable en terraza | m² | 8.98 |  |  | Precio del proyecto
Panel 8+120+8 en suelo de planta baja | m² | 74.58 |  |  | Sustituye a la solera Cáviti
Panel 8+65+8 en suelo de planta primera | m² | 75.40 |  |  | Sustituye al forjado unidireccional
Sellado y tapajuntas entre módulos | m | 73.04 |  |  | Juntas verticales y perímetro entre plantas
Colectores suspendidos bajo planta baja | ud | 1.00 |  |  | Como el proyecto
TOTAL SISTEMA MODULAR

Sheet: Partidas iguales
PARTIDAS QUE SE EJECUTAN IGUAL (mediciones y precios del proyecto, por vivienda)
Instalaciones, carpinterías, acabados, sanitarios y pruebas. Importe del proyecto / 16 viviendas.
Capítulo | Descripción | PEM por vivienda
C.03 | Saneamiento interior (bajantes) | 572.86 €
C.07 | Impermeabilización de zonas húmedas y aislamiento acústico | 849.18 €
C.08 | Tabiquería, falsos techos y mampara | 9471.83 €
C.09 | Alicatados, solados, peldaños, vierteaguas y albardillas | 10163.61 €
C.10 | Carpintería interior y armarios | 3924.09 €
C.11 | Carpintería exterior, recercados y barandillas | 12377.21 €
C.12 | Pintura | 3748.1 €
C.13 | Electricidad y telecomunicaciones | 13180.5 €
C.14 | Fontanería y aparatos sanitarios | 5829.69 €
C.15 | Climatización, ACS y ventilación | 18715.51 €
C.19 | Pruebas de servicio y de estanqueidad | 532.8 €
 | TOTAL

Sheet: Ahorros por calidades
MEMORIA DE CALIDADES DEL PROYECTO FRENTE A ALTERNATIVAS DE AHORRO (por vivienda pareada)
S = sistema modular o duplicidad (no cambia calidades) · M = marca o gama equivalente («o similar») · A = alcance de la memoria comercial. Ahorros estimados: confirmar con ofertas.
Capítulo | Partida | Proyecto | €/viv. proyecto | Alternativa | Ahorro €/viv. | Tipo
Climatización | Aerotermia | Vaillant aroTHERM plus uniTOWER biblock, 10,1 kW, A+++ | 8376 € | Panasonic Aquarea All in One o LG Therma V con depósito de 200 l, dimensionada a 8 kW (vivienda A+ de 125 m² útiles) | 2000 € | M
Climatización | Bomba circuladora | Ebara Ego Easy 25/80 aparte | 595 € | La integrada en el módulo hidráulico de la aerotermia (un solo circuito con colectores) | 400 € | S
Climatización | Suelo radiante | Polytherm Premium, panel termoconformado (35,86 €/m²) | 4483 € | Sistema estándar de panel liso (Uponor, Orkli o Giacomini) a unos 30 €/m² | 750 € | M
Tabiquería | Tabiques interiores | Knauf W112, doble placa por cara (29,94 €/m²) | 3910 € | Placa sencilla de 15 mm por cara (W111) entre estancias de la misma vivienda; W112 solo en baños y escalera | 1000 € | A
Techos | Falso techo de cuartos secos y húmedos | Knauf D47 suspendido con maestras (27,74 y 31,01 €/m²) | 3447 € | Placa atornillada directamente a las correas del techo del módulo, sin estructura suspendida | 1180 € | S
Techos | Falso techo exterior de placa de cemento | Aquapanel Outdoor bajo vuelos (101,73 €/m²) | 992 € | Ya incluido: el vuelo del módulo lleva panel con acabado exterior | 992 € | S
Fachada | Aplacado de gres en fachada | Porcelánico en capa fina sobre mortero (48,34 €/m², 31 m²) | 1504 € | Se mantiene el aplacado y se descuenta esa superficie del acabado exterior del panel (no duplicar) | 1400 € | S
Electricidad | Red de toma de tierra de estructura | Cable de 35 mm² soldado a la armadura de cada zapata (40,65 m) | 2061 € | Conexión equipotencial de los marcos de acero al anillo de cimentación del promotor | 1200 € | S
Electricidad | Punto de recarga de vehículo | Caja de recarga 2,3 kW instalada | 1242 € | Preinstalación (canalización y línea), que es lo que promete la memoria comercial | 890 € | A
Electricidad | Cuadro general | Electrificación elevada, 24 elementos, 12 circuitos | 1171 € | Mismo esquema montado en fábrica con aparamenta de gama media (Hager, Schneider Resi9) | 320 € | M
Electricidad | Videoportero | Digital 3 hilos + coaxial, monitor b/n 4" | 730 € | Kit de 2 hilos en color (Fermax o Golmar) | 280 € | M
Pavimentos | Tarima laminada | Terhürne Comfloor Akustec AC5/32, 8,5 mm (36,32 €/m²) | 3245 € | Laminado AC5 de 8 mm de fabricante nacional (Finsa, Faus) a unos 28 €/m² | 715 € | M
Pavimentos | Gres porcelánico interior, alicatado y peldaños | Porcelánico de 20 €/m² de material | 3918 € | Compra directa a fábrica de Castellón por volumen de 16 viviendas (unos 13 €/m² de material) | 700 € | M
Pintura | Pintura plástica | Sikkens Alphalux SF (8,11 y 10,45 €/m²) | 3748 € | Plástica mate lavable profesional (Titan, Jotun o Bruguer) | 850 € | M
Carpintería exterior | Ventanas y puertas balconeras | PVC Kömmerling Eurofutur 70, foliado RAL 7016, persiana | 8012 € | Perfil equivalente de 70 mm (Veka Softline o Rehau Euro-Design) con el mismo foliado y vidrio | 650 € | M
Carpintería exterior | Recercado de huecos | Chapa de aluminio lacado, desarrollo 400 mm (29,03 €/m) | 1681 € | Pliegues de chapa galvanizada lacada fabricados en el propio taller | 520 € | S
Carpintería exterior | Barandilla de terraza | Comenza GlassFit SV-1401 Top (197,86 €/m) | 1408 € | Vidrio laminar con perfil de base genérico, misma imagen | 340 € | M
 |  |  |  | Ahorro por sistema modular y duplicidades (S)
 |  |  |  | Ahorro por marca o gama equivalente (M)
 |  |  |  | Ahorro por alcance (A)
 |  |  |  | AHORRO TOTAL DE COSTE POR VIVIENDA
 |  |  |  | Bajada de precio con margen
 |  |  |  | Precio del piloto (serie) con los ahorros

Sheet: Escenarios de margen
ESCENARIOS DE MARGEN Y PARTIDAS QUE FALTAN EN EL COSTE
Celdas rosadas con cifra en rojo minio = editables. El coste del modelo ya incluye la mano de obra de fábrica y de montaje a coste empresa (nómina + Seguridad Social, 23 €/h de 2024).
Supuesto | Valor |  |  |  | Origen
Operarios de fábrica al arrancar | 6 |  |  |  | Iván, 13/10/2026
Horas productivas por operario y mes | 146.70 |  |  |  | 1.760 h/año / 12
Nómina + Seguridad Social con 9 operarios (€/mes, 2024) | 28250 € |  |  |  | Nóminas DWHAI sep–nov 2024
Subida salarial 2024→2026 (convenio del metal y SMI) | 8.0% |  |  |  | ESTIMADO: confirmar con el convenio aplicable
Estructura de RG21: dirección, comercial y administración, con SS (€/mes) | 8000 € |  |  |  | Iván, 13/10/2026
Garantía y posventa (% del coste) | 1.0% |  |  |  | Habitual 0,5–1,5 %
Imprevistos (% del coste) | 3.0% |  |  |  | Primera serie: 3–5 %
Coste de la pareada en serie (modelo, a 2 viviendas/mes) | 190091 € |  |  |  | Presupuesto técnico a 90 kg/m²: 209.100 € / 1,10
Coste de la aislada en serie (modelo, a 2 viviendas/mes) | 194636 € |  |  |  | 214.100 € / 1,10
Precio ofertado del piloto (dentro de la serie) | 225400 € |  |  |  | Propuesta integral, 14/10/2026: 10 % sobre el coste del modelo
Precio ofertado del piloto aislado | 273600 € |  |  |  | Propuesta integral, 14/10/2026
Precio ofertado de la pareada en serie | 209100 € |  |  |  | Propuesta integral, 14/10/2026
Precio ofertado de la aislada en serie | 214100 € |  |  |  | Propuesta integral, 14/10/2026
Horas de fábrica por vivienda (acero y panel) |  |  |  |  | Sale del modelo
Viviendas al mes con esa plantilla |  |  |  |  | El modelo supone 2 al mes
Meses de fábrica para las 16 viviendas
Nómina + SS de la plantilla de arranque (€/mes, 2024) |  |  |  |  | Proporcional a 9 operarios
PARTIDAS QUE FALTAN O ESTÁN A PRECIO DE 2024 (por vivienda)
Concepto | Piloto en serie | Piloto aislado | Pareada en serie | Aislada en serie | Comentario
Mano de obra de fábrica y montaje a salarios de 2026 |  |  |  |  | Los 23 €/h son de 2024 y no llevan IPC
Gastos fijos de fábrica a precios de 2026 |  |  |  |  | Los 20.430 €/mes son de 2024
Gastos fijos repartidos al ritmo real de la plantilla |  |  |  |  | El modelo los reparte entre 2 viviendas al mes
Plantilla parada en el piloto aislado |  |  |  |  | Sin serie, la nómina se paga entera aunque haya pocas horas que cargar
Estructura de RG21 (dirección, comercial, administración, con SS) |  |  |  |  | No está en el modelo
Garantía y posventa
Imprevistos
Total de lo que falta
Coste del modelo
COSTE COMPLETO
Precio ofertado a NIDO
Margen según el modelo (% sobre venta)
MARGEN REAL con el precio ofertado (€)
MARGEN REAL (% sobre venta)
ESCENARIOS: PRECIO SEGÚN EL MARGEN SOBRE EL COSTE COMPLETO
Margen sobre coste (y sobre venta) | Piloto en serie | Pareada en serie | 16 viviendas (14 + 2) | Margen de las 16 | Frente a la oferta de las 16 (3.355.600 €)
0 % (precio mínimo: solo coste)
5 % (4,8 % sobre venta)
8 % (7,4 % sobre venta)
10 % (9,1 % sobre venta)
12 % (10,7 % sobre venta)
15 % (13,0 % sobre venta)
22 % (18,0 % sobre venta)
25 % (20,0 % sobre venta)
PAREADA EN SERIE SEGÚN LA PLANTILLA DE FÁBRICA (resto de supuestos como arriba)
Operarios | Viviendas/mes | Meses para las 16 | Coste completo | Margen al precio ofertado | Precio para un 18 % sobre venta
6
9
12
15
LECTURA
1. La mano de obra de fábrica y de montaje entra a coste empresa, con Seguridad Social: 23 €/h, de las nóminas de DWHAI. Es de 2024 y no lleva actualización.
2. Instalaciones, carpinterías y acabados van a precio del proyecto, que ya incluye su mano de obra y sus cargas sociales.
3. El ritmo lo marca la plantilla: cada vivienda lleva unas 1.080 h de fábrica de acero y panel. Con 6 operarios sale menos de una vivienda al mes, y la nave, la oficina técnica y la estructura se reparten entre muy pocas casas.
4. Las horas son solo de acero y panel. Si la misma plantilla hace también pladur o instalaciones, el ritmo baja todavía más (esas horas las paga el precio de la partida).
5. Acero a 2,60 €/kg fabricado: en 2024 la estructura soldada real salió entre 3 y 4,9 €/kg. Cada 0,40 €/kg más son unos 5.300 € por vivienda.
6. Si los 8.000 €/mes de estructura incluyen la gestión (3.830) o la oficina técnica (6.100) de los gastos fijos de fábrica, hay que quitarlas de la hoja Supuestos para no contarlas dos veces.
