teyame109-dev/Modular-Home/costes/Presupuesto_Nevola_chalet_tipoA.xlsx

Sheet: Resumen
NÉVOLA (Guadalix de la Sierra): 16 chalets en sistema modular. Estimación de precio
Promotor: Nido Capital. Base: dossier comercial del 22/07/2025 (planos de presentación y memoria de calidades orientativa). Precios: banco de precios Tini/DWHAI 2024, actualizado.
Capítulo | Pareada | Independiente | €/m² pareada | % del total
01 ESTRUCTURA METÁLICA DE MÓDULOS | 43504.5492 € | 43504.5492 € | 293.3550182 € | 19.3%
02 ENVOLVENTE: FACHADA Y MEDIANERA | 27389.44912 € | 25737.51568 € | 184.6894749 € | 12.1%
03 CUBIERTA PLANA | 16331.6608 € | 16331.6608 € | 110.1258314 € | 7.2%
04 SUELOS Y FORJADO ENTRE PLANTAS | 17784.3846 € | 17784.3846 € | 119.9216763 € | 7.9%
05 ELECTRICIDAD Y TELECOMUNICACIONES | 9609.02 € | 9609.02 € | 64.79447067 € | 4.3%
06 FONTANERÍA, SANEAMIENTO Y SANITARIOS | 5412.2736 € | 5412.2736 € | 36.49543898 € | 2.4%
07 CLIMATIZACIÓN, ACS Y VENTILACIÓN | 22893.10456 € | 22893.10456 € | 154.3702263 € | 10.2%
08 CARPINTERÍA EXTERIOR | 18395.658 € | 18395.658 € | 124.0435469 € | 8.2%
09 ACABADO EXTERIOR DE FACHADA | 9595.48032 € | 14224.79232 € | 64.70317141 € | 4.3%
10 TABIQUERÍA, TECHOS Y PINTURA | 17507.5695 € | 17507.5695 € | 118.0550877 € | 7.8%
11 PAVIMENTOS Y ESCALERA | 9311.238 € | 9311.238 € | 62.78650034 € | 4.1%
12 CARPINTERÍA INTERIOR | 10735.2 € | 10735.2 € | 72.38840189 € | 4.8%
13 TRANSPORTE, MONTAJE Y ENTREGA | 17000.82 € | 17000.82 € | 114.638031 € | 7.5%
PRECIO DE FÁBRICA POR VIVIENDA | 225470.4077 € | 228447.7863 € | 1520.366876 €
Margen de la empresa vendedora (gastos generales + beneficio) | 27056.44892 € | 27413.73435 €
PRECIO DE VENTA AL PROMOTOR: VIVIENDA PILOTO (sin IVA) | 252526.8566 € | 255861.5206 € | 1702.810901 €
SERIE COMPLETA: 16 VIVIENDAS
Concepto | Unidades | Precio unitario | Importe
Viviendas pareadas | 14 | 237375.2452 € | 3323253.433 €
Viviendas independientes | 2 | 240509.8294 € | 481019.6588 €
TOTAL SERIE (sin IVA) | 16 |  | 3804273.092 €
€/m² construido medio de la serie |  |  | 1603.284344 €
Precio de serie = precio piloto con el descuento por volumen de «Supuestos». Aplicado a todo el precio: es una simplificación.
QUÉ INCLUYE Y QUÉ NO
INCLUYE | Vivienda terminada en fábrica según la memoria de calidades: estructura, envolvente, cubierta, instalaciones (electricidad, fontanería, suelo radiante, aerotermia, ventilación), carpinterías, acabados y sanitarios. Transporte, grúa, montaje y limpieza.
NO INCLUYE | Cimentación (losa o zapatas) y soleras. Acometidas y urbanización. Terraza y jardín de planta baja, cerramientos de parcela, garaje y zonas comunes (piscina, huerto, jardín).
NO INCLUYE | Muebles de cocina (el dossier la entrega sin amueblar), electrodomésticos, piscina privada.
NO INCLUYE | Proyecto, dirección facultativa, OCT, seguro decenal, licencias, tasas, estudio geotécnico, ensayos y coordinación de seguridad y salud.
REFERENCIA | Obra in situ en Menorca Pino 2024 (cimentación, urbanización, acometidas y cerramiento): 89.194 € para 165 m² (≈ 541 €/m²). Solo orientativo: Menorca no es la Sierra de Madrid.
PUNTOS A CERRAR ANTES DE ENVIAR LA OFERTA
1. Sistema constructivo: la memoria prevé estructura de hormigón y fachadas con cámara. El promotor tiene que aceptar el cambio a módulo de acero + panel Tabihaus, y el proyecto de ejecución, el OCT y el seguro decenal tienen que admitirlo.
2. Acero: estimado a 90 kg/m². Con dos plantas, el cálculo de estructura puede subirlo. Pedir a los soldadores el precio actual del kg soldado (en 2024 costó entre 3 y 4,9 €/kg y se vendió a 2,80).
3. Pedir precio a Tabihaus (paneles 66, 81 y 136 mm, y 8+20+8) y a un carpintero de PVC con persiana monoblock: son las partidas más grandes después de la estructura.
4. Medidas: ancho y fondo medidos en un plano de presentación. Confirmar con el proyecto básico y ver si los módulos de 2,67 m encajan con la distribución (salón de 28,7 m² y escalera).
5. Ubicación de la fábrica en 2026: el transporte está calculado desde Seseña.

Sheet: Supuestos
NÉVOLA: chalet tipo A pasado a sistema modular (datos de partida)
Amarillo = dato que puedes cambiar. Todo el presupuesto se recalcula a partir de esta hoja.
Concepto | Valor | Origen / comentario
Superficie construida planta baja (m²) | 74.58 | Dossier comercial, vivienda tipo A (pág. 13)
Superficie construida planta primera (m²) | 73.72 | Dossier comercial, vivienda tipo A
TOTAL SUPERFICIE CONSTRUIDA (m²) | 148.30 | 148,30 m²; con terrazas, 182,10 m²
Superficie útil (m²) | 123.71 | Suma de estancias del plano: 62,19 en planta baja + 61,52 en planta primera
Terraza de planta primera (m²) | 9.59 | La terraza de planta baja (24,48 m²) es obra in situ: queda fuera
Ancho de la vivienda (m) | 8.00 | Medido en el plano con la escala gráfica. Comprobar con el proyecto
Fondo de la vivienda (m) | 9.40 | Medido en el plano con la escala gráfica (8,0 × 9,4 ≈ 75 m² por planta)
Módulos por planta | 3 | Módulos de ≈2,67 m de ancho: transporte normal sin escolta
Plantas | 2
Nº de módulos por vivienda | 6
Ancho de cada módulo (m) | 2.67
Altura exterior de módulo (m) | 3.00 | Pilar de 2,55 m más vigas de suelo y techo (sistema Tini)
Perímetro de fachada por planta (m) | 34.80
Fachada bruta, todas las caras (m²) | 208.80
% de huecos sobre fachada | 17.0% | Estimado con los planos: grandes ventanales al salón y a los dormitorios
Superficie de huecos / carpintería (m²) | 35.50
Medianera en pareados (m²) | 56.40 | Lleva panel, pero no acabado exterior. Doble placa por protección contra incendios
Ratio de acero (kg por m² construido) | 90 | El Boalo 91 kg/m², Menorca 84, Sotopinilla 79. Dos plantas: se toma el alto
Acero estructural (kg) | 13347 | Hasta tener el cálculo de estructura
Tabiquería interior (m² de tabique por m² construido) | 0.90 | Menorca Pino: 0,90
Tabiquería interior (m²) | 133.47
Zonas húmedas con gres (m²) | 27.13 | Cocina 8,49 + lavadero 3,98 + baños 3,65 + 3,89 + 7,12
Escalera, superficie en planta (m²) | 6.95 | 2,29 + 4,66
Tarima laminada AC5 (m²) | 89.63 | Superficie útil menos zonas húmedas y escalera
Alicatado de baños y frente de cocina (m²) | 56.00 | Estimado: 2 baños × 20 m² + aseo 12 m² + cocina 4 m²
Puertas interiores de paso | 10 | Contadas en el plano
Baños completos | 2 | Baño 2 con bañera; baño principal con ducha y lavabo doble
Aseos | 1 | Baño 1 de planta baja, con ducha
Canalón (m) | 16.00
Albardilla / remate de cubierta (m) | 34.80
Barandilla de vidrio, terraza de planta primera (m) | 8.00 | Estimado en el plano
Pliegues y remates de huecos (m) | 60.00 | Estimado a partir de la superficie de huecos
Rodapié (m) | 110.00 | Perímetro de las estancias secas, estimado
Actualización de precios 2024→2026 | 8.0% | Supuesto. Sustituir por precios reales de proveedor en las partidas grandes
Horas de montaje in situ por vivienda | 192 | Supuesto: 3 operarios × 8 días (uniones, juntas, remates, conexión de instalaciones)
Precio hora de montaje (€/h) | 40.00 € | Coste completo de fábrica 2024 ≈ 40 €/h. En 2024 se vendía a 30 €/h (por debajo del coste)
Transporte por módulo (€) | 900 € | Sotopinilla 2024: 780 €/módulo (Moreno). Guadalix: <100 km de Seseña
Grúa por vivienda (€) | 3120 € | Sotopinilla 2024 (Moreno). Con 16 viviendas seguidas debería bajar
Viviendas pareadas | 14 | Plano general: 01-02, 03-04, 06-07, 08-09, 11-12, 13-14 y 15-16
Viviendas independientes | 2 | Viviendas 05 y 10
Descuento por volumen en la serie de 16 | 6.0% | Supuesto: compras de acero, panel y carpintería por 16 viviendas
Margen sobre precio de fábrica (gastos generales + beneficio) | 12.0% | Los precios del banco ya llevan el margen de fábrica de DWHAI. Este es el margen de la empresa que vende al promotor (Tini ponía un 35 %)

Sheet: Presupuesto vivienda
PRESUPUESTO POR PARTIDAS: CHALET TIPO A NÉVOLA EN SISTEMA MODULAR (fabricación, transporte y montaje)
Precio 2026 = precio de banco 2024 × (1 + actualización). Fondo naranja = partida sin referencia en el banco: precio ESTIMADO, pedir oferta a proveedor.
La cantidad «independiente» solo cambia en la medianera: la independiente tiene cuatro fachadas con acabado.
Código | Descripción | Ud | Medición | Cant. pareada | Cant. independiente | Precio 2024 (banco) | Referencia del precio | PRECIO 2026 | Importe pareada | Importe independiente
01 | ESTRUCTURA METÁLICA DE MÓDULOS |  |  |  |  |  |  |  | 43504.5492 € | 43504.5492 €
EST | Acero S275JR en pilares, vigas, correas, refuerzos y pletinas, soldado en fábrica | kg | Ratio kg/m² × m² construidos | 13347.00 | 13347.00 | 2.80 € | Todos los proyectos 2024: 2,80 €/kg | 3.02 € | 40361.33 € | 40361.33 €
EST_PN_GIM | Granallado e imprimación | kg | = acero | 13347.00 | 13347.00 | 0.11 € | Fenwick, Sotopinilla, El Boalo | 0.12 € | 1585.62 € | 1585.62 €
EST_PN_PPV | Pintura de poliuretano (tratamiento C2-C3) | kg | = acero | 13347.00 | 13347.00 | 0.10 € | Sotopinilla 0,10 · Fenwick 0,15 | 0.11 € | 1441.48 € | 1441.48 €
EST_PL_AG | Agarraderas de izado (4 por módulo) | u | 4 × nº de módulos | 24.00 | 24.00 | 4.48 € | Fenwick, Menorca | 4.84 € | 116.12 € | 116.12 €
02 | ENVOLVENTE: FACHADA Y MEDIANERA |  |  |  |  |  |  |  | 27389.44912 € | 25737.51568 €
FAC_SAN_TAH | Panel sándwich Tabihaus 8+50+8 (66 mm) en fachada y medianera | m² | Fachada bruta − huecos | 173.30 | 173.30 | 75.00 € | El Boalo 75 €/m² · Menorca oct-24 82,42 €/m² | 81.00 € | 14037.62 € | 14037.62 €
FAC_ATR | Aislamiento térmico reflexivo | m² | = panel de fachada | 173.30 | 173.30 | 11.25 € | Todos los proyectos | 12.15 € | 2105.64 € | 2105.64 €
FAC_PET80 | Aislamiento de PET reciclado de 80 mm | m² | = panel de fachada | 173.30 | 173.30 | 15.70 € | Todos los proyectos | 16.96 € | 2938.54 € | 2938.54 €
FAC_U46 | Perfilería U 46 mm cada 60 cm (trasdosado interior) | m² | = panel de fachada | 173.30 | 173.30 | 22.00 € | Todos los proyectos | 23.76 € | 4117.70 € | 4117.70 €
TAB_PYL13 | Placa de yeso laminado de 13 mm en trasdosado de fachada | m² | = panel de fachada | 173.30 | 173.30 | 13.56 € | Banco (TAB_PYL13) | 14.64 € | 2538.00 € | 2538.00 €
TAB_2PLA | Doble placa en medianera (protección contra incendios entre viviendas) | m² | Solo pareadas | 56.40 | 0.00 | 27.12 € | Menorca (TAB_2PLA) | 29.29 € | 1651.93 € | 0.00 €
03 | CUBIERTA PLANA |  |  |  |  |  |  |  | 16331.6608 € | 16331.6608 €
CUB_SAN_TAH | Panel sándwich Tabihaus 8+65+8 (81 mm) de cubierta | m² | Planta primera | 73.72 | 73.72 | 65.00 € | El Boalo 65 · Menorca oct-24 58,37 | 70.20 € | 5175.14 € | 5175.14 €
CUB_ATR | Aislamiento térmico reflexivo | m² | = cubierta | 73.72 | 73.72 | 11.25 € | Todos los proyectos | 12.15 € | 895.70 € | 895.70 €
CUB_XPS60 | Aislamiento XPS 60 mm | m² | = cubierta | 73.72 | 73.72 | 10.00 € | Todos los proyectos | 10.80 € | 796.18 € | 796.18 €
CUB_PET40 | Aislamiento de PET reciclado 40 mm | m² | = cubierta | 73.72 | 73.72 | 10.00 € | Todos los proyectos | 10.80 € | 796.18 € | 796.18 €
CUB_TAB | Impermeabilización: tela asfáltica bicapa | m² | = cubierta | 73.72 | 73.72 | 36.00 € | Todos los proyectos | 38.88 € | 2866.23 € | 2866.23 €
CUB_GRA | Acabado de grava en zona no transitable | m² | Cubierta − terraza | 64.13 | 64.13 |  | ESTIMADO (no está en el banco) | 12.00 € | 769.56 € | 769.56 €
CUB_CAN | Canalón de chapa plegada de 2 mm | m | Supuestos | 16.00 | 16.00 | 38.00 € | Todos los proyectos | 41.04 € | 656.64 € | 656.64 €
CUB_GAR | Gárgola metálica con pieza de EPDM | u | 3 por vivienda | 3.00 | 3.00 | 52.00 € | Todos los proyectos | 56.16 € | 168.48 € | 168.48 €
CUB_ALB | Albardilla de chapa plegada galvanizada de 2 mm | m | Perímetro de cubierta | 34.80 | 34.80 | 25.05 € | Todos los proyectos | 27.05 € | 941.48 € | 941.48 €
TER_GRES | Gres exterior antideslizante en terraza de planta primera | m² | Supuestos | 9.59 | 9.59 | 45.00 € | Banco (PAV_SOCE, solado cerámico) | 48.60 € | 466.07 € | 466.07 €
TER_BAR | Barandilla de vidrio de seguridad en terraza | m | Supuestos | 8.00 | 8.00 |  | ESTIMADO (en el banco solo hay malla: 217,80 €/m) | 350.00 € | 2800.00 € | 2800.00 €
04 | SUELOS Y FORJADO ENTRE PLANTAS |  |  |  |  |  |  |  | 17784.3846 € | 17784.3846 €
SUE_SAN_136 | Panel sándwich Tabihaus 8+120+8 (136 mm), suelo de planta baja | m² | Planta baja | 74.58 | 74.58 | 99.00 € | El Boalo 99 · Menorca oct-24 86,09 | 106.92 € | 7974.09 € | 7974.09 €
SUE_SAN_81 | Panel sándwich Tabihaus 8+65+8, suelo de módulos de planta primera | m² | Planta primera | 73.72 | 73.72 | 65.00 € | El Boalo (SUE 8+65+8) 65 | 70.20 € | 5175.14 € | 5175.14 €
SUE_TEC_40 | Panel Tabihaus 8+20+8, techo de módulos de planta baja | m² | Planta baja | 74.58 | 74.58 |  | ESTIMADO: coste de lista 40 €/m² (Mahón) + margen | 50.00 € | 3729.00 € | 3729.00 €
SUE_ATR | Aislamiento térmico reflexivo bajo forjado | m² | Planta baja | 74.58 | 74.58 | 11.25 € | Menorca, El Boalo | 12.15 € | 906.15 € | 906.15 €
05 | ELECTRICIDAD Y TELECOMUNICACIONES |  |  |  |  |  |  |  | 9609.02 € | 9609.02 €
ELE_M2 | Instalación eléctrica completa (cuadro, circuitos, mecanismos Niessen o similar, iluminación, TV y datos en estancias) | m² | m² construidos | 148.30 | 148.30 | 55.00 € | Ratio: Sotopinilla 61 €/m² · Menorca 39 €/m² (sin el error de la toma de tierras) | 59.40 € | 8809.02 € | 8809.02 €
ELE_POR | Portero automático | u | 1 | 1.00 | 1.00 |  | ESTIMADO | 350.00 € | 350.00 € | 350.00 €
ELE_VE | Preinstalación de punto de recarga de vehículo eléctrico | u | 1 | 1.00 | 1.00 |  | ESTIMADO | 450.00 € | 450.00 € | 450.00 €
06 | FONTANERÍA, SANEAMIENTO Y SANITARIOS |  |  |  |  |  |  |  | 5412.2736 € | 5412.2736 €
BAN_INS | Instalación completa de fontanería y saneamiento por baño o aseo | u | Baños + aseo | 3.00 | 3.00 | 494.00 € | Todos los proyectos | 533.52 € | 1600.56 € | 1600.56 €
09TLAV | Tomas de agua y desagüe: cocina, lavadora, secadora y pila de lavadero | u | 4 tomas | 4.00 | 4.00 | 75.00 € | Menorca (toma de lavadora) | 81.00 € | 324.00 € | 324.00 €
BAN_IMP | Impermeabilización de plato de ducha | u | 2 duchas | 2.00 | 2.00 | 50.00 € | Todos los proyectos | 54.00 € | 108.00 € | 108.00 €
BAN_INO | Inodoro de porcelana vitrificada (Gala o similar) | u | 3 | 3.00 | 3.00 |  | ESTIMADO: gama media (en 2024 se usó Tesi suspendido, 811 €) | 280.00 € | 840.00 € | 840.00 €
BAN_LAV | Lavabo de porcelana (baño principal con lavabo doble) | u | 4 | 4.00 | 4.00 | 96.38 € | Banco (Starbath) | 104.09 € | 416.36 € | 416.36 €
BAN_GRI_ETN | Grifería monomando de lavabo | u | 4 | 4.00 | 4.00 | 57.60 € | Banco (Imex Etna) | 62.21 € | 248.83 € | 248.83 €
BAN_DUC_THA | Conjunto de ducha monomando | u | 2 | 2.00 | 2.00 | 159.50 € | Banco (Imex Thalos) | 172.26 € | 344.52 € | 344.52 €
BAN_DUC_PLA | Plato de ducha extraplano 80×100 | u | 2 | 2.00 | 2.00 | 300.00 € | Banco (BAN_DUC_PLA_80X100) | 324.00 € | 648.00 € | 648.00 €
BAN_BAN | Bañera acrílica blanca con grifería | u | 1 | 1.00 | 1.00 |  | ESTIMADO | 450.00 € | 450.00 € | 450.00 €
BAN_MAM | Mampara de vidrio (baño principal) | u | 1 | 1.00 | 1.00 | 400.00 € | Menorca oct-24, El Boalo | 432.00 € | 432.00 € | 432.00 €
07 | CLIMATIZACIÓN, ACS Y VENTILACIÓN |  |  |  |  |  |  |  | 22893.10456 € | 22893.10456 €
CLI_RAD_SUE | Suelo radiante y refrescante | m² | Superficie útil | 123.71 | 123.71 | 74.20 € | Banco (CLI_RAD_SUE) | 80.14 € | 9913.62 € | 9913.62 €
AER_120_150 | Aerotermia Panasonic para 120–150 m² (climatización y ACS) | u | 1 | 1.00 | 1.00 | 9731.00 € | Banco (Fenwick, catálogo) | 10509.48 € | 10509.48 € | 10509.48 €
CLI_TER | Termostatos por estancia | u | 5 | 5.00 | 5.00 | 50.00 € | Banco (CLI_TER_AAC) | 54.00 € | 270.00 € | 270.00 €
VEN_MEC | Ventilación mecánica de simple flujo (extracción en baños y cocina, admisión en secos) | u | 1 | 1.00 | 1.00 |  | ESTIMADO (no está en el banco) | 2200.00 € | 2200.00 € | 2200.00 €
08 | CARPINTERÍA EXTERIOR |  |  |  |  |  |  |  | 18395.658 € | 18395.658 €
CAE_PVC | Carpintería de PVC o aluminio con RPT, vidrio bajo emisivo, con persiana monoblock | m² | Superficie de huecos | 35.50 | 35.50 |  | ESTIMADO: 400 €/m². COR-Vision 2024 ≈ 500–590 €/m² en aluminio de gama alta | 400.00 € | 14198.40 € | 14198.40 €
LEA010 | Puerta de entrada acorazada | u | 1 | 1.00 | 1.00 | 1786.35 € | Banco (LEA010) | 1929.26 € | 1929.26 € | 1929.26 €
ACF_PLA | Pliegues y remates de chapa en huecos | m | Supuestos | 60.00 | 60.00 | 35.00 € | Menorca, Fenwick | 37.80 € | 2268.00 € | 2268.00 €
09 | ACABADO EXTERIOR DE FACHADA |  |  |  |  |  |  |  | 9595.48032 € | 14224.79232 €
ACF_ENF | Revestimiento exterior mixto: placa de cemento con acabado continuo o piezas cerámicas o metálicas | m² | Fachada − huecos − medianera | 116.90 | 173.30 | 76.00 € | Banco (ACF_ENF, Aquapanel con enfoscado). Madera 106 · Viroc 58 · minionda 46 | 82.08 € | 9595.48 € | 14224.79 €
10 | TABIQUERÍA, TECHOS Y PINTURA |  |  |  |  |  |  |  | 17507.5695 € | 17507.5695 €
TAB_INT | Tabique de PYL: perfilería, PET 40 mm y placa de 13 mm por las dos caras | m² | Ratio × m² construidos | 133.47 | 133.47 | 59.12 € | Compuesto con el banco: perfil 22 + PET 10 + 2 × placa 13,56 | 63.85 € | 8522.01 € | 8522.01 €
TAB_HID | Suplemento de placa hidrófuga en zonas húmedas | m² | Alicatado + 20 % | 67.20 | 67.20 | 5.47 € | Diferencia hidrófuga − normal (19,03 − 13,56) | 5.91 € | 396.99 € | 396.99 €
TAB_CER | Alicatado de gres en baños y frente de cocina | m² | Supuestos | 56.00 | 56.00 | 45.00 € | Menorca, El Boalo | 48.60 € | 2721.60 € | 2721.60 €
TEC_PLA | Techo de placa de yeso laminado de 15 mm | m² | Superficie útil | 123.71 | 123.71 | 13.56 € | Todos los proyectos | 14.64 € | 1811.71 € | 1811.71 €
TEC_PLH | Suplemento hidrófugo en techos de zonas húmedas | m² | Zonas húmedas | 27.13 | 27.13 | 5.47 € | Diferencia hidrófuga − normal | 5.91 € | 160.27 € | 160.27 €
114PPLAS | Pintura plástica lisa en paredes | m² | Tabiques × 2 caras + trasdosado de fachada − alicatado | 384.24 | 384.24 | 7.10 € | Menorca | 7.67 € | 2946.38 € | 2946.38 €
TEC_PIN_B | Pintura blanca mate en techos | m² | Superficie útil | 123.71 | 123.71 | 7.10 € | Menorca | 7.67 € | 948.61 € | 948.61 €
11 | PAVIMENTOS Y ESCALERA |  |  |  |  |  |  |  | 9311.238 € | 9311.238 €
PAV_LAM | Tarima laminada sintética AC5 | m² | Supuestos | 89.63 | 89.63 |  | ESTIMADO (en el banco solo hay roble, 78 €/m²) | 32.00 € | 2868.16 € | 2868.16 €
PAV_SOCE | Solado de gres en baños, cocina y lavadero | m² | Zonas húmedas | 27.13 | 27.13 | 45.00 € | Banco (PAV_SOCE) | 48.60 € | 1318.52 € | 1318.52 €
PAV_RODMPVC | Rodapié a juego con la carpintería interior | m | Supuestos | 110.00 | 110.00 | 16.20 € | Todos los proyectos | 17.50 € | 1924.56 € | 1924.56 €
ESC | Escalera interior: estructura metálica con peldaños de gres | u | 1 | 1.00 | 1.00 |  | ESTIMADO: coste 2024 de escalera instalada 2.275 € (Guadalajara) | 3200.00 € | 3200.00 € | 3200.00 €
12 | CARPINTERÍA INTERIOR |  |  |  |  |  |  |  | 10735.2 € | 10735.2 €
CAI_PUE_DML_1HA72 | Puerta de paso lacada lisa de 725 mm, abatible | u | Contadas en el plano | 10.00 | 10.00 | 744.00 € | Banco | 803.52 € | 8035.20 € | 8035.20 €
CAI_ARM | Armario empotrado de 2 puertas en distribuidor (revestido, balda y barra) | u | 1 | 1.00 | 1.00 |  | ESTIMADO: la mitad del armario de 4 puertas de Menorca (2.866 €) | 1500.00 € | 1500.00 € | 1500.00 €
CAI_VES | Vestidor abierto en dormitorio principal (revestido, maletero y barra) | u | 1 | 1.00 | 1.00 |  | ESTIMADO | 1200.00 € | 1200.00 € | 1200.00 €
13 | TRANSPORTE, MONTAJE Y ENTREGA |  |  |  |  |  |  |  | 17000.82 € | 17000.82 €
TRA | Transporte de módulos de Seseña a Guadalix de la Sierra | u | Nº de módulos | 6.00 | 6.00 |  | Supuestos (Sotopinilla 2024: 780 €/módulo) | 900.00 € | 5400.00 € | 5400.00 €
GRU | Grúa para colocación | u | 1 por vivienda | 1.00 | 1.00 |  | Supuestos (Sotopinilla 2024: 3.120 €) | 3120.00 € | 3120.00 € | 3120.00 €
OPE | Montaje in situ: uniones, juntas de fachada y cubierta, conexión de instalaciones | h | Supuestos | 192.00 | 192.00 |  | Supuestos (coste completo de fábrica ≈ 40 €/h) | 40.00 € | 7680.00 € | 7680.00 €
LIM | Limpieza final | m² | m² construidos | 148.30 | 148.30 | 5.00 € | Todos los proyectos | 5.40 € | 800.82 € | 800.82 €
 | PRECIO DE FÁBRICA POR VIVIENDA (fabricación + transporte + montaje) |  |  |  |  |  |  |  | 225470.4077 € | 228447.7863 €
 | €/m² construido |  |  |  |  |  |  |  | 1520.366876 € | 1540.443603 €
 | de ello, partidas con precio ESTIMADO (fondo naranja) |  |  |  |  |  |  |  | 50755.12 € | 22.5%
