teyame109-dev/Modular-Home/costes/Presupuesto_Nevola_chalet_tipoA_v2.xlsx

Sheet: Resumen
NÉVOLA (Guadalix de la Sierra): 16 chalets en sistema modular. Estimación de precio
Promotor: Nido Capital. Base: dossier comercial del 22/07/2025 (planos de presentación y memoria de calidades orientativa). Precios: banco de precios Tini/DWHAI 2024, actualizado.
Capítulo | Pareada | Independiente | €/m² pareada | % del total
01 ESTRUCTURA METÁLICA DE MÓDULOS
02 ENVOLVENTE: FACHADA Y MEDIANERA
03 CUBIERTA PLANA
04 SUELOS Y FORJADO ENTRE PLANTAS
05 ELECTRICIDAD Y TELECOMUNICACIONES
06 FONTANERÍA, SANEAMIENTO Y SANITARIOS
07 CLIMATIZACIÓN, ACS Y VENTILACIÓN
08 CARPINTERÍA EXTERIOR
09 ACABADO EXTERIOR DE FACHADA
10 TABIQUERÍA, TECHOS Y PINTURA
11 PAVIMENTOS Y ESCALERA
12 CARPINTERÍA INTERIOR
13 TRANSPORTE, MONTAJE Y ENTREGA
PRECIO DE FÁBRICA POR VIVIENDA
Margen de la empresa vendedora (gastos generales + beneficio)
PRECIO DE VENTA AL PROMOTOR: VIVIENDA PILOTO (sin IVA)
SERIE COMPLETA: 16 VIVIENDAS
Concepto | Unidades | Precio unitario | Importe
Viviendas pareadas
Viviendas independientes
TOTAL SERIE (sin IVA)
€/m² construido medio de la serie
Precio de serie = precio piloto con el descuento por volumen de «Supuestos». Aplicado a todo el precio: es una simplificación.
QUÉ INCLUYE Y QUÉ NO
INCLUYE | Vivienda terminada en fábrica según la memoria de calidades: estructura, envolvente, cubierta, instalaciones (electricidad, fontanería, suelo radiante, aerotermia, ventilación), carpinterías, acabados y sanitarios. Transporte, grúa, montaje y limpieza.
NO INCLUYE | Cimentación (losa o zapatas) y soleras. Acometidas y urbanización. Terraza y jardín de planta baja, cerramientos de parcela, garaje y zonas comunes (piscina, huerto, jardín).
NO INCLUYE | Muebles de cocina (el dossier la entrega sin amueblar), electrodomésticos, piscina privada.
NO INCLUYE | Proyecto, dirección facultativa, OCT, seguro decenal, licencias, tasas, estudio geotécnico, ensayos y coordinación de seguridad y salud.
REFERENCIA | Obra in situ en Menorca Pino 2024 (cimentación, urbanización, acometidas y cerramiento): 89.194 € para 165 m² (≈ 541 €/m²). Solo orientativo: Menorca no es la Sierra de Madrid.
PUNTOS A CERRAR ANTES DE ENVIAR LA OFERTA
1. Sistema constructivo: la memoria prevé estructura de hormigón y fachadas con cámara. El promotor tiene que aceptar el cambio a módulo de acero + panel Tabihaus, y el proyecto de ejecución, el OCT y el seguro decenal tienen que admitirlo.
2. Acero: estimado a 90 kg/m². Con dos plantas, el cálculo de estructura puede subirlo. Pedir a los soldadores el precio actual del kg soldado (en 2024 costó entre 3 y 4,9 €/kg y se vendió a 2,80).
3. Pedir precio a Tabihaus (paneles 66, 81 y 136 mm, y 8+20+8) y a un carpintero de PVC con persiana monoblock: son las partidas más grandes después de la estructura.
4. Medidas: ancho y fondo medidos en un plano de presentación. Confirmar con el proyecto básico y ver si los módulos de 2,67 m encajan con la distribución (salón de 28,7 m² y escalera).
5. Ubicación de la fábrica en 2026: el transporte está calculado desde Seseña.

Sheet: Supuestos
NÉVOLA: chalet tipo A pasado a sistema modular (datos de partida)
Amarillo = dato que puedes cambiar. Todo el presupuesto se recalcula a partir de esta hoja.
Concepto | Valor | Origen / comentario
Superficie construida planta baja (m²) | 74.58 | Dossier comercial, vivienda tipo A (pág. 13)
Superficie construida planta primera (m²) | 73.72 | Dossier comercial, vivienda tipo A
TOTAL SUPERFICIE CONSTRUIDA (m²) |  | 148,30 m²; con terrazas, 182,10 m²
Superficie útil (m²) | 123.71 | Suma de estancias del plano: 62,19 en planta baja + 61,52 en planta primera
Terraza de planta primera (m²) | 9.59 | La terraza de planta baja (24,48 m²) es obra in situ: queda fuera
Ancho de la vivienda (m) | 8.00 | Medido en el plano con la escala gráfica. Comprobar con el proyecto
Fondo de la vivienda (m) | 9.40 | Medido en el plano con la escala gráfica (8,0 × 9,4 ≈ 75 m² por planta)
Módulos por planta | 3 | Módulos de ≈2,67 m de ancho: transporte normal sin escolta
Plantas | 2
Nº de módulos por vivienda
Ancho de cada módulo (m)
Altura exterior de módulo (m) | 3.00 | Pilar de 2,55 m más vigas de suelo y techo (sistema Tini)
Perímetro de fachada por planta (m)
Fachada bruta, todas las caras (m²)
% de huecos sobre fachada | 17.0% | Estimado con los planos: grandes ventanales al salón y a los dormitorios
Superficie de huecos / carpintería (m²)
Medianera en pareados (m²) |  | Lleva panel, pero no acabado exterior. Doble placa por protección contra incendios
Ratio de acero (kg por m² construido) | 90 | El Boalo 91 kg/m², Menorca 84, Sotopinilla 79. Dos plantas: se toma el alto
Acero estructural (kg) |  | Hasta tener el cálculo de estructura
Tabiquería interior (m² de tabique por m² construido) | 0.90 | Menorca Pino: 0,90
Tabiquería interior (m²)
Zonas húmedas con gres (m²) | 27.13 | Cocina 8,49 + lavadero 3,98 + baños 3,65 + 3,89 + 7,12
Escalera, superficie en planta (m²) | 6.95 | 2,29 + 4,66
Tarima laminada AC5 (m²) |  | Superficie útil menos zonas húmedas y escalera
Alicatado de baños y frente de cocina (m²) | 56.00 | Estimado: 2 baños × 20 m² + aseo 12 m² + cocina 4 m²
Puertas interiores de paso | 10 | Contadas en el plano
Baños completos | 2 | Baño 2 con bañera; baño principal con ducha y lavabo doble
Aseos | 1 | Baño 1 de planta baja, con ducha
Canalón (m)
Albardilla / remate de cubierta (m)
Barandilla de vidrio, terraza de planta primera (m) | 8.00 | Estimado en el plano
Pliegues y remates de huecos (m) | 60.00 | Estimado a partir de la superficie de huecos
Rodapié (m) | 110.00 | Perímetro de las estancias secas, estimado
Actualización de precios 2024→2026 (todas las partidas) | 12.0% | Costes de construcción residencial: +5,46 % en 2025 (ACR); +3,5 % interanual en abril de 2026, máximo histórico (Banco de España); energía y combustible disparados en 2026. Desde mediados de 2024 salen unos 11 puntos: se redondea a 12 %
Horas de montaje in situ por vivienda | 192 | Supuesto: 3 operarios × 8 días (uniones, juntas, remates, conexión de instalaciones)
Precio hora de montaje (€/h) | 40.00 € | Coste completo de fábrica 2024 ≈ 40 €/h. En 2024 se vendía a 30 €/h (por debajo del coste)
Transporte por módulo (€) | 900 € | Sotopinilla 2024: 780 €/módulo (Moreno). Guadalix: <100 km de Seseña
Grúa por vivienda (€) | 3120 € | Sotopinilla 2024 (Moreno). Con 16 viviendas seguidas debería bajar
Viviendas pareadas | 14 | Plano general: 01-02, 03-04, 06-07, 08-09, 11-12, 13-14 y 15-16
Viviendas independientes | 2 | Viviendas 05 y 10
Descuento por volumen en la serie de 16 | 6.0% | Supuesto: compras de acero, panel y carpintería por 16 viviendas
Margen sobre precio de fábrica (gastos generales + beneficio) | 12.0% | Los precios del banco ya llevan el margen de fábrica de DWHAI. Este es el margen de la empresa que vende al promotor (Tini ponía un 35 %)

Sheet: Presupuesto vivienda
PRESUPUESTO POR PARTIDAS: CHALET TIPO A NÉVOLA EN SISTEMA MODULAR (fabricación, transporte y montaje)
Precio 2026 = precio base 2024 × (1 + actualización), en todas las partidas. Fondo naranja = partida sin referencia en el banco: precio base ESTIMADO, pedir oferta a proveedor.
La cantidad «independiente» solo cambia en la medianera: la independiente tiene cuatro fachadas con acabado.
Código | Descripción | Ud | Medición | Cant. pareada | Cant. independiente | Precio base 2024 | Referencia del precio | PRECIO 2026 | Importe pareada | Importe independiente
01 | ESTRUCTURA METÁLICA DE MÓDULOS
EST | Acero S275JR en pilares, vigas, correas, refuerzos y pletinas, soldado en fábrica | kg | Ratio kg/m² × m² construidos |  |  | 2.80 € | Todos los proyectos 2024: 2,80 €/kg
EST_PN_GIM | Granallado e imprimación | kg | = acero |  |  | 0.11 € | Fenwick, Sotopinilla, El Boalo
EST_PN_PPV | Pintura de poliuretano (tratamiento C2-C3) | kg | = acero |  |  | 0.10 € | Sotopinilla 0,10 · Fenwick 0,15
EST_PL_AG | Agarraderas de izado (4 por módulo) | u | 4 × nº de módulos |  |  | 4.48 € | Fenwick, Menorca
02 | ENVOLVENTE: FACHADA Y MEDIANERA
FAC_SAN_TAH | Panel sándwich Tabihaus 8+50+8 (66 mm) en fachada y medianera | m² | Fachada bruta − huecos |  |  | 75.00 € | El Boalo 75 €/m² · Menorca oct-24 82,42 €/m²
FAC_ATR | Aislamiento térmico reflexivo | m² | = panel de fachada |  |  | 11.25 € | Todos los proyectos
FAC_PET80 | Aislamiento de PET reciclado de 80 mm | m² | = panel de fachada |  |  | 15.70 € | Todos los proyectos
FAC_U46 | Perfilería U 46 mm cada 60 cm (trasdosado interior) | m² | = panel de fachada |  |  | 22.00 € | Todos los proyectos
TAB_PYL13 | Placa de yeso laminado de 13 mm en trasdosado de fachada | m² | = panel de fachada |  |  | 13.56 € | Banco (TAB_PYL13)
TAB_2PLA | Doble placa en medianera (protección contra incendios entre viviendas) | m² | Solo pareadas |  |  | 27.12 € | Menorca (TAB_2PLA)
03 | CUBIERTA PLANA
CUB_SAN_TAH | Panel sándwich Tabihaus 8+65+8 (81 mm) de cubierta | m² | Planta primera |  |  | 65.00 € | El Boalo 65 · Menorca oct-24 58,37
CUB_ATR | Aislamiento térmico reflexivo | m² | = cubierta |  |  | 11.25 € | Todos los proyectos
CUB_XPS60 | Aislamiento XPS 60 mm | m² | = cubierta |  |  | 10.00 € | Todos los proyectos
CUB_PET40 | Aislamiento de PET reciclado 40 mm | m² | = cubierta |  |  | 10.00 € | Todos los proyectos
CUB_TAB | Impermeabilización: tela asfáltica bicapa | m² | = cubierta |  |  | 36.00 € | Todos los proyectos
CUB_GRA | Acabado de grava en zona no transitable | m² | Cubierta − terraza |  |  | 12.00 € | ESTIMADO (no está en el banco)
CUB_CAN | Canalón de chapa plegada de 2 mm | m | Supuestos |  |  | 38.00 € | Todos los proyectos
CUB_GAR | Gárgola metálica con pieza de EPDM | u | 3 por vivienda |  |  | 52.00 € | Todos los proyectos
CUB_ALB | Albardilla de chapa plegada galvanizada de 2 mm | m | Perímetro de cubierta |  |  | 25.05 € | Todos los proyectos
TER_GRES | Gres exterior antideslizante en terraza de planta primera | m² | Supuestos |  |  | 45.00 € | Banco (PAV_SOCE, solado cerámico)
TER_BAR | Barandilla de vidrio de seguridad en terraza | m | Supuestos |  |  | 350.00 € | ESTIMADO (en el banco solo hay malla: 217,80 €/m)
04 | SUELOS Y FORJADO ENTRE PLANTAS
SUE_SAN_136 | Panel sándwich Tabihaus 8+120+8 (136 mm), suelo de planta baja | m² | Planta baja |  |  | 99.00 € | El Boalo 99 · Menorca oct-24 86,09
SUE_SAN_81 | Panel sándwich Tabihaus 8+65+8, suelo de módulos de planta primera | m² | Planta primera |  |  | 65.00 € | El Boalo (SUE 8+65+8) 65
SUE_TEC_40 | Panel Tabihaus 8+20+8, techo de módulos de planta baja | m² | Planta baja |  |  | 50.00 € | ESTIMADO: coste de lista 40 €/m² (Mahón) + margen
SUE_ATR | Aislamiento térmico reflexivo bajo forjado | m² | Planta baja |  |  | 11.25 € | Menorca, El Boalo
05 | ELECTRICIDAD Y TELECOMUNICACIONES
ELE_M2 | Instalación eléctrica completa (cuadro, circuitos, mecanismos Niessen o similar, iluminación, TV y datos en estancias) | m² | m² construidos |  |  | 55.00 € | Ratio: Sotopinilla 61 €/m² · Menorca 39 €/m² (sin el error de la toma de tierras)
ELE_POR | Portero automático | u | 1 |  |  | 350.00 € | ESTIMADO
ELE_VE | Preinstalación de punto de recarga de vehículo eléctrico | u | 1 |  |  | 450.00 € | ESTIMADO
06 | FONTANERÍA, SANEAMIENTO Y SANITARIOS
BAN_INS | Instalación completa de fontanería y saneamiento por baño o aseo | u | Baños + aseo |  |  | 494.00 € | Todos los proyectos
09TLAV | Tomas de agua y desagüe: cocina, lavadora, secadora y pila de lavadero | u | 4 tomas |  |  | 75.00 € | Menorca (toma de lavadora)
BAN_IMP | Impermeabilización de plato de ducha | u | 2 duchas |  |  | 50.00 € | Todos los proyectos
BAN_INO | Inodoro de porcelana vitrificada (Gala o similar) | u | 3 |  |  | 280.00 € | ESTIMADO: gama media (en 2024 se usó Tesi suspendido, 811 €)
BAN_LAV | Lavabo de porcelana (baño principal con lavabo doble) | u | 4 |  |  | 96.38 € | Banco (Starbath)
BAN_GRI_ETN | Grifería monomando de lavabo | u | 4 |  |  | 57.60 € | Banco (Imex Etna)
BAN_DUC_THA | Conjunto de ducha monomando | u | 2 |  |  | 159.50 € | Banco (Imex Thalos)
BAN_DUC_PLA | Plato de ducha extraplano 80×100 | u | 2 |  |  | 300.00 € | Banco (BAN_DUC_PLA_80X100)
BAN_BAN | Bañera acrílica blanca con grifería | u | 1 |  |  | 450.00 € | ESTIMADO
BAN_MAM | Mampara de vidrio (baño principal) | u | 1 |  |  | 400.00 € | Menorca oct-24, El Boalo
07 | CLIMATIZACIÓN, ACS Y VENTILACIÓN
CLI_RAD_SUE | Suelo radiante y refrescante | m² | Superficie útil |  |  | 74.20 € | Banco (CLI_RAD_SUE)
AER_120_150 | Aerotermia Panasonic para 120–150 m² (climatización y ACS) | u | 1 |  |  | 9731.00 € | Banco (Fenwick, catálogo)
CLI_TER | Termostatos por estancia | u | 5 |  |  | 50.00 € | Banco (CLI_TER_AAC)
VEN_MEC | Ventilación mecánica de simple flujo (extracción en baños y cocina, admisión en secos) | u | 1 |  |  | 2200.00 € | ESTIMADO (no está en el banco)
08 | CARPINTERÍA EXTERIOR
CAE_PVC | Carpintería de PVC o aluminio con RPT, vidrio bajo emisivo, con persiana monoblock | m² | Superficie de huecos |  |  | 400.00 € | ESTIMADO: 400 €/m². COR-Vision 2024 ≈ 500–590 €/m² en aluminio de gama alta
LEA010 | Puerta de entrada acorazada | u | 1 |  |  | 1786.35 € | Banco (LEA010)
ACF_PLA | Pliegues y remates de chapa en huecos | m | Supuestos |  |  | 35.00 € | Menorca, Fenwick
09 | ACABADO EXTERIOR DE FACHADA
ACF_ENF | Revestimiento exterior mixto: placa de cemento con acabado continuo o piezas cerámicas o metálicas | m² | Fachada − huecos − medianera |  |  | 76.00 € | Banco (ACF_ENF, Aquapanel con enfoscado). Madera 106 · Viroc 58 · minionda 46
10 | TABIQUERÍA, TECHOS Y PINTURA
TAB_INT | Tabique de PYL: perfilería, PET 40 mm y placa de 13 mm por las dos caras | m² | Ratio × m² construidos |  |  | 59.12 € | Compuesto con el banco: perfil 22 + PET 10 + 2 × placa 13,56
TAB_HID | Suplemento de placa hidrófuga en zonas húmedas | m² | Alicatado + 20 % |  |  | 5.47 € | Diferencia hidrófuga − normal (19,03 − 13,56)
TAB_CER | Alicatado de gres en baños y frente de cocina | m² | Supuestos |  |  | 45.00 € | Menorca, El Boalo
TEC_PLA | Techo de placa de yeso laminado de 15 mm | m² | Superficie útil |  |  | 13.56 € | Todos los proyectos
TEC_PLH | Suplemento hidrófugo en techos de zonas húmedas | m² | Zonas húmedas |  |  | 5.47 € | Diferencia hidrófuga − normal
114PPLAS | Pintura plástica lisa en paredes | m² | Tabiques × 2 caras + trasdosado de fachada − alicatado |  |  | 7.10 € | Menorca
TEC_PIN_B | Pintura blanca mate en techos | m² | Superficie útil |  |  | 7.10 € | Menorca
11 | PAVIMENTOS Y ESCALERA
PAV_LAM | Tarima laminada sintética AC5 | m² | Supuestos |  |  | 32.00 € | ESTIMADO (en el banco solo hay roble, 78 €/m²)
PAV_SOCE | Solado de gres en baños, cocina y lavadero | m² | Zonas húmedas |  |  | 45.00 € | Banco (PAV_SOCE)
PAV_RODMPVC | Rodapié a juego con la carpintería interior | m | Supuestos |  |  | 16.20 € | Todos los proyectos
ESC | Escalera interior: estructura metálica con peldaños de gres | u | 1 |  |  | 3200.00 € | ESTIMADO: coste 2024 de escalera instalada 2.275 € (Guadalajara)
12 | CARPINTERÍA INTERIOR
CAI_PUE_DML_1HA72 | Puerta de paso lacada lisa de 725 mm, abatible | u | Contadas en el plano |  |  | 744.00 € | Banco
CAI_ARM | Armario empotrado de 2 puertas en distribuidor (revestido, balda y barra) | u | 1 |  |  | 1500.00 € | ESTIMADO: la mitad del armario de 4 puertas de Menorca (2.866 €)
CAI_VES | Vestidor abierto en dormitorio principal (revestido, maletero y barra) | u | 1 |  |  | 1200.00 € | ESTIMADO
13 | TRANSPORTE, MONTAJE Y ENTREGA
TRA | Transporte de módulos de Seseña a Guadalix de la Sierra | u | Nº de módulos |  |  |  | Supuestos (Sotopinilla 2024: 780 €/módulo)
GRU | Grúa para colocación | u | 1 por vivienda |  |  |  | Supuestos (Sotopinilla 2024: 3.120 €)
OPE | Montaje in situ: uniones, juntas de fachada y cubierta, conexión de instalaciones | h | Supuestos |  |  |  | Supuestos (coste completo de fábrica ≈ 40 €/h)
LIM | Limpieza final | m² | m² construidos |  |  | 5.00 € | Todos los proyectos
 | PRECIO DE FÁBRICA POR VIVIENDA (fabricación + transporte + montaje)
 | €/m² construido
 | de ello, partidas con precio ESTIMADO (fondo naranja)
