teyame109-dev/Modular-Home/(list of files, cad)

Other CAD files:
proyectos-referencia/menorca/Mahon_cimentacion.dwg
proyecto-tecnico/_Planos de estructura.dwg
proyecto-tecnico/_Planos generales.dwg
proyecto-tecnico/_Planos de instalaciones.dwg
