teyame109-dev/Modular-Home/artifacts/img/montaje-2-grua-planta-primera.jpg

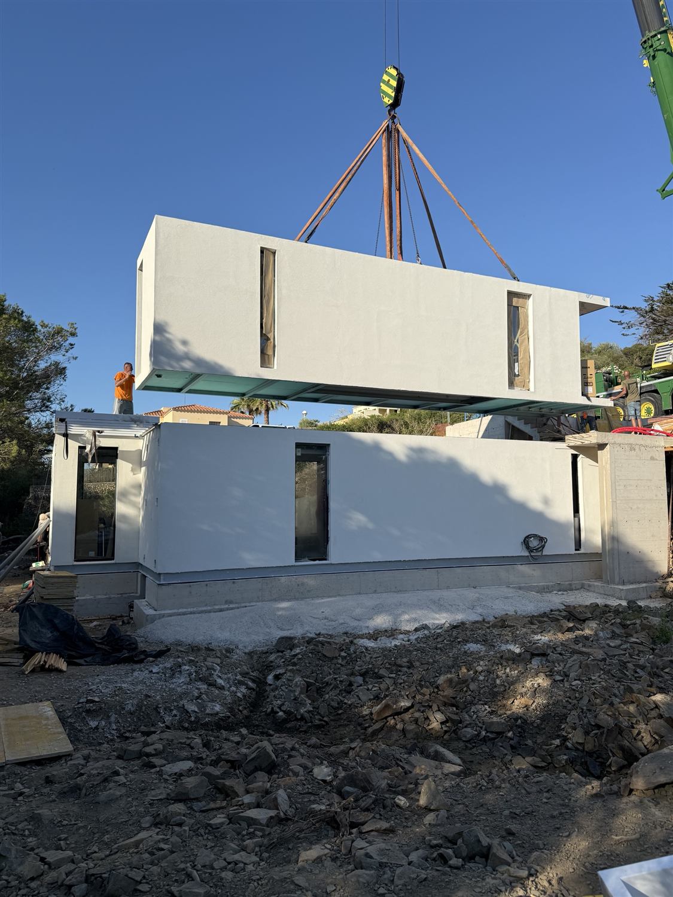
artifacts/img/montaje-2-grua-planta-primera.jpg
