teyame109-dev/Modular-Home/artifacts/img/montaje-3-planta-baja-colocada.jpg

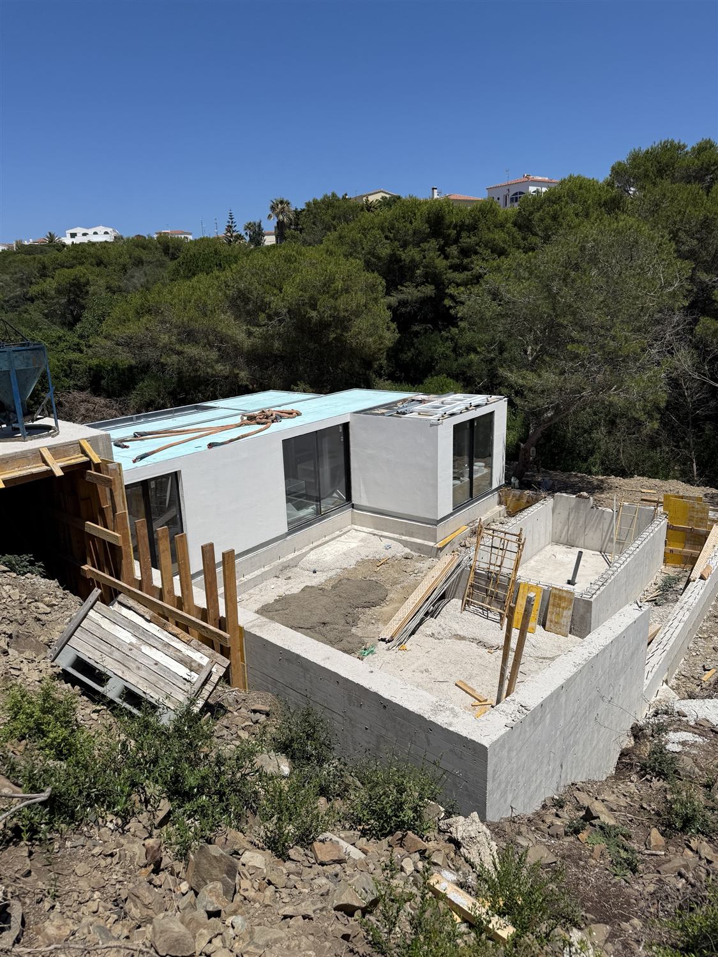
artifacts/img/montaje-3-planta-baja-colocada.jpg
