teyame109-dev/Modular-Home/artifacts/img/montaje-4-encuentro-plantas.jpg

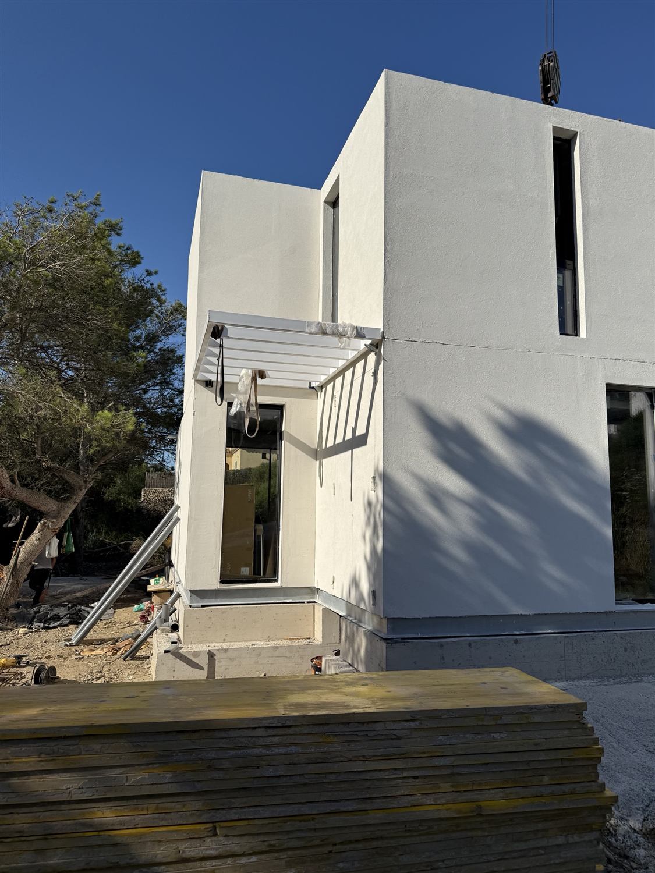
artifacts/img/montaje-4-encuentro-plantas.jpg
