teyame109-dev/Modular-Home/artifacts/img/montaje-5-vivienda-montada.jpg

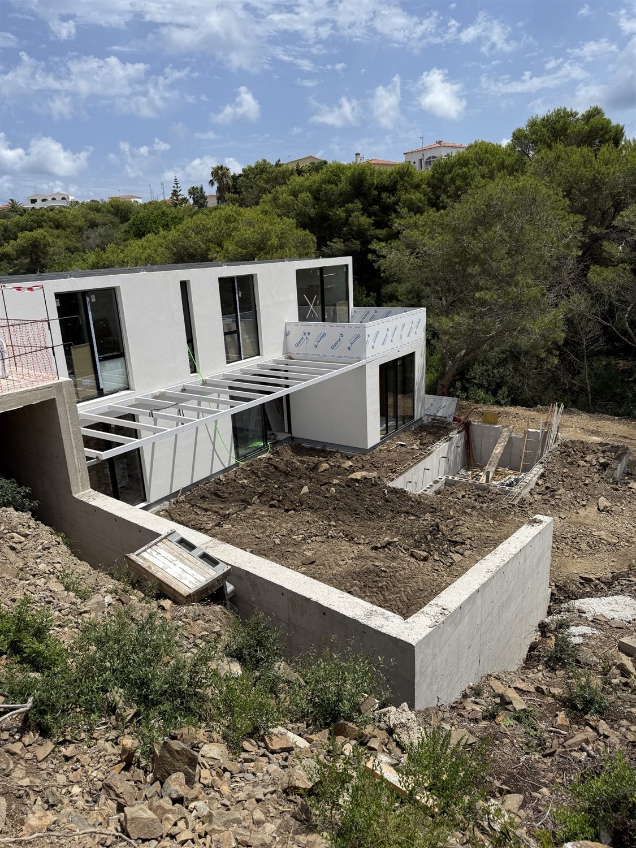
artifacts/img/montaje-5-vivienda-montada.jpg
