teyame109-dev/Modular-Home/proyectos-referencia/menorca/Pino_implantacion_y_cimentacion_2024-08.pdf

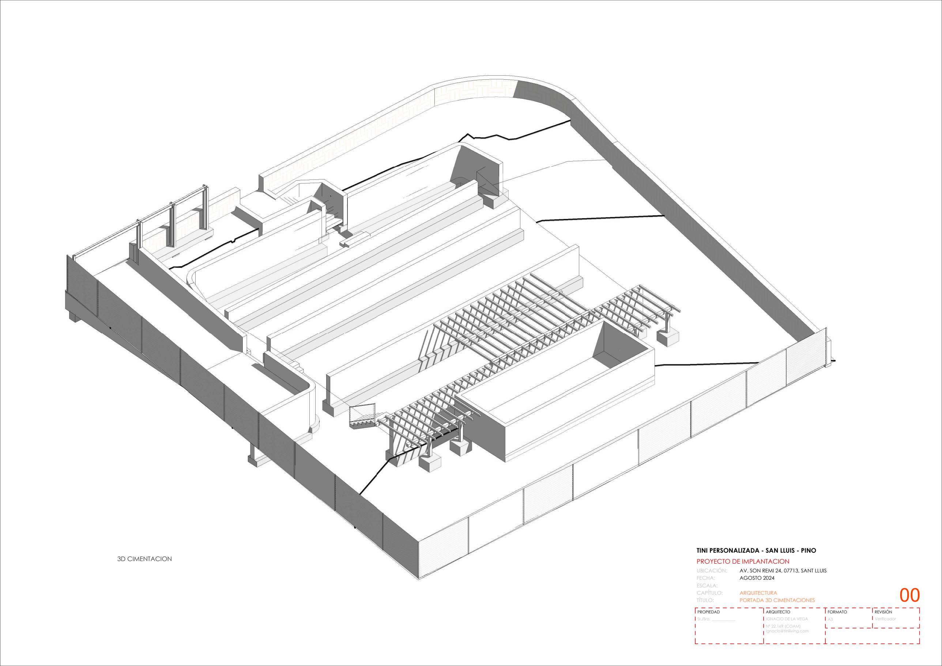
[picture p21: page 1]

PROPIEDAD

### ESCALA:

### FECHA:

### UBICACIÓN:

### CAPÍTULO: TÍTULO:

ARQUITECTO | FORMATO A3

REVISIÓN

### PORTADA 3D CIMENTACIONES

## TINI PERSONALIZADA - SAN LLUIS - PINO

### AGOSTO 2024

00

## PROYECTO DE IMPLANTACION

### AV. SON REMI 24, 07713, SANT LLUIS

### ARQUITECTURA

Sr./Sra. ____________ | IGNACIO DE LA VEGA Nª 22.169 (COAM) ignacio@tiniliving.com

Verificador

## 3D CIMENTACION

## Rampa de

acceso | 0,00 m

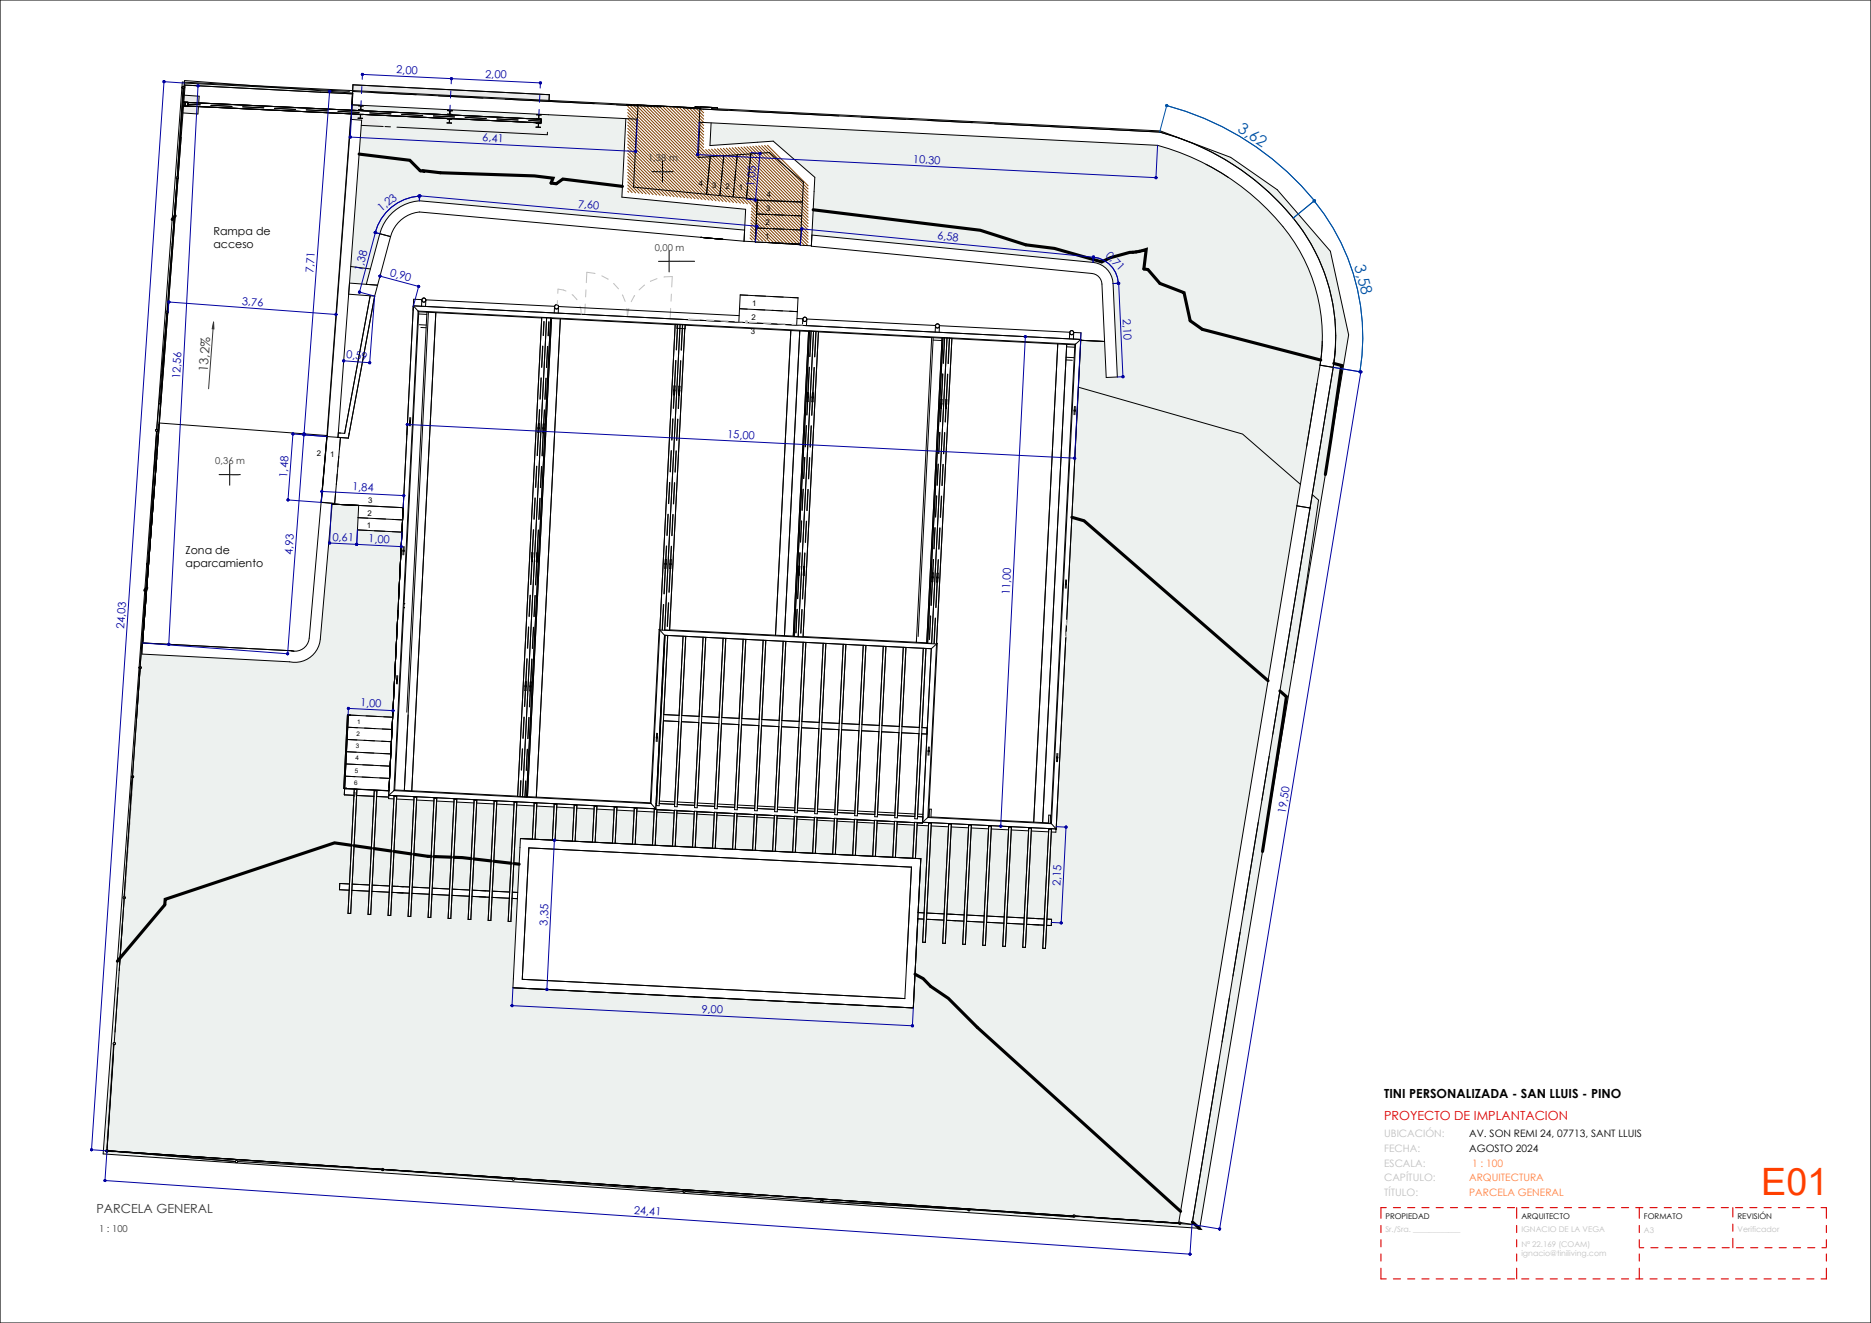
[picture p22: page 2]
Zona de aparcamiento; Verificador; PARCELA GENERAL

TINI PERSONALIZADA - SAN LLUIS - PINO
PROYECTO DE IMPLANTACION
UBICACIÓN:
FECHA:
ESCALA:
CAPÍTULO:
TÍTULO:

AV. SON REMI 24, 07713, SANT LLUIS
AGOSTO 2024
ARQUITECTURA
PARCELA GENERAL

1,55 | 2,09 | 0,10 | 1,90 | 0,10 | 1,90 | Entrada de coches

## CERRAMIENTO DE PARCELA

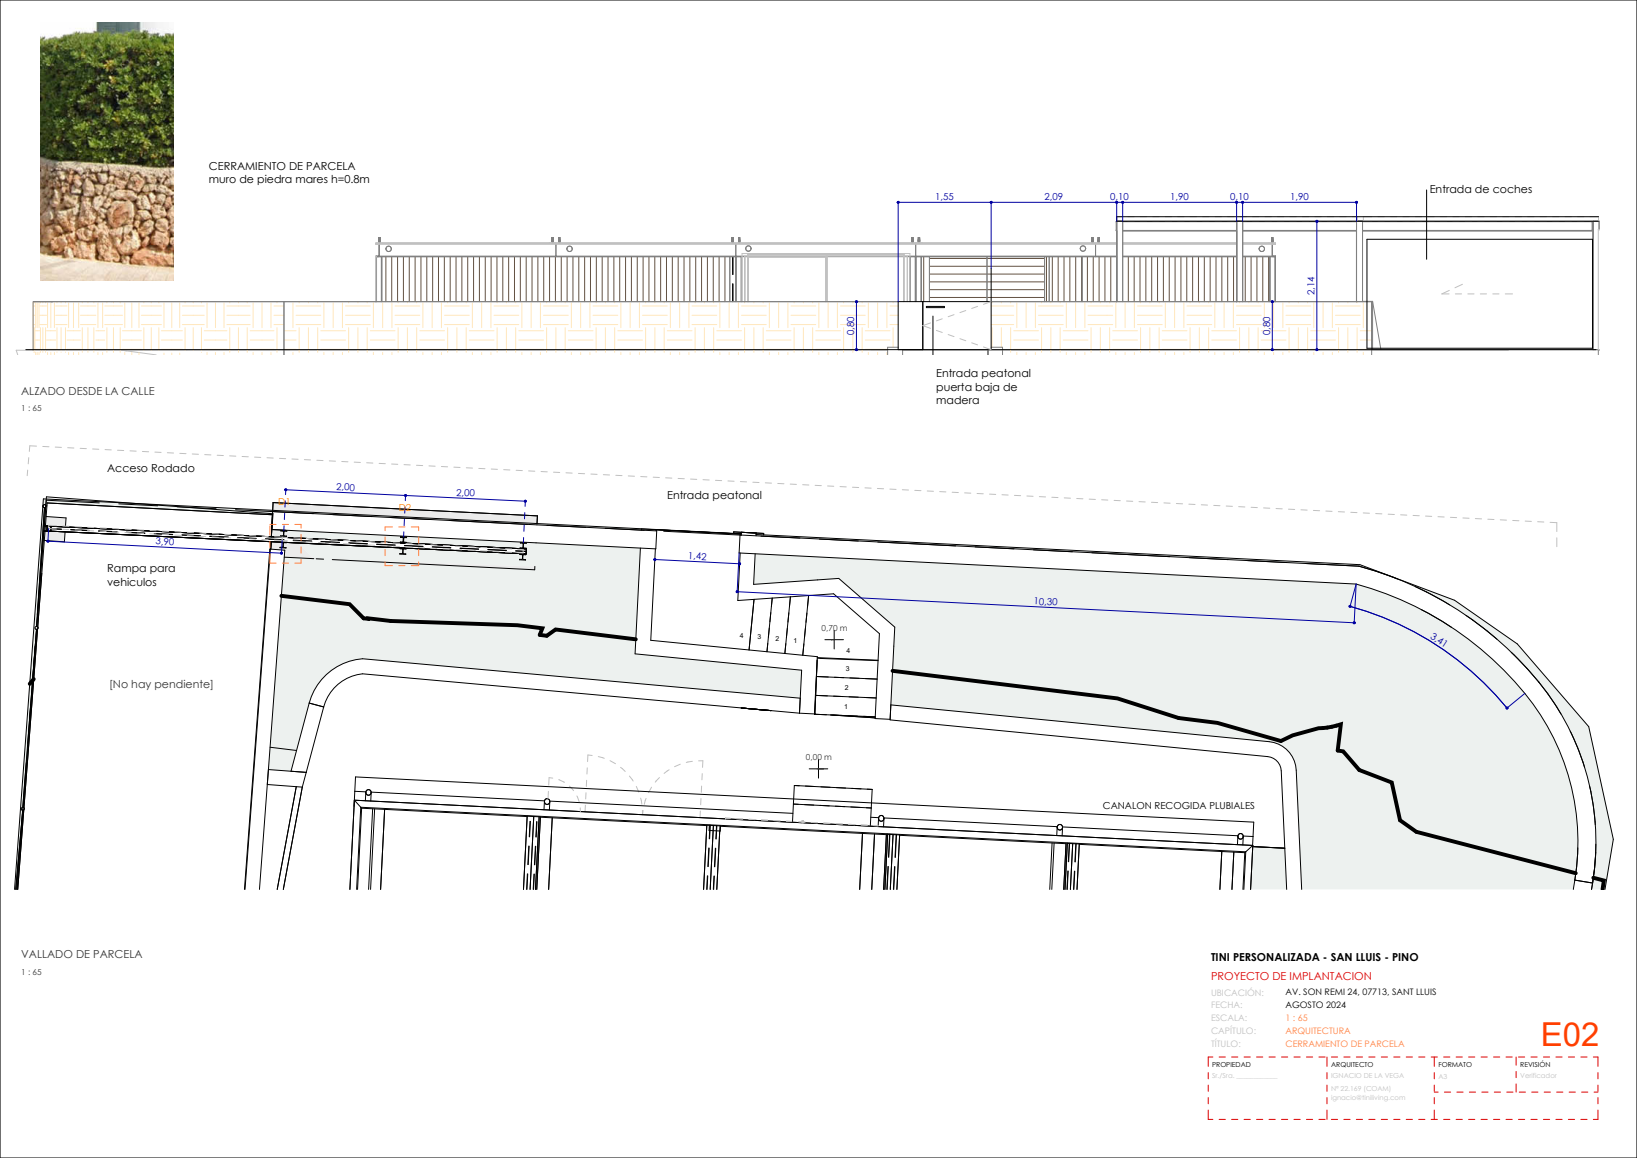
[picture p23: page 3]
Entrada peatonal; Rampa para vehiculos; Acceso Rodado

muro de piedra mares h=0.8m

Entrada peatonal
puerta baja de
madera

ALZADO DESDE LA CALLE

[No hay pendiente]

CANALON RECOGIDA PLUBIALES

VALLADO DE PARCELA

TINI PERSONALIZADA - SAN LLUIS - PINO
PROYECTO DE IMPLANTACION
UBICACIÓN:
FECHA:
ESCALA:
CAPÍTULO:
TÍTULO:

AV. SON REMI 24, 07713, SANT LLUIS
AGOSTO 2024
ARQUITECTURA
CERRAMIENTO DE PARCELA

D1 | D2

## Entrada peatonal

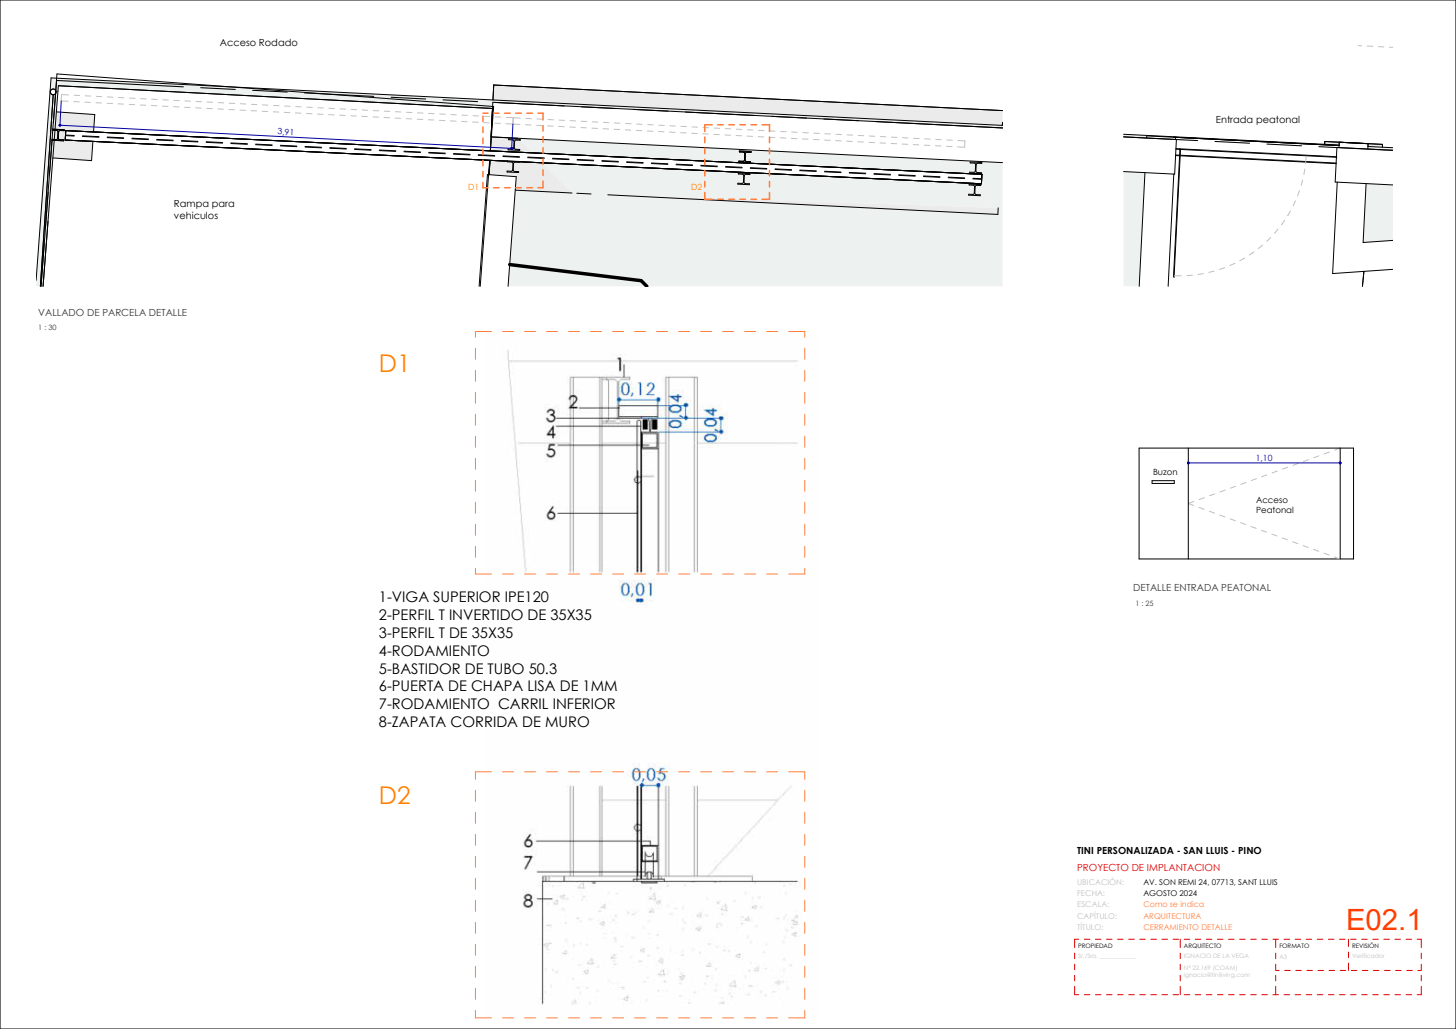
[picture p24: page 4]
Rampa para vehiculos; Acceso Rodado; Acceso Peatonal; Buzon

VALLADO DE PARCELA DETALLE

DETALLE ENTRADA PEATONAL

1-VIGA SUPERIOR IPE120
2-PERFIL T INVERTIDO DE 35X35
3-PERFIL T DE 35X35
4-RODAMIENTO
5-BASTIDOR DE TUBO 50.3
6-PUERTA DE CHAPA LISA DE 1MM
7-RODAMIENTO CARRIL INFERIOR
8-ZAPATA CORRIDA DE MURO

TINI PERSONALIZADA - SAN LLUIS - PINO
PROYECTO DE IMPLANTACION
UBICACIÓN:
FECHA:
ESCALA:
CAPÍTULO:
TÍTULO:

AV. SON REMI 24, 07713, SANT LLUIS
AGOSTO 2024
Como se indica
ARQUITECTURA
CERRAMIENTO DETALLE

25 25 25
35 25 35

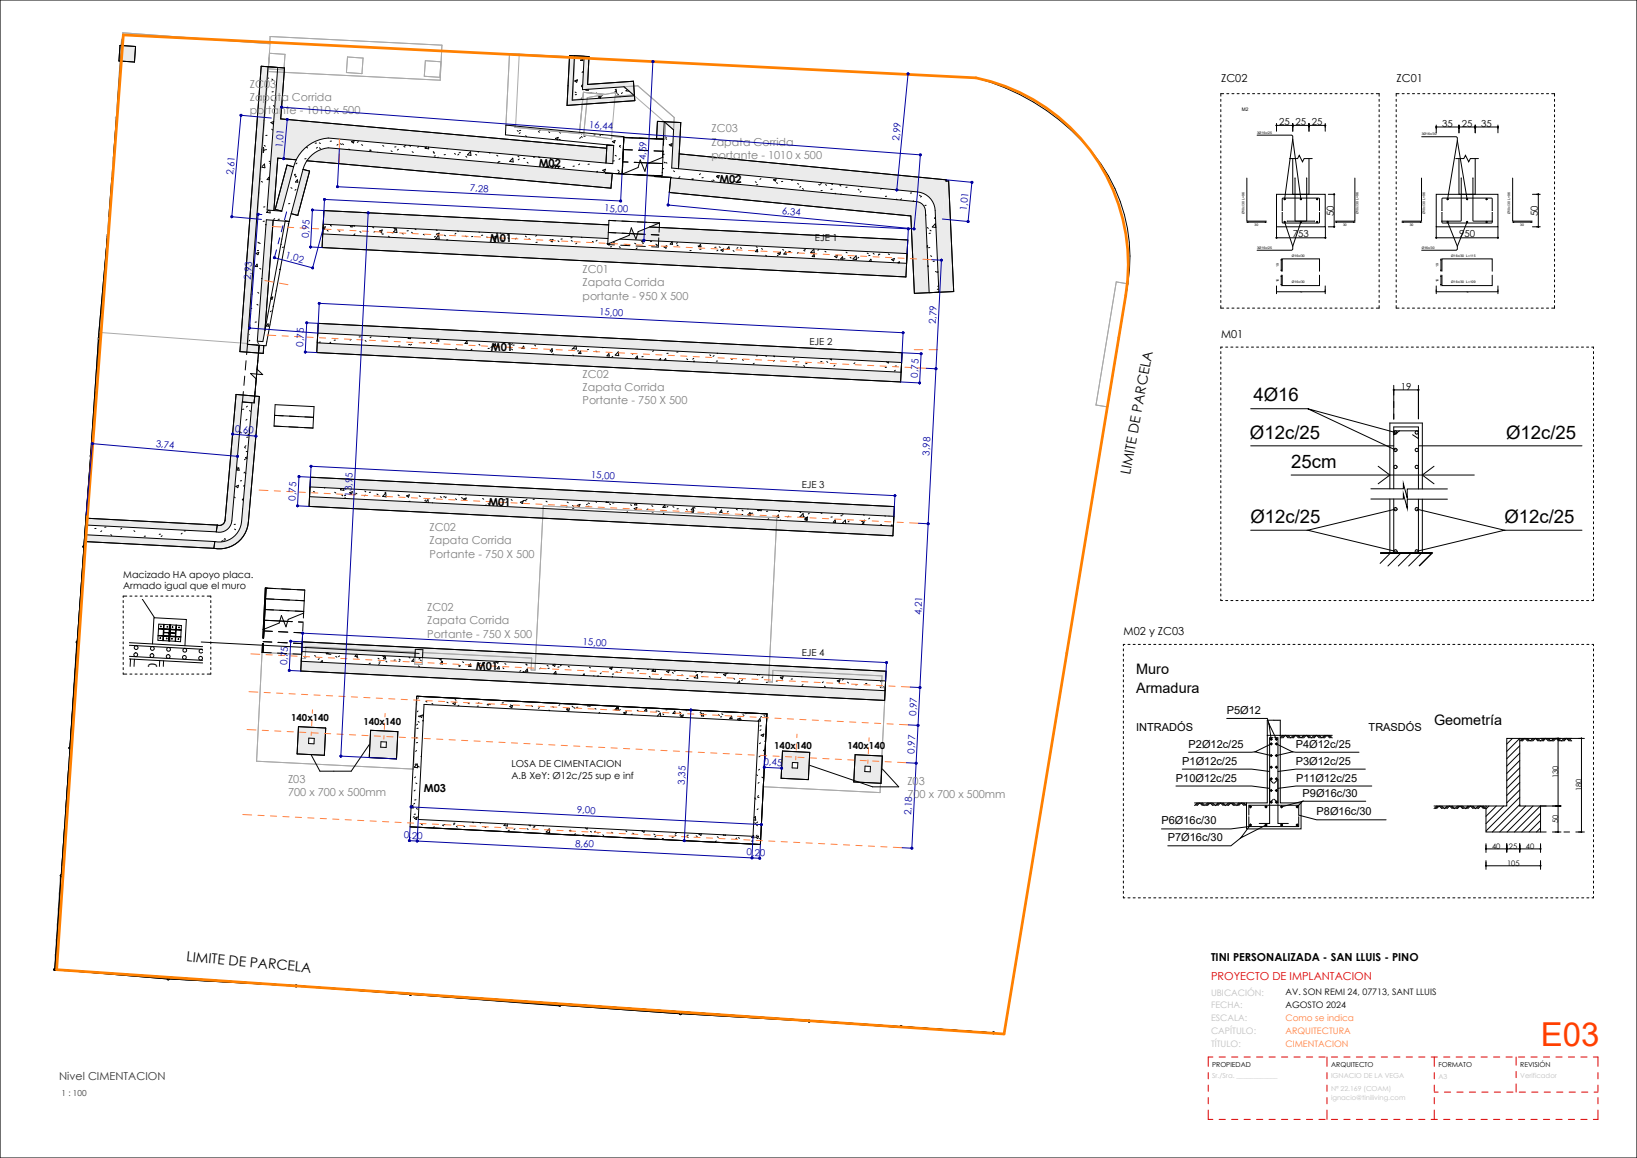
[picture p25: page 5]
INTRADÓS; TRASDÓS; Geometría; Muro Armadura; ZC02 Zapata Corrida Portante - 750 X 500; ZC01 Zapata Corrida portante - 950 X 500; ZC03 Zapata Corrida portante - 1010 x 500; EJE 1; EJE 2; EJE 3; EJE 4; Nivel CIMENTACION

LIMITE DE PARCELA

Macizado HA apoyo placa.
Armado igual que el muro

LOSA DE CIMENTACION
A.B XeY: Ø12c/25 sup e inf

TINI PERSONALIZADA - SAN LLUIS - PINO
PROYECTO DE IMPLANTACION
UBICACIÓN:
FECHA:
ESCALA:
CAPÍTULO:
TÍTULO:

AV. SON REMI 24, 07713, SANT LLUIS
AGOSTO 2024
Como se indica
ARQUITECTURA
CIMENTACION

# CONSANEAMIENTO ⁰,11

## SUELO TERMINADO

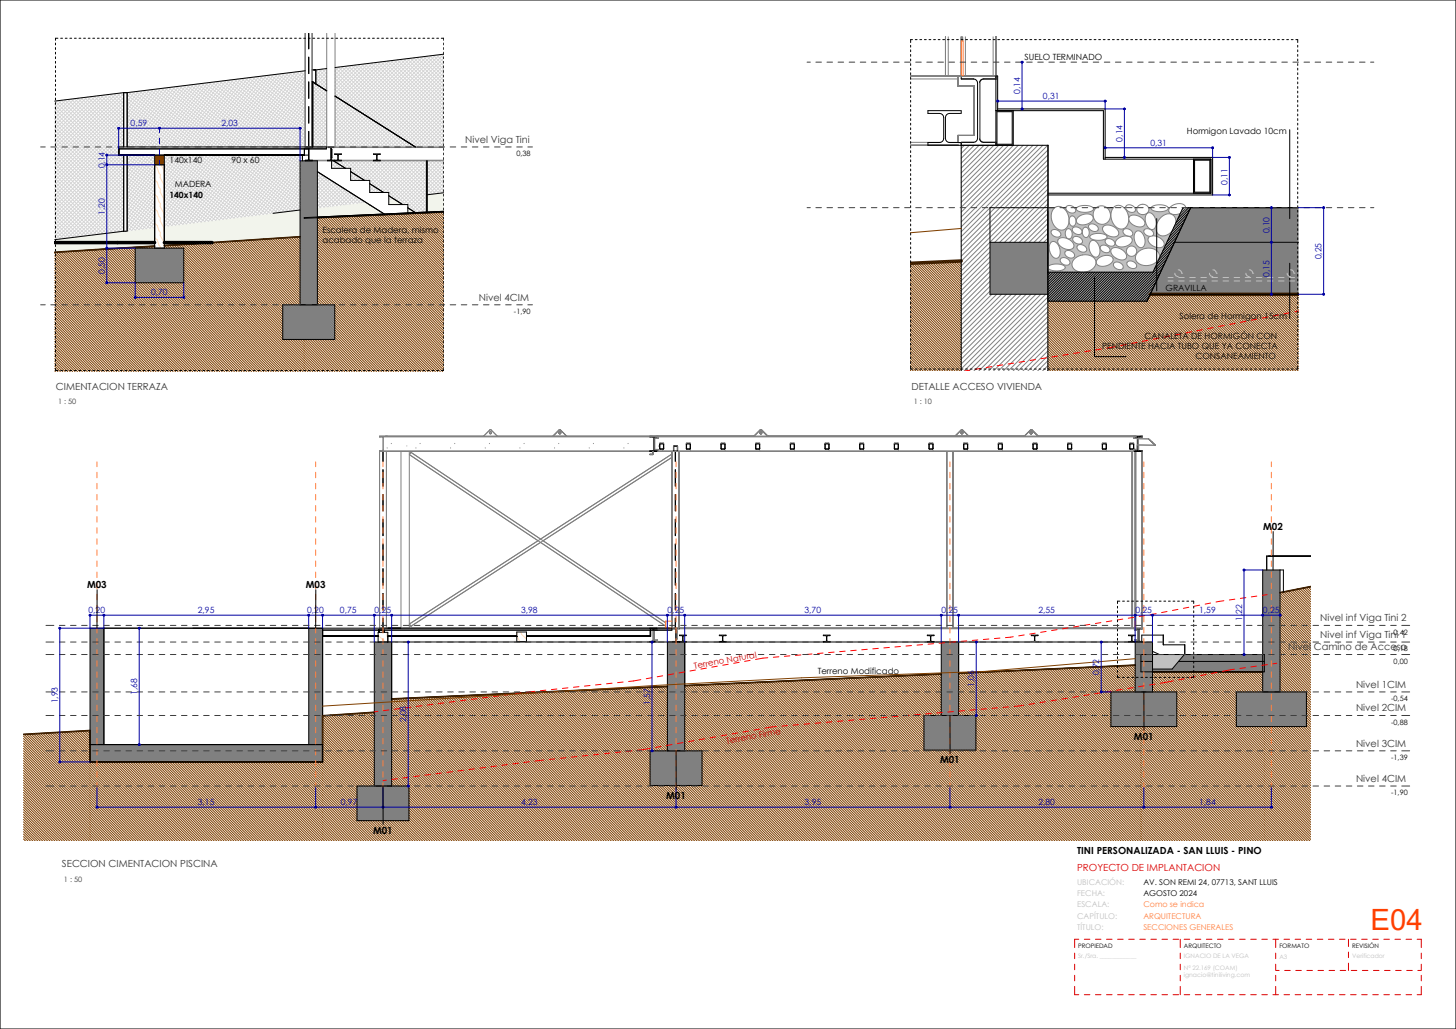
[picture p26: page 6]
Nivel 1CIM; Nivel 4CIM; Terreno Firme; Nivel 2CIM; -0,88 Nivel 3CIM; GRAVILLA; Hormigon Lavado 10cm 0,15 0,10; MADERA; CIMENTACION TERRAZA

Nivel Viga Tini

Escalera de Madera, mismo
acabado que la terraza

Solera de Hormigon 15cm

CANALETA DE HORMIGÓN CON

PENDIENTE HACIA TUBO QUE YA CONECTA

DETALLE ACCESO VIVIENDA

Nivel inf Viga Tini 2
Nivel inf Viga Tini 1
Nivel Camino de Acceso

Terreno Modificado Terreno Natural

TINI PERSONALIZADA - SAN LLUIS - PINO
PROYECTO DE IMPLANTACION
UBICACIÓN:
FECHA:
ESCALA:
CAPÍTULO:
TÍTULO:

SECCION CIMENTACION PISCINA

AV. SON REMI 24, 07713, SANT LLUIS
AGOSTO 2024
Como se indica
ARQUITECTURA
SECCIONES GENERALES

## Nivel Vallado

## zona de

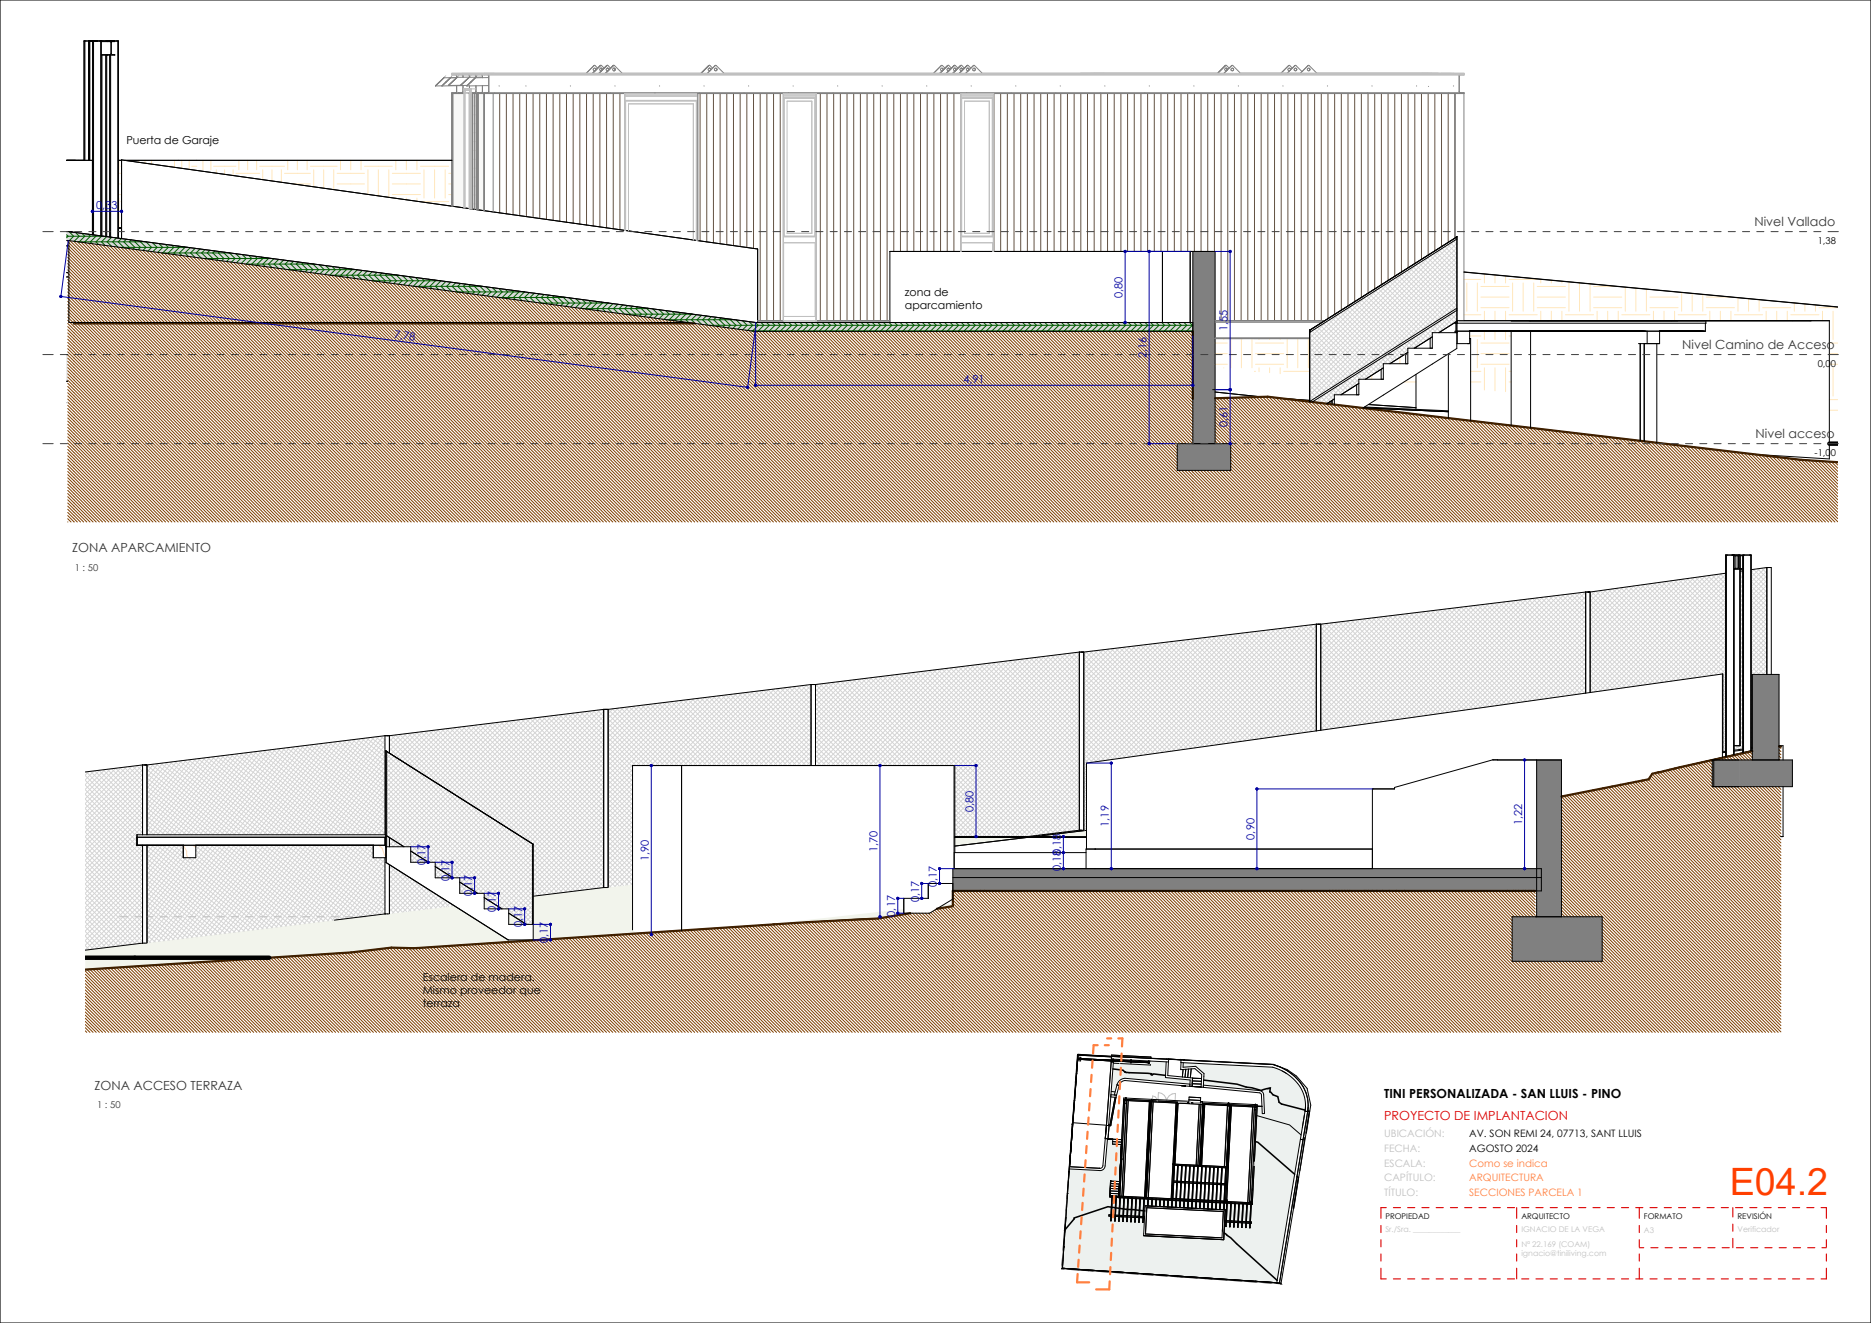
[picture p27: page 7]
Nivel acceso; aparcamiento; ZONA APARCAMIENTO

Puerta de Garaje

Nivel Camino de Acceso

Escalera de madera.
Mismo proveedor que
terraza

ZONA ACCESO TERRAZA

TINI PERSONALIZADA - SAN LLUIS - PINO
PROYECTO DE IMPLANTACION
UBICACIÓN:
FECHA:
ESCALA:
CAPÍTULO:
TÍTULO:

AV. SON REMI 24, 07713, SANT LLUIS
AGOSTO 2024
Como se indica
ARQUITECTURA
SECCIONES PARCELA 1

1,02

1,39

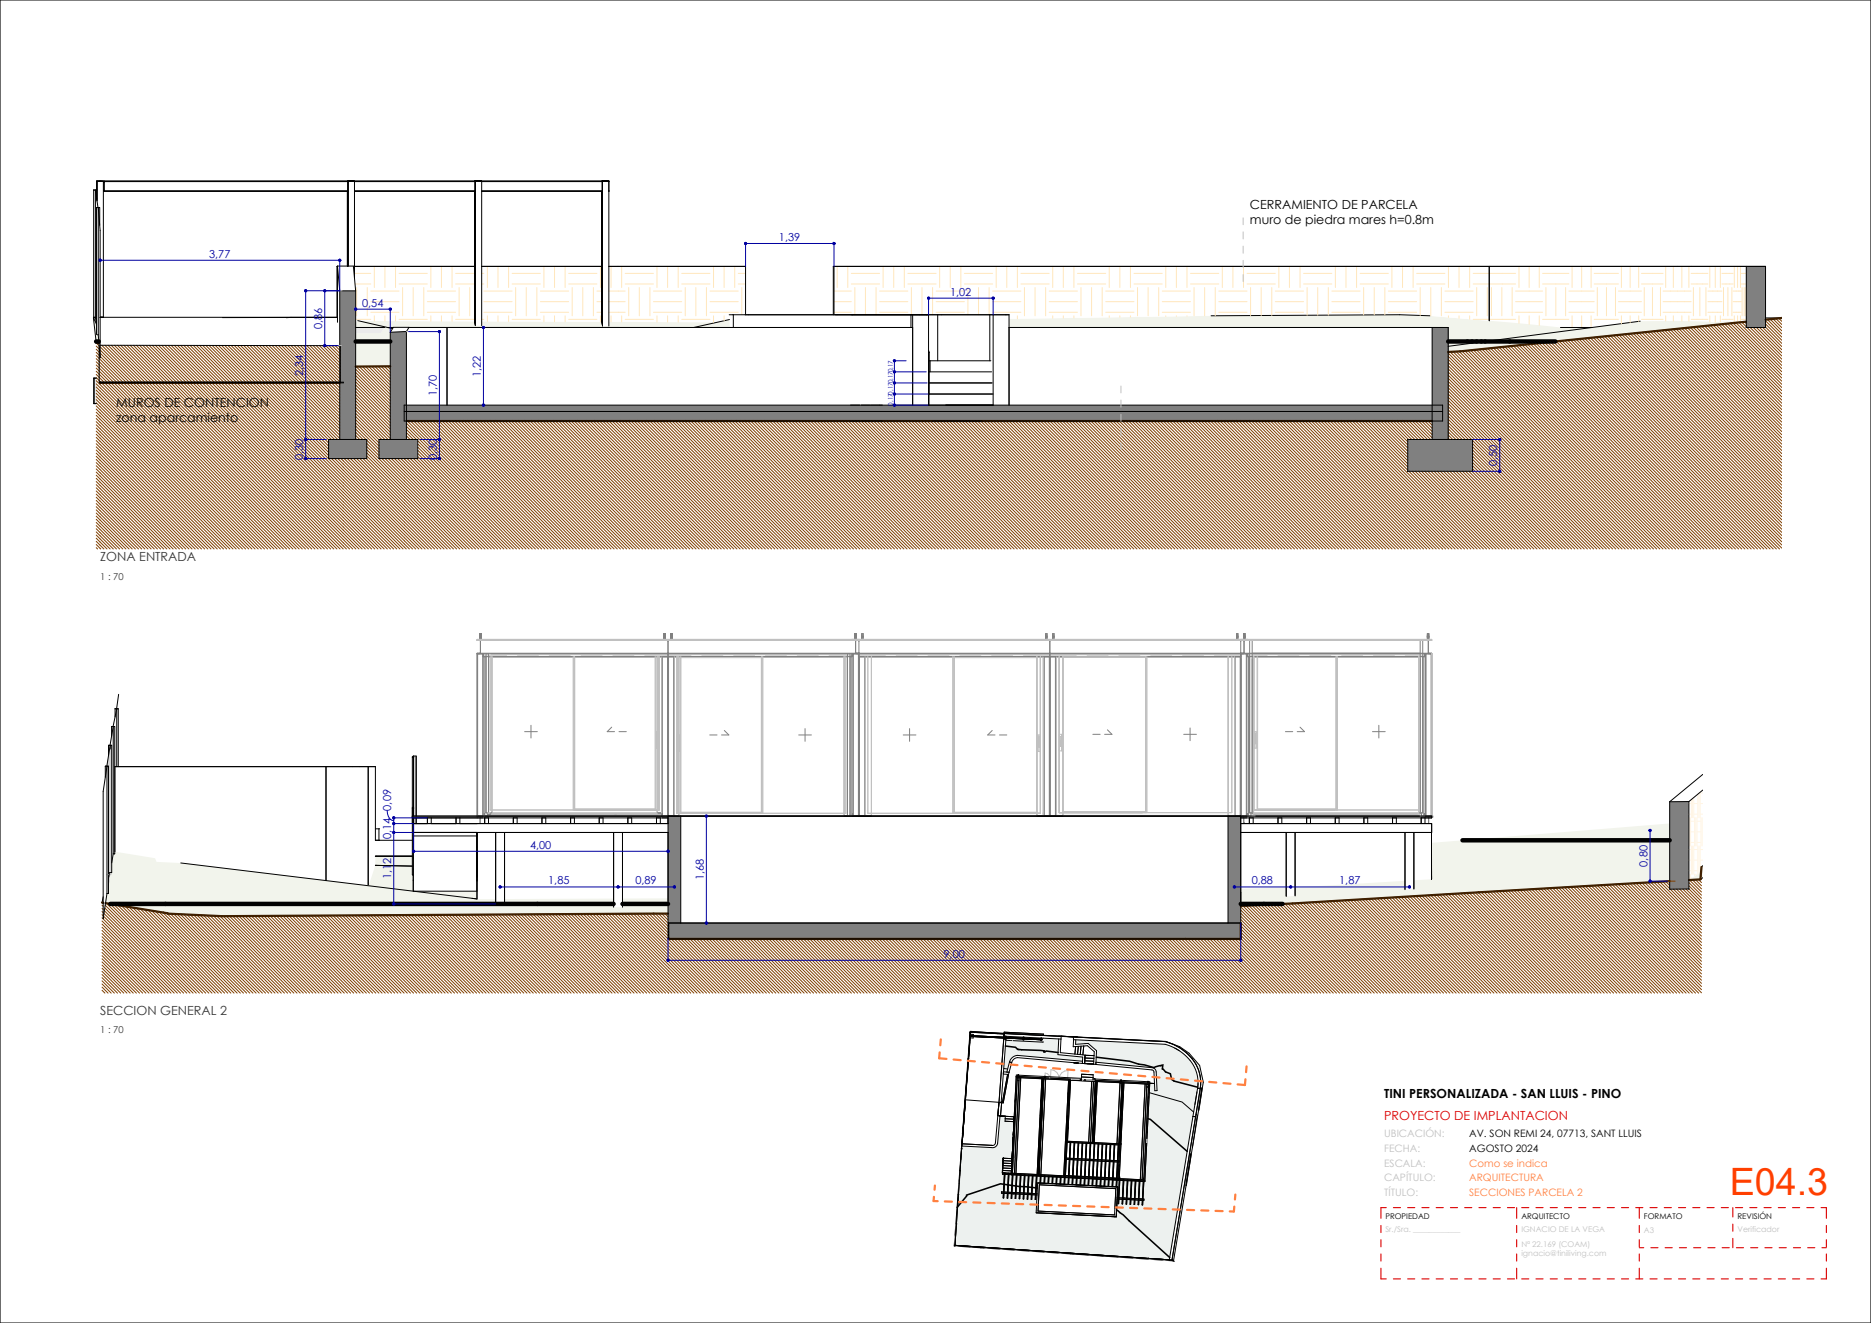
[picture p28: page 8]
ZONA ENTRADA; SECCION GENERAL 2

CERRAMIENTO DE PARCELA
muro de piedra mares h=0.8m

MUROS DE CONTENCION
zona aparcamiento

TINI PERSONALIZADA - SAN LLUIS - PINO
PROYECTO DE IMPLANTACION
UBICACIÓN:
FECHA:
ESCALA:
CAPÍTULO:
TÍTULO:

AV. SON REMI 24, 07713, SANT LLUIS
AGOSTO 2024
Como se indica
ARQUITECTURA
SECCIONES PARCELA 2

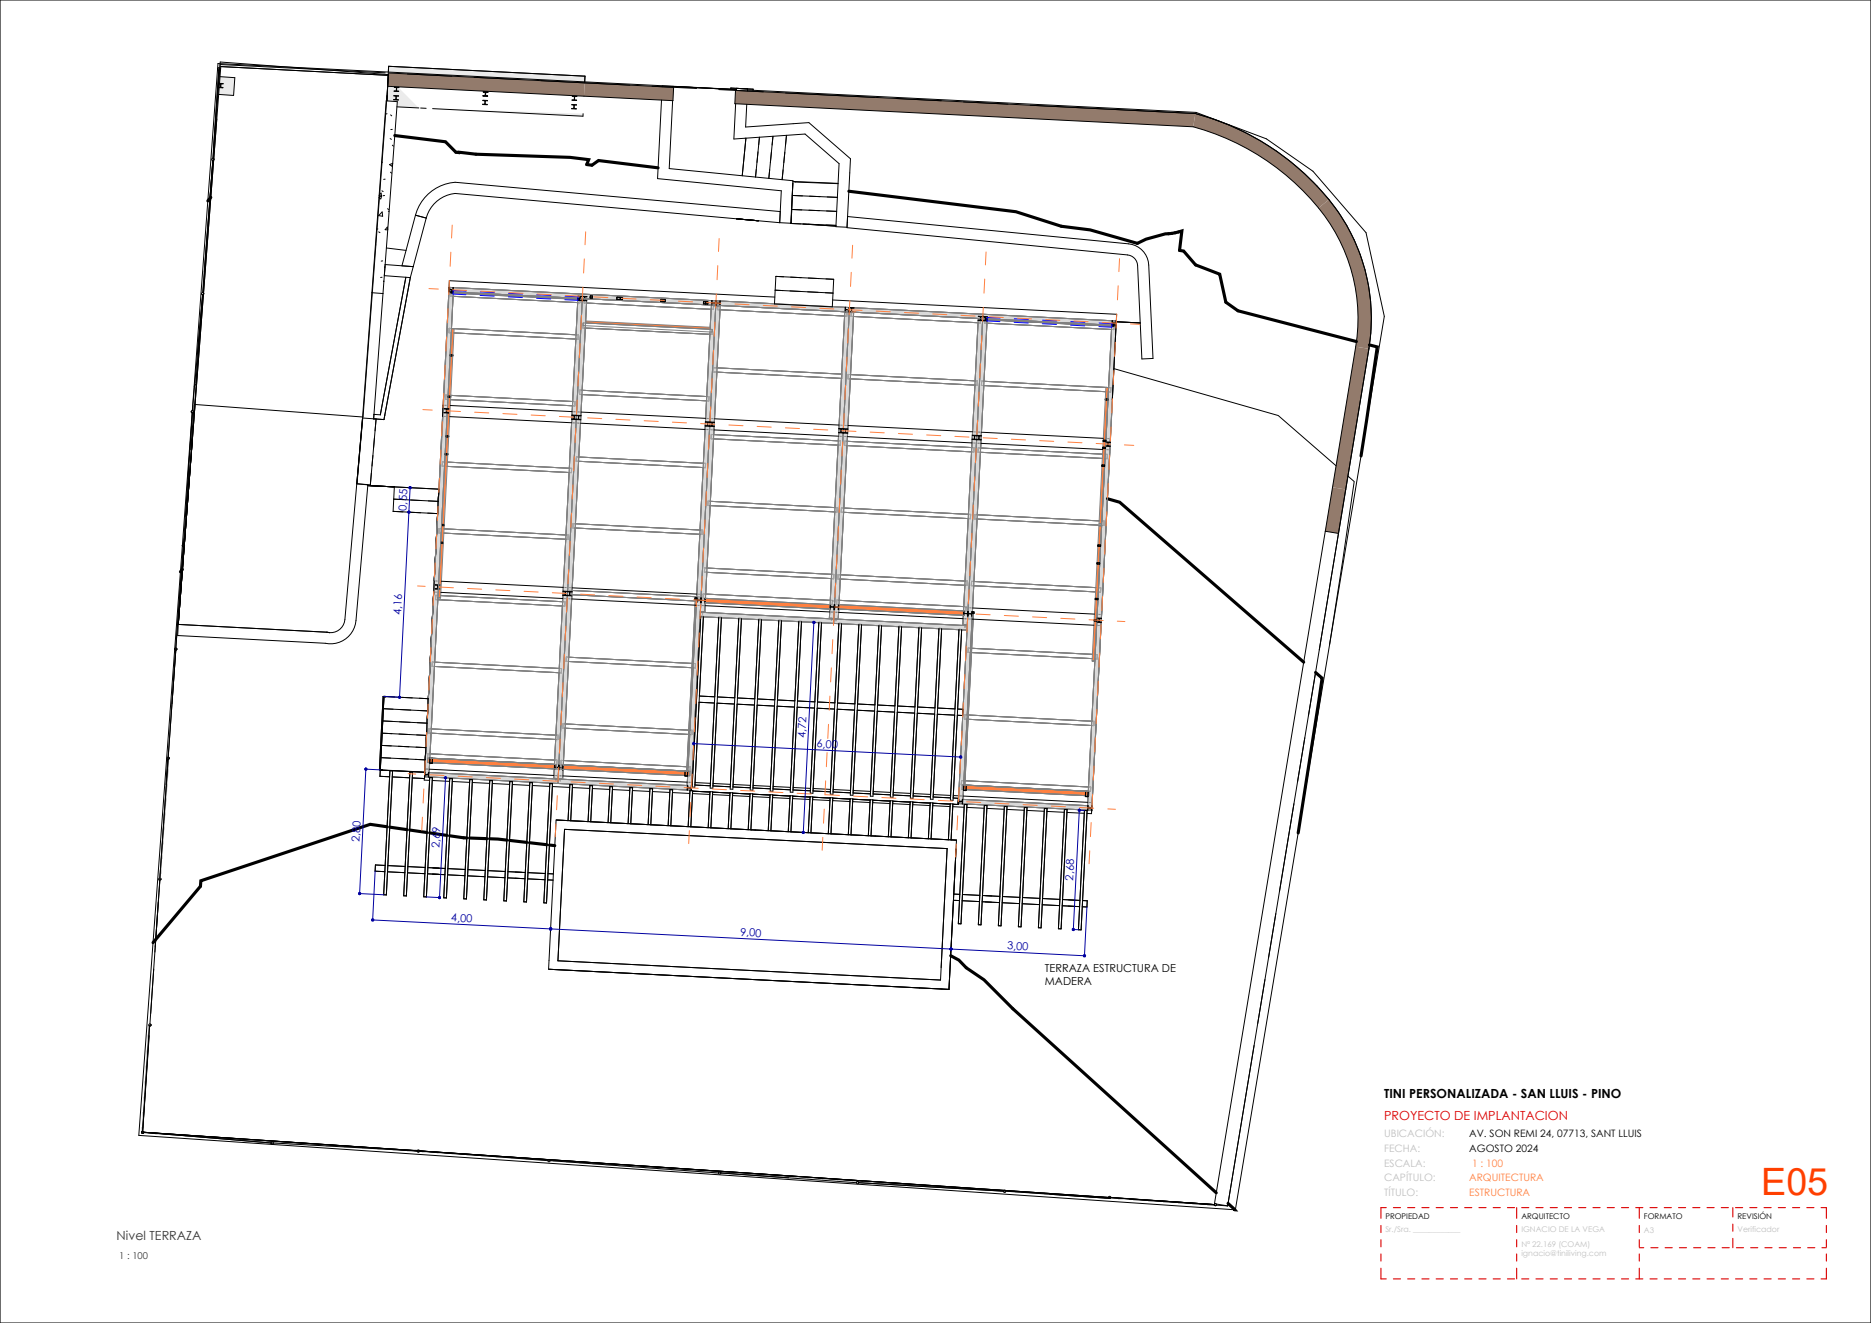
[picture p29: page 9]
TERRAZA ESTRUCTURA DE MADERA; Nivel TERRAZA

TINI PERSONALIZADA - SAN LLUIS - PINO
PROYECTO DE IMPLANTACION
UBICACIÓN:
FECHA:
ESCALA:
CAPÍTULO:
TÍTULO:

AV. SON REMI 24, 07713, SANT LLUIS
AGOSTO 2024
ARQUITECTURA
ESTRUCTURA

# CUADRO DE CARACTERISTICAS CÓDIGO ESTRUCTURAL

## CARACTERISTICAS GENERALES DE TODA LA OBRA

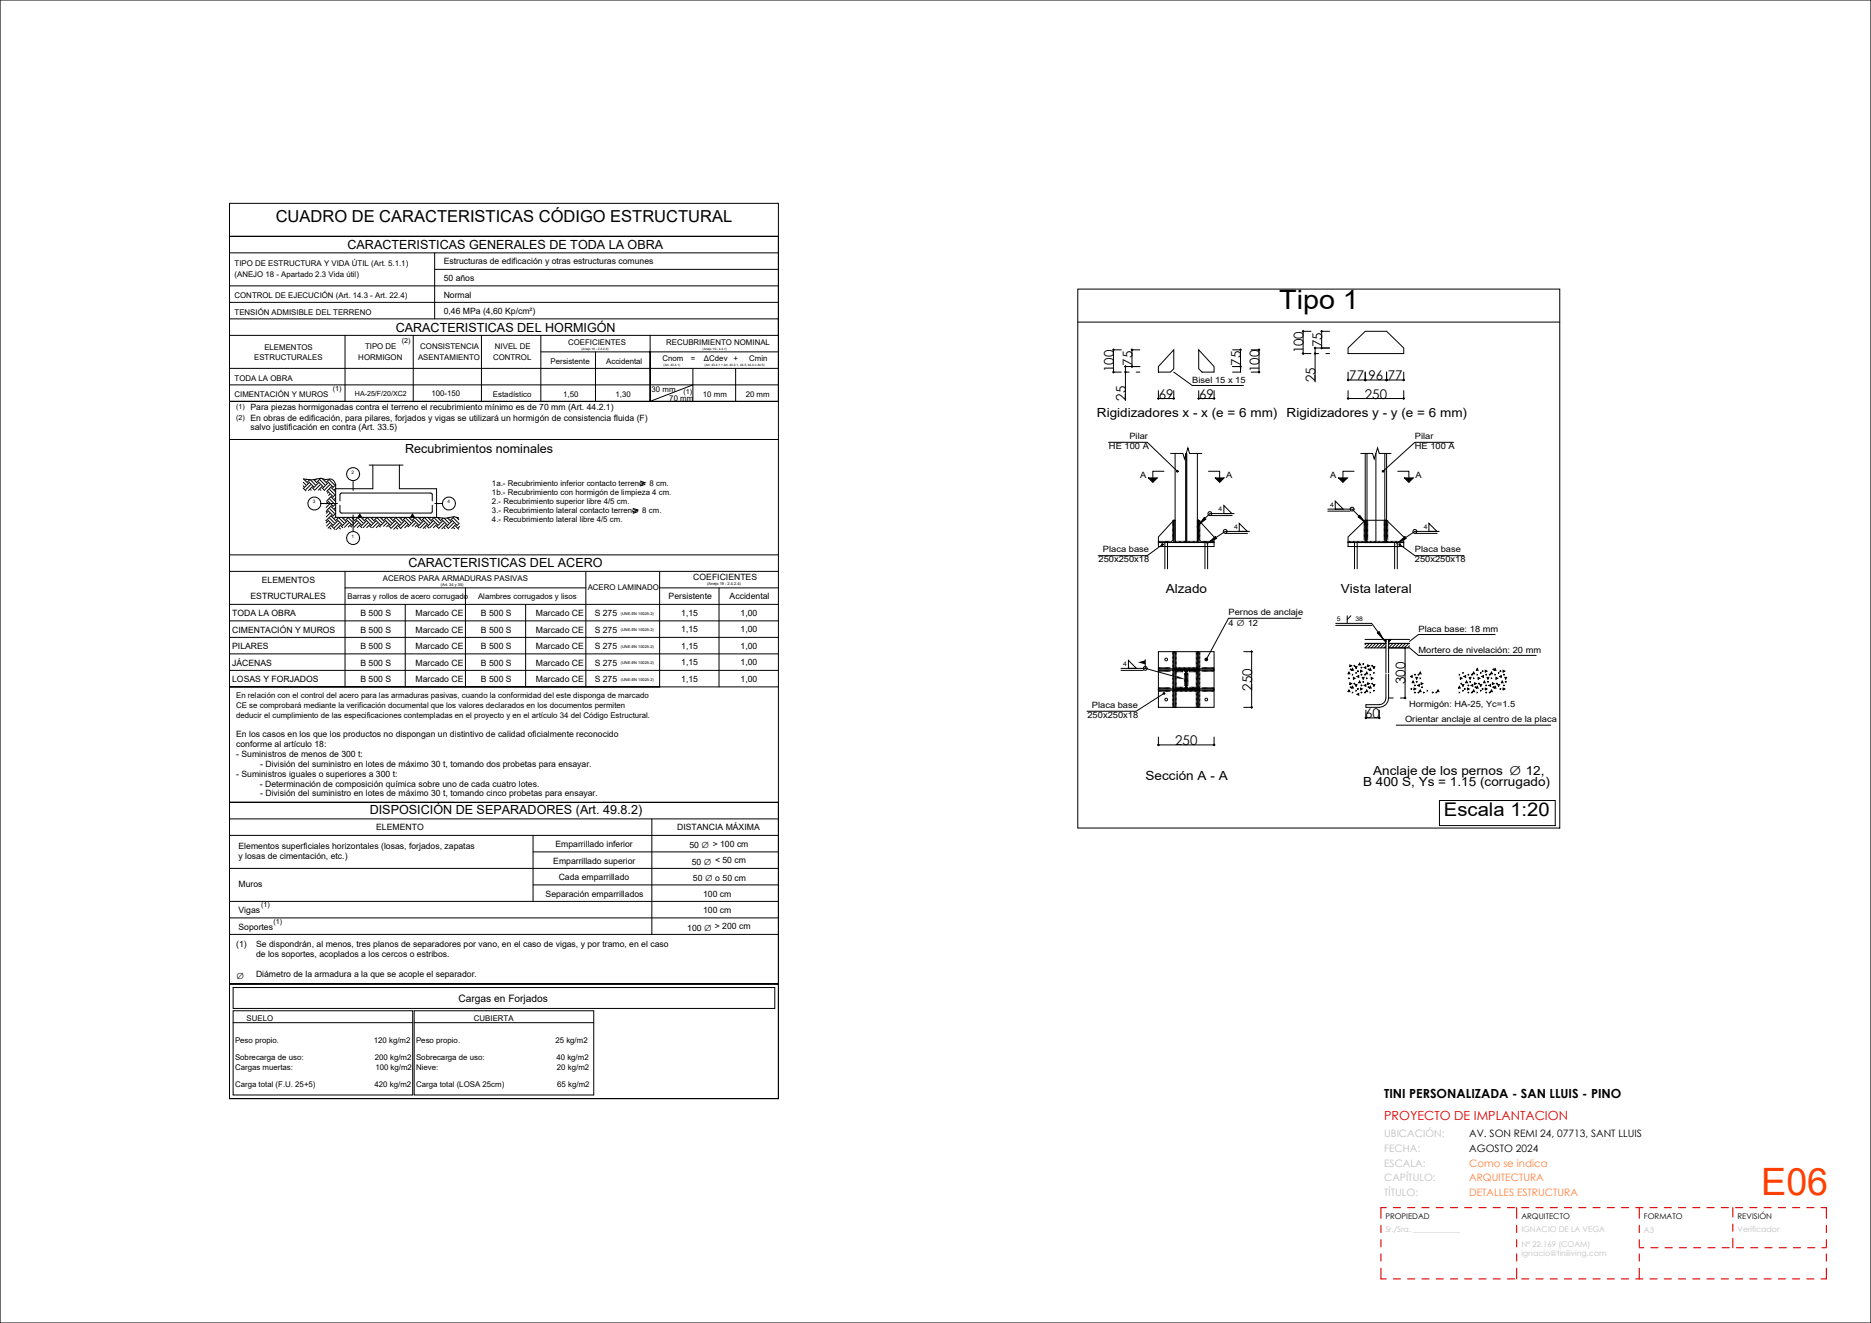
[picture p30: page 10]
Recubrimientos nominales; ELEMENTOS; HORMIGON; TIPO DE; CONTROL; NIVEL DE; Persistente; COEFICIENTES; Accidental ESTRUCTURALES; ASENTAMIENTO; CONSISTENCIA; RECUBRIMIENTO NOMINAL ΔCdev; (Art. 43.4.1 + Art. 44.2.1, 44.3, 44.4 o 44.5); Cmin (Art. 43.4.1); Cnom =; (Anejo 19 - 2.4.2.4); (Anejo 19 - 4.4.1); (ANEJO 18 - Apartado 2.3 Vida útil); 50 años; SUELO; CUBIERTA; Accidental; Marcado CE; ACERO LAMINADO; S 275 (UNE-EN 10025-2); Placa base 250x250x18; Pilar HE 100 A; Bisel 15 x 15 69; Alzado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

Estructuras de edificación y otras estructuras comunes

TIPO DE ESTRUCTURA Y VIDA ÚTIL (Art. 5.1.1)

CONTROL DE EJECUCIÓN (Art. 14.3 - Art. 22.4) | Normal
TENSIÓN ADMISIBLE DEL TERRENO | 0,46 MPa (4,60 Kp/cm²)

CARACTERISTICAS DEL HORMIGÓN

TODA LA OBRA
(1) CIMENTACIÓN Y MUROS | HA-25/F/20/XC2 | 100-150 | Estadístico | 1,50 | 30 mm 1,30 70 mm⁽¹⁾ | 10 mm | 20 mm

Rigidizadores x - x (e = 6 mm) Rigidizadores y - y (e = 6 mm)

Para piezas hormigonadas contra el terreno el recubrimiento mínimo es de 70 mm (Art. 44.2.1)
En obras de edificación, para pilares, forjados y vigas se utilizará un hormigón de consistencia fluida (F)
salvo justificación en contra (Art. 33.5)

1a.- Recubrimiento inferior contacto terreno 8 cm.
1b.- Recubrimiento con hormigón de limpieza 4 cm.
2.- Recubrimiento superior libre 4/5 cm.
3.- Recubrimiento lateral contacto terreno 8 cm.
4.- Recubrimiento lateral libre 4/5 cm.

CARACTERISTICAS DEL ACERO

ELEMENTOS ESTRUCTURALES | ACEROS PARA ARMADURAS PASIVAS | COEFICIENTES (Anejo 19 - 2.4.2.4) (Art. 34 y 35) Ø16c/30 L=115

Barras y rollos de acero corrugado Alambres corrugados y lisos

TODA LA OBRA | B 500 S | Marcado CE | B 500 S | Marcado CE | S 275 (UNE-EN 10025-2) 1,15 | 1,00 Ø16c/30 L=109
CIMENTACIÓN Y MUROS | B 500 S | Marcado CE | B 500 S | Marcado CE | S 275 (UNE-EN 10025-2) 1,15 | 1,00 95
PILARES | B 500 S | Marcado CE | B 500 S | Marcado CE | S 275 (UNE-EN 10025-2) 1,15 | 1,00
JÁCENAS | B 500 S | Marcado CE | B 500 S | Marcado CE | S 275 (UNE-EN 10025-2) 1,15 | 1,00

Pernos de anclaje

Placa base: 18 mm
Mortero de nivelación: 20 mm

LOSAS Y FORJADOS
En relación con el control del acero para las armaduras pasivas, cuando la conformidad del este disponga de marcado
CE se comprobará mediante la verificación documental que los valores declarados en los documentos permiten
deducir el cumplimiento de las especificaciones contempladas en el proyecto y en el artículo 34 del Código Estructural.
En los casos en los que los productos no dispongan un distintivo de calidad oficialmente reconocido
conforme al artículo 18:
- Suministros de menos de 300 t:
- División del suministro en lotes de máximo 30 t, tomando dos probetas para ensayar.
- Suministros iguales o superiores a 300 t:
- Determinación de composición química sobre uno de cada cuatro lotes.
- División del suministro en lotes de máximo 30 t, tomando cinco probetas para ensayar.

Hormigón: HA-25, Yc=1.5

Orientar anclaje al centro de la placa

DISPOSICIÓN DE SEPARADORES (Art. 49.8.2)

ELEMENTO | DISTANCIA MÁXIMA

Elementos superficiales horizontales (losas, forjados, zapatas y losas de cimentación, etc.) | Emparrillado inferior | 50 ∅ > 100 cm

Emparrillado superior | 50 ∅ < 50 cm

Muros | Cada emparrillado | 50 ∅ o 50 cm

Separación emparrillados | 100 cm

(1) Vigas | | 100 cm
(1) Soportes | | 100 ∅ > 200 cm

Se dispondrán, al menos, tres planos de separadores por vano, en el caso de vigas, y por tramo, en el caso
de los soportes, acoplados a los cercos o estribos.
Diámetro de la armadura a la que se acople el separador.

Cargas en Forjados

Peso propio.
Sobrecarga de uso:
Cargas muertas:
Carga total (F.U. 25+5)

Nieve:
Carga total (LOSA 25cm)

TINI PERSONALIZADA - SAN LLUIS - PINO
PROYECTO DE IMPLANTACION
UBICACIÓN:
FECHA:
ESCALA:
CAPÍTULO:
TÍTULO:

AV. SON REMI 24, 07713, SANT LLUIS
AGOSTO 2024
Como se indica
ARQUITECTURA
DETALLES ESTRUCTURA

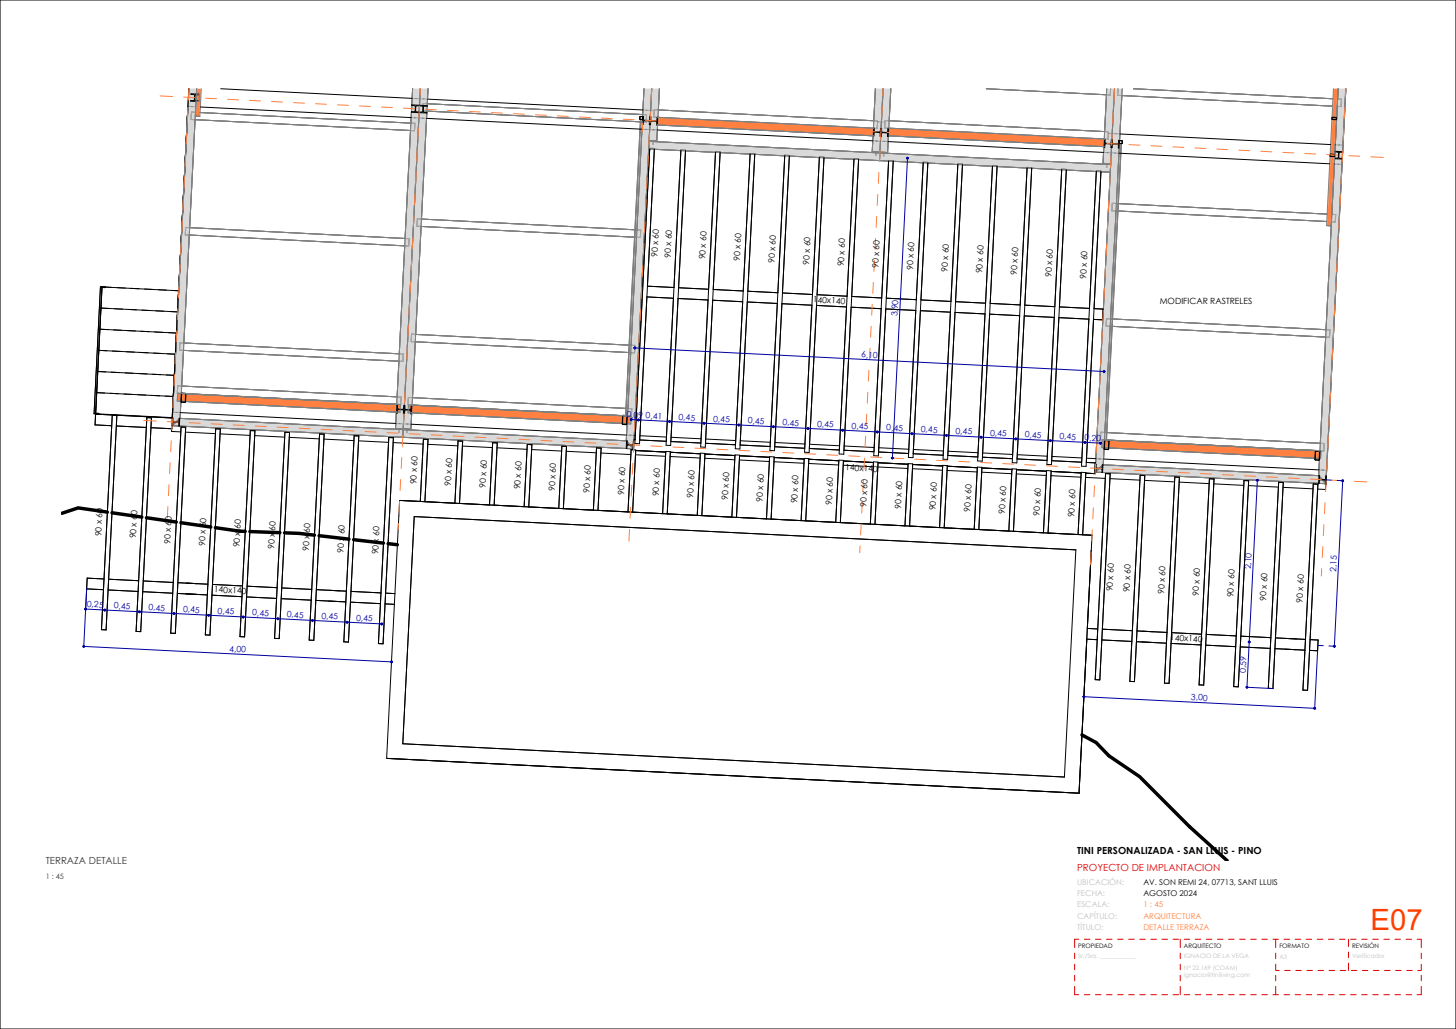
[picture p31: page 11]
MODIFICAR RASTRELES; TERRAZA DETALLE

TINI PERSONALIZADA - SAN LLUIS - PINO
PROYECTO DE IMPLANTACION
UBICACIÓN:
FECHA:
ESCALA:
CAPÍTULO:
TÍTULO:

AV. SON REMI 24, 07713, SANT LLUIS
AGOSTO 2024
ARQUITECTURA
DETALLE TERRAZA

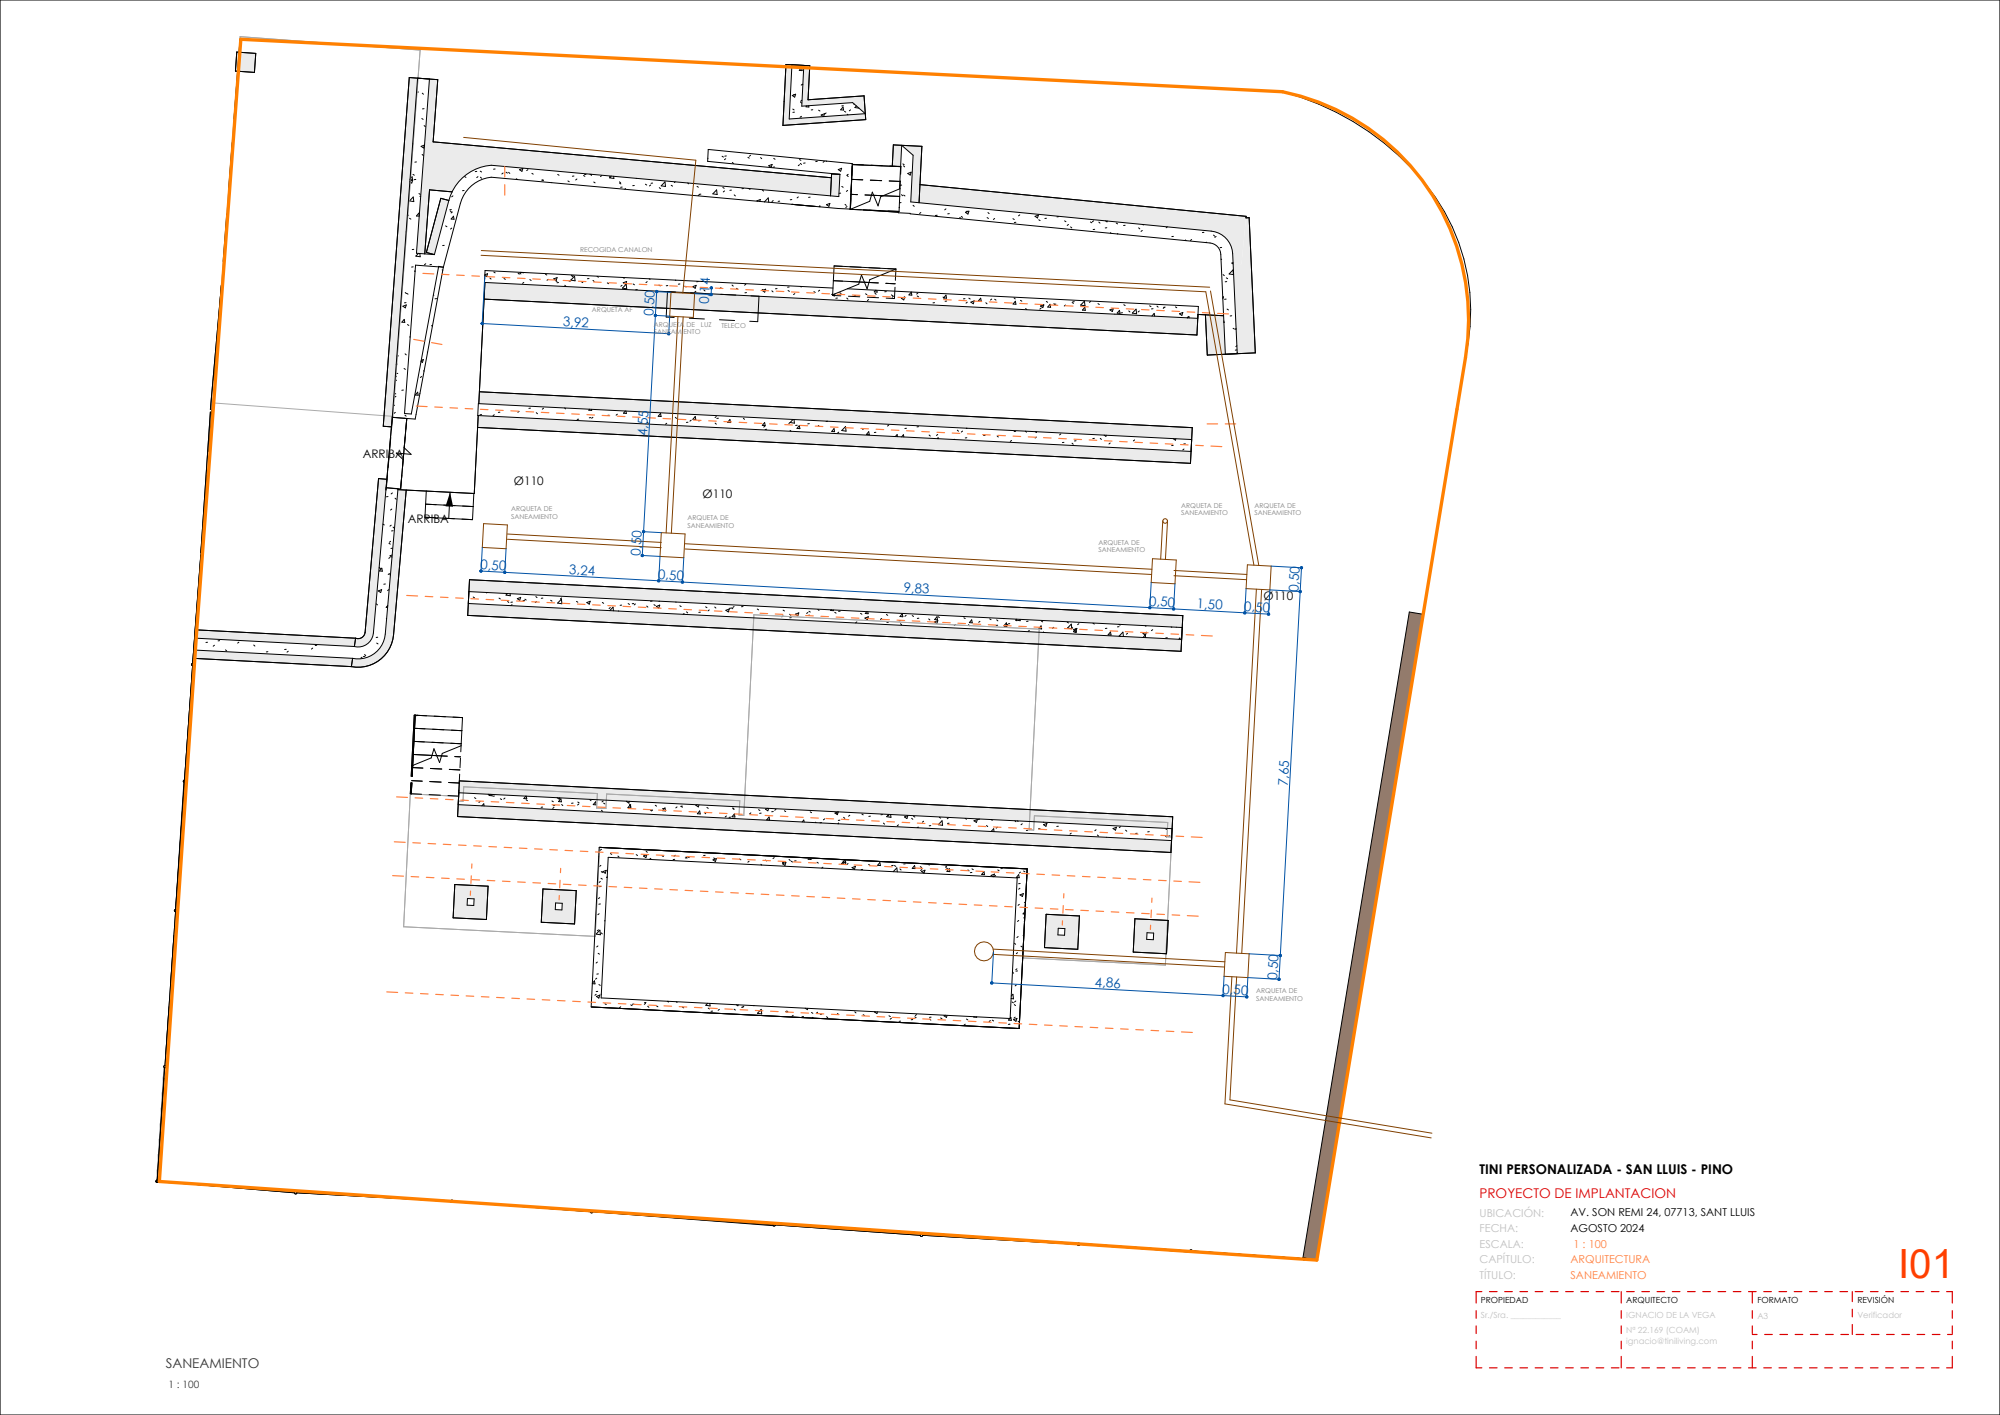
[picture p32: page 12]
ARRIBA; 3,92 ARQUETA DE; SANEAMIENTO; ARQUETA DE; ARQUETA DE SANEAMIENTO; LUZ TELECO; ARQUETA AF; RECOGIDA CANALON

TINI PERSONALIZADA - SAN LLUIS - PINO
PROYECTO DE IMPLANTACION
UBICACIÓN:
FECHA:
ESCALA:
CAPÍTULO:
TÍTULO:

AV. SON REMI 24, 07713, SANT LLUIS
AGOSTO 2024
ARQUITECTURA
SANEAMIENTO

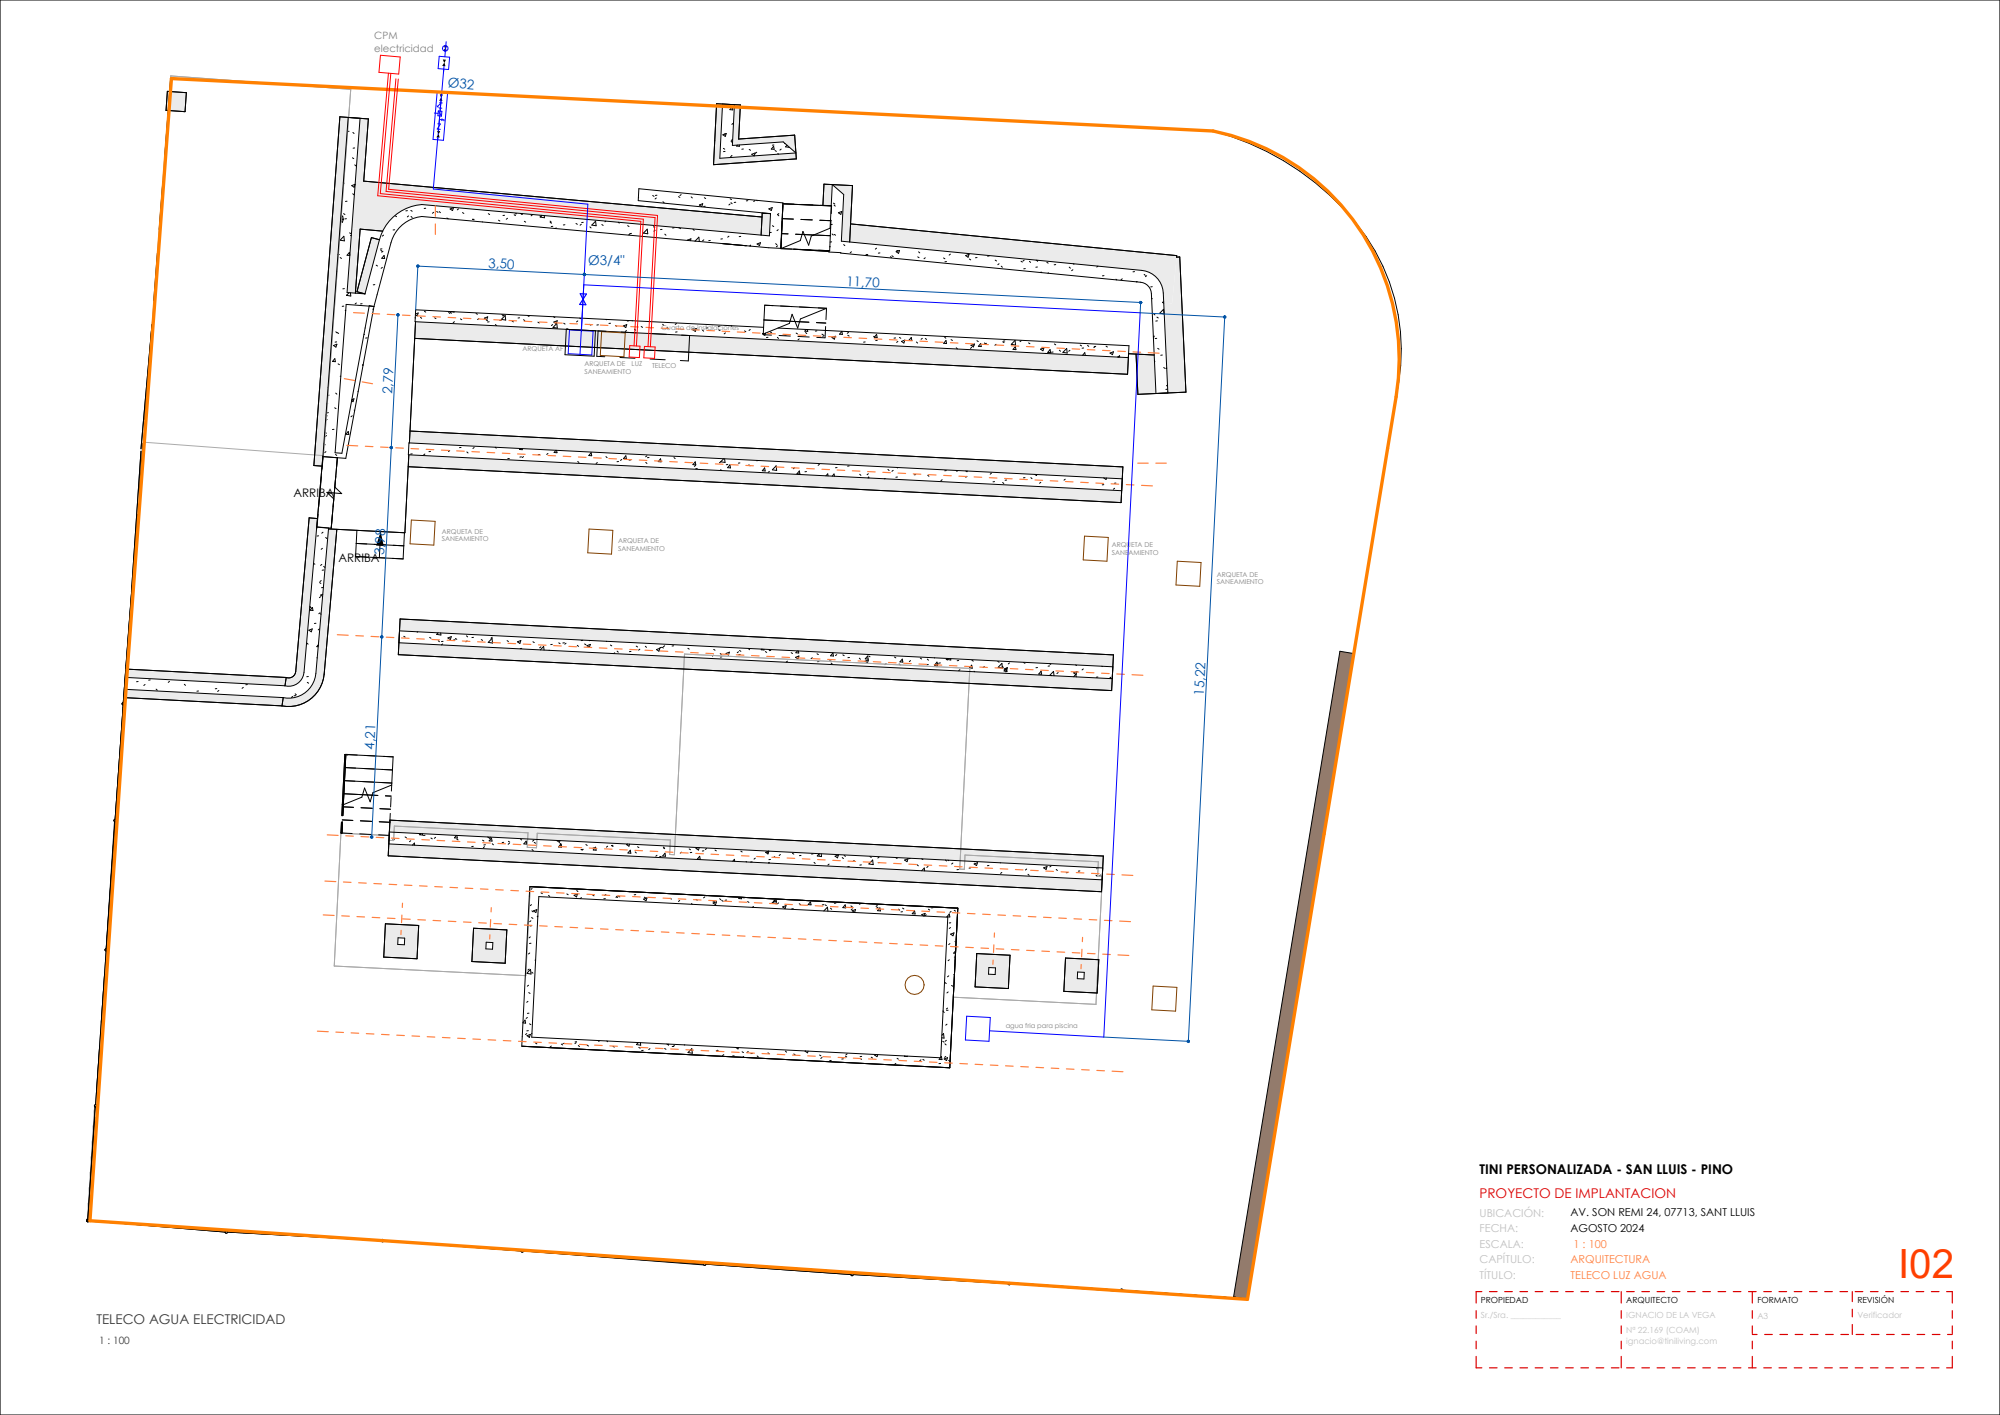
[picture p33: page 13]
ARRIBA; ARQUETA DE SANEAMIENTO; ARQUETA DE; SANEAMIENTO; CPM electricidad; LUZ TELECO; ARQUETA AF

Cuarto de instalaciones

agua fria para piscina

TINI PERSONALIZADA - SAN LLUIS - PINO
PROYECTO DE IMPLANTACION
UBICACIÓN:
FECHA:
ESCALA:
CAPÍTULO:
TÍTULO:

AV. SON REMI 24, 07713, SANT LLUIS
AGOSTO 2024
ARQUITECTURA
TELECO LUZ AGUA

TELECO AGUA ELECTRICIDAD

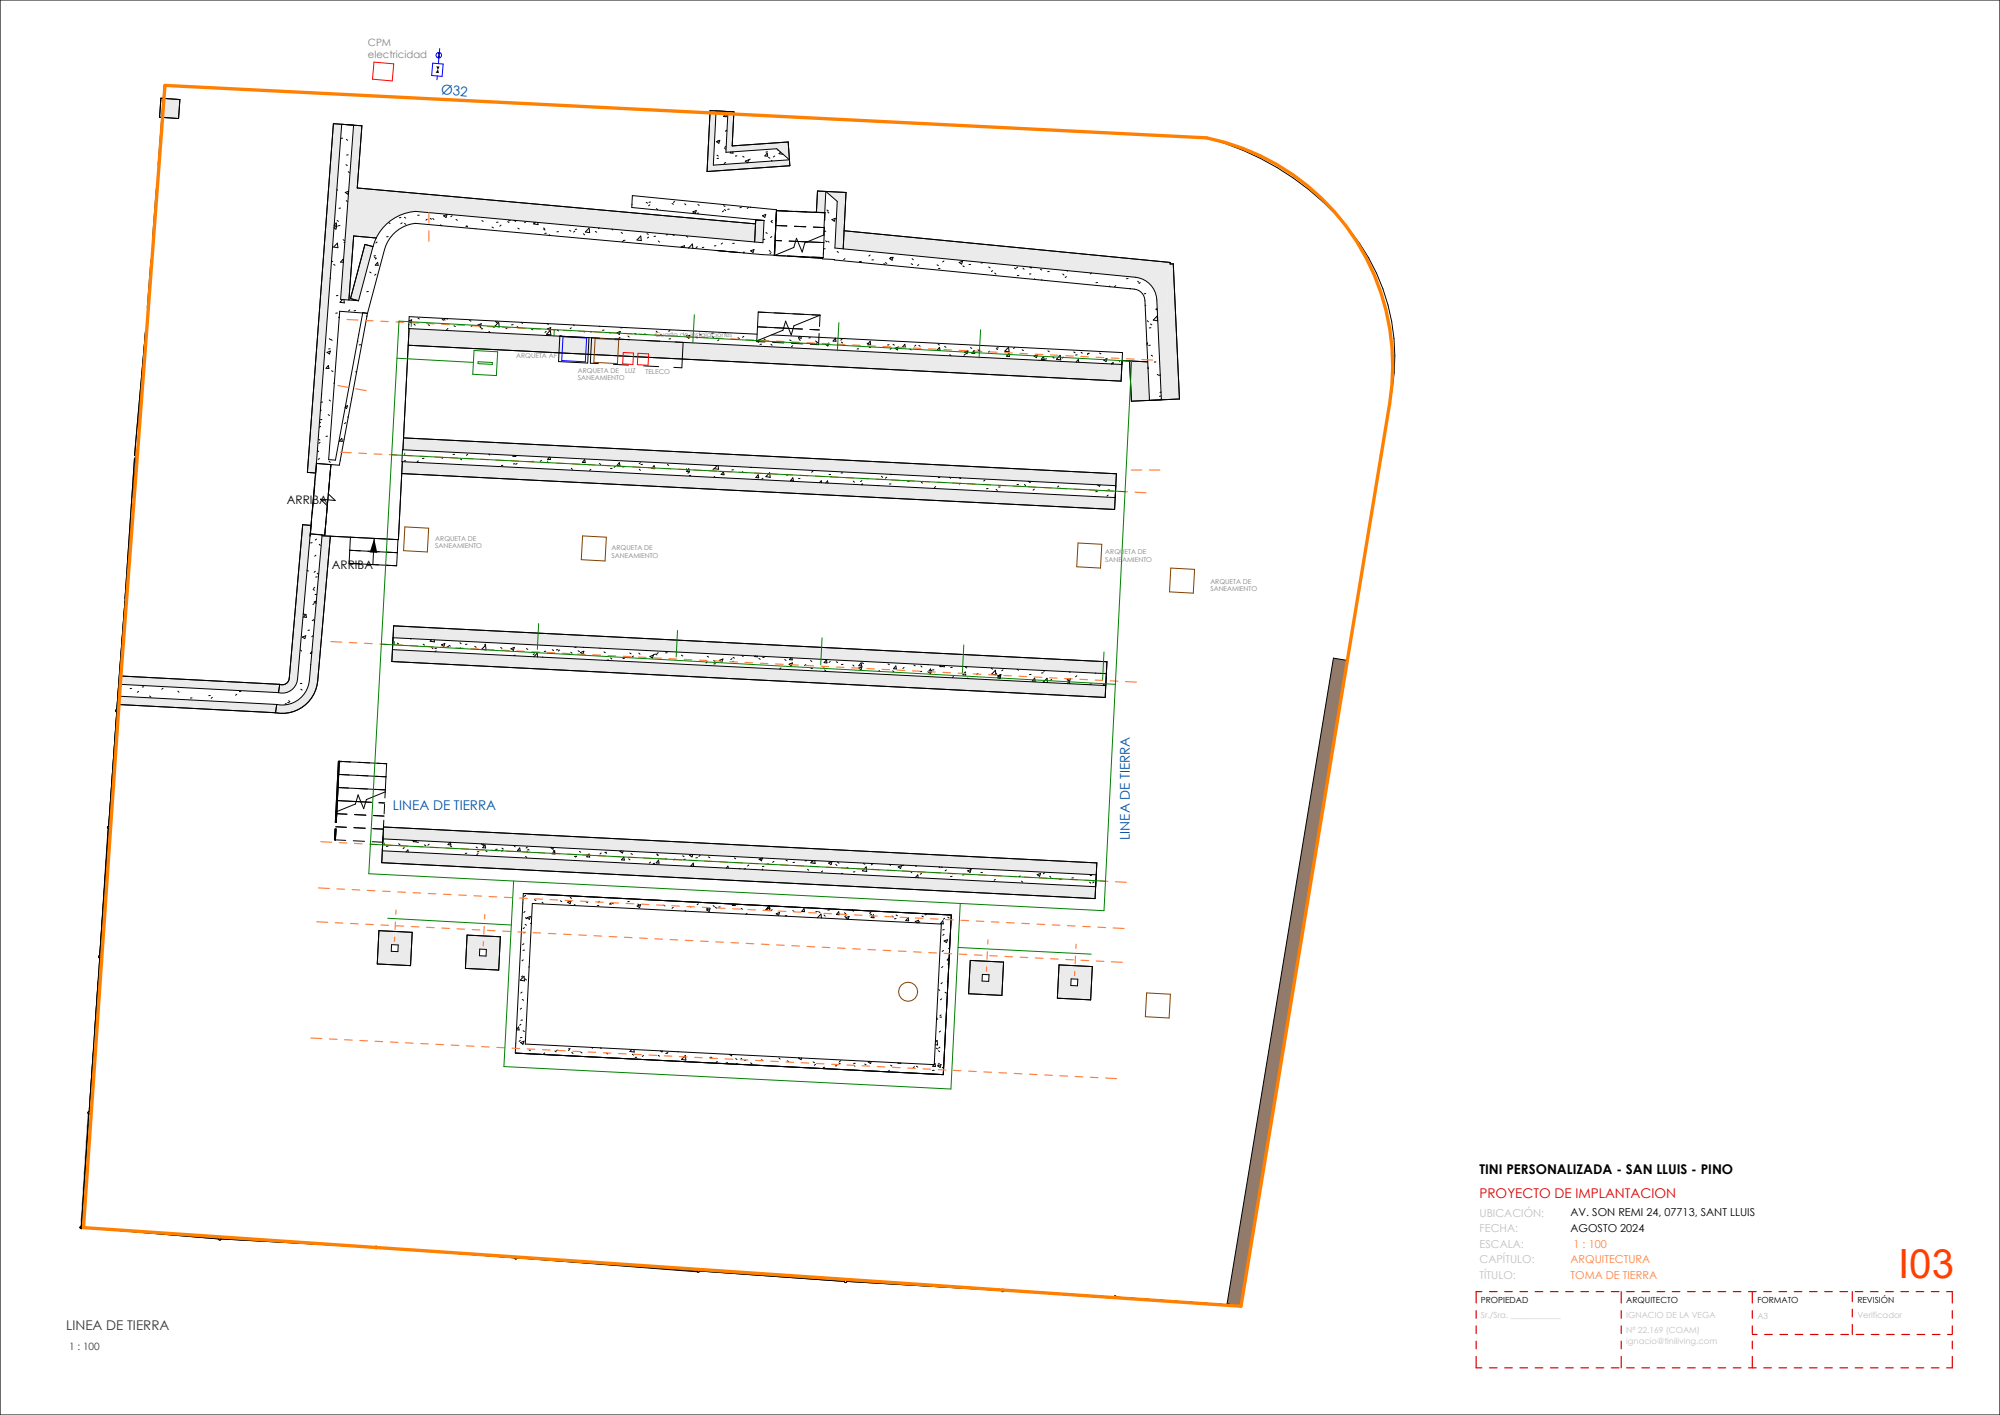
[picture p34: page 14]
ARRIBA; ARQUETA DE SANEAMIENTO; ARQUETA DE; SANEAMIENTO; CPM electricidad; LUZ TELECO; ARQUETA AF

Cuarto de instalaciones

LINEA DE TIERRA

TINI PERSONALIZADA - SAN LLUIS - PINO
PROYECTO DE IMPLANTACION
UBICACIÓN:
FECHA:
ESCALA:
CAPÍTULO:
TÍTULO:

AV. SON REMI 24, 07713, SANT LLUIS
AGOSTO 2024
ARQUITECTURA
TOMA DE TIERRA

## ARRIBA

## ARRIBA

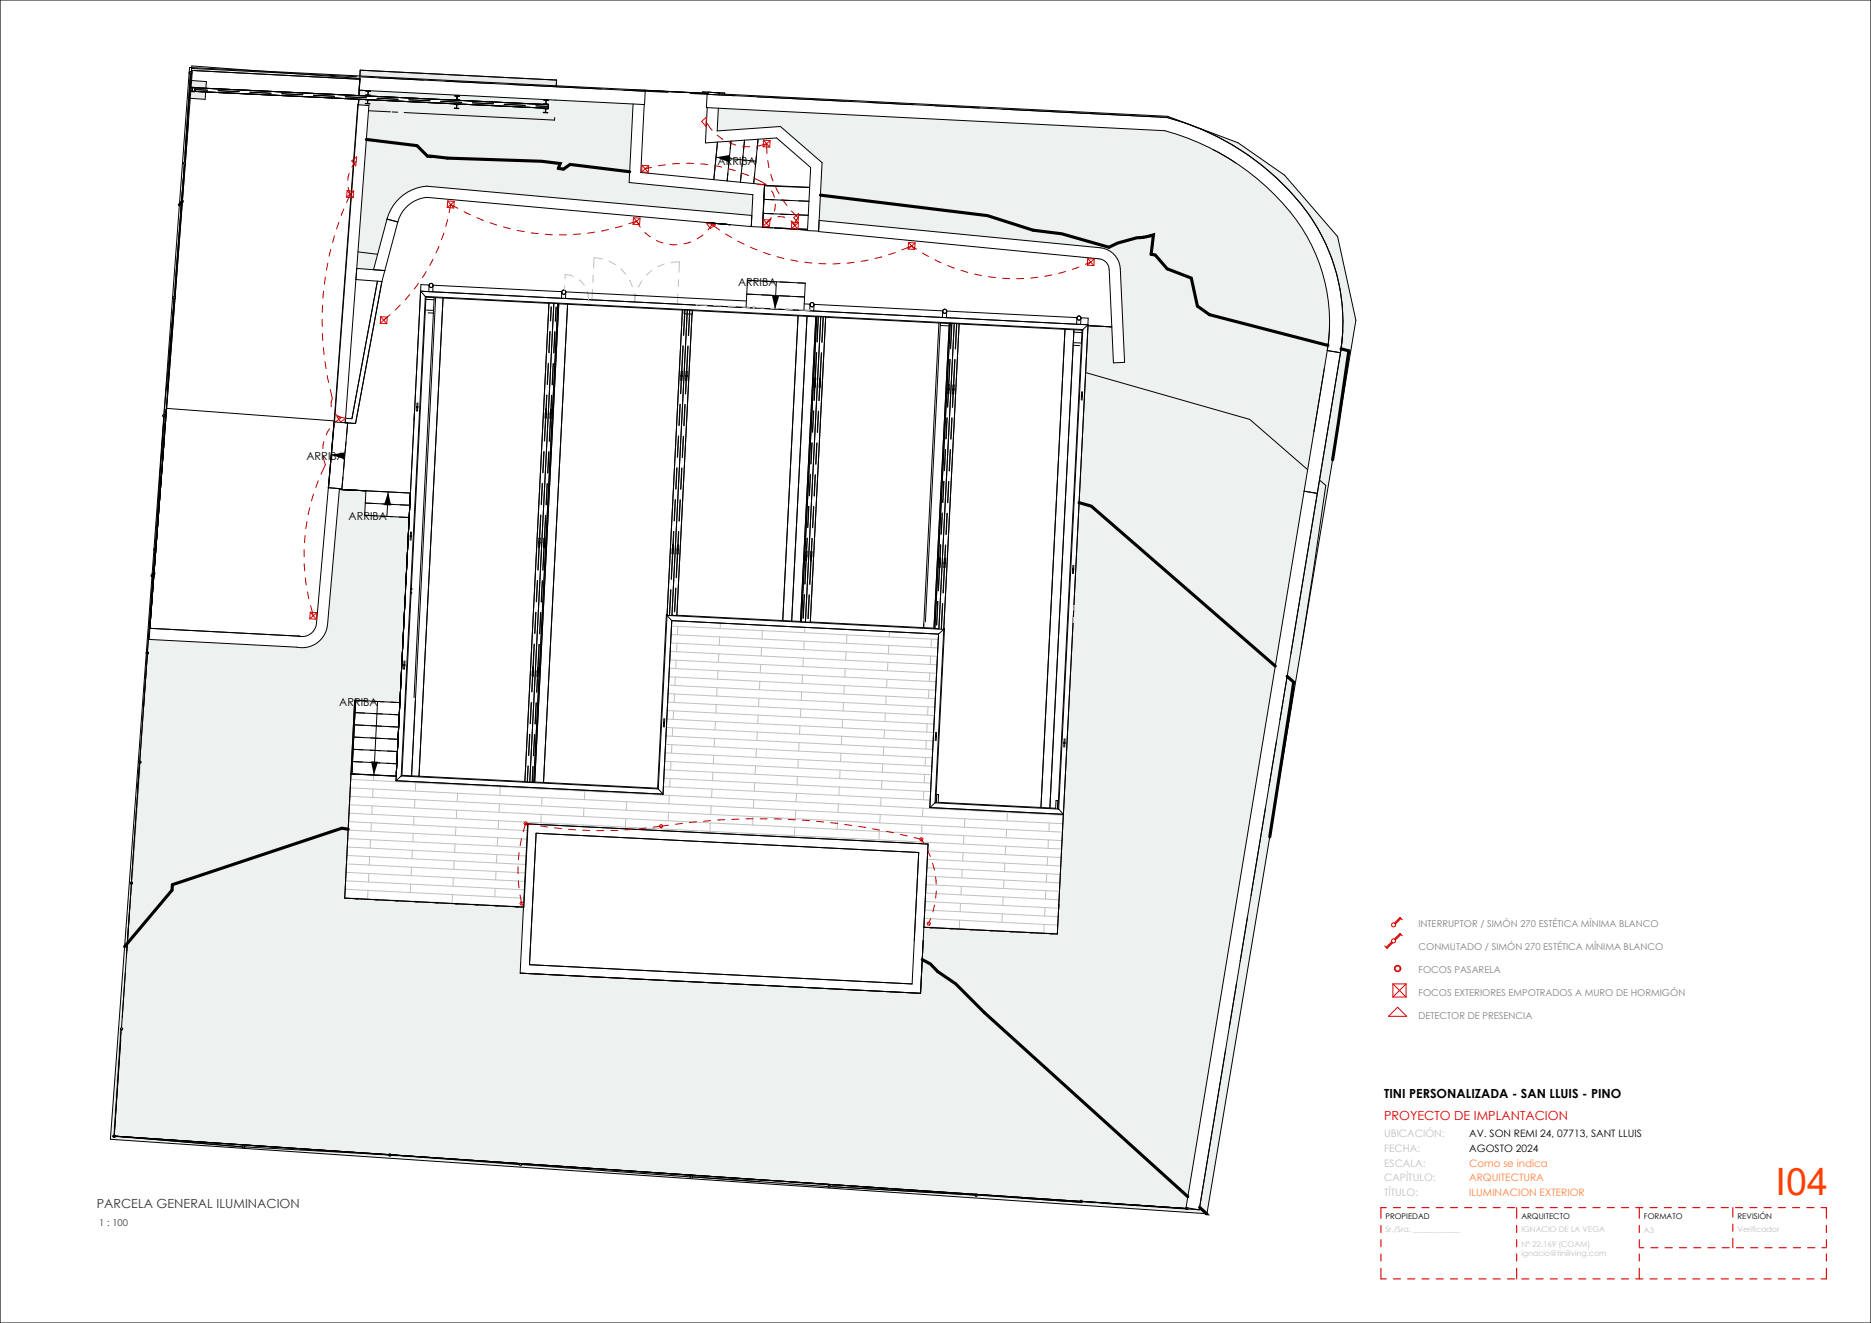
[picture p35: page 15]
ARRIBA; Verificador 1 : 100

INTERRUPTOR / SIMÓN 270 ESTÉTICA MÍNIMA BLANCO
CONMUTADO / SIMÓN 270 ESTÉTICA MÍNIMA BLANCO
FOCOS PASARELA
FOCOS EXTERIORES EMPOTRADOS A MURO DE HORMIGÓN
DETECTOR DE PRESENCIA

TINI PERSONALIZADA - SAN LLUIS - PINO
PROYECTO DE IMPLANTACION
UBICACIÓN:
FECHA:
ESCALA:
CAPÍTULO:
TÍTULO:

AV. SON REMI 24, 07713, SANT LLUIS
AGOSTO 2024
Como se indica
ARQUITECTURA
ILUMINACION EXTERIOR

PARCELA GENERAL ILUMINACION

## Muros de Mares

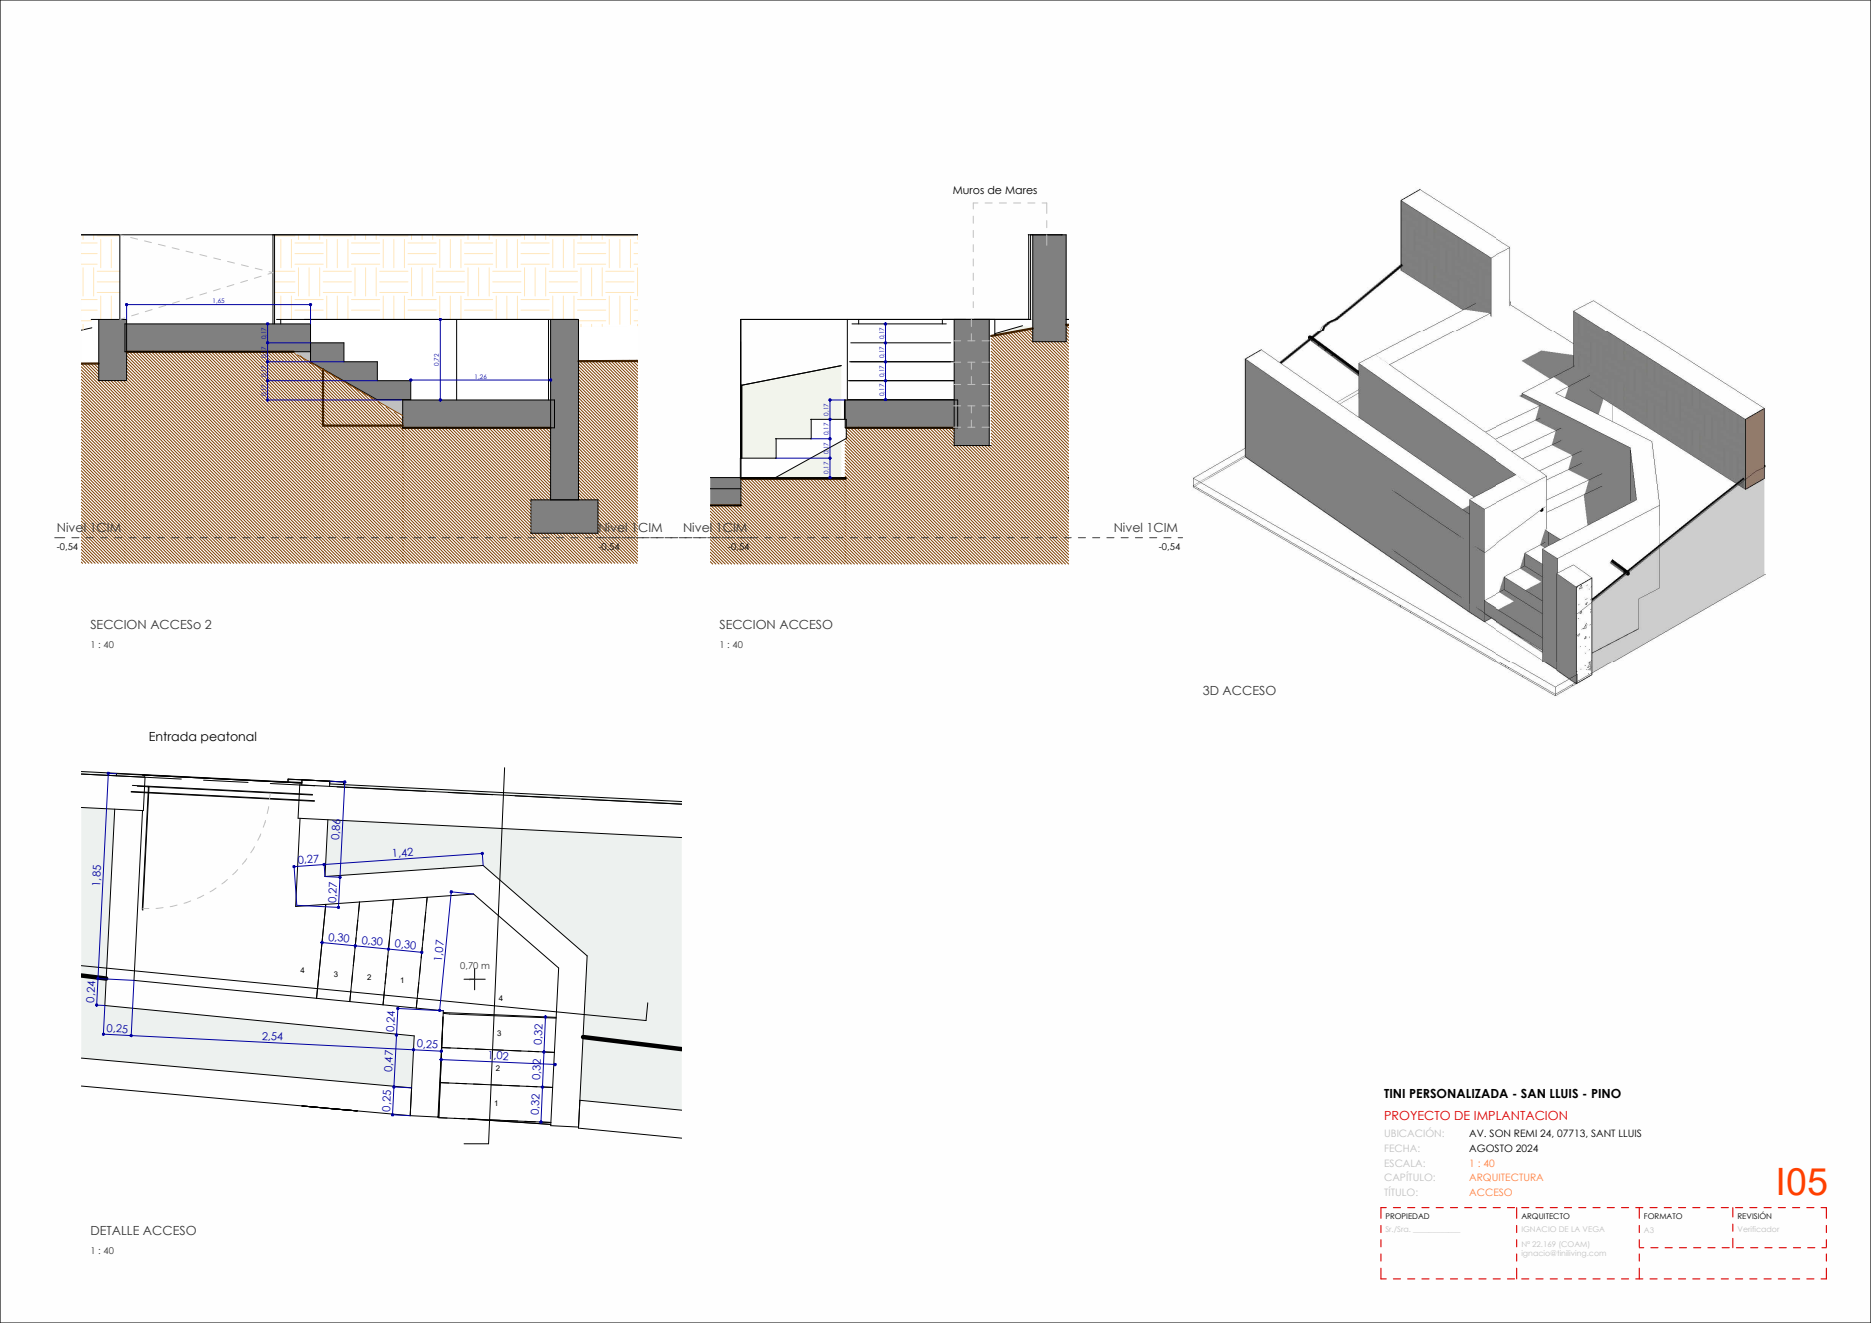
[picture p36: page 16]
Entrada peatonal; Nivel 1CIM; DETALLE ACCESO; SECCION ACCESO; SECCION ACCESo 2; 3D ACCESO

TINI PERSONALIZADA - SAN LLUIS - PINO
PROYECTO DE IMPLANTACION
UBICACIÓN:
FECHA:
ESCALA:
CAPÍTULO:
TÍTULO:

AV. SON REMI 24, 07713, SANT LLUIS
AGOSTO 2024
ARQUITECTURA
ACCESO
