teyame109-dev/Modular-Home/(commit log)

2026-10-18 Añade archivos del proyecto Névola, generadores y CLAUDE.md
    Costes, proyecto técnico, oferta de ArcelorMittal, generadores en Node,
    diapositivas de la propuesta, copias de los artifacts y el resumen del
    proyecto en CLAUDE.md.
    [Banco_precios_modular_base2024.xlsx, Nevola_piloto_estudio_costes.xlsx, Nevola_presupuesto_tecnico_modular.xlsx, Presupuesto_Nevola_chalet_tipoA.xlsx, Presupuesto_Nevola_chalet_tipoA_v2.xlsx, _Planos de arquitectura.dwg, _Planos de estructura.dwg, _Planos de instalaciones.dwg]
2026-10-18 Añade agentes de estructuras, compras y energía
    Claude-Session: https://claude.ai/code/session_01YJqbgKwMgibg3yPRhfWXsg
2026-10-18 Añade la web de la propuesta Névola con el desmontaje por scroll
2026-10-18 CLAUDE.md: enlace a la web de Névola
2026-10-18 Web completa de la propuesta Névola (web/site para Vercel) y su generador
2026-10-18 CLAUDE.md: skills de construcción evaluadas y decisión
2026-10-18 Opción C: el dormitorio 1 queda como en el proyecto y la junta a 3,20 m se oculta en suelo y techo
    [Nevola_piloto_estudio_costes.xlsx]
2026-10-18 M4 entero con el vuelo lateral (3,80 m) y regla de precio cerrado con NIDO
    [Nevola_piloto_estudio_costes.xlsx]
2026-10-18 Web: el texto acompaña al módulo que se está levantando
2026-10-18 Guarda la propuesta enviada a NIDO (versión aceptada)
2026-10-19 Prueba de despliegue automático en Vercel
2026-10-19 Documentación técnica de taller sin datos económicos
2026-10-19 Planos de cimentación de referencia: Pino (PDF) y Mahón (DWG)
    [Mahon_cimentacion.dwg]
2026-10-19 Planos estimados de cimentación del piloto (criterio Pino)
2026-10-19 CLAUDE.md: planos de cimentación del piloto
2026-10-19 Web: apartado de cimentación con la marca RG21 y enlace en el menú
2026-10-19 Cimentación: etiquetas recolocadas y PDF de la estimación A
2026-10-19 Mueve el PDF de cimentación a entregables (aún no enviado)
2026-10-19 Cimentación: fotos de obra en Menorca como referencia del sistema
2026-10-19 Cimentación: secuencia de fotos del montaje de los módulos sobre los muros
2026-10-20 Generadores ejecutables desde el repo (rutas relativas) y guía para trabajar desde la nube
2026-10-20 Web: página /render/ que monta la vivienda módulo a módulo sobre el render de la promoción
    Renders de nevolahomes.com (capturas de Iván) limpiados de velo y texto con
    herramientas/render/limpia_renders.py. Al hacer scroll caen M1–M6 sobre la
    fachada del render, se marcan las juntas y la casa queda como en el render.
    Enlace añadido al menú de la web.
    Claude-Session: https://claude.ai/code/session_01UsshWDyzh9XkyW9ZdDTfjF
2026-10-20 CLAUDE.md: enlace y regeneración de la página /render/
    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
2026-10-20 Web /render/: montaje por pasos, con botones y toque en la imagen
    Cada paso dispara su animación completa (antes había que arrastrar mucho
    scroll por módulo). Los botones 0–M6–J–✓ llevan a su paso; tocar la imagen
    pasa al siguiente. Con «reducir movimiento» los módulos bajan un poco en
    vez de aparecer sin más.
    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
2026-10-20 Web /render/: maqueta 3D de la vivienda que se desmonta en sus seis módulos
    Sustituye el montaje sobre la imagen del render. La casa se levanta en
    Three.js con las coordenadas de piloto_calc.js (aristas rectas, medidas
    reales): al hacer scroll se desmonta, enseña cada módulo con su ficha y se
    vuelve a montar con las juntas en rojo. Botones por paso y giro arrastrando.
    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
2026-10-20 Web /render/: vuelta completa de 360° a la maqueta
    Con el scroll la cámara da una vuelta entera mientras se recorren los
    módulos y vuelve al punto de vista del render para el montaje final.
    Arrastrando ya no hay tope de giro.
    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
2026-10-20 Web /render/: interiores de los módulos al desmontar la maqueta
    Al separarse, cada módulo pierde la cubierta y sus paredes bajan a 1,15 m
    (corte en tinta, como en un plano): se ven los tabiques y la escalera de
    las plantas de la propuesta, muebles orientativos y, en el módulo
    destacado, el nombre y la superficie de cada estancia.
    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
2026-10-20 Web /render/: vista directa de cada módulo al pincharlo
    Pinchar un módulo en la maqueta (o su botón M1–M6) acerca la cámara a ese
    módulo, lo abre con sus estancias y apaga los demás. Se vuelve con «Volver
    a la casa», pinchando fuera, con Esc o haciendo scroll. Corrige además el
    paso entre opaco y transparente de los materiales, que necesitaba
    recompilar el shader para que los módulos apagados se vieran apagados.
    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
2026-10-20 Web: encabezado fijo en /render/ y /cimentacion/
    El logo y «Volver a la propuesta» se quedan arriba al hacer scroll. En
    /render/ el escenario 3D se fija justo debajo del encabezado y el cálculo
    del scroll tiene en cuenta su altura. La de cimentación se cambia en su
    generador (web_cimentacion.js) y se regenera.
    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
2026-10-20 Cimentación: presupuesto del equipo pasado a Excel y contrastado
    El manuscrito del equipo (foto en ofertas-proveedores/) pasado a Excel con
    fórmulas: 6.885,30 € sin IVA (6.885 € en el papel, por redondeos). Añade
    lo que no aparece (suministro de hormigón y acero, limpieza, excavación,
    grava, bombeo, replanteo) con precios a rellenar, la comparación con la
    estimación A y con los precios de Pino 2024, y las preguntas al equipo.
    Generador: herramientas/cimentacion/presupuesto_equipo.js.
    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
    [Nevola_cimentacion_presupuesto_equipo.xlsx]
2026-10-20 Cimentación: hormigón aparte a 95 €/m³ y acero aparte
    Suministro de HA-25 a 95 €/m³ sobre los 37 m³ (3.515 €): la cimentación
    va por 10.400,30 € sin IVA con la mano de obra del equipo. El suministro
    de acero queda como partida aparte, con el precio pendiente.
    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
    [Nevola_cimentacion_presupuesto_equipo.xlsx]
2026-10-20 Cimentación: acero aparte a 0,95 €/kg
    3.000 kg de B500S a 0,95 €/kg (2.850 €). Con mano de obra, hormigón y
    acero, la cimentación va por 13.250,30 € sin IVA.
    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
    [Nevola_cimentacion_presupuesto_equipo.xlsx]
2026-10-20 Cimentación: hormigón de limpieza a 9 €/m²
    45,75 m² bajo zapatas a 9 €/m² (411,75 €). La cimentación va por
    13.662,05 € sin IVA.
    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
    [Nevola_cimentacion_presupuesto_equipo.xlsx]
2026-10-20 Cimentación: excavación a 18 €/m³
    59,48 m³ (superficie de zapatas × 1,30 m de fondo, por confirmar) a
    18 €/m³: 1.070,55 €. La cimentación va por 14.732,60 € sin IVA.
    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
    [Nevola_cimentacion_presupuesto_equipo.xlsx]
2026-10-20 Cimentación: grava de cámara sanitaria a 12 €/m²
    74,58 m² (huella de planta baja, 7,85 × 9,50) a 12 €/m²: 894,90 €. La
    cimentación va por 15.627,50 € sin IVA.
    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
    [Nevola_cimentacion_presupuesto_equipo.xlsx]
2026-10-20 Web /cimentacion/: presupuesto de Knubo como extra a la promoción
    Nueva sección con las partidas de ejecución y de materiales y trabajos
    previos, leídas del Excel del presupuesto: 15.627,50 € por vivienda sin
    IVA, sin margen añadido. Lleva notas sobre las mediciones estimadas
    (medición de Knubo frente a la estimación A, placas, excavación, limpieza
    y grava) y lo que no incluye. CLAUDE.md recoge a Knubo y la excepción a
    la regla de no publicar costes.
    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
2026-10-20 Cimentación: hormigón a 115 €/m³ y solera de limpieza en mano de obra
    Hormigón HA-25 a 115 €/m³; el hormigón de limpieza pasa a 11,50 €/m²
    (10 cm al precio del hormigón, enlazado en el Excel). La mano de obra
    suma la solera de limpieza a 11 €/m² (503,25 €). Total por vivienda:
    16.985,13 € sin IVA, también en /cimentacion/.
    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
    [Nevola_cimentacion_presupuesto_equipo.xlsx]
2026-10-20 Cimentación: placas de anclaje a 220 €/ud como material
    12 placas a 220 € (2.640 €) en materiales; las 32 €/ud del equipo quedan
    como colocación. Total por vivienda: 19.625,13 € sin IVA, también en
    /cimentacion/.
    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
    [Nevola_cimentacion_presupuesto_equipo.xlsx]
2026-10-20 Cimentación: bombeo a 250 € por vivienda
    Total por vivienda: 19.875,13 € sin IVA, también en /cimentacion/. Solo
    queda fuera el replanteo topográfico.
    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
    [Nevola_cimentacion_presupuesto_equipo.xlsx]
2026-10-20 Cimentación: replanteo a 300 € por vivienda
    Todas las partidas con precio: 20.175,13 € por vivienda sin IVA, también
    en /cimentacion/ (desaparece la nota «No incluido»).
    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
    [Nevola_cimentacion_presupuesto_equipo.xlsx]
2026-10-22 Mediciones por oficio de las 16 viviendas para pedir ofertas
    Excel con una pestaña por capítulo del proyecto (309 partidas del BC3):
    medición total y media por vivienda, desglose de la medición del
    proyecto (tipos, unidades y medidas), datos clave sacados del texto
    (medidas, color, marca), descripción completa, precio y PEM de
    referencia y alcance en el sistema modular. Añade el acero de los
    módulos por perfil y el panel de la envolvente para las 16 viviendas.
    Generador: herramientas/nevtec/mediciones_oficios.js.
    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
    [Nevola_mediciones_por_oficio_16_viviendas.xlsx]
